Arnwald/slo-pilote/mech/out/plans_chassis.pdf

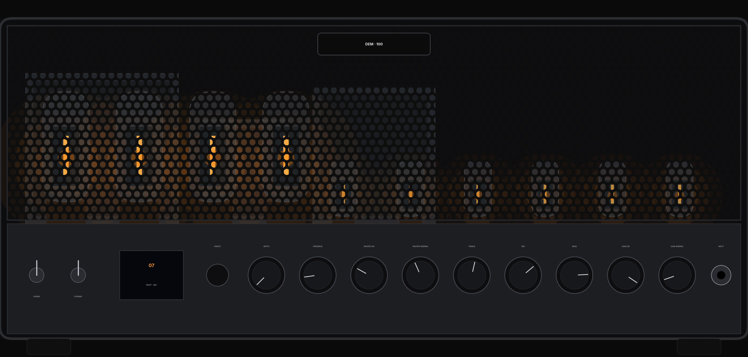
[picture p4: figure]

# Vue d'ensemble

Tête 100 W pilotable · rendu indicatif · cotes en mm | F1
- Châssis : acier DC01 1,5 mm, plateau à 4 parois d'une pièce, rayon intérieur 1,5 mm, K = 0,42 (à recaler sur l'outillage du plieur).
- Capot : aluminium 5754 2 mm, en U avec retours, fond rapporté ; thermolaquage noir mat texturé. Grilles avant et arrière : tôle perforée achetée, noire.
- Encombrement : 612 × 262 × 282 mm (l × h × p) hors poignée et boutons ; masse estimée ~20 kg.
- Trous en orange : dépendent d'une pièce à recevoir (transfos, embase IEC, écran). Commander ces pièces et relever leurs cotes avant la découpe.

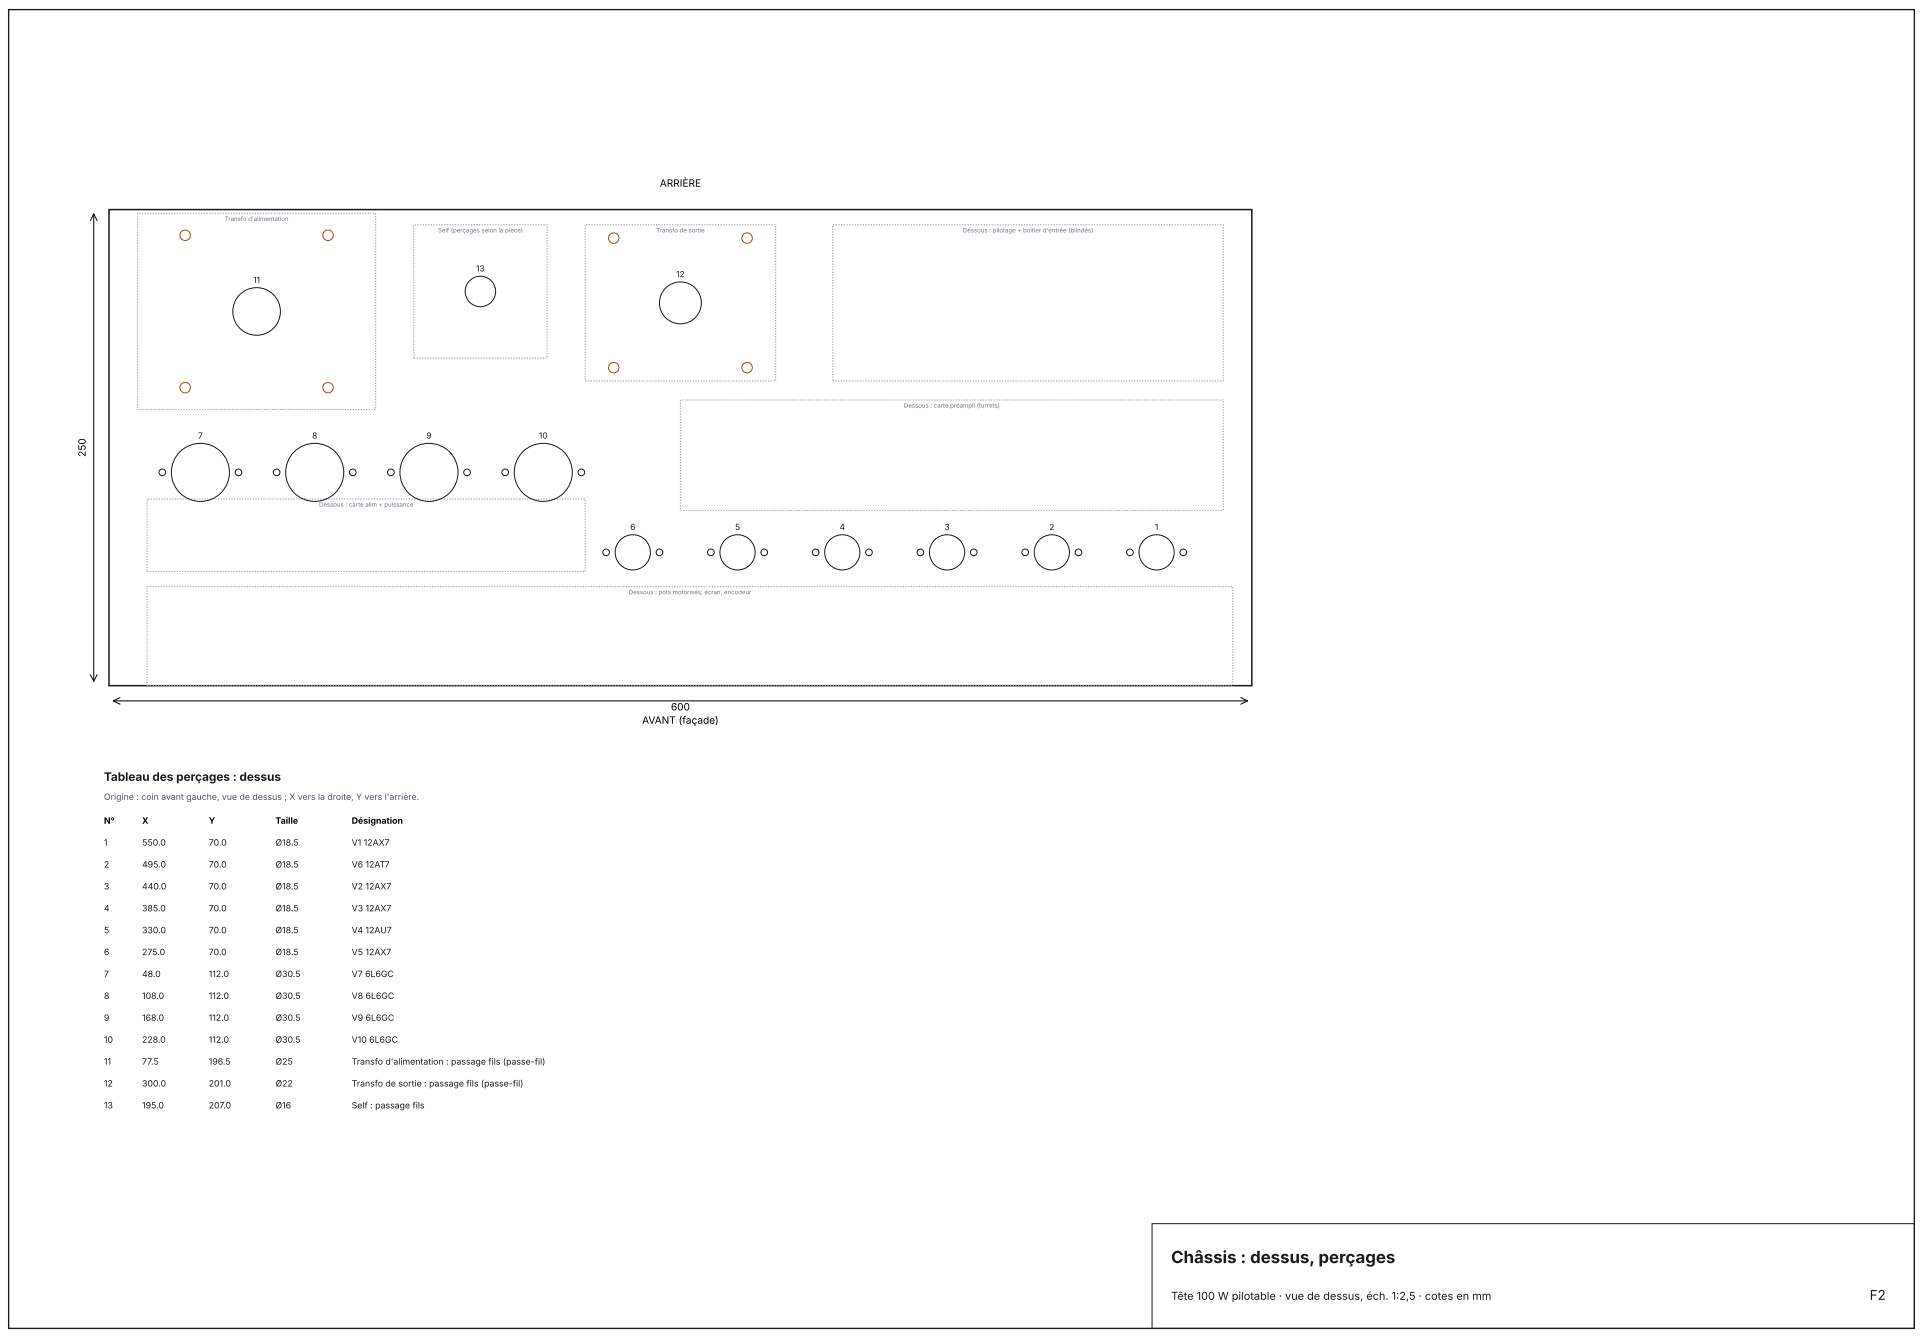
[picture p5: page 2]
Tête 100 W pilotable · vue de dessus, éch. 1:2,5 · cotes en mm; Taille; Désignation; Transfo d'alimentation : passage fils (passe-fil); Transfo de sortie : passage fils (passe-fil); Self : passage fils; Transfo d'alimentation; Self (perçages selon la pièce); Transfo de sortie; ARRIÈRE; AVANT (façade)

Dessous : pilotage + boîtier d'entrée (blindés)

Dessous : carte préampli (turrets)

Dessous : carte alim + puissance

Dessous : pots motorisés, écran, encodeur

Tableau des perçages : dessus

Origine : coin avant gauche, vue de dessus ; X vers la droite, Y vers l'arrière.

Châssis : dessus, perçages

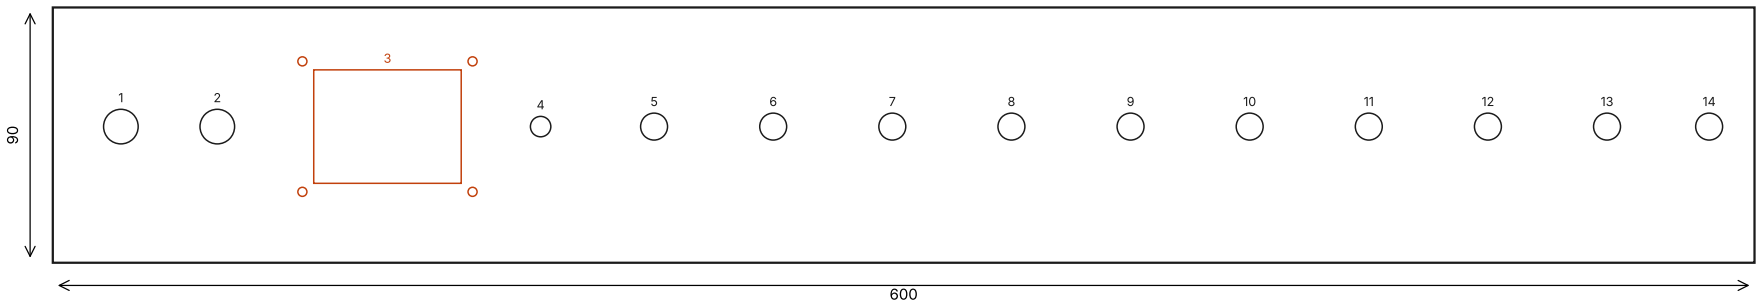
[picture p6: figure]
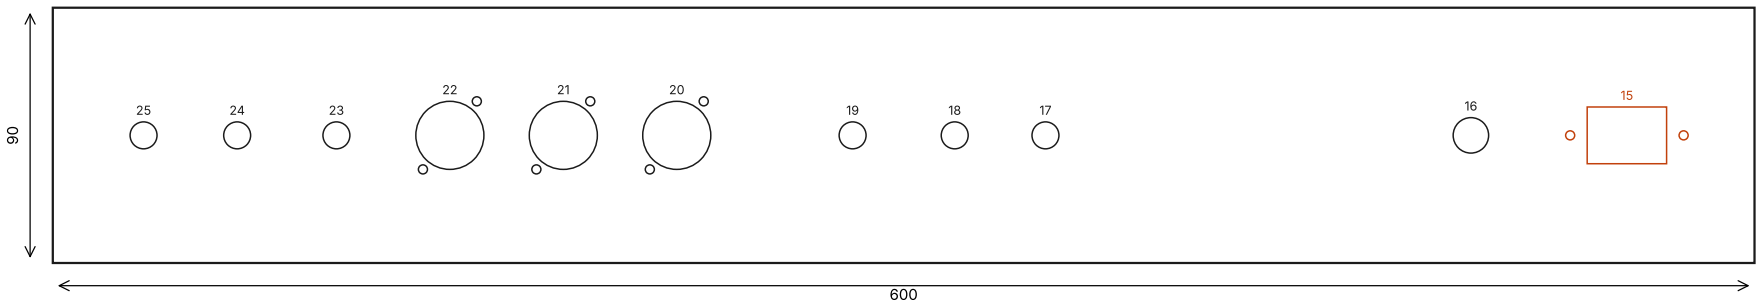
[picture p7: figure]

# Châssis : façade et panneau arrière

Tête 100 W pilotable · vues extérieures, éch. 1:2,5 · cotes en mm | F3

# Façade

Origine : coin inférieur gauche, vue de face.

N° | X | Y | Taille | Désignation
1 | 24.0 | 48.0 | Ø12.2 | Power (interrupteur M12)
2 | 58.0 | 48.0 | Ø12.2 | Standby (interrupteur M12)
3 | 118.0 | 48.0 | 52×40 | Fenêtre écran 2,4" — à vérifier
4 | 172.0 | 48.0 | Ø7.2 | Encodeur presets (M7)
5 | 212.0 | 48.0 | Ø9.5 | Depth (ALPS RK168, M9)
6 | 254.0 | 48.0 | Ø9.5 | Presence (ALPS RK168, M9)
7 | 296.0 | 48.0 | Ø9.5 | Master OD (ALPS RK168, M9)
8 | 338.0 | 48.0 | Ø9.5 | Master Normal (ALPS RK168, M9)
9 | 380.0 | 48.0 | Ø9.5 | Treble (ALPS RK168, M9)
10 | 422.0 | 48.0 | Ø9.5 | Mid (ALPS RK168, M9)
11 | 464.0 | 48.0 | Ø9.5 | Bass (ALPS RK168, M9)
12 | 506.0 | 48.0 | Ø9.5 | Gain OD (ALPS RK168, M9)
13 | 548.0 | 48.0 | Ø9.5 | Gain Normal (ALPS RK168, M9)
14 | 584.0 | 48.0 | Ø9.5 | Entrée guitare (jack 6,35)

# Panneau arrière

Origine : coin inférieur gauche, vue de l'arrière.

N° | X | Y | Taille | Désignation
15 | 555.0 | 45.0 | 28×20 | Embase IEC + fusible secteur — à vérifier
16 | 500.0 | 45.0 | Ø12.5 | Fusible HT (porte-fusible M12)
17 | 350.0 | 45.0 | Ø9.5 | HP 1
18 | 318.0 | 45.0 | Ø9.5 | HP 2
19 | 282.0 | 45.0 | Ø9.5 | Sélecteur 4 / 8 / 16 Ω
20 | 220.0 | 45.0 | Ø24 | MIDI IN (embase D Neutrik)
21 | 180.0 | 45.0 | Ø24 | MIDI THRU (embase D Neutrik)
22 | 140.0 | 45.0 | Ø24 | USB (Neutrik NAUSB-W, format D)
23 | 100.0 | 45.0 | Ø9.5 | Pédalier (jack TRS)
24 | 65.0 | 45.0 | Ø9.5 | Insert send (HM-2)
25 | 32.0 | 45.0 | Ø9.5 | Insert return (HM-2)

Façade, vue de face (bas = bord libre, haut = pli avec le dessus)

Panneau arrière, vue de l'arrière (cotes X depuis le bord gauche vu de l'arrière)

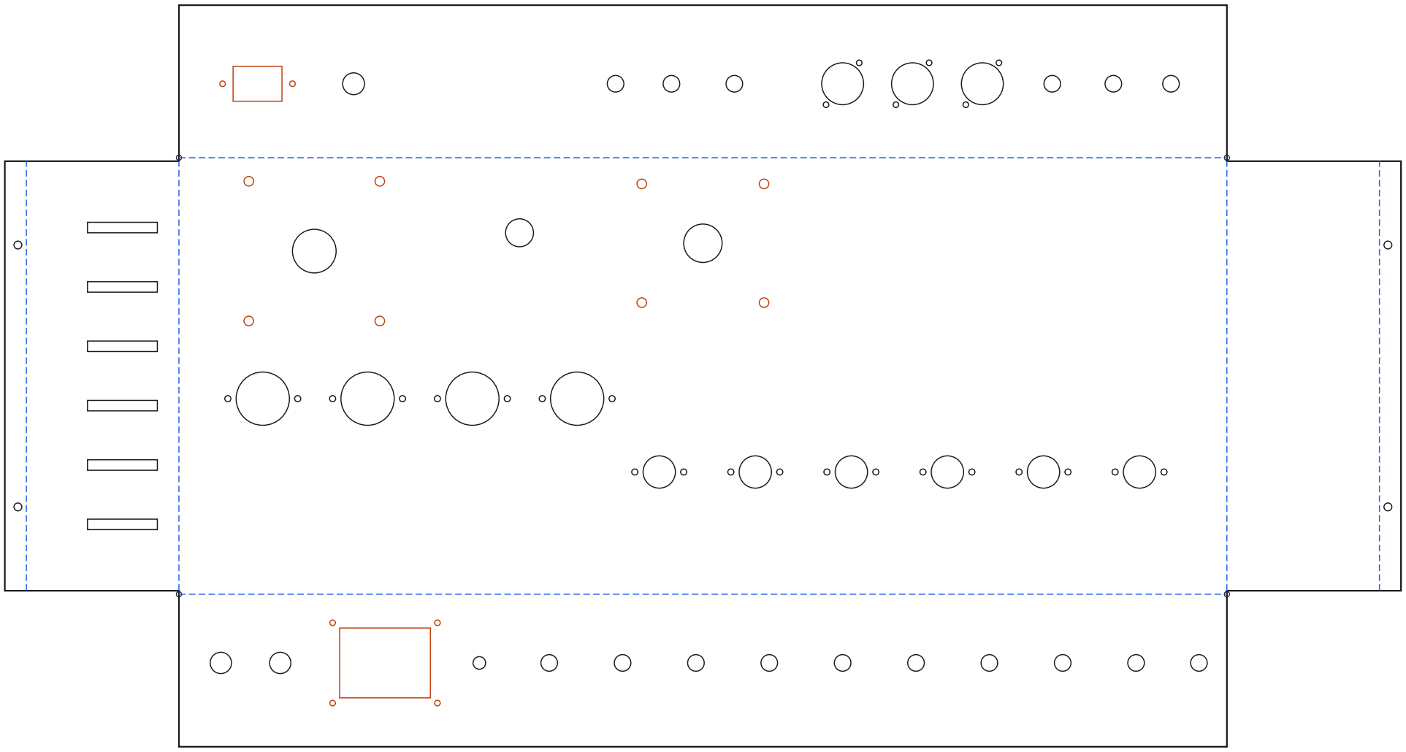
[picture p8: figure]

# Châssis : développé (découpe laser)

Tête 100 W pilotable · éch. 1:3 · cotes en mm | F4

# Plis (bleu tireté) :

- 4 plis à 90° vers le bas : façade, arrière, joues
- 2 plis à 90° vers l'intérieur : retours bas des joues (15 mm)
- Ordre conseillé : retours, joues, puis façade et arrière
- Fichier : chassis_developpe.dxf (calques DECOUPE, PLIAGE, A_VERIFIER)
- Le calque A_VERIFIER n'est pas à découper avant validation

Développé : 799.4 × 424.7 mm, déduction de pli 2.65 mm par pli (acier 1,5 mm, Ri 1,5, K 0,42)

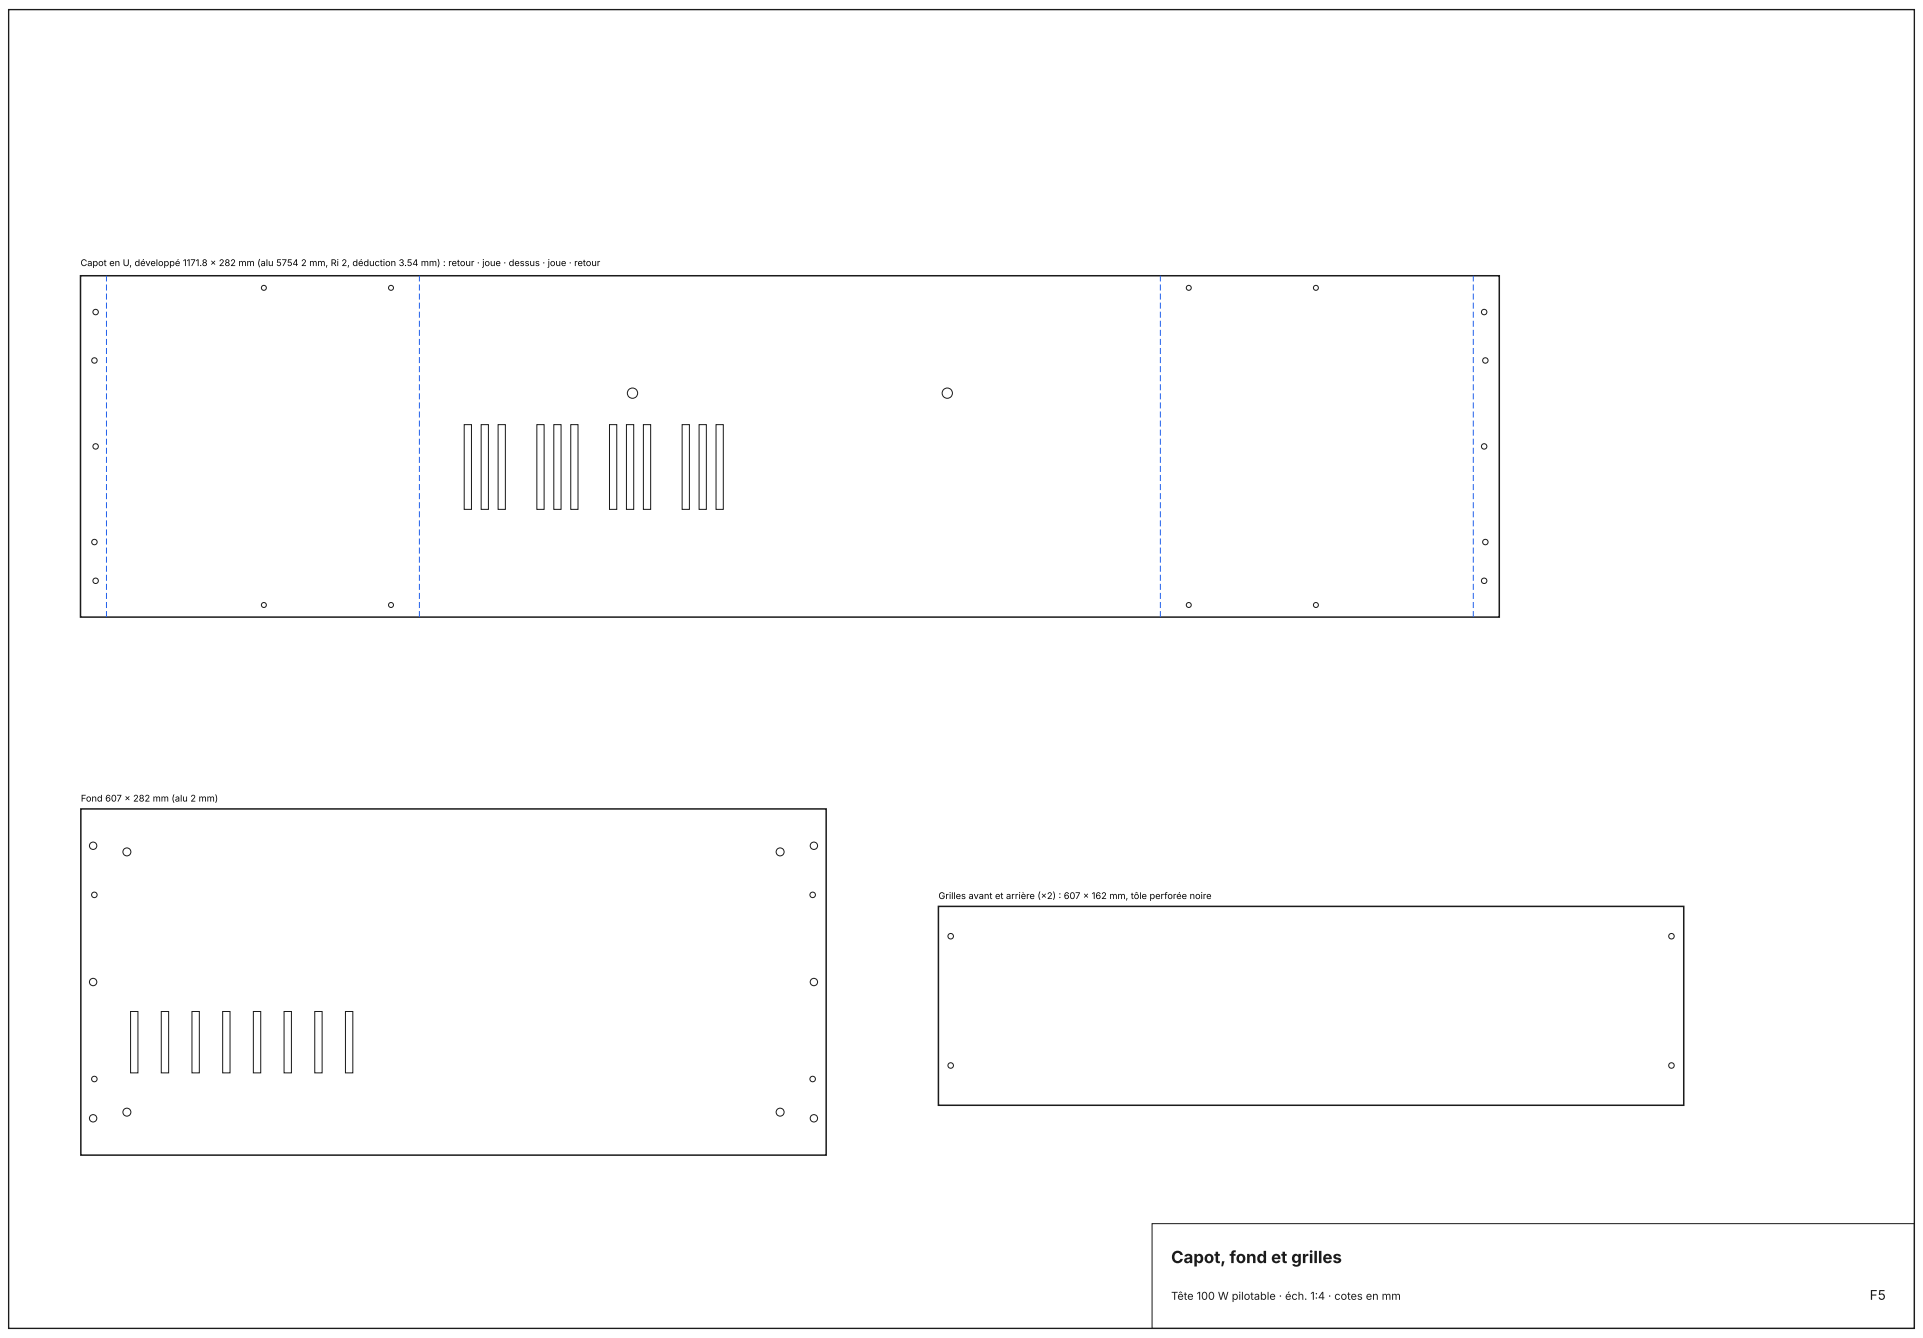
[picture p9: page 5]
Tête 100 W pilotable · éch. 1:4 · cotes en mm

Capot en U, développé 1171.8 × 282 mm (alu 5754 2 mm, Ri 2, déduction 3.54 mm) : retour · joue · dessus · joue · retour

Fond 607 × 282 mm (alu 2 mm)

Grilles avant et arrière (×2) : 607 × 162 mm, tôle perforée noire

Capot, fond et grilles
