Arnwald/slo-pilote/robot/web/rendu_robot_micro_detail.jpg

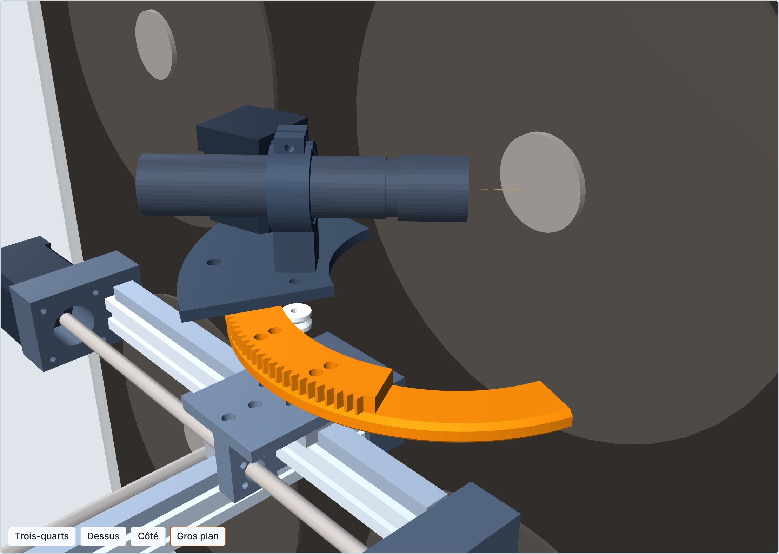
robot/web/rendu_robot_micro_detail.jpg
