Arnwald/slo-pilote/bom/nomenclature_tete_100W.xlsx

Sheet: Synthèse
Tête 100 W pilotable : coût détaillé
Hypothèses | Valeur | Note
Cours CHF pour 1 € | 0.94 | À ajuster au cours du jour
Cours € pour 1 £ | 1.17 | À ajuster au cours du jour
TVA suisse à l'importation | 8.1% | Taux normal 2026
Marge pour imprévus | 5.0% | Pièces oubliées, casse
Section (tête) | Net (€) | Part
Magnétiques | 259.8319328 | 15.0%
Lampes et supports | 239.1596639 | 13.8%
Alimentation HT | 79.03361345 | 4.6%
Préampli et déphaseur | 69.14285714 | 4.0%
Commandes motorisées | 169.4747899 | 9.8%
Commutation (LDR) | 97.70601681 | 5.7%
Pilotage | 265.8088095 | 15.4%
Boîtier d'entrée et gate | 167.1104622 | 9.7%
Connectique et façade | 60.47058824 | 3.5%
Mécanique | 290.1394187 | 16.8%
Câblage et consommables | 29.41176471 | 1.7%
Tête : composants, net | 1727.289917
Tête : composants, en CHF | 1623.652522
+ TVA suisse à l'importation, achats à l'étranger (CHF) | 127.0200171
+ Port et dédouanement (CHF) | 190
+ Imprévus (CHF) | 87.53362697
Tête : total estimé (CHF) | 2028.206166
Baffle 4×12, net (€) | 807.394002
Baffle 4×12, total estimé (CHF) | 813.6815854
Tête + baffle (CHF) | 2841.887752
Port et dédouanement par fournisseur | CHF | Note
Tube-Town (DE) | 35 | estimation : envoi + frais de dédouanement du transporteur
Tube Amp Doctor (DE) | 20 | estimation : envoi + frais de dédouanement du transporteur
Thomann (DE) | 15 | estimation : envoi + frais de dédouanement du transporteur
Audiophonics (FR) | 20 | estimation : envoi + frais de dédouanement du transporteur
Electric Druid (UK) | 15 | estimation : envoi + frais de dédouanement du transporteur
Distributeur électronique (Mouser, Bürklin, Distrelec…) | 20 | estimation : envoi + frais de dédouanement du transporteur
Bürklin (DE) | 15 | estimation : envoi + frais de dédouanement du transporteur
Thonk (UK) | 15 | estimation : envoi + frais de dédouanement du transporteur
The Pi Hut (UK) | 15 | estimation : envoi + frais de dédouanement du transporteur
RobotShop (EU) | 20 | estimation : envoi + frais de dédouanement du transporteur
Les vendeurs de l'UE facturent sans leur TVA à l'export ; la TVA suisse (8,1 %) s'applique à l'arrivée.
Non compris : robot de micro, micro, outillage (variac, lampe série pour la première mise sous tension).

Sheet: Nomenclature
Section | Repère | Désignation | Référence | Fournisseur | Lien | Qté | Prix catalogue | TVA incluse | Devise | PU net (€) | Total net (€) | Base | Remarque
Magnétiques | T1 | Transfo d'alimentation 720 V PC 400 mA, 6,3 V 7,5 A + 3 A | TT-Slo100 (tt-pwSLO100) | Tube-Town (DE) | lien (https://www.tubetown.net/ttstore/en/tt-slo100-soldano-style-powertransformer.html) | 1 | 139.00 | 19% | EUR | 116.81 | 116.81 | relevé nov. 2026
Magnétiques | T2 | Transfo de sortie 2,2 kΩ PP, 4/8/16 Ω, 100 W | TT-Slo100 (tt-otSLO100) | Tube-Town (DE) | lien (https://tubetown.net/ttstore/en/tt-slo100-soldano-slo-100-watt-output-transformer.html) | 1 | 119.00 | 19% | EUR | 100.00 | 100.00 | relevé nov. 2026
Magnétiques | L1 | Self 10 H (alimentation des écrans) | TT-CK10 | Tube-Town (DE) | lien (https://tubetown.net/ttstore/en/tt-ck10-choke-10-h.html) | 1 | 36.20 | 19% | EUR | 30.42 | 30.42 | relevé nov. 2026 | Courant nominal à vérifier sur la fiche (≥ 100 mA suffit : écrans + préampli)
Magnétiques | T3 | Transfo torique 2 × 15 V, 10 VA (±15 V du boîtier d'entrée) | à choisir | Distributeur électronique (Mouser, Bürklin, Distrelec…) |  | 1 | 15.00 | 19% | EUR | 12.61 | 12.61 | estimation | Le 5 V et le robot passent par le module 24 V : ce transfo ne fournit plus que l'analogique
Lampes et supports | V1–V3, V5 | 12AX7 / ECC83 | JJ ECC83S | Tube Amp Doctor (DE) | lien (https://www.tubeampdoctor.com/en/jj-ecc83s/12ax7-jj-electronic) | 4 | 17.80 | 19% | EUR | 14.96 | 59.83 | relevé nov. 2026
Lampes et supports | V4, V6 | 12AU7 / ECC82 | JJ ECC82 | Tube Amp Doctor (DE) |  | 2 | 17.80 | 19% | EUR | 14.96 | 29.92 | estimation | Prix supposé égal à l'ECC83S
Lampes et supports | V7–V10 | 6L6GC, quartet appairé | Engl 6L6GC Matched Quartett | Thomann (DE) | lien (https://www.thomann.pt/engl_6l6gc_matched_quartett.htm) | 1 | 149.00 | 19% | EUR | 125.21 | 125.21 | relevé nov. 2026 | TVA portugaise affichée ; prix équivalent sur thomann.de à vérifier
Lampes et supports |  | Support noval châssis | Belton VT9-ST-C | Tube-Town (DE) | lien (https://tubetown.net/ttstore/en/socket-noval-belton-vt9-st-c-chassis.html) | 6 | 1.90 | 19% | EUR | 1.60 | 9.58 | relevé nov. 2026
Lampes et supports |  | Support octal châssis | Belton VT8 | Tube-Town (DE) | lien (https://tubetown.net/ttstore/en/socket-octal-belton-chassis-vt8.html) | 4 | 2.35 | 19% | EUR | 1.97 | 7.90 | relevé nov. 2026
Lampes et supports |  | Maintien de lampe de puissance | ressort / étrier | Tube-Town (DE) |  | 4 | 2.00 | 19% | EUR | 1.68 | 6.72 | estimation
Alimentation HT | C101, C102 | Électrolytique 470 µF 350 V (B+1, deux en série) | F&T 470/350 | Tube-Town (DE) |  | 2 | 12.00 | 19% | EUR | 10.08 | 20.17 | estimation
Alimentation HT | C103, C104 | Électrolytique 220 µF 350 V (B+2, deux en série) | F&T 220/350 axial | Tube-Town (DE) | lien (https://www.tubetown.net/ttstore/en/f-t-220-f-350-volt-axial.html) | 2 | 6.65 | 19% | EUR | 5.59 | 11.18 | relevé nov. 2026
Alimentation HT | C105–C110 | Électrolytique ≥ 550 V : 3 × 47 µF, 3 × 10 µF (B+3 à B+5, cellules dédiées) | F&T | Tube-Town (DE) |  | 6 | 6.00 | 19% | EUR | 5.04 | 30.25 | estimation | Lampes froides, ces nœuds montent vers 535 V : 550 V minimum, ou 2 condensateurs 350 V en série
Alimentation HT | R124, R128, C113, C114 | Surélévation des filaments (+62 V, +99 V) : 2 × 330 k 3 W, 47 µF 100 V et 160 V |  | Tube-Town (DE) |  | 1 | 5.00 | 19% | EUR | 4.20 | 4.20 | estimation | Le TT-SLO100 a des enroulements 6,3 V à point milieu : pas de point milieu artificiel
Alimentation HT | D101–D105 | Diodes UF4007 (HT) et 1N4007 (polarisation) |  | Tube-Town (DE) |  | 5 | 0.15 | 19% | EUR | 0.13 | 0.63 | estimation
Alimentation HT |  | Résistances 1–3 W (équilibrage, cellules de filtrage) |  | Tube-Town (DE) |  | 12 | 0.50 | 19% | EUR | 0.42 | 5.04 | estimation
Alimentation HT |  | Polarisation : 2 × 100 µF 160 V, 4 ajustables 25 k, 4 × 1 Ω 1 % |  | Tube-Town (DE) |  | 1 | 9.00 | 19% | EUR | 7.56 | 7.56 | estimation | Prise 60 V du transfo d'alimentation ; réglage de −43 à −66 V
Préampli et déphaseur |  | Résistances couche métal 1/2 W 1 % (toute la tête) |  | Tube-Town (DE) |  | 79 | 0.12 | 19% | EUR | 0.10 | 7.97 | estimation | Liste exacte par valeur : kicad/nomenclature_kicad.csv
Préampli et déphaseur |  | Résistances 1–3 W (cathodes de V3A et V6A, plaque de V6B, White CF, écrans) |  | Tube-Town (DE) |  | 8 | 0.40 | 19% | EUR | 0.34 | 2.69 | estimation
Préampli et déphaseur |  | Condensateurs film 400–630 V |  | Tube-Town (DE) |  | 21 | 1.00 | 19% | EUR | 0.84 | 17.65 | estimation | Dont les trois condensateurs du tone stack : son entrée est à 233 V continus (sortie de la White CF)
Préampli et déphaseur |  | Condensateurs mica / céramique 500 V |  | Tube-Town (DE) |  | 7 | 0.40 | 19% | EUR | 0.34 | 2.35 | estimation
Préampli et déphaseur |  | Condensateurs film 63 V (découplages de cathode, contre-réaction) |  | Tube-Town (DE) |  | 8 | 0.50 | 19% | EUR | 0.42 | 3.36 | estimation | Film plutôt qu'électrolytique sous 2 V
Préampli et déphaseur | C304 | Électrolytique 220 µF 25 V (White CF) |  | Tube-Town (DE) |  | 1 | 0.50 | 19% | EUR | 0.42 | 0.42 | estimation
Préampli et déphaseur | K201, K202 | Relais signal 2RT 5 V (découplages de V1B et V2A, liaison 2,2 / 20 nF) | Omron G6K-2 | Distributeur électronique (Mouser, Bürklin, Distrelec…) |  | 2 | 2.00 | 19% | EUR | 1.68 | 3.36 | estimation | Relais plutôt que LDR sur les découplages : les ~1 kΩ d'une LDR passante coûtaient 1,5 dB vers 300 Hz
Préampli et déphaseur |  | Plaque à turrets 300 × 60, 2 × 30 turrets | TT EZ-Board tbez-005 | Tube-Town (DE) | lien (https://tubetown.net/ttstore/en/components-10662/parts-for-amps/turrets-eyeletts-boards/tt-ez-boards) | 2 | 15.00 | 19% | EUR | 12.61 | 25.21 | relevé nov. 2026 | Préampli et puissance
Préampli et déphaseur |  | Plaque à turrets 140 × 47, 2 × 15 turrets | TT EZ-Board tbez-032-sw | Tube-Town (DE) | lien (https://tubetown.net/ttstore/en/components-10662/parts-for-amps/turrets-eyeletts-boards/tt-ez-boards) | 1 | 7.30 | 19% | EUR | 6.13 | 6.13 | relevé nov. 2026 | Alimentation
Commandes motorisées | RV201–RV307, RV802 | Pot motorisé ALPS RK16812MG, 2 pistes (100 k log ×3, 100 k lin ×3, 20 k lin ×2, 10 k log ×1, 10 k lin ×1 pour le Blend) | RK16812MG | Audiophonics (FR) | lien (https://www.audiophonics.fr/en/potentiometres-potentiometre-alps/alps-rk16812mg-2-way-motorized-potentiometer-d-log-100k-p-5028.html) | 10 | 15.90 | 20% | EUR | 13.25 | 132.50 | relevé nov. 2026 | 12,90 à 15,90 € chez Audiophonics selon valeur et stock ; 27,79 € chez Bürklin. Mid : 10 k log avec 3,3 k en parallèle (à 1 dB près d'un 2,5 k), la seconde piste sert de capteur
Commandes motorisées |  | Boutons aluminium, axe 6 mm |  | Achat local / divers |  | 11 | 4.00 | 19% | EUR | 3.36 | 36.97 | estimation | 10 pots et l'encodeur
Commutation (LDR) |  | Optocoupleur LED/LDR Xvive VTL5C1 | Xvive VTL5C1 | Electric Druid (UK) | lien (https://electricdruid.net/product/xvive-vtl5c1/) | 16 | 4.95 | 0% | GBP | 5.79 | 92.66 | relevé nov. 2026 | 14 en service + 2 de réserve ; prix hors TVA ; aussi chez Tube-Town
Commutation (LDR) | U708–U710 | Pilote ULN2803 + résistances | ULN2803A (DIP-18) | Distributeur électronique (Mouser, Bürklin, Distrelec…) |  | 3 | 1.00 | 19% | EUR | 0.84 | 2.52 | estimation
Commutation (LDR) | U706, U707 | Extenseur 16 E/S I²C | MCP23017-E/SP (DIP-28) | Distributeur électronique (Mouser, Bürklin, Distrelec…) |  | 2 | 1.50 | 19% | EUR | 1.26 | 2.52 | estimation
Pilotage | A601 | Raspberry Pi 4 modèle B, 2 Go (contrôleur unique, Ethernet intégré) | RPI4-MODBP-2GB | Bürklin (DE) | lien (https://www.buerklin.com/en/p/raspberry-pi/single-board-computer/rpi4-modbp-2gb/64S3341) | 1 | 58.83 | 19% | EUR | 49.44 | 49.44 | relevé nov. 2026 | Wi-Fi et Bluetooth désactivés, système en lecture seule, refroidissement passif
Pilotage |  | Carte microSD d'endurance 16 Go |  | Achat local / divers |  | 1 | 15.00 | 19% | EUR | 12.61 | 12.61 | estimation
Pilotage | A602 | HAT CAN (MCP2515 + SN65HVD230) pour le robot de micro | Waveshare RS485 CAN HAT | The Pi Hut (UK) | lien (https://thepihut.com/products/rs485-can-hat-for-raspberry-pi) | 1 | 12.60 | 20% | GBP | 12.29 | 12.29 | relevé nov. 2026 | Prix soldé ; partie RS485 inutilisée
Pilotage | U701–U705 | Contrôleur double de moteurs CC, I²C (pots motorisés) | Pololu Motoron M2T256, picots soudés | RobotShop (EU) | lien (https://eu.robotshop.com/products/pololu-motoron-m2t256-dual-i2c-motor-controller-header-pins-soldered) | 5 | 21.68 | 20% | EUR | 18.07 | 90.33 | relevé nov. 2026 | Prix soldé, 29,90 € au prix normal
Pilotage | U609 | Régulateur abaisseur 5 V 3,2 A (alimentation du Pi) | Pololu D36V28F5 | RobotShop (EU) |  | 1 | 16.00 | 20% | EUR | 13.33 | 13.33 | estimation
Pilotage | U610, U611 | CAN 8 voies 12 bits SPI (pistes capteur, bias, enveloppe du gate) | MCP3208-CI/P (DIP-16) | Distributeur électronique (Mouser, Bürklin, Distrelec…) |  | 2 | 4.50 | 19% | EUR | 3.78 | 7.56 | estimation
Pilotage | U612, U613 | CNA double 12 bits SPI (VCA, seuil et fondu du gate) | MCP4822-E/P (DIP-8) | Distributeur électronique (Mouser, Bürklin, Distrelec…) |  | 2 | 3.00 | 19% | EUR | 2.52 | 5.04 | estimation
Pilotage | U614–U616, J606, J901 | Registres des commandes de l'entrée, embases IDC 2 × 13 et nappe | 3 × 74HC595N | Distributeur électronique (Mouser, Bürklin, Distrelec…) |  | 1 | 6.00 | 19% | EUR | 5.04 | 5.04 | estimation
Pilotage |  | Écran 2,4" SPI | TFT ST7789 | Achat local / divers |  | 1 | 10.00 | 19% | EUR | 8.40 | 8.40 | estimation
Pilotage |  | Encodeur rotatif à poussoir | EC11 | Distributeur électronique (Mouser, Bürklin, Distrelec…) |  | 1 | 1.50 | 19% | EUR | 1.26 | 1.26 | estimation
Pilotage |  | Interface MIDI (6N138 + passifs) |  | Distributeur électronique (Mouser, Bürklin, Distrelec…) |  | 1 | 3.00 | 19% | EUR | 2.52 | 2.52 | estimation
Pilotage | U601–U603 | LM7815, LM7915, module abaisseur 5 V, redresseur et filtrage |  | Distributeur électronique (Mouser, Bürklin, Distrelec…) |  | 1 | 12.00 | 19% | EUR | 10.08 | 10.08 | estimation
Pilotage | U604, F601 | Module secteur 24 V 60 W à bornier (robot, moteurs, Pi) | Mean Well IRM-60-24ST | Distributeur électronique (Mouser, Bürklin, Distrelec…) |  | 1 | 22.00 | 19% | EUR | 18.49 | 18.49 | estimation | Fusible T1 A en amont
Pilotage | U606 | Mesure du bias (ampli op quadruple 3,3 V) | MCP6004-I/P (DIP-14) | Distributeur électronique (Mouser, Bürklin, Distrelec…) |  | 1 | 2.00 | 19% | EUR | 1.68 | 1.68 | estimation
Pilotage |  | Carte d'interface traversante, connecteurs, nappes, câble de la barrette des moteurs |  | Achat local / divers |  | 1 | 25.00 | 19% | EUR | 21.01 | 21.01 | estimation | Plaque à pastilles ou circuit imprimé traversant commandé nu
Pilotage |  | Boîtier de blindage |  | Achat local / divers |  | 1 | 8.00 | 19% | EUR | 6.72 | 6.72 | estimation
Boîtier d'entrée et gate | U802, U808 | Quadruple VCA (mélange TS / HM-2 ; noise gate) | Alfa AS2164 (DIP-16) | Thonk (UK) | lien (https://www.thonk.co.uk/shop/as2164/) | 2 | 5.75 | 0% | GBP | 6.73 | 13.46 | relevé nov. 2026 | Prix hors TVA ; brochage SSM2164 / V2164
Boîtier d'entrée et gate | U503, U505–U507 | Ampli op double 4558 (TS808, clone HM-2) | NJM4558D | Distributeur électronique (Mouser, Bürklin, Distrelec…) |  | 4 | 0.60 | 19% | EUR | 0.50 | 2.02 | estimation
Boîtier d'entrée et gate | U501, U801, U803, U807 | Ampli op double faible bruit | OPA2134PA | Distributeur électronique (Mouser, Bürklin, Distrelec…) |  | 4 | 4.00 | 19% | EUR | 3.36 | 13.45 | estimation
Boîtier d'entrée et gate | U804–U806 | Commandes et détection du gate | 2 × TL074CN, LM393N | Distributeur électronique (Mouser, Bürklin, Distrelec…) |  | 1 | 2.00 | 19% | EUR | 1.68 | 1.68 | estimation
Boîtier d'entrée et gate | Q501, Q502, D506, D507 | Transistors et diodes germanium de la HM-2 | BC550C, BC560C, 2 × 1N34A | Distributeur électronique (Mouser, Bürklin, Distrelec…) |  | 1 | 2.50 | 19% | EUR | 2.10 | 2.10 | estimation | Remplacent les 2SC2240, 2SA970 et 1S188FM d'origine
Boîtier d'entrée et gate | U901–U905 | Multiplexeur analogique 16:1 ±15 V (drive et tone de la TS, dist et Color Mix ×2 de la HM-2) | ADG406BNZ (DIP-28) | Distributeur électronique (Mouser, Bürklin, Distrelec…) | lien (https://www.digikey.fr/en/products/detail/analog-devices-inc/ADG406BNZ/820059) | 5 | 20.00 | 0% | EUR | 20.00 | 100.00 | estimation | Hors TVA : 21,87 $ chez Analog Devices, 28,14 $ chez DigiKey (Octopart, nov. 2026)
Boîtier d'entrée et gate | U906 | Multiplexeur analogique 8:1 ±15 V (fermeture du gate) | ADG408BNZ (DIP-16) | Distributeur électronique (Mouser, Bürklin, Distrelec…) |  | 1 | 5.00 | 0% | EUR | 5.00 | 5.00 | estimation | À partir de 4,90 $ hors TVA (nov. 2026)
Boîtier d'entrée et gate | R901–R980, RN901–RN903 | Résistances 1 % des échelles (E96) et réseaux 8 × 100 k SIP-9 |  | Distributeur électronique (Mouser, Bürklin, Distrelec…) |  | 1 | 10.00 | 19% | EUR | 8.40 | 8.40 | estimation | Valeurs dans spice/steps.json
Boîtier d'entrée et gate | U502, U504, U809 | Régulateurs 78L09 et sonde de température | 2 × 78L09, DS18B20 | Distributeur électronique (Mouser, Bürklin, Distrelec…) |  | 1 | 4.00 | 19% | EUR | 3.36 | 3.36 | estimation
Boîtier d'entrée et gate | K501–K503 | Relais signal (TS, insert, polarité du chemin B) | Omron G6K-2 | Distributeur électronique (Mouser, Bürklin, Distrelec…) |  | 3 | 2.00 | 19% | EUR | 1.68 | 5.04 | estimation
Boîtier d'entrée et gate |  | Passifs (film, électrolytiques, résistances 1 %) et diodes |  | Distributeur électronique (Mouser, Bürklin, Distrelec…) |  | 1 | 15.00 | 19% | EUR | 12.61 | 12.61 | estimation
Connectique et façade |  | Jack d'entrée | Neutrik NMJ4HC-S | Tube-Town (DE) | lien (https://tubetown.net/ttstore/en/components-10662/jacks-plugs/jacks-6-3-mm) | 1 | 1.65 | 19% | EUR | 1.39 | 1.39 | relevé nov. 2026
Connectique et façade |  | Jacks HP et insert | Cliff 1160 | Tube-Town (DE) | lien (https://tubetown.net/ttstore/en/components-10662/jacks-plugs/jacks-6-3-mm) | 4 | 1.20 | 19% | EUR | 1.01 | 4.03 | relevé nov. 2026
Connectique et façade |  | Jack pédalier stéréo | Cliff 1220 | Tube-Town (DE) | lien (https://tubetown.net/ttstore/en/components-10662/jacks-plugs/jacks-6-3-mm) | 1 | 1.60 | 19% | EUR | 1.34 | 1.34 | relevé nov. 2026
Connectique et façade |  | Sélecteur d'impédance 3 positions |  | Tube-Town (DE) |  | 1 | 10.00 | 19% | EUR | 8.40 | 8.40 | estimation
Connectique et façade |  | Embase IEC C14 avec porte-fusible | Schurter | Tube-Town (DE) | lien (https://tubetown.net/ttstore/en/tubetown.html?page=21) | 1 | 4.20 | 19% | EUR | 3.53 | 3.53 | relevé nov. 2026
Connectique et façade |  | Porte-fusible HT + jeu de fusibles |  | Tube-Town (DE) |  | 1 | 5.00 | 19% | EUR | 4.20 | 4.20 | estimation
Connectique et façade |  | Interrupteurs Power et Standby 250 V |  | Tube-Town (DE) |  | 2 | 4.00 | 19% | EUR | 3.36 | 6.72 | estimation
Connectique et façade |  | Embases MIDI DIN 5 format D |  | Distributeur électronique (Mouser, Bürklin, Distrelec…) |  | 2 | 4.00 | 19% | EUR | 3.36 | 6.72 | estimation
Connectique et façade |  | Traversée RJ45 format D (Ethernet) | Neutrik NE8FDP | Thomann (DE) |  | 1 | 9.00 | 19% | EUR | 7.56 | 7.56 | estimation
Connectique et façade | J605, F602 | Embase M12 code A 5 points (robot) et fusible réarmable 2,5 A |  | Distributeur électronique (Mouser, Bürklin, Distrelec…) |  | 1 | 12.00 | 19% | EUR | 10.08 | 10.08 | estimation | Brochage CANopen : CAN et 24 V sur un seul câble
Connectique et façade |  | Traversée USB format D | Neutrik NAUSB-W | Bürklin (DE) | lien (https://buerklin.com/en/p/neutrik/adapter-for-d-sub-connectors-usb-connectors-pc-connectors/nausb-w/73F1084) | 1 | 7.71 | 19% | EUR | 6.48 | 6.48 | relevé nov. 2026
Mécanique |  | Châssis acier 1,5 mm, découpe + 6 plis | chassis_developpe.dxf | Découpe laser en ligne (ex. laserteile4you.de) ou atelier local |  | 1 | 95.00 | 19% | EUR | 79.83 | 79.83 | estimation | Faire un devis en ligne avec le DXF
Mécanique |  | Capot alu 2 mm en U + fond | capot_developpe.dxf, fond.dxf | Découpe laser en ligne (ex. laserteile4you.de) ou atelier local |  | 1 | 110.00 | 19% | EUR | 92.44 | 92.44 | estimation | Variante bois + tolex, comme le Randall Satan : ~50 €
Mécanique |  | Thermolaquage noir (châssis + capot) |  | Achat local / divers |  | 1 | 60.00 | 8.1% | CHF | 59.05 | 59.05 | estimation | Atelier local
Mécanique |  | Tôle perforée noire, 2 panneaux | grille_x2.dxf | Achat local / divers |  | 1 | 25.00 | 19% | EUR | 21.01 | 21.01 | estimation
Mécanique |  | Entretoises, vis, écrous à sertir, rivets |  | Tube-Town (DE) |  | 1 | 20.00 | 19% | EUR | 16.81 | 16.81 | estimation
Mécanique |  | Poignée + pieds + équerres |  | Achat local / divers |  | 1 | 25.00 | 19% | EUR | 21.01 | 21.01 | estimation
Câblage et consommables |  | Fil isolé, câble blindé, gaines, soudure |  | Tube-Town (DE) |  | 1 | 35.00 | 19% | EUR | 29.41 | 29.41 | estimation
Baffle 4×12 (hors tête) |  | HP 12" Eminence Karnivore, 60 W, 16 Ω (câblage série-parallèle : 16 Ω) | The Karnivore-16 | Thomann (DE) | lien (https://www.thomann.fr/eminence_the_karnivore_16.htm) | 4 | 198.00 | 20% | EUR | 165.00 | 660.00 | relevé nov. 2026 | TVA française affichée. Variante mixte : 2 Karnivore + 2 Celestion Vintage 30 à 138 € (thomann.fr)
Baffle 4×12 (hors tête) |  | Multiplis bouleau 18 mm |  | Achat local / divers |  | 1 | 90.00 | 8.1% | CHF | 88.57 | 88.57 | estimation
Baffle 4×12 (hors tête) |  | Habillage, tissu, coins, poignées, plaque jack |  | Achat local / divers |  | 1 | 70.00 | 19% | EUR | 58.82 | 58.82 | estimation
Légende
Bleu : quantités, prix et taux à ajuster. PU net = prix catalogue sans la TVA du pays du vendeur, en euros.
Base « relevé » : prix lu sur la page du lien en novembre 2026 ; « estimation » : à confirmer.
