Arnwald/slo-pilote/kicad/nomenclature_kicad.csv

Catégorie | Ensemble | Symbole | Valeur | Quantité | Repères
6N138 | Pilotage | 6N138 | 6N138 | 1 | U605
74HC595 | Pilotage | 74HC595 | 74HC595N | 3 | U614 U615 U616
78L09 | Boîtier d'entrée | 78L09 | 78L09 | 2 | U502 U504
78XX | Pilotage | 78XX | LM7815 | 1 | U601
79XX | Pilotage | 79XX | LM7915 | 1 | U602
ADG406 | Commandes de l'entrée | ADG406 | ADG406BNZ | 5 | U901 U902 U903 U904 U905
ADG408 | Commandes de l'entrée | ADG408 | ADG408BNZ | 1 | U906
AS2164 | VCA et noise gate | AS2164 | AS2164 | 2 | U802 U808
Ajustable | tête | POT | 25k trim | 4 | RV101 RV102 RV103 RV104
BOLT | tête | BOLT | Point de masse unique | 1 | E102
BOLT | tête | BOLT | Terre secteur | 1 | E101
BUCK_MOD | Pilotage | BUCK_MOD | LM2596 → 5,0 V 3 A | 1 | U603
BUCK_MOD | Pilotage | BUCK_MOD | Pololu D36V28F5 → 5,0 V 3,2 A | 1 | U609
CAN_HAT | Pilotage | CAN_HAT | Waveshare RS485 CAN HAT | 1 | A602
Condensateur céramique / film basse tension | Boîtier d'entrée | C | 100n | 8 | C504 C514 C536 C537 C538 C539 C540 C541
Condensateur céramique / film basse tension | Commandes | C | 100n | 20 | C701 C702 C703 C704 C705 C706 C707 C708 C709 C710 C711 C712 C713 C714 C715 C716 C717 C718 C719 C720
Condensateur céramique / film basse tension | Commandes de l'entrée | C | 100n | 12 | C901 C902 C903 C904 C905 C906 C907 C908 C909 C910 C911 C912
Condensateur céramique / film basse tension | Pilotage | C | 100n | 14 | C610 C611 C612 C613 C614 C615 C623 C630 C631 C632 C633 C635 C636 C637
Condensateur céramique / film basse tension | VCA et noise gate | C | 100n | 17 | C812 C816 C817 C818 C819 C820 C821 C822 C823 C824 C825 C826 C827 C828 C829 C830 C831
Condensateur céramique / film basse tension | VCA et noise gate | C | 100n film | 1 | C809
Condensateur céramique / film basse tension | Boîtier d'entrée | C | 100p | 4 | C501 C518 C521 C522
Condensateur céramique / film basse tension | VCA et noise gate | C | 100p | 1 | C814
Condensateur céramique / film basse tension | Pilotage | C | 10n | 3 | C607 C608 C609
Condensateur céramique / film basse tension | Boîtier d'entrée | C | 1n | 1 | C525
Condensateur céramique / film basse tension | Boîtier d'entrée | C | 1µ film | 3 | C506 C511 C535
Condensateur céramique / film basse tension | VCA et noise gate | C | 1µ film | 4 | C806 C807 C808 C810
Condensateur céramique / film basse tension | VCA et noise gate | C | 2.2µ film | 2 | C801 C803
Condensateur céramique / film basse tension | Boîtier d'entrée | C | 220n | 2 | C509 C510
Condensateur céramique / film basse tension | VCA et noise gate | C | 220n film | 1 | C811
Condensateur céramique / film basse tension | Boîtier d'entrée | C | 330n | 2 | C502 C512
Condensateur céramique / film basse tension | Pilotage | C | 330n | 1 | C603
Condensateur céramique / film basse tension | VCA et noise gate | C | 390p | 1 | C805
Condensateur céramique / film basse tension | Boîtier d'entrée | C | 4.7n film | 1 | C533
Condensateur céramique / film basse tension | Boîtier d'entrée | C | 470p | 1 | C527
Condensateur céramique / film basse tension | Boîtier d'entrée | C | 47n | 1 | C508
Condensateur céramique / film basse tension | Boîtier d'entrée | C | 47n film | 3 | C517 C520 C523
Condensateur céramique / film basse tension | Boîtier d'entrée | C | 51p | 1 | C507
Condensateur céramique / film basse tension | VCA et noise gate | C | 560p | 3 | C802 C804 C813
Condensateur céramique / film basse tension | Boîtier d'entrée | C | 6.8n film | 1 | C531
Condensateur céramique / film basse tension | Boîtier d'entrée | C | 68n film | 1 | C529
Condensateur film 63 V | tête | C | 0.12µ 63 V | 1 | C311
Condensateur film 63 V | tête | C | 0.1µ 63 V | 1 | C312
Condensateur film 63 V | tête | C | 0.47µ 63 V | 4 | C201 C202 C211 C212
Condensateur film 63 V | tête | C | 0.68µ 63 V | 1 | C216
Condensateur film 63 V | tête | C | 1µ 63 V | 1 | C220
Condensateur film HT (400-630 V) | tête | C | 0.1µ 630 V | 4 | C205 C301 C302 C310
Condensateur film HT (400-630 V) | tête | C | 0.47µ 400 V | 1 | C204
Condensateur film HT (400-630 V) | tête | C | 0.47µ 630 V | 1 | C303
Condensateur film HT (400-630 V) | tête | C | 1n 630 V | 1 | C215
Condensateur film HT (400-630 V) | tête | C | 2.2n 630 V | 1 | C214
Condensateur film HT (400-630 V) | tête | C | 20n 630 V | 5 | C209 C213 C217 C219 C308
Condensateur film HT (400-630 V) | tête | C | 220n 630 V | 2 | C306 C307
Condensateur film HT (400-630 V) | tête | C | 22n 630 V | 4 | C401 C411 C421 C431
Condensateur film HT (400-630 V) | tête | C | 47n 630 V | 1 | C203
Condensateur film HT (400-630 V) | tête | C | 5.6n 630 V | 1 | C305
Condensateur mica / céramique HT (500 V) | tête | C | 10n | 1 | C206
Condensateur mica / céramique HT (500 V) | tête | C | 120p | 1 | C210
Condensateur mica / céramique HT (500 V) | tête | C | 1n | 1 | C218
Condensateur mica / céramique HT (500 V) | tête | C | 2.2n | 1 | C208
Condensateur mica / céramique HT (500 V) | tête | C | 4.7n | 2 | C207 C313
Condensateur mica / céramique HT (500 V) | tête | C | 47p | 1 | C309
DIN5 | Pilotage | DIN5 | MIDI IN | 1 | J603
DIN5 | Pilotage | DIN5 | MIDI THRU | 1 | J604
DS18B20 | VCA et noise gate | DS18B20 | DS18B20 | 1 | U809
Diode 1N34A | Boîtier d'entrée | D | 1N34A | 2 | D506 D507
Diode 1N4007 | Pilotage | D | 1N4007 | 6 | D601 D602 D603 D604 D614 D615
Diode 1N4007 | tête | D | 1N4007 | 1 | D105
Diode 1N4148 | Boîtier d'entrée | D | 1N4148 | 5 | D503 D504 D505 D508 D509
Diode 1N4148 | Pilotage | D | 1N4148 | 1 | D605
Diode 1N4148 | VCA et noise gate | D | 1N4148 | 4 | D810 D811 D812 D815
Diode 1N914 | Boîtier d'entrée | D | 1N914 | 2 | D501 D502
Diode BAT85 | Pilotage | D | BAT85 | 8 | D606 D607 D608 D609 D610 D611 D612 D613
Diode UF4007 | tête | D | UF4007 | 4 | D101 D102 D103 D104
EC11 | Pilotage | EC11 | EC11 | 1 | SW601
FUSE | Pilotage | FUSE | PTC 2,5 A | 1 | F602
FUSE | Pilotage | FUSE | T1 A | 1 | F601
FUSE | tête | FUSE | T1 A | 1 | F102
FUSE | tête | FUSE | T3,15 A | 1 | F101
HDR_2x13 | Commandes de l'entrée | HDR_2x13 | Nappe 26 points | 1 | J901
HDR_2x13 | Pilotage | HDR_2x13 | Nappe 26 points | 1 | J606
IEC | tête | IEC | IEC C14 + fusible | 1 | J101
JACK_TRS | Pilotage | JACK_TRS | Pédalier | 1 | J602
JACK_TS | tête | JACK_TS | HP 1 | 1 | J401
JACK_TS | tête | JACK_TS | HP 2 | 1 | J402
JACK_TS | Boîtier d'entrée | JACK_TS | Return | 1 | J503
JACK_TS | Boîtier d'entrée | JACK_TS | Send | 1 | J502
JACK_TSN | Boîtier d'entrée | JACK_TSN | Entrée guitare | 1 | J501
L | tête | L | 10 H (TT-CK10) | 1 | L101
LDR VTL5C1 | tête | VTL5C1 | VTL5C1 | 14 | LDR201 LDR202 LDR203 LDR204 LDR205 LDR206 LDR207 LDR208 LDR209 LDR210 LDR301 LDR302 LDR303 LDR304
LM393 | VCA et noise gate | LM393 | LM393 | 1 | U806
Lampe 12AU7 | tête | 12AU7 | ECC82 | 2 | V4 V6
Lampe 12AX7 | tête | 12AX7 | ECC83 | 4 | V1 V2 V3 V5
Lampe 6L6GC | tête | 6L6GC | 6L6GC | 4 | V7 V8 V9 V10
M12_5 | Pilotage | M12_5 | Robot | 1 | J605
MCP23017 | Commandes | MCP23017 | MCP23017-E/SP | 2 | U706 U707
MCP3208 | Pilotage | MCP3208 | MCP3208-CI/P | 2 | U610 U611
MCP4822 | Pilotage | MCP4822 | MCP4822-E/P | 2 | U612 U613
MCP6004 | Pilotage | MCP6004 | MCP6004-I/P | 1 | U606
MOTORON_M2T | Commandes | MOTORON_M2T | Motoron M2T256 | 5 | U701 U702 U703 U704 U705
NJM4558 | Boîtier d'entrée | NJM4558 | NJM4558D | 4 | U503 U505 U506 U507
OPA2134 | Boîtier d'entrée | OPA2134 | OPA2134 | 1 | U501
OPA2134 | VCA et noise gate | OPA2134 | OPA2134 | 3 | U801 U803 U807
OT_SLO | tête | OT_SLO | TT-SLO100 | 1 | T401
PT_SLO | tête | PT_SLO | TT-SLO100 | 1 | T101
Pot motorisé ALPS RK16812MG | tête | ALPS_2G | 100k lin (Depth) | 1 | RV307
Pot motorisé ALPS RK16812MG | tête | ALPS_2G | 100k lin (Normal Gain) | 1 | RV202
Pot motorisé ALPS RK16812MG | tête | ALPS_2G | 100k lin (OD Gain) | 1 | RV201
Pot motorisé ALPS RK16812MG | tête | ALPS_2G | 100k log (Bass) | 1 | RV302
Pot motorisé ALPS RK16812MG | tête | ALPS_2G | 100k log (Master Normal) | 1 | RV305
Pot motorisé ALPS RK16812MG | tête | ALPS_2G | 100k log (Master OD) | 1 | RV304
Pot motorisé ALPS RK16812MG | Commandes | ALPS_2G | 10k lin (Blend) | 1 | RV802
Pot motorisé ALPS RK16812MG | tête | ALPS_2G | 10k log (Mid) | 1 | RV303
Pot motorisé ALPS RK16812MG | tête | ALPS_2G | 20k lin (Presence) | 1 | RV306
Pot motorisé ALPS RK16812MG | tête | ALPS_2G | 20k lin (Treble) | 1 | RV301
Q_NPN | Boîtier d'entrée | Q_NPN | BC550C | 1 | Q501
Q_PNP | Boîtier d'entrée | Q_PNP | BC560C | 1 | Q502
RN_SIP9 | Commandes de l'entrée | RN_SIP9 | 100k ×8 | 3 | RN901 RN902 RN903
RPI4_40P | Pilotage | RPI4_40P | Raspberry Pi 4 B (2 Go) | 1 | A601
Relais signal 2RT 5 V | Boîtier d'entrée | RELAY_2C | G6K-2 5 V | 3 | K501 K502 K503
Relais signal 2RT 5 V | tête | RELAY_2C | G6K-2 5 V | 2 | K201 K202
Résistance 1 à 3 W | tête | R | 100k 1 W | 2 | R225 R239
Résistance 1 à 3 W | tête | R | 10k 2 W | 1 | R109
Résistance 1 à 3 W | tête | R | 13k 3 W | 1 | R105
Résistance 1 à 3 W | tête | R | 15k 1 W | 2 | R106 R107
Résistance 1 à 3 W | tête | R | 220k 1 W | 4 | R101 R102 R103 R104
Résistance 1 à 3 W | tête | R | 22k 1 W | 1 | R108
Résistance 1 à 3 W | tête | R | 3.3k 1 W | 1 | R305
Résistance 1 à 3 W | tête | R | 330k 3 W | 2 | R124 R128
Résistance 1 à 3 W | tête | R | 470 1 W | 4 | R403 R413 R423 R433
Résistance 1 à 3 W | tête | R | 47k 2 W | 1 | R209
Résistance 1 à 3 W | tête | R | 68k 1 W | 1 | R110
Résistance 1/4 W 1 % (basse tension) | Commandes de l'entrée | R | 1.27k | 4 | R951 R954 R965 R968
Résistance 1/4 W 1 % (basse tension) | VCA et noise gate | R | 1.5M | 1 | R850
Résistance 1/4 W 1 % (basse tension) | Pilotage | R | 10 | 1 | R614
Résistance 1/4 W 1 % (basse tension) | Commandes de l'entrée | R | 10.7k | 1 | R902
Résistance 1/4 W 1 % (basse tension) | Boîtier d'entrée | R | 100 | 2 | R522 R545
Résistance 1/4 W 1 % (basse tension) | VCA et noise gate | R | 100 | 3 | R811 R841 R849
Résistance 1/4 W 1 % (basse tension) | Boîtier d'entrée | R | 100k | 6 | R513 R518 R524 R538 R544 R546
Résistance 1/4 W 1 % (basse tension) | VCA et noise gate | R | 100k | 3 | R801 R806 R826
Résistance 1/4 W 1 % (basse tension) | VCA et noise gate | R | 10M | 1 | R835
Résistance 1/4 W 1 % (basse tension) | Boîtier d'entrée | R | 10k | 13 | R503 R504 R505 R506 R507 R514 R515 R521 R527 R531 R532 R542 R543
Résistance 1/4 W 1 % (basse tension) | Commandes | R | 10k | 2 | R740 R741
Résistance 1/4 W 1 % (basse tension) | Pilotage | R | 10k | 11 | R603 R604 R605 R606 R607 R611 R615 R621 R627 R633 R640
Résistance 1/4 W 1 % (basse tension) | VCA et noise gate | R | 10k | 11 | R803 R814 R817 R821 R827 R828 R829 R831 R834 R843 R851
Résistance 1/4 W 1 % (basse tension) | Commandes de l'entrée | R | 113 | 1 | R920
Résistance 1/4 W 1 % (basse tension) | Commandes de l'entrée | R | 12.4k | 1 | R903
Résistance 1/4 W 1 % (basse tension) | Boîtier d'entrée | R | 120 | 1 | R526
Résistance 1/4 W 1 % (basse tension) | Boîtier d'entrée | R | 120k | 2 | R536 R540
Résistance 1/4 W 1 % (basse tension) | VCA et noise gate | R | 120k | 1 | R836
Résistance 1/4 W 1 % (basse tension) | Commandes de l'entrée | R | 124 | 1 | R929
Résistance 1/4 W 1 % (basse tension) | Commandes de l'entrée | R | 127 | 2 | R960 R973
Résistance 1/4 W 1 % (basse tension) | Commandes de l'entrée | R | 133 | 3 | R934 R961 R972
Résistance 1/4 W 1 % (basse tension) | Commandes de l'entrée | R | 137 | 2 | R946 R959
Résistance 1/4 W 1 % (basse tension) | Commandes de l'entrée | R | 14.7k | 2 | R904 R926
Résistance 1/4 W 1 % (basse tension) | Commandes de l'entrée | R | 143 | 1 | R921
Résistance 1/4 W 1 % (basse tension) | Commandes de l'entrée | R | 154 | 2 | R947 R958
Résistance 1/4 W 1 % (basse tension) | VCA et noise gate | R | 15k | 1 | R837
Résistance 1/4 W 1 % (basse tension) | Commandes de l'entrée | R | 16.9k | 1 | R905
Résistance 1/4 W 1 % (basse tension) | Boîtier d'entrée | R | 169 | 1 | R511
Résistance 1/4 W 1 % (basse tension) | Commandes de l'entrée | R | 169k | 1 | R977
Résistance 1/4 W 1 % (basse tension) | Commandes de l'entrée | R | 19.6k | 1 | R945
Résistance 1/4 W 1 % (basse tension) | Commandes de l'entrée | R | 191 | 1 | R922
Résistance 1/4 W 1 % (basse tension) | Commandes de l'entrée | R | 196 | 1 | R935
Résistance 1/4 W 1 % (basse tension) | Boîtier d'entrée | R | 1M | 1 | R502
Résistance 1/4 W 1 % (basse tension) | VCA et noise gate | R | 1M | 1 | R844
Résistance 1/4 W 1 % (basse tension) | Boîtier d'entrée | R | 1k | 4 | R501 R510 R512 R516
Résistance 1/4 W 1 % (basse tension) | Commandes | R | 1k | 10 | R701 R702 R703 R704 R705 R706 R707 R708 R709 R710
Résistance 1/4 W 1 % (basse tension) | Pilotage | R | 1k | 7 | R608 R609 R612 R616 R622 R628 R634
Résistance 1/4 W 1 % (basse tension) | VCA et noise gate | R | 1k | 3 | R812 R815 R822
Résistance 1/4 W 1 % (basse tension) | Commandes de l'entrée | R | 2.15k | 2 | R966 R967
Résistance 1/4 W 1 % (basse tension) | Commandes de l'entrée | R | 2.1k | 2 | R952 R953
Résistance 1/4 W 1 % (basse tension) | VCA et noise gate | R | 2.55k | 1 | R820
Résistance 1/4 W 1 % (basse tension) | Commandes de l'entrée | R | 2.94k | 1 | R927
Résistance 1/4 W 1 % (basse tension) | Commandes de l'entrée | R | 20k | 1 | R906
Résistance 1/4 W 1 % (basse tension) | Pilotage | R | 20k | 4 | R617 R623 R629 R635
Résistance 1/4 W 1 % (basse tension) | VCA et noise gate | R | 20k | 2 | R830 R832
Résistance 1/4 W 1 % (basse tension) | Boîtier d'entrée | R | 22 | 1 | R520
Résistance 1/4 W 1 % (basse tension) | Commandes | R | 220 | 14 | R721 R722 R723 R724 R725 R726 R727 R728 R729 R730 R731 R732 R733 R734
Résistance 1/4 W 1 % (basse tension) | Pilotage | R | 220 | 1 | R610
Résistance 1/4 W 1 % (basse tension) | Boîtier d'entrée | R | 220k | 1 | R529
Résistance 1/4 W 1 % (basse tension) | Boîtier d'entrée | R | 22k | 2 | R517 R523
Résistance 1/4 W 1 % (basse tension) | VCA et noise gate | R | 22k | 1 | R833
Résistance 1/4 W 1 % (basse tension) | Commandes de l'entrée | R | 23.2k | 1 | R907
Résistance 1/4 W 1 % (basse tension) | Commandes de l'entrée | R | 237 | 3 | R928 R962 R971
Résistance 1/4 W 1 % (basse tension) | Commandes de l'entrée | R | 255 | 2 | R948 R957
Résistance 1/4 W 1 % (basse tension) | Commandes de l'entrée | R | 26.7k | 1 | R908
Résistance 1/4 W 1 % (basse tension) | Commandes de l'entrée | R | 261 | 1 | R923
Résistance 1/4 W 1 % (basse tension) | Boîtier d'entrée | R | 270 | 3 | R537 R539 R541
Résistance 1/4 W 1 % (basse tension) | Commandes de l'entrée | R | 287k | 1 | R978
Résistance 1/4 W 1 % (basse tension) | Commandes de l'entrée | R | 28k | 1 | R944
Résistance 1/4 W 1 % (basse tension) | Commandes de l'entrée | R | 2k | 1 | R939
Résistance 1/4 W 1 % (basse tension) | Boîtier d'entrée | R | 3.3k | 2 | R534 R535
Résistance 1/4 W 1 % (basse tension) | Commandes de l'entrée | R | 301 | 1 | R936
Résistance 1/4 W 1 % (basse tension) | VCA et noise gate | R | 30k | 5 | R802 R804 R818 R845 R848
Résistance 1/4 W 1 % (basse tension) | Commandes de l'entrée | R | 31.6k | 1 | R909
Résistance 1/4 W 1 % (basse tension) | Pilotage | R | 33 | 1 | R613
Résistance 1/4 W 1 % (basse tension) | Commandes de l'entrée | R | 33.2k | 1 | R974
Résistance 1/4 W 1 % (basse tension) | VCA et noise gate | R | 33k | 1 | R825
Résistance 1/4 W 1 % (basse tension) | Commandes de l'entrée | R | 36.5k | 1 | R910
Résistance 1/4 W 1 % (basse tension) | Commandes de l'entrée | R | 392 | 1 | R924
Résistance 1/4 W 1 % (basse tension) | Boîtier d'entrée | R | 4.7k | 1 | R509
Résistance 1/4 W 1 % (basse tension) | Pilotage | R | 4.7k | 1 | R650
Résistance 1/4 W 1 % (basse tension) | Commandes de l'entrée | R | 402 | 2 | R963 R970
Résistance 1/4 W 1 % (basse tension) | Commandes de l'entrée | R | 412 | 2 | R949 R956
Résistance 1/4 W 1 % (basse tension) | Commandes de l'entrée | R | 43.2k | 1 | R911
Résistance 1/4 W 1 % (basse tension) | Commandes de l'entrée | R | 46.4k | 1 | R943
Résistance 1/4 W 1 % (basse tension) | VCA et noise gate | R | 470 | 1 | R840
Résistance 1/4 W 1 % (basse tension) | Boîtier d'entrée | R | 470k | 2 | R519 R525
Résistance 1/4 W 1 % (basse tension) | Boîtier d'entrée | R | 47k | 1 | R530
Résistance 1/4 W 1 % (basse tension) | VCA et noise gate | R | 47k | 2 | R839 R842
Résistance 1/4 W 1 % (basse tension) | Commandes de l'entrée | R | 487 | 1 | R937
Résistance 1/4 W 1 % (basse tension) | Commandes de l'entrée | R | 49.9k | 1 | R912
Résistance 1/4 W 1 % (basse tension) | Commandes de l'entrée | R | 499k | 1 | R979
Résistance 1/4 W 1 % (basse tension) | VCA et noise gate | R | 500 | 3 | R805 R808 R846
Résistance 1/4 W 1 % (basse tension) | Commandes de l'entrée | R | 51.1 | 1 | R931
Résistance 1/4 W 1 % (basse tension) | Boîtier d'entrée | R | 51k | 1 | R508
Résistance 1/4 W 1 % (basse tension) | Commandes de l'entrée | R | 57.6k | 2 | R913 R975
Résistance 1/4 W 1 % (basse tension) | VCA et noise gate | R | 6.2k | 2 | R813 R816
Résistance 1/4 W 1 % (basse tension) | Commandes de l'entrée | R | 60.4 | 1 | R916
Résistance 1/4 W 1 % (basse tension) | Commandes de l'entrée | R | 63.4k | 1 | R941
Résistance 1/4 W 1 % (basse tension) | Commandes de l'entrée | R | 649 | 1 | R925
Résistance 1/4 W 1 % (basse tension) | Commandes de l'entrée | R | 66.5 | 1 | R917
Résistance 1/4 W 1 % (basse tension) | Commandes de l'entrée | R | 68.1 | 1 | R932
Résistance 1/4 W 1 % (basse tension) | Commandes de l'entrée | R | 68.1k | 1 | R914
Résistance 1/4 W 1 % (basse tension) | Commandes de l'entrée | R | 681 | 2 | R964 R969
Résistance 1/4 W 1 % (basse tension) | Boîtier d'entrée | R | 68k | 2 | R528 R533
Résistance 1/4 W 1 % (basse tension) | Commandes de l'entrée | R | 698 | 2 | R950 R955
Résistance 1/4 W 1 % (basse tension) | VCA et noise gate | R | 7.5k | 5 | R807 R809 R810 R819 R847
Résistance 1/4 W 1 % (basse tension) | Commandes de l'entrée | R | 7.68k | 1 | R940
Résistance 1/4 W 1 % (basse tension) | Commandes de l'entrée | R | 76.8 | 1 | R918
Résistance 1/4 W 1 % (basse tension) | Commandes de l'entrée | R | 78.7k | 1 | R915
Résistance 1/4 W 1 % (basse tension) | Commandes de l'entrée | R | 80.6k | 1 | R942
Résistance 1/4 W 1 % (basse tension) | Commandes de l'entrée | R | 84.5 | 1 | R930
Résistance 1/4 W 1 % (basse tension) | Commandes de l'entrée | R | 845k | 1 | R980
Résistance 1/4 W 1 % (basse tension) | Commandes de l'entrée | R | 887 | 1 | R938
Résistance 1/4 W 1 % (basse tension) | Commandes de l'entrée | R | 9.31k | 1 | R901
Résistance 1/4 W 1 % (basse tension) | Commandes de l'entrée | R | 93.1 | 1 | R919
Résistance 1/4 W 1 % (basse tension) | Commandes de l'entrée | R | 95.3 | 1 | R933
Résistance 1/4 W 1 % (basse tension) | Commandes de l'entrée | R | 97.6k | 1 | R976
Résistance couche métal 1/2 W 1 % | tête | R | 1 1 % 0,5 W | 4 | R404 R414 R424 R434
Résistance couche métal 1/2 W 1 % | tête | R | 1.2M | 1 | R206
Résistance couche métal 1/2 W 1 % | tête | R | 1.8k | 3 | R204 R219 R238
Résistance couche métal 1/2 W 1 % | tête | R | 100k | 4 | R214 R218 R231 R314
Résistance couche métal 1/2 W 1 % | tête | R | 10k | 5 | R112 R115 R118 R121 R312
Résistance couche métal 1/2 W 1 % | tête | R | 12k | 1 | R232
Résistance couche métal 1/2 W 1 % | tête | R | 1M | 15 | R114 R117 R120 R123 R201 R205 R207 R208 R220 R223 R229 R304 R306 R309 R310
Résistance couche métal 1/2 W 1 % | tête | R | 1k | 1 | R307
Résistance couche métal 1/2 W 1 % | tête | R | 2.2M | 2 | R216 R234
Résistance couche métal 1/2 W 1 % | tête | R | 2.2k | 6 | R111 R215 R402 R412 R422 R432
Résistance couche métal 1/2 W 1 % | tête | R | 220k | 4 | R203 R236 R237 R301
Résistance couche métal 1/2 W 1 % | tête | R | 3.3k | 2 | R226 R317
Résistance couche métal 1/2 W 1 % | tête | R | 3.9k | 1 | R233
Résistance couche métal 1/2 W 1 % | tête | R | 300k | 1 | R302
Résistance couche métal 1/2 W 1 % | tête | R | 330k | 2 | R224 R235
Résistance couche métal 1/2 W 1 % | tête | R | 39k | 2 | R230 R316
Résistance couche métal 1/2 W 1 % | tête | R | 4.7M | 3 | R221 R222 R227
Résistance couche métal 1/2 W 1 % | tête | R | 4.7k | 2 | R308 R315
Résistance couche métal 1/2 W 1 % | tête | R | 470 | 1 | R311
Résistance couche métal 1/2 W 1 % | tête | R | 470k | 6 | R217 R228 R401 R411 R421 R431
Résistance couche métal 1/2 W 1 % | tête | R | 47k | 5 | R113 R116 R119 R122 R125
Résistance couche métal 1/2 W 1 % | tête | R | 68k | 1 | R202
Résistance couche métal 1/2 W 1 % | tête | R | 7.5k | 1 | R213
Résistance couche métal 1/2 W 1 % | tête | R | 820k | 1 | R303
Résistance couche métal 1/2 W 1 % | tête | R | 82k | 2 | R129 R313
Résistance couche métal 1/2 W 1 % | tête | R | 91k | 3 | R210 R211 R212
SMPS_MOD | Pilotage | SMPS_MOD | IRM-60-24ST | 1 | U604
SW_1P3T | tête | SW_1P3T | Impédance | 1 | SW401
SW_DPST | tête | SW_DPST | Power | 1 | SW101
SW_SPST | tête | SW_SPST | Standby | 1 | SW102
TFT_ST7789 | Pilotage | TFT_ST7789 | TFT 2,4" SPI | 1 | J601
TL074 | VCA et noise gate | TL074 | TL074 | 2 | U804 U805
T_LV | Pilotage | T_LV | 2 × 15 V 10 VA | 1 | T601
ULN2803A | Commandes | ULN2803A | ULN2803A | 3 | U708 U709 U710
Électrolytique (tête) | tête | CP | 100µ 160 V | 2 | C111 C112
Électrolytique (tête) | tête | CP | 10µ 550 V | 3 | C106 C107 C110
Électrolytique (tête) | tête | CP | 220µ 25 V | 1 | C304
Électrolytique (tête) | tête | CP | 220µ 350 V | 2 | C103 C104
Électrolytique (tête) | tête | CP | 470µ 350 V | 2 | C101 C102
Électrolytique (tête) | tête | CP | 47µ 100 V | 1 | C113
Électrolytique (tête) | tête | CP | 47µ 160 V | 1 | C114
Électrolytique (tête) | tête | CP | 47µ 550 V | 3 | C105 C108 C109
Électrolytique basse tension | Boîtier d'entrée | CP | 0.15µ 35 V | 1 | C530
Électrolytique basse tension | Boîtier d'entrée | CP | 0.1µ 35 V | 1 | C532
Électrolytique basse tension | Boîtier d'entrée | CP | 1.5µ 35 V | 1 | C528
Électrolytique basse tension | Pilotage | CP | 1000µ 35 V | 2 | C601 C602
Électrolytique basse tension | Pilotage | CP | 10µ 10 V | 1 | C634
Électrolytique basse tension | Boîtier d'entrée | CP | 10µ 16 V | 2 | C519 C534
Électrolytique basse tension | Boîtier d'entrée | CP | 10µ 25 V | 2 | C503 C513
Électrolytique basse tension | Commandes de l'entrée | CP | 10µ 25 V | 2 | C913 C914
Électrolytique basse tension | Boîtier d'entrée | CP | 1µ 50 V | 2 | C524 C526
Électrolytique basse tension | Pilotage | CP | 2.2µ 35 V | 1 | C605
Électrolytique basse tension | Pilotage | CP | 220µ 10 V | 1 | C627
Électrolytique basse tension | Pilotage | CP | 22µ 25 V | 2 | C604 C606
Électrolytique basse tension | VCA et noise gate | CP | 22µ 25 V | 2 | C832 C833
Électrolytique basse tension | Commandes | CP | 470µ 10 V | 1 | C730
Électrolytique basse tension | Pilotage | CP | 470µ 35 V | 1 | C620
Électrolytique basse tension | Boîtier d'entrée | CP | 47µ 16 V | 3 | C505 C515 C516
