Arnwald/slo-pilote/robot/out/robot_micro_assemblage.step

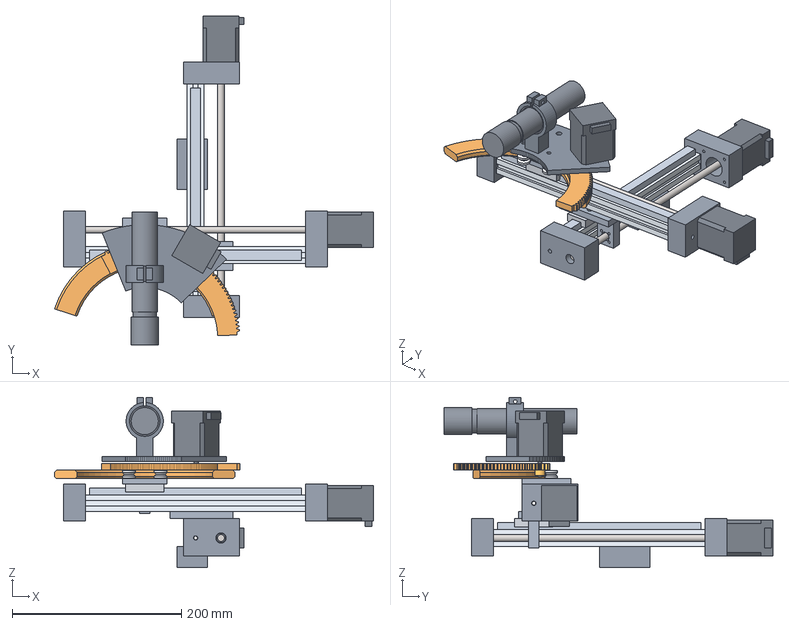
[picture p11: CAD file, 2026-11-08]
robot/out/robot_micro_assemblage.step
376.5 x 388.3 x 201.0 mm
arc_dente
plaque_X
bloc_ecrou_X
chariot_MGN12H_X
plaque_angle
collier_micro
manchon_TPU
servo_angle
pignon
roue_V_int-
roue_V_int+
roue_V_ext
micro_SM57
poutre_X
rail_X
bloc_moteur_X
palier_X
servo_X
vis_X
plaque_Z
bloc_ecrou_Z
chariot_MGN12H_Z
poutre_Z
rail_Z
bloc_moteur_Z
palier_Z
servo_Z
vis_Z
adaptateur_pied
