Arnwald/slo-pilote/mech/out/dxf/grille_x2.dxf

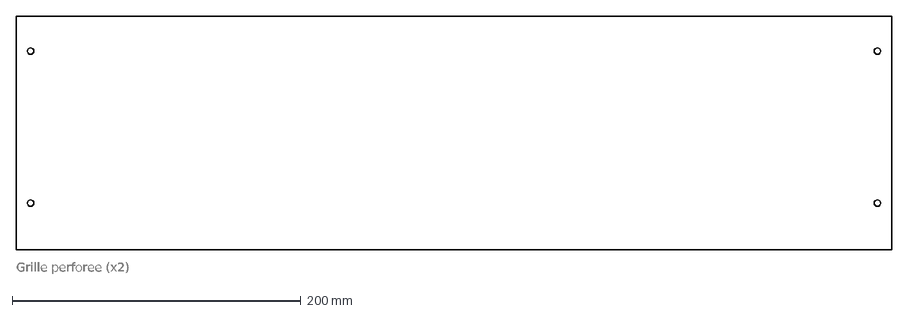
[picture p12: CAD file, 2026-11-08]
mech/out/dxf/grille_x2.dxf
Grille perforee (x2)
