Arnwald/slo-pilote/robot/out/step/palier_Z.step

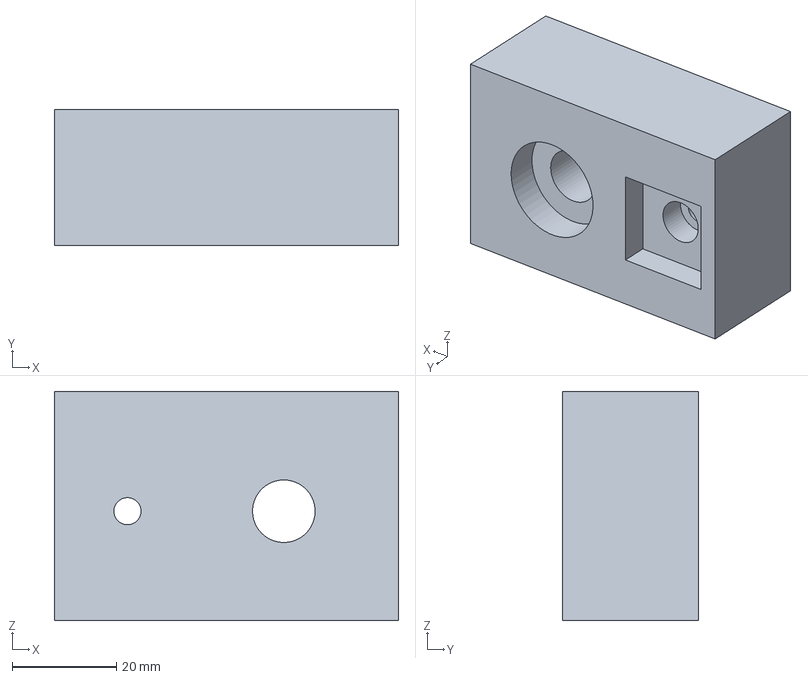
[picture p13: CAD file, 2026-11-08]
robot/out/step/palier_Z.step
66.0 x 26.0 x 44.0 mm
