Arnwald/slo-pilote/mech/out/dxf/fond.dxf

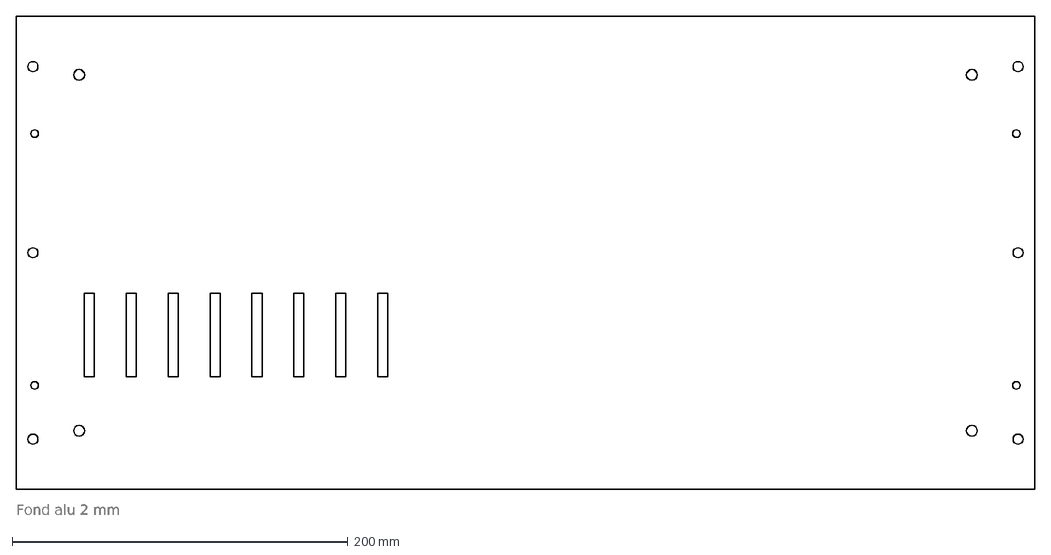
[picture p14: CAD file, 2026-11-08]
mech/out/dxf/fond.dxf
Fond alu 2 mm
