Arnwald/slo-pilote/mech/out/dxf/capot_developpe.dxf

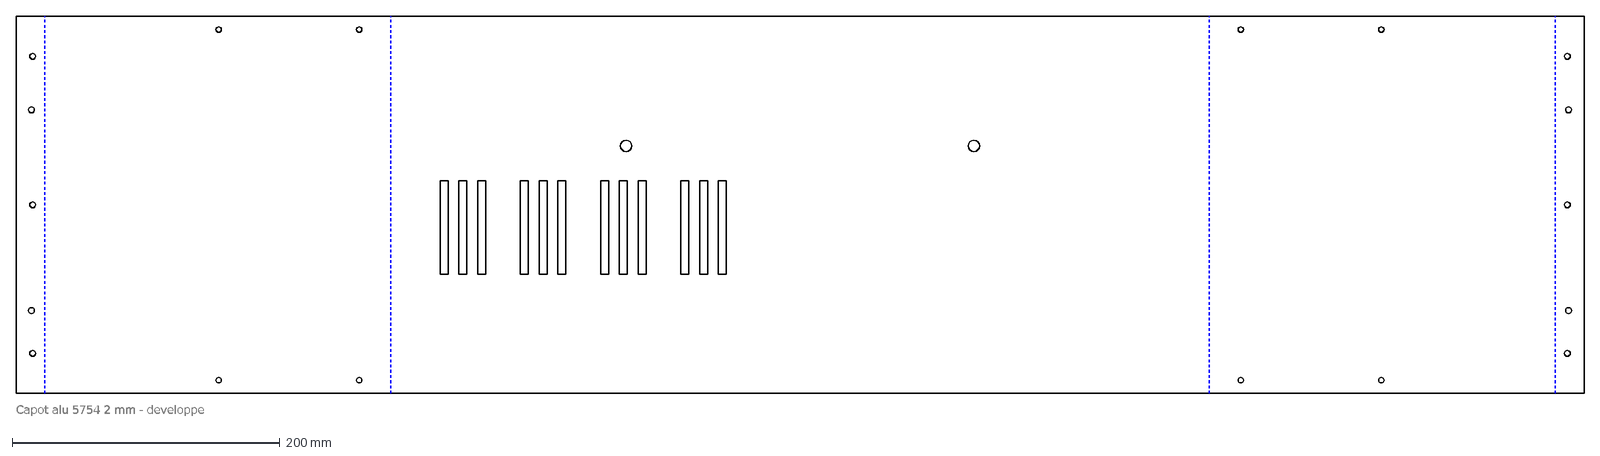
[picture p15: CAD file, 2026-11-08]
mech/out/dxf/capot_developpe.dxf
Capot alu 5754 2 mm - developpe
