Arnwald/slo-pilote/robot/out/step/plaque_Z.step

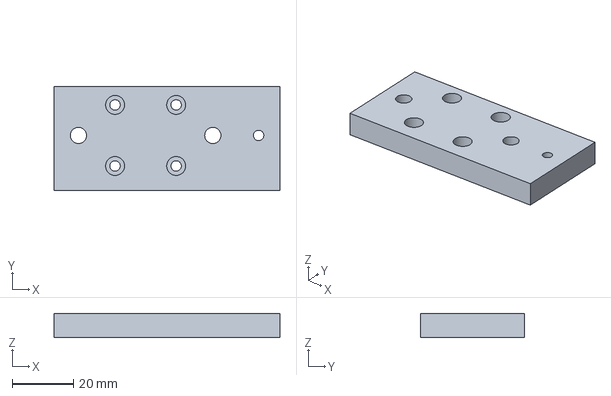
[picture p16: CAD file, 2026-11-08]
robot/out/step/plaque_Z.step
74.0 x 34.0 x 8.00 mm
