Arnwald/slo-pilote/mech/out/dxf/chassis_developpe.dxf

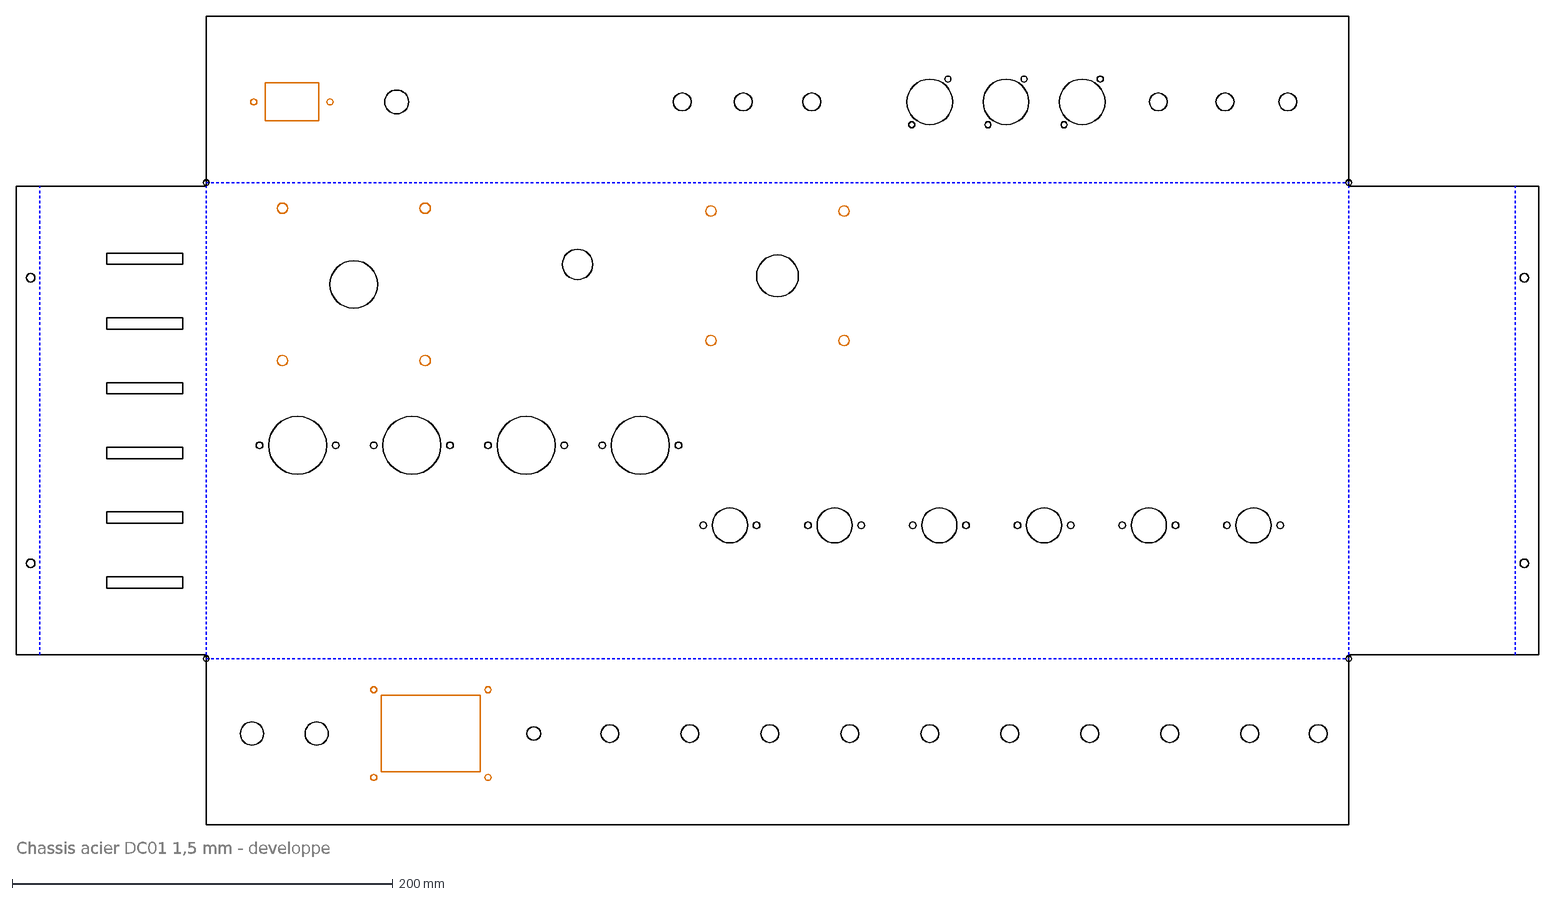
[picture p17: CAD file, 2026-11-08]
mech/out/dxf/chassis_developpe.dxf
Chassis acier DC01 1,5 mm - developpe
