Arnwald/slo-pilote/robot/out/step/arc_dente.step

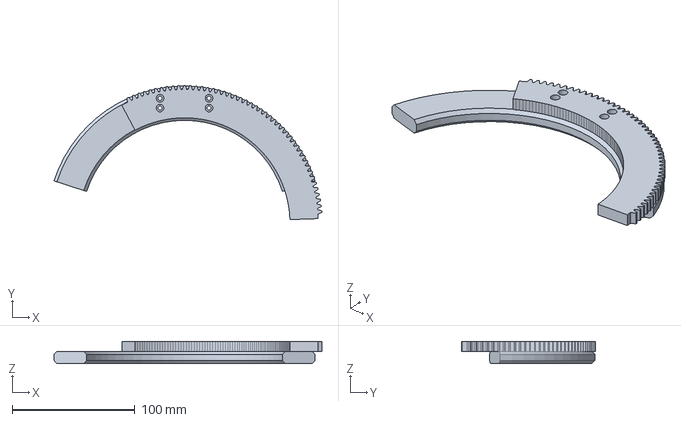
[picture p18: CAD file, 2026-11-08]
robot/out/step/arc_dente.step
218.7 x 109.5 x 18.0 mm
