Arnwald/slo-pilote/robot/out/step/plaque_X.step

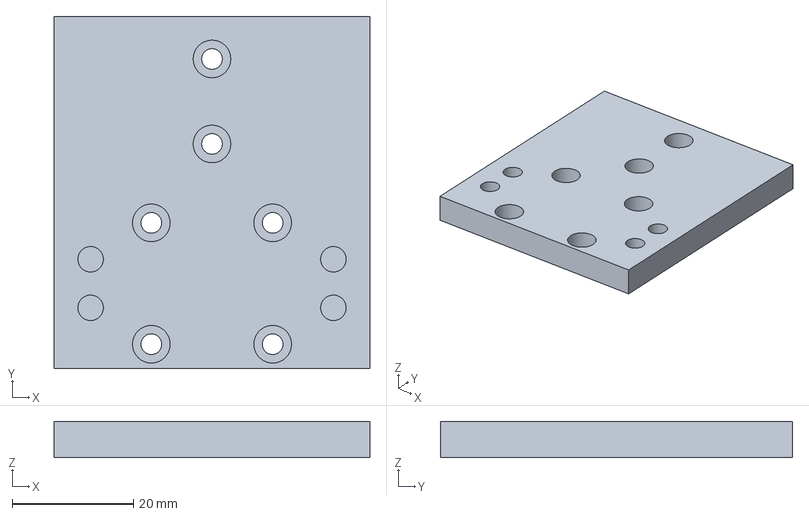
[picture p19: CAD file, 2026-11-08]
robot/out/step/plaque_X.step
52.0 x 58.0 x 6.00 mm
