Arnwald/slo-pilote/robot/out/step/bloc_ecrou_Z.step

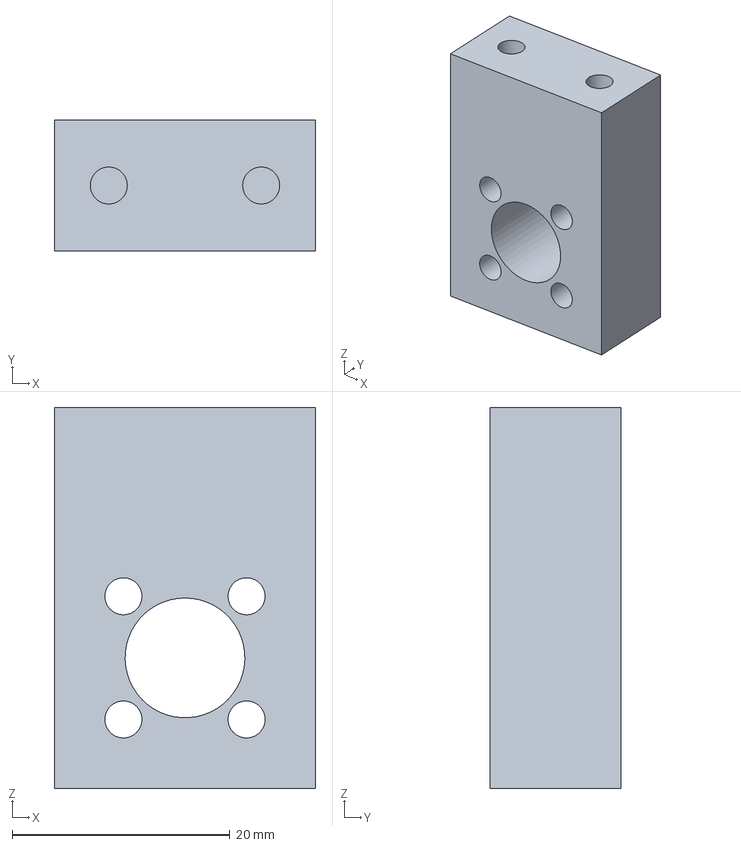
[picture p20: CAD file, 2026-11-08]
robot/out/step/bloc_ecrou_Z.step
24.0 x 12.0 x 35.0 mm
