Arnwald/slo-pilote/robot/out/step/bloc_moteur_Z.step

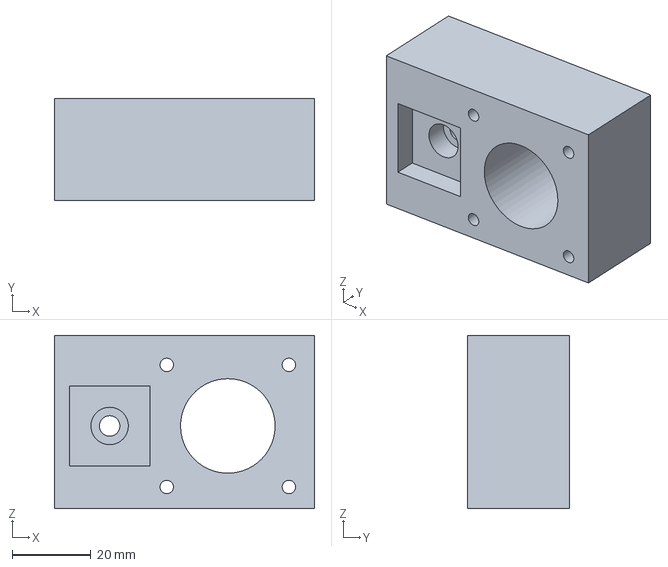
[picture p21: CAD file, 2026-11-08]
robot/out/step/bloc_moteur_Z.step
66.0 x 26.0 x 44.0 mm
