Arnwald/slo-pilote/robot/out/step/plaque_angle.step

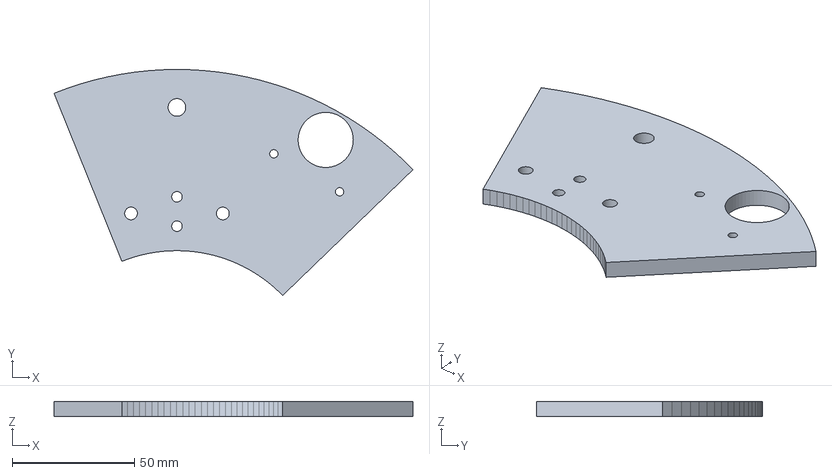
[picture p22: CAD file, 2026-11-08]
robot/out/step/plaque_angle.step
146.6 x 92.3 x 6.00 mm
