Arnwald/slo-pilote/robot/out/step/collier_micro.step

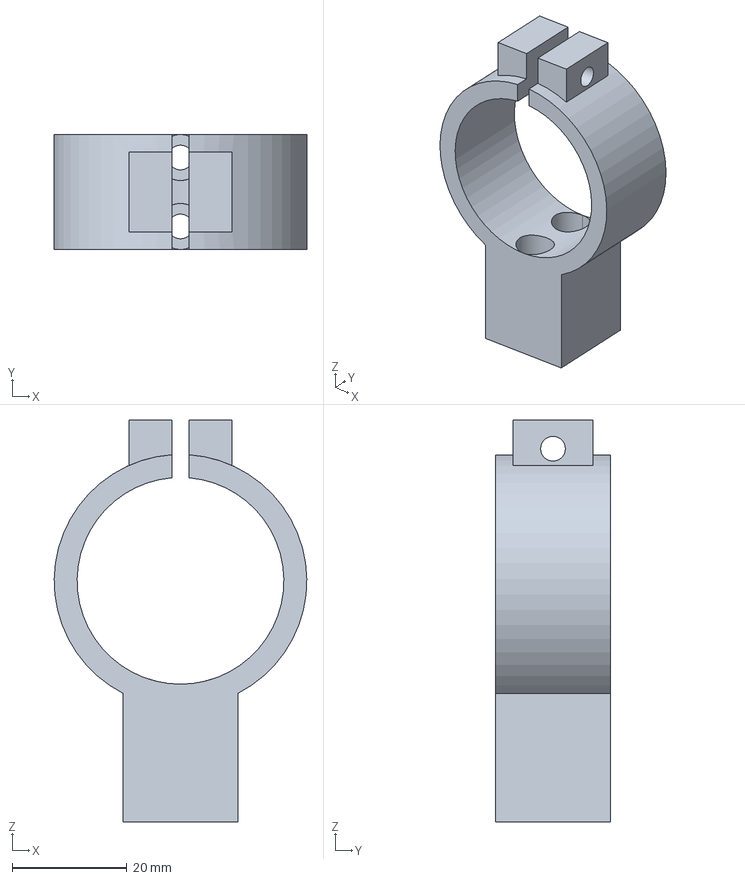
[picture p23: CAD file, 2026-11-08]
robot/out/step/collier_micro.step
44.0 x 20.0 x 70.0 mm
