Arnwald/slo-pilote/robot/out/step/pignon.step

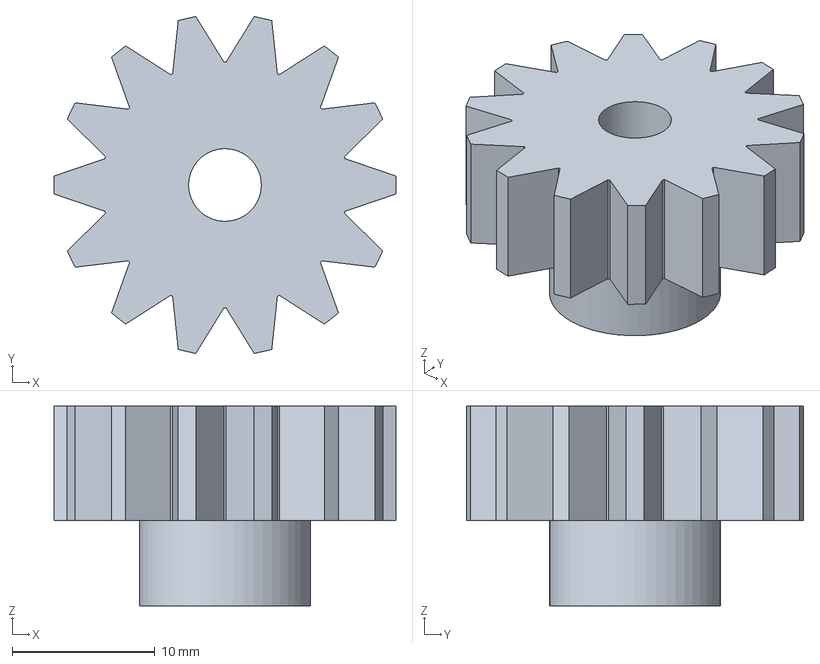
[picture p24: CAD file, 2026-11-08]
robot/out/step/pignon.step
24.0 x 23.6 x 14.0 mm
