Arnwald/slo-pilote/robot/out/step/manchon_TPU.step

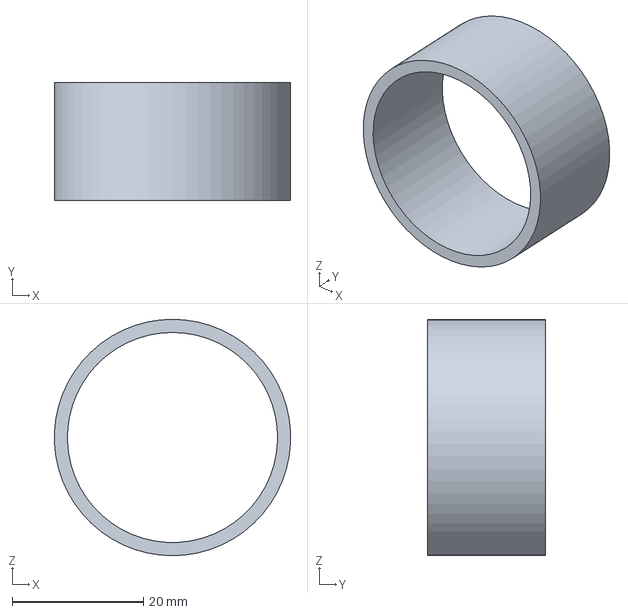
[picture p25: CAD file, 2026-11-08]
robot/out/step/manchon_TPU.step
35.9 x 18.0 x 36.0 mm
