Arnwald/slo-pilote/robot/out/step/adaptateur_pied.step

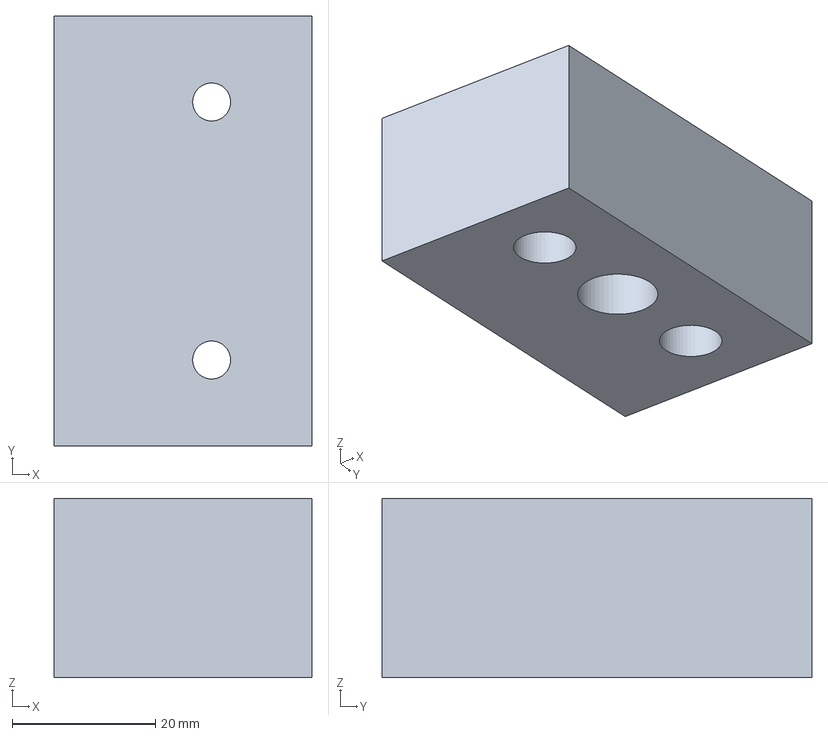
[picture p26: CAD file, 2026-11-08]
robot/out/step/adaptateur_pied.step
36.0 x 60.0 x 25.0 mm
