Arnwald/slo-pilote/(list of files, cad)

Other CAD files:
robot/out/step/palier_X.step
robot/out/step/bloc_ecrou_X.step
robot/out/step/bloc_moteur_X.step
robot/out/stl/adaptateur_pied.stl
robot/out/stl/arc_dente.stl
robot/out/stl/bloc_ecrou_X.stl
robot/out/stl/bloc_ecrou_Z.stl
robot/out/stl/bloc_moteur_X.stl
robot/out/stl/bloc_moteur_Z.stl
robot/out/stl/collier_micro.stl
robot/out/stl/manchon_TPU.stl
robot/out/stl/palier_X.stl
robot/out/stl/palier_Z.stl
robot/out/stl/pignon.stl
robot/out/stl/plaque_X.stl
robot/out/stl/plaque_Z.stl
robot/out/stl/plaque_angle.stl
