Arnwald/slo-pilote/spice/steps_result.txt

TS Drive (dB de gain), 16 positions, total 499.51 k
  pos  cumul (Ω)   visé    obtenu
    0          0   +21.48   +21.48
    1       9310   +22.81   +22.82
    2      20010   +24.14   +24.15
    3      32410   +25.47   +25.46
    4      47110   +26.80   +26.80
    5      64010   +28.14   +28.12
    6      84010   +29.47   +29.47
    7     107210   +30.80   +30.80
    8     133910   +32.13   +32.12
    9     165510   +33.46   +33.46
   10     202010   +34.79   +34.78
   11     245210   +36.13   +36.13
   12     295110   +37.46   +37.46
   13     352710   +38.79   +38.78
   14     420810   +40.12   +40.12
   15     499510   +41.45   +41.45
  incréments E96 : 9310, 10700, 12400, 14700, 16900, 20000, 23200, 26700, 31600, 36500, 43200, 49900, 57600, 68100, 78700
  écart max 0.02

TS Tone (dB à 4 kHz / 200 Hz), 16 positions, total 20.13 k
  potentiomètre d'origine : -2.37 à -17.40
  pos  cumul (Ω)   visé    obtenu
    0          0    -2.37    -2.36
    1         60    -3.38    -3.36
    2        127    -4.38    -4.36
    3        204    -5.38    -5.35
    4        297    -6.38    -6.36
    5        410    -7.38    -7.35
    6        553    -8.38    -8.35
    7        744    -9.39    -9.36
    8       1005   -10.39   -10.36
    9       1397   -11.39   -11.38
   10       2046   -12.39   -12.39
   11      16746   -13.39   -13.32
   12      19686   -14.39   -14.40
   13      19923   -15.40   -15.41
   14      20047   -16.40   -16.41
   15      20131   -17.40   -17.41
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
    2      90800   +30.39   +30.33
    3     188400   +52.10   +51.80
    4     357400   +89.31   +88.98
    5     644400  +153.11  +152.12
    6    1143400  +262.49  +261.90
    7    1988400  +450.00  +447.80
  incréments E96 : 33200, 57600, 97600, 169000, 287000, 499000, 845000
  écart max 2.20
