Arnwald/slo-pilote/kicad/slo-pilote/alimentation.kicad_sch

## KiCad design kicad/slo-pilote/alimentation.kicad_sch (2026-11-08)

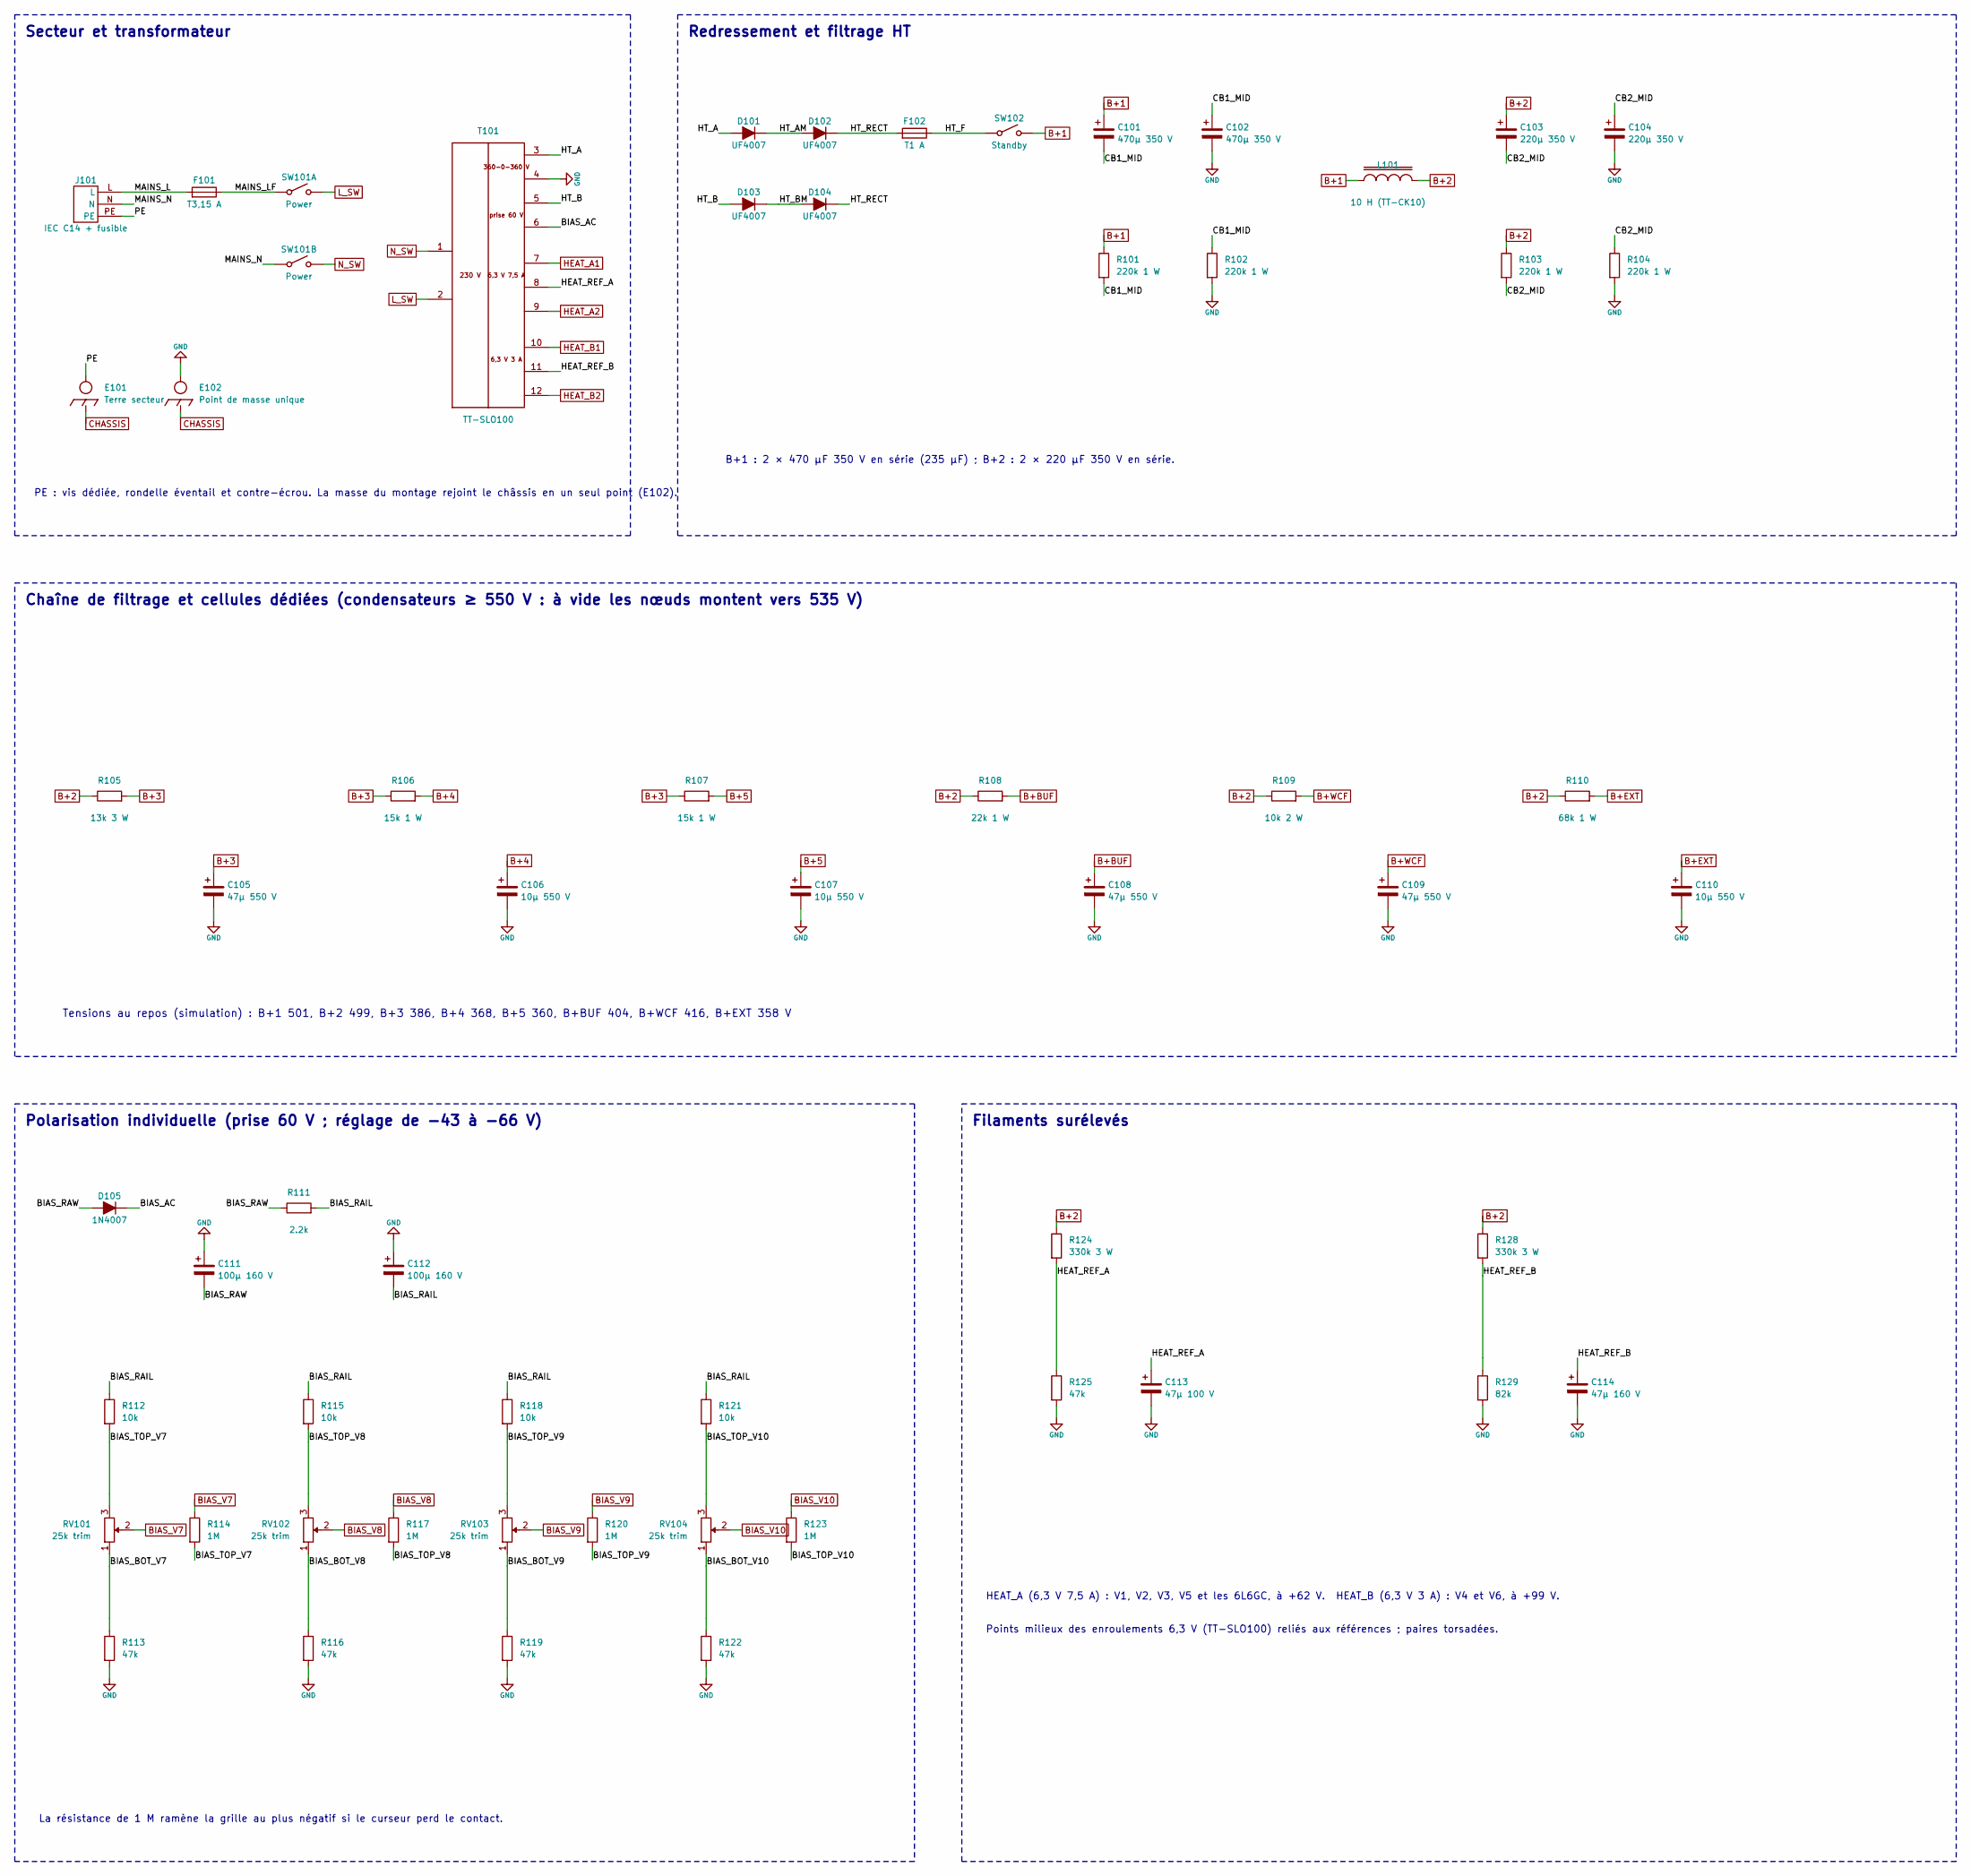
[picture p27: schematic alimentation.kicad_sch]

Parts:
C101, C102: 470µ 350 V
C103, C104: 220µ 350 V
C105, C108, C109: 47µ 550 V
C106, C107, C110: 10µ 550 V
C111, C112: 100µ 160 V
C113: 47µ 100 V
C114: 47µ 160 V
D101, D102, D103, D104: UF4007
D105: 1N4007
E101: Terre secteur
E102: Point de masse unique
F101: T3,15 A
F102: T1 A
J101: IEC C14 + fusible
L101: 10 H (TT-CK10)
R101, R102, R103, R104: 220k 1 W
R105: 13k 3 W
R106, R107: 15k 1 W
R108: 22k 1 W
R109: 10k 2 W
R110: 68k 1 W
R111: 2.2k
R112, R115, R118, R121: 10k
R113, R116, R119, R122, R125: 47k
R114, R117, R120, R123: 1M
R124, R128: 330k 3 W
R129: 82k
RV101, RV102, RV103, RV104: 25k trim
SW101: Power
SW102: Standby
T101: TT-SLO100

Connections:
B+1: C101.1 (+), L101.1, R101.1, SW102.2
B+2: C103.1 (+), L101.2, R103.1, R105.1, R108.1, R109.1, R110.1, R124.1, R128.1
B+3: C105.1 (+), R105.2, R106.1, R107.1
B+4: C106.1 (+), R106.2
B+5: C107.1 (+), R107.2
B+BUF: C108.1 (+), R108.2
B+EXT: C110.1 (+), R110.2
B+WCF: C109.1 (+), R109.2
BIAS_AC: D105.2 (K), T101.6 (BIAS)
BIAS_BOT_V7: R113.1, RV101.1
BIAS_BOT_V8: R116.1, RV102.1
BIAS_BOT_V9: R119.1, RV103.1
BIAS_BOT_V10: R122.1, RV104.1
BIAS_RAIL: C112.2 (-), R111.2, R112.1, R115.1, R118.1, R121.1
BIAS_RAW: C111.2 (-), D105.1 (A), R111.1
BIAS_TOP_V7: R112.2, R114.2, RV101.3
BIAS_TOP_V8: R115.2, R117.2, RV102.3
BIAS_TOP_V9: R118.2, R120.2, RV103.3
BIAS_TOP_V10: R121.2, R123.2, RV104.3
BIAS_V7: R114.1, RV101.2 (W)
BIAS_V8: R117.1, RV102.2 (W)
BIAS_V9: R120.1, RV103.2 (W)
BIAS_V10: R123.1, RV104.2 (W)
CB1_MID: C101.2 (-), C102.1 (+), R101.2, R102.1
CB2_MID: C103.2 (-), C104.1 (+), R103.2, R104.1
CHASSIS: E101.2 (CH), E102.2 (CH)
GND: C102.2 (-), C104.2 (-), C105.2 (-), C106.2 (-), C107.2 (-), C108.2 (-), C109.2 (-), C110.2 (-), C111.1 (+), C112.1 (+), C113.2 (-), C114.2 (-), E102.1, R102.2, R104.2, R113.2, R116.2, R119.2, R122.2, R125.2, R129.2, T101.4 (HT_CT)
HEAT_A1: T101.7 (6V3_A1)
HEAT_A2: T101.9 (6V3_A2)
HEAT_B1: T101.10 (6V3_B1)
HEAT_B2: T101.12 (6V3_B2)
HEAT_REF_A: C113.1 (+), R124.2, R125.1, T101.8 (6V3_ACT)
HEAT_REF_B: C114.1 (+), R128.2, R129.1, T101.11 (6V3_BCT)
HT_A: D101.1 (A), T101.3 (HT1)
HT_AM: D101.2 (K), D102.1 (A)
HT_B: D103.1 (A), T101.5 (HT2)
HT_BM: D103.2 (K), D104.1 (A)
HT_F: F102.2, SW102.1
HT_RECT: D102.2 (K), D104.2 (K), F102.1
L_SW: SW101.2, T101.2 (230V)
MAINS_L: F101.1, J101.L
MAINS_LF: F101.2, SW101.1
MAINS_N: J101.N, SW101.3
N_SW: SW101.4, T101.1 (0V)
PE: E101.1, J101.PE

Notes on the sheet:
PE : vis dédiée, rondelle éventail et contre-écrou. La masse du montage rejoint le châssis en un seul point (E102).
B+1 : 2 × 470 µF 350 V en série (235 µF) ; B+2 : 2 × 220 µF 350 V en série.
Tensions au repos (simulation) : B+1 501, B+2 499, B+3 386, B+4 368, B+5 360, B+BUF 404, B+WCF 416, B+EXT 358 V
La résistance de 1 M ramène la grille au plus négatif si le curseur perd le contact.
HEAT_A (6,3 V 7,5 A) : V1, V2, V3, V5 et les 6L6GC, à +62 V. HEAT_B (6,3 V 3 A) : V4 et V6, à +99 V.
Points milieux des enroulements 6,3 V (TT-SLO100) reliés aux références ; paires torsadées.
Secteur et transformateur
Redressement et filtrage HT
Chaîne de filtrage et cellules dédiées (condensateurs ≥ 550 V : à vide les nœuds montent vers 535 V)
Polarisation individuelle (prise 60 V ; réglage de −43 à −66 V)
Filaments surélevés
