Arnwald/slo-pilote/kicad/slo-pilote/boitier_entree.kicad_sch

## KiCad design kicad/slo-pilote/boitier_entree.kicad_sch (2026-11-08)

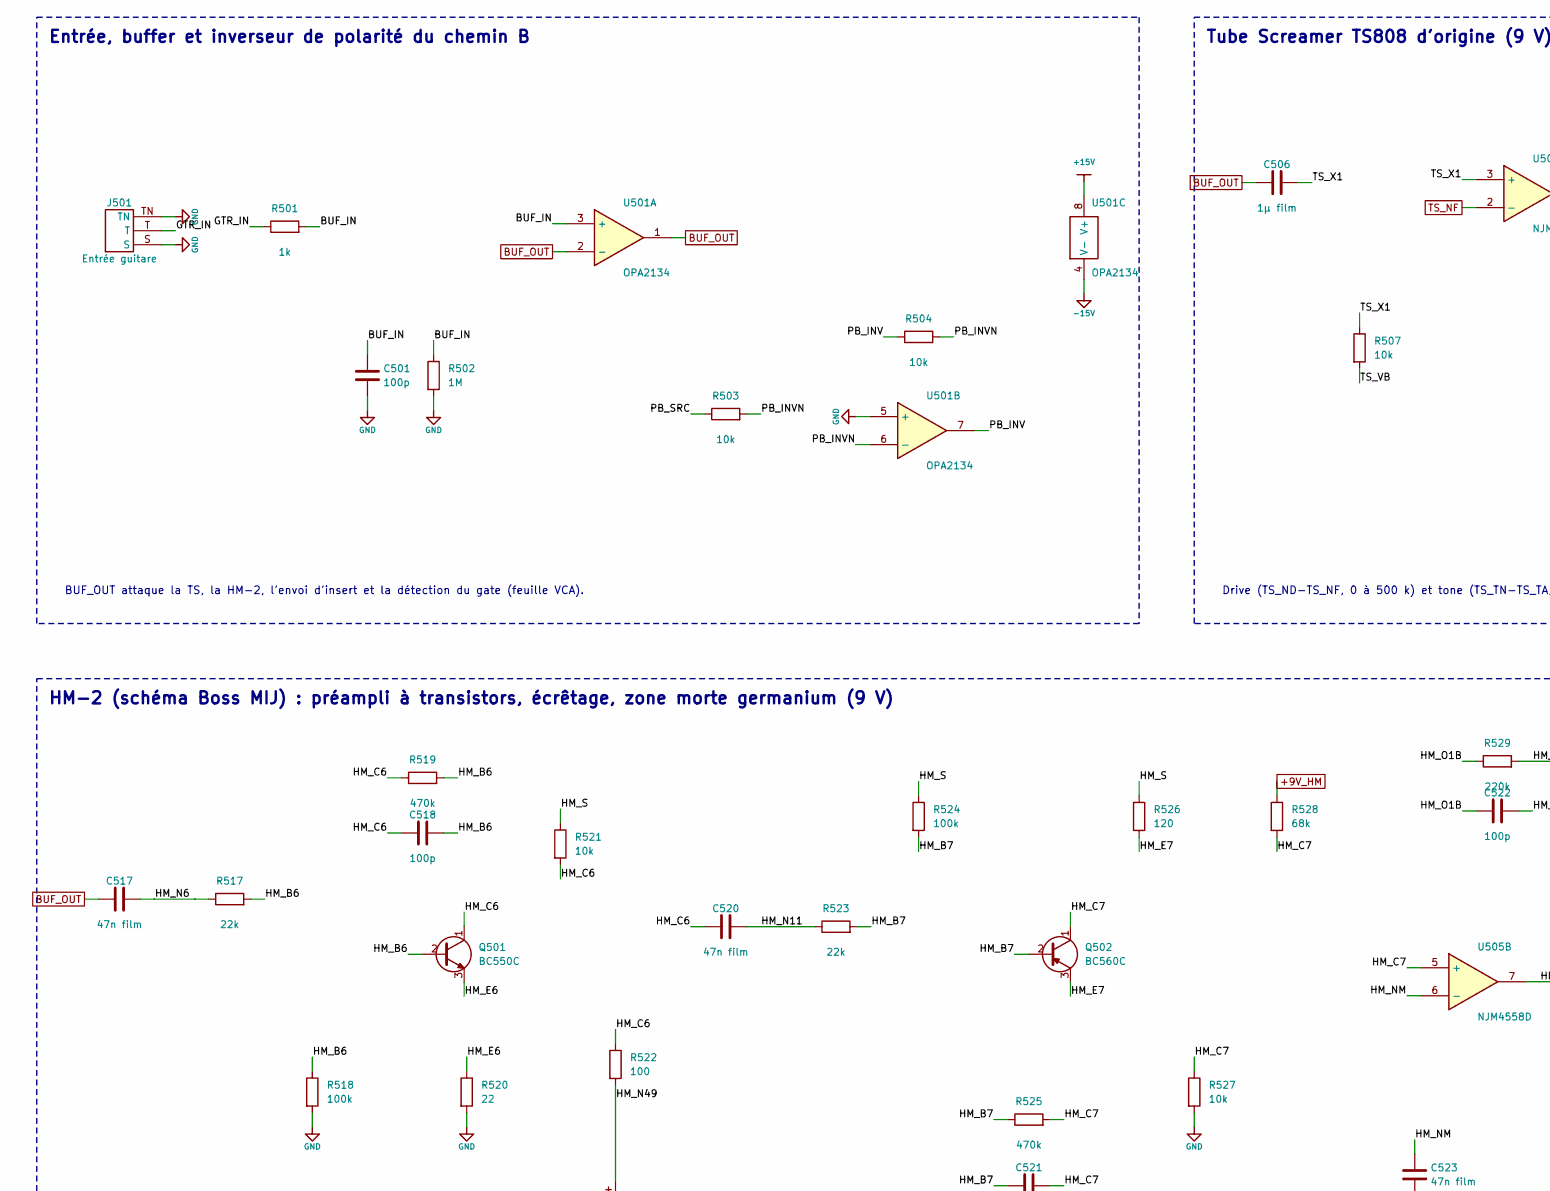
[picture p28: schematic boitier_entree.kicad_sch, part in row 1, column 1]

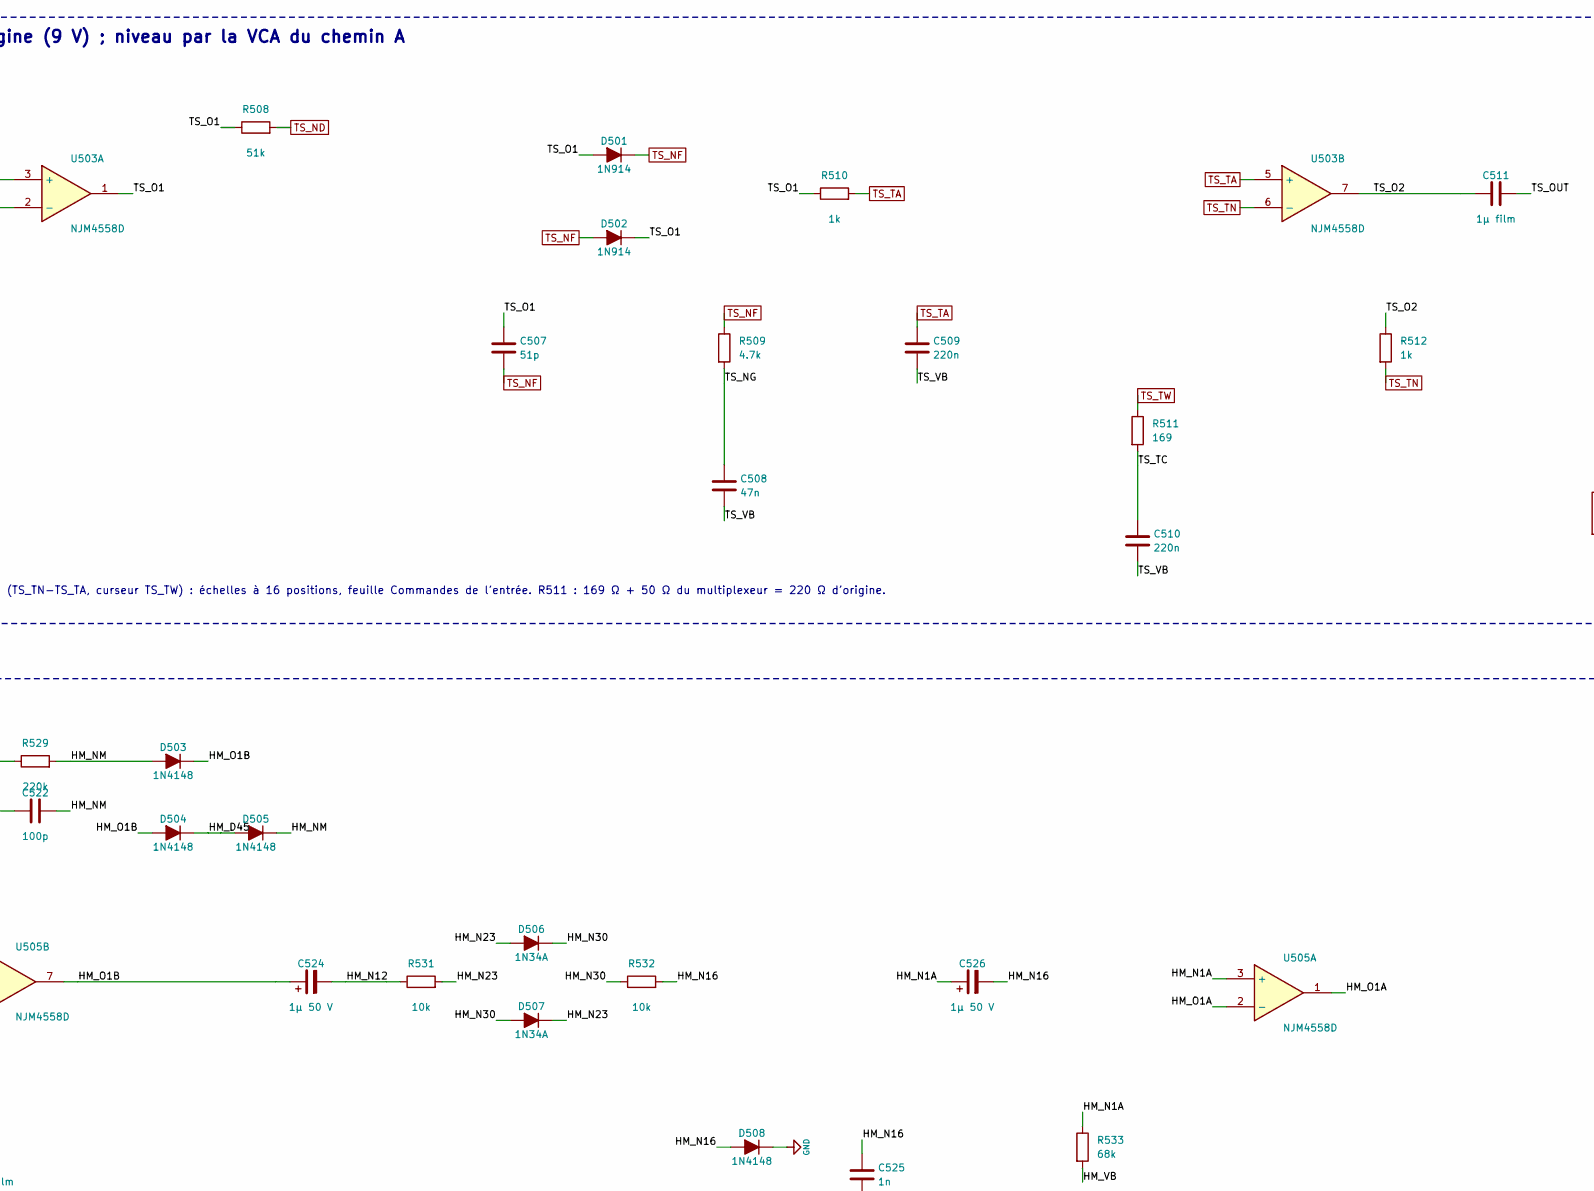
[picture p29: schematic boitier_entree.kicad_sch, part in row 1, column 2]

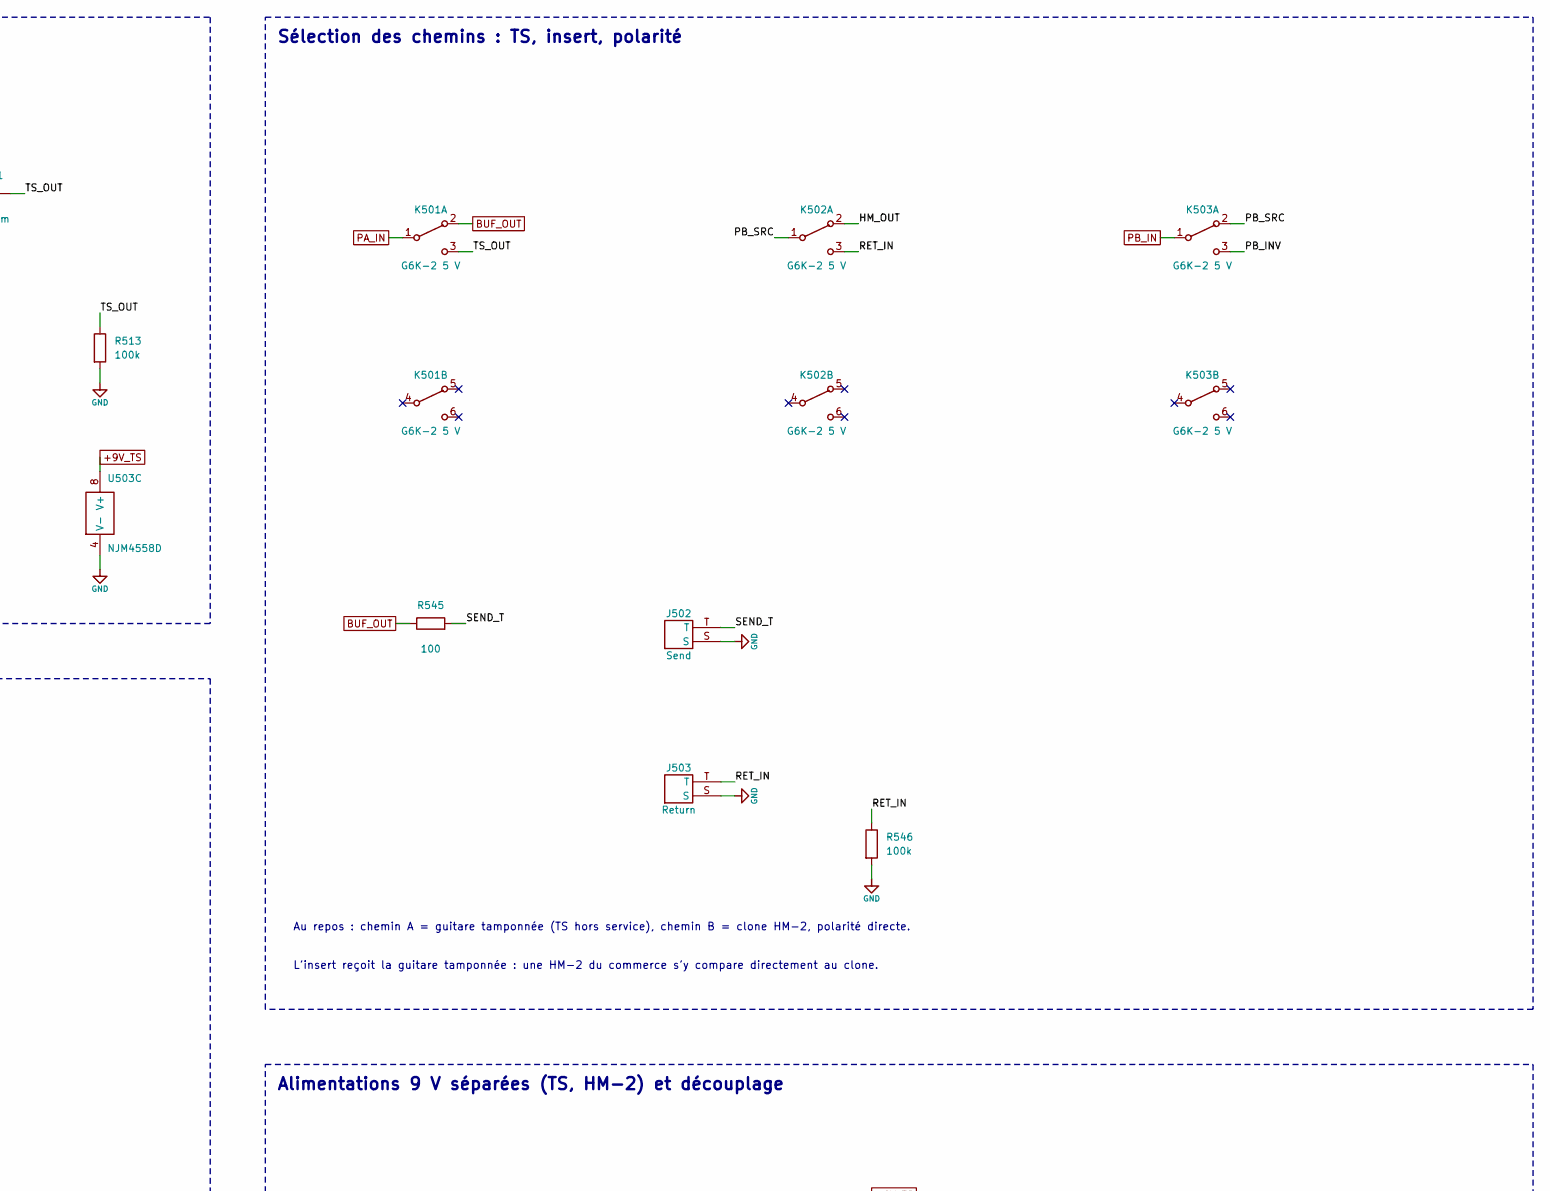
[picture p30: schematic boitier_entree.kicad_sch, part in row 1, column 3]

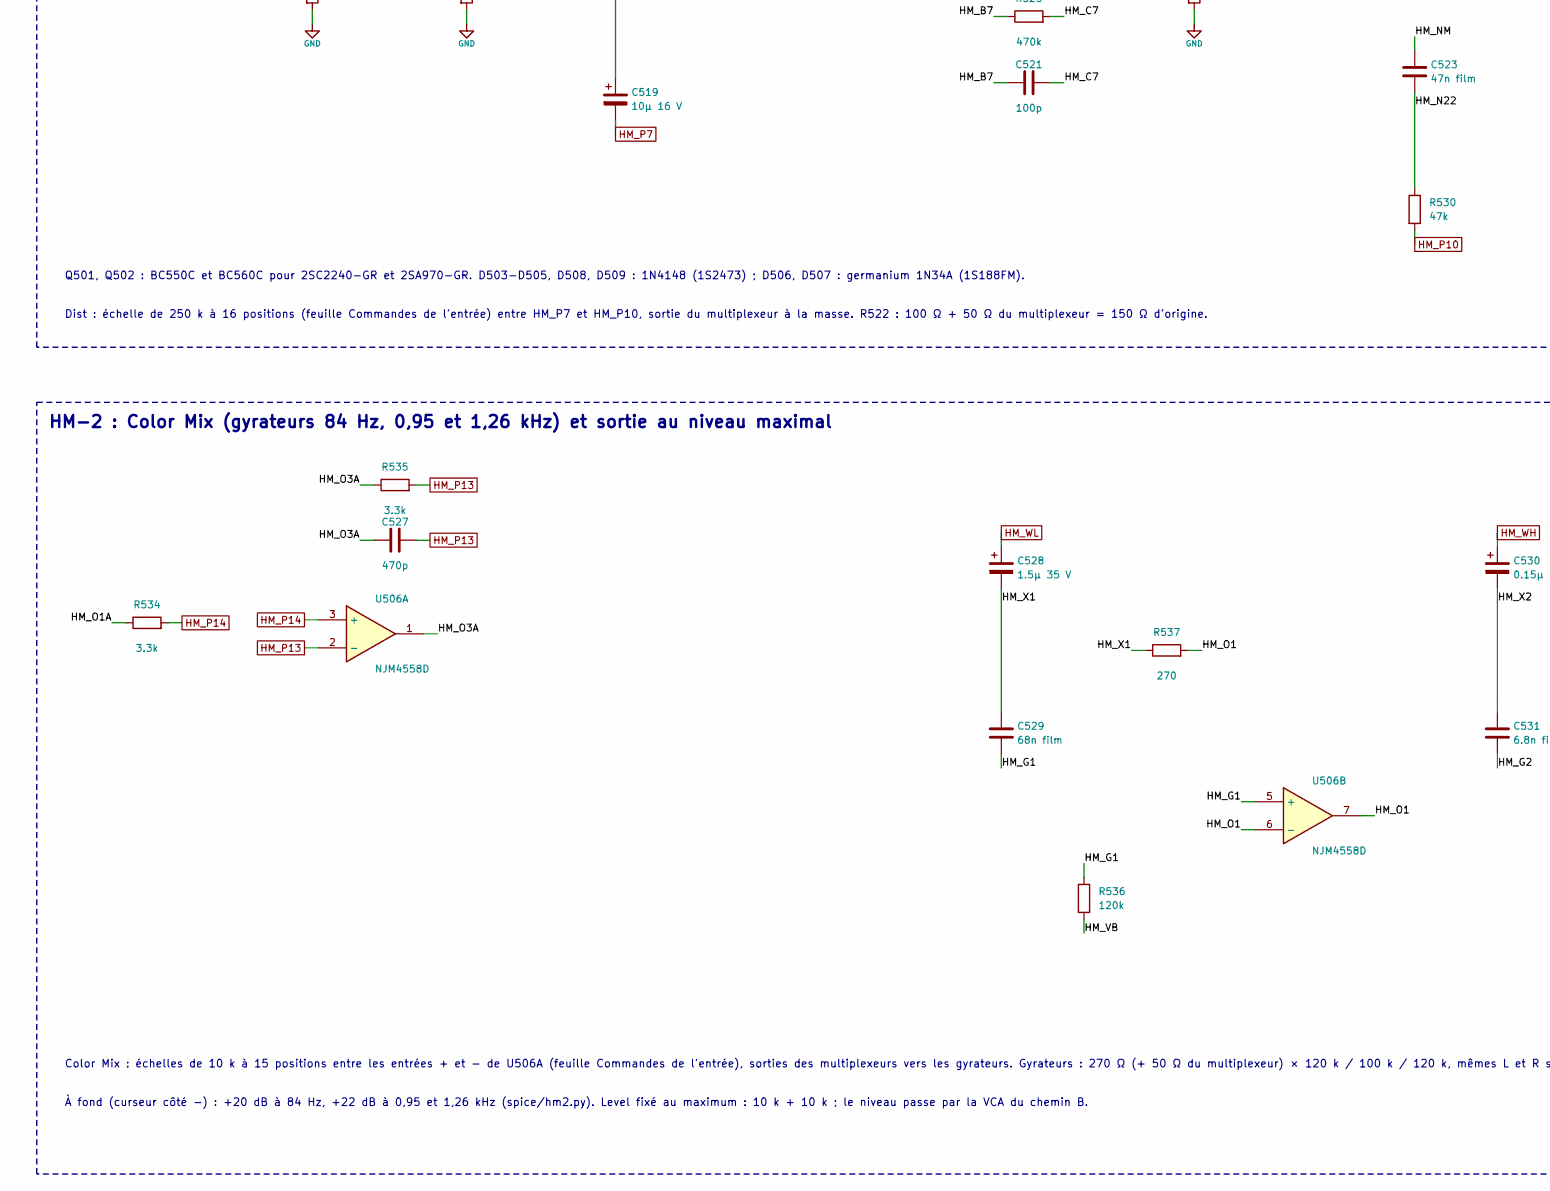
[picture p31: schematic boitier_entree.kicad_sch, part in row 2, column 1]

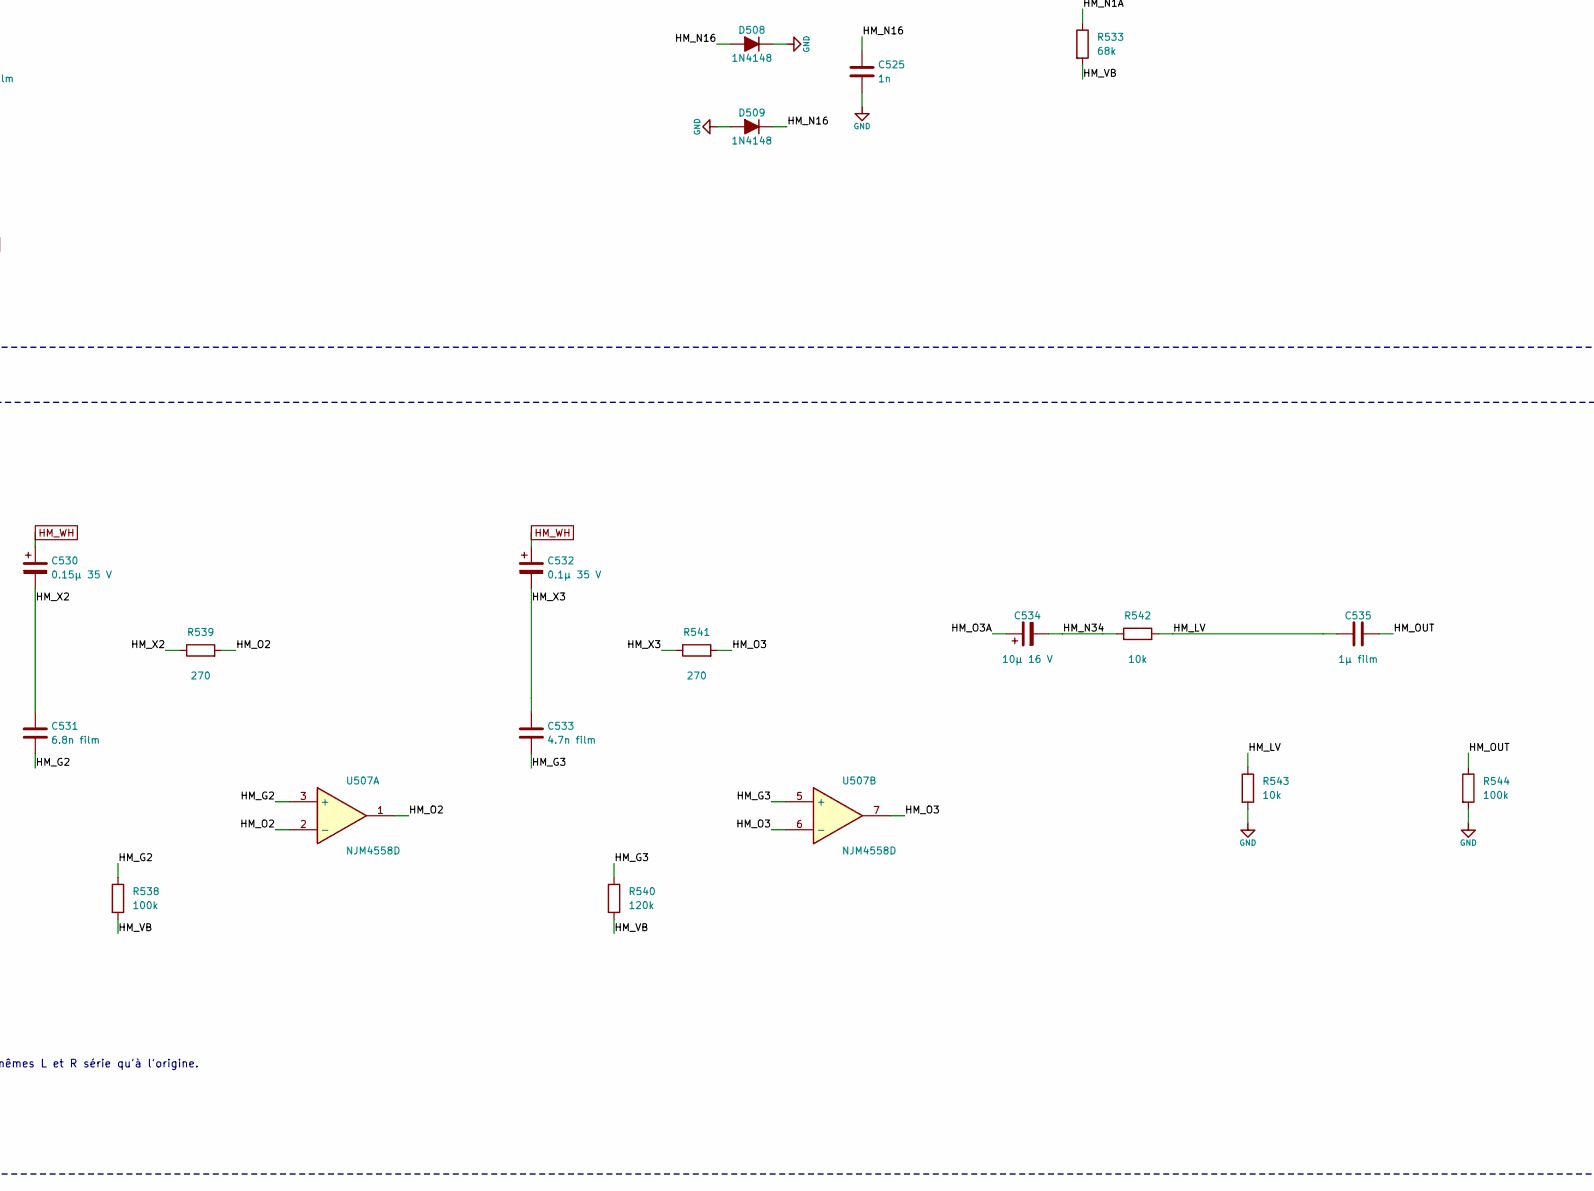
[picture p32: schematic boitier_entree.kicad_sch, part in row 2, column 2]

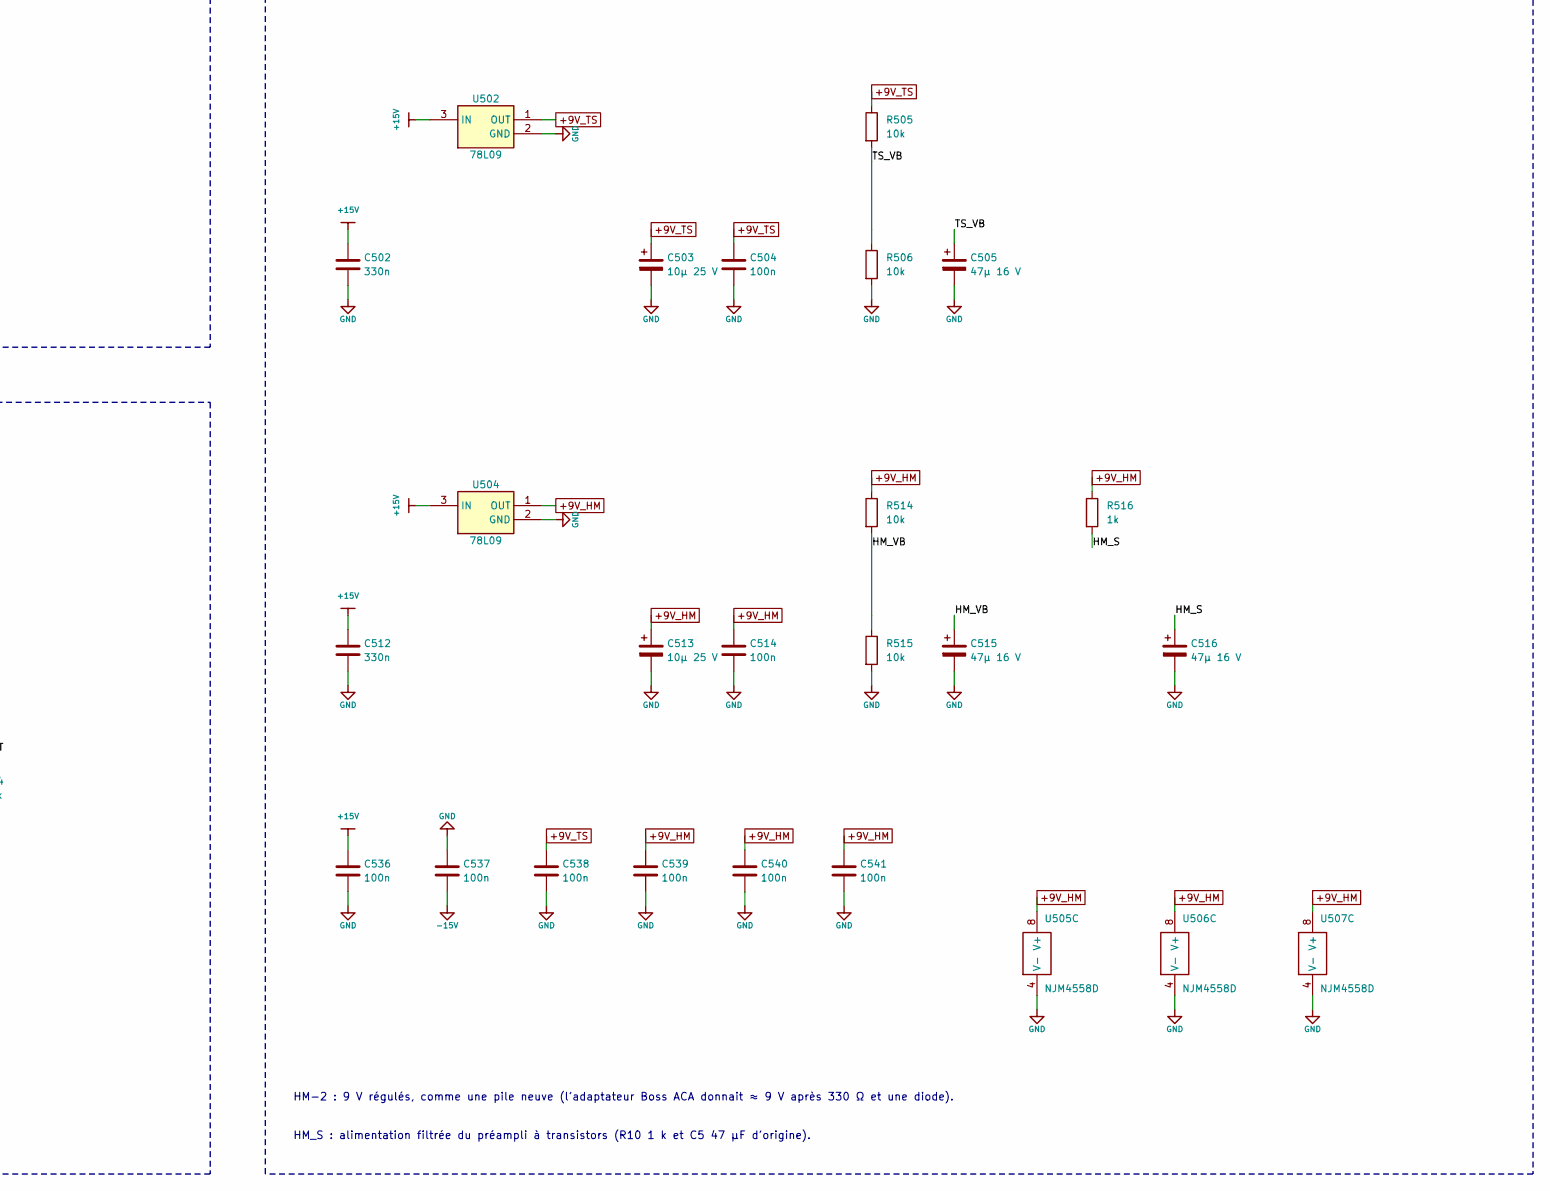
[picture p33: schematic boitier_entree.kicad_sch, part in row 2, column 3]

Parts:
C501, C518, C521, C522: 100p
C502, C512: 330n
C503, C513: 10µ 25 V
C504, C514, C536, C537, C538, C539, C540, C541: 100n
C505, C515, C516: 47µ 16 V
C506, C511, C535: 1µ film
C507: 51p
C508: 47n
C509, C510: 220n
C517, C520, C523: 47n film
C519, C534: 10µ 16 V
C524, C526: 1µ 50 V
C525: 1n
C527: 470p
C528: 1.5µ 35 V
C529: 68n film
C530: 0.15µ 35 V
C531: 6.8n film
C532: 0.1µ 35 V
C533: 4.7n film
D501, D502: 1N914
D503, D504, D505, D508, D509: 1N4148
D506, D507: 1N34A
J501: Entrée guitare
J502: Send
J503: Return
K501, K502, K503: G6K-2 5 V
Q501: BC550C
Q502: BC560C
R501, R510, R512, R516: 1k
R502: 1M
R503, R504, R505, R506, R507, R514, R515, R521, R527, R531, R532, R542, R543: 10k
R508: 51k
R509: 4.7k
R511: 169
R513, R518, R524, R538, R544, R546: 100k
R517, R523: 22k
R519, R525: 470k
R520: 22
R522, R545: 100
R526: 120
R528, R533: 68k
R529: 220k
R530: 47k
R534, R535: 3.3k
R536, R540: 120k
R537, R539, R541: 270
U501: OPA2134
U502, U504: 78L09
U503, U505, U506, U507: NJM4558D

Connections:
+9V_HM: C513.1 (+), C514.1, C539.1, C540.1, C541.1, R514.1, R516.1, R528.1, U504.1 (OUT), U505.8 (V+), U506.8 (V+), U507.8 (V+)
+9V_TS: C503.1 (+), C504.1, C538.1, R505.1, U502.1 (OUT), U503.8 (V+)
+15V: C502.1, C512.1, C536.1, U501.8 (V+), U502.3 (IN), U504.3 (IN)
-15V: C537.2, U501.4 (V-)
BUF_IN: C501.1, R501.2, R502.1, U501.3 (+)
BUF_OUT: C506.1, C517.1, K501.2 (NC), R545.1, U501.1, U501.2 (-)
GND: C501.2, C502.2, C503.2 (-), C504.2, C505.2 (-), C512.2, C513.2 (-), C514.2, C515.2 (-), C516.2 (-), C525.2, C536.2, C537.1, C538.2, C539.2, C540.2, C541.2, D508.2 (K), D509.1 (A), J501.S, J501.TN, J502.S, J503.S, R502.2, R506.2, R513.2, R515.2, R518.2, R520.2, R527.2, R543.2, R544.2, R546.2, U501.5 (+), U502.2 (GND), U503.4 (V-), U504.2 (GND), U505.4 (V-), U506.4 (V-), U507.4 (V-)
GTR_IN: J501.T, R501.1
HM_B6: C518.2, Q501.2 (B), R517.2, R518.1, R519.2
HM_B7: C521.1, Q502.2 (B), R523.2, R524.2, R525.1
HM_C6: C518.1, C520.1, Q501.1 (C), R519.1, R521.2, R522.1
HM_C7: C521.2, Q502.1 (C), R525.2, R527.1, R528.2, U505.5 (+)
HM_D45: D504.2 (K), D505.1 (A)
HM_E6: Q501.3 (E), R520.1
HM_E7: Q502.3 (E), R526.2
HM_G1: C529.2, R536.1, U506.5 (+)
HM_G2: C531.2, R538.1, U507.3 (+)
HM_G3: C533.2, R540.1, U507.5 (+)
HM_LV: C535.1, R542.2, R543.1
HM_N1A: C526.1 (+), R533.1, U505.3 (+)
HM_N6: C517.2, R517.1
HM_N11: C520.2, R523.1
HM_N12: C524.2 (-), R531.1
HM_N16: C525.1, C526.2 (-), D508.1 (A), D509.2 (K), R532.2
HM_N22: C523.2, R530.1
HM_N23: D506.1 (A), D507.2 (K), R531.2
HM_N30: D506.2 (K), D507.1 (A), R532.1
HM_N34: C534.2 (-), R542.1
HM_N49: C519.1 (+), R522.2
HM_NM: C522.2, C523.1, D503.1 (A), D505.2 (K), R529.2, U505.6 (-)
HM_O1: R537.2, U506.6 (-), U506.7
HM_O1A: R534.1, U505.1, U505.2 (-)
HM_O1B: C522.1, C524.1 (+), D503.2 (K), D504.1 (A), R529.1, U505.7
HM_O2: R539.2, U507.1, U507.2 (-)
HM_O3: R541.2, U507.6 (-), U507.7
HM_O3A: C527.1, C534.1 (+), R535.1, U506.1
HM_OUT: C535.2, K502.2 (NC), R544.1
HM_P7: C519.2 (-)
HM_P10: R530.2
HM_P13: C527.2, R535.2, U506.2 (-)
HM_P14: R534.2, U506.3 (+)
HM_S: C516.1 (+), R516.2, R521.1, R524.1, R526.1
HM_VB: C515.1 (+), R514.2, R515.1, R533.2, R536.2, R538.2, R540.2
HM_WH: C530.1 (+), C532.1 (+)
HM_WL: C528.1 (+)
HM_X1: C528.2 (-), C529.1, R537.1
HM_X2: C530.2 (-), C531.1, R539.1
HM_X3: C532.2 (-), C533.1, R541.1
PA_IN: K501.1 (C)
PB_IN: K503.1 (C)
PB_INV: K503.3 (NO), R504.1, U501.7
PB_INVN: R503.2, R504.2, U501.6 (-)
PB_SRC: K502.1 (C), K503.2 (NC), R503.1
RET_IN: J503.T, K502.3 (NO), R546.1
SEND_T: J502.T, R545.2
TS_ND: R508.2
TS_NF: C507.2, D501.2 (K), D502.1 (A), R509.1, U503.2 (-)
TS_NG: C508.1, R509.2
TS_O1: C507.1, D501.1 (A), D502.2 (K), R508.1, R510.1, U503.1
TS_O2: C511.1, R512.1, U503.7
TS_OUT: C511.2, K501.3 (NO), R513.1
TS_TA: C509.1, R510.2, U503.5 (+)
TS_TC: C510.1, R511.2
TS_TN: R512.2, U503.6 (-)
TS_TW: R511.1
TS_VB: C505.1 (+), C508.2, C509.2, C510.2, R505.2, R506.1, R507.2
TS_X1: C506.2, R507.1, U503.3 (+)

Notes on the sheet:
BUF_OUT attaque la TS, la HM-2, l'envoi d'insert et la détection du gate (feuille VCA).
Drive (TS_ND-TS_NF, 0 à 500 k) et tone (TS_TN-TS_TA, curseur TS_TW) : échelles à 16 positions, feuille Commandes de l'entrée. R511 : 169 Ω + 50 Ω du multiplexeur = 220 Ω d'origine.
Q501, Q502 : BC550C et BC560C pour 2SC2240-GR et 2SA970-GR. D503-D505, D508, D509 : 1N4148 (1S2473) ; D506, D507 : germanium 1N34A (1S188FM).
Dist : échelle de 250 k à 16 positions (feuille Commandes de l'entrée) entre HM_P7 et HM_P10, sortie du multiplexeur à la masse. R522 : 100 Ω + 50 Ω du multiplexeur = 150 Ω d'origine.
Color Mix : échelles de 10 k à 15 positions entre les entrées + et − de U506A (feuille Commandes de l'entrée), sorties des multiplexeurs vers les gyrateurs. Gyrateurs : 270 Ω (+ 50 Ω du multiplexeur) × 120 k / 100 k / 120 k, mêmes L et R série qu'à l'origine.
À fond (curseur côté −) : +20 dB à 84 Hz, +22 dB à 0,95 et 1,26 kHz (spice/hm2.py). Level fixé au maximum : 10 k + 10 k ; le niveau passe par la VCA du chemin B.
Au repos : chemin A = guitare tamponnée (TS hors service), chemin B = clone HM-2, polarité directe.
L'insert reçoit la guitare tamponnée : une HM-2 du commerce s'y compare directement au clone.
HM-2 : 9 V régulés, comme une pile neuve (l'adaptateur Boss ACA donnait ≈ 9 V après 330 Ω et une diode).
HM_S : alimentation filtrée du préampli à transistors (R10 1 k et C5 47 µF d'origine).
Entrée, buffer et inverseur de polarité du chemin B
Tube Screamer TS808 d'origine (9 V) ; niveau par la VCA du chemin A
HM-2 (schéma Boss MIJ) : préampli à transistors, écrêtage, zone morte germanium (9 V)
HM-2 : Color Mix (gyrateurs 84 Hz, 0,95 et 1,26 kHz) et sortie au niveau maximal
Sélection des chemins : TS, insert, polarité
Alimentations 9 V séparées (TS, HM-2) et découplage
