Arnwald/slo-pilote/kicad/slo-pilote/commandes.kicad_sch

## KiCad design kicad/slo-pilote/commandes.kicad_sch (2026-11-08)

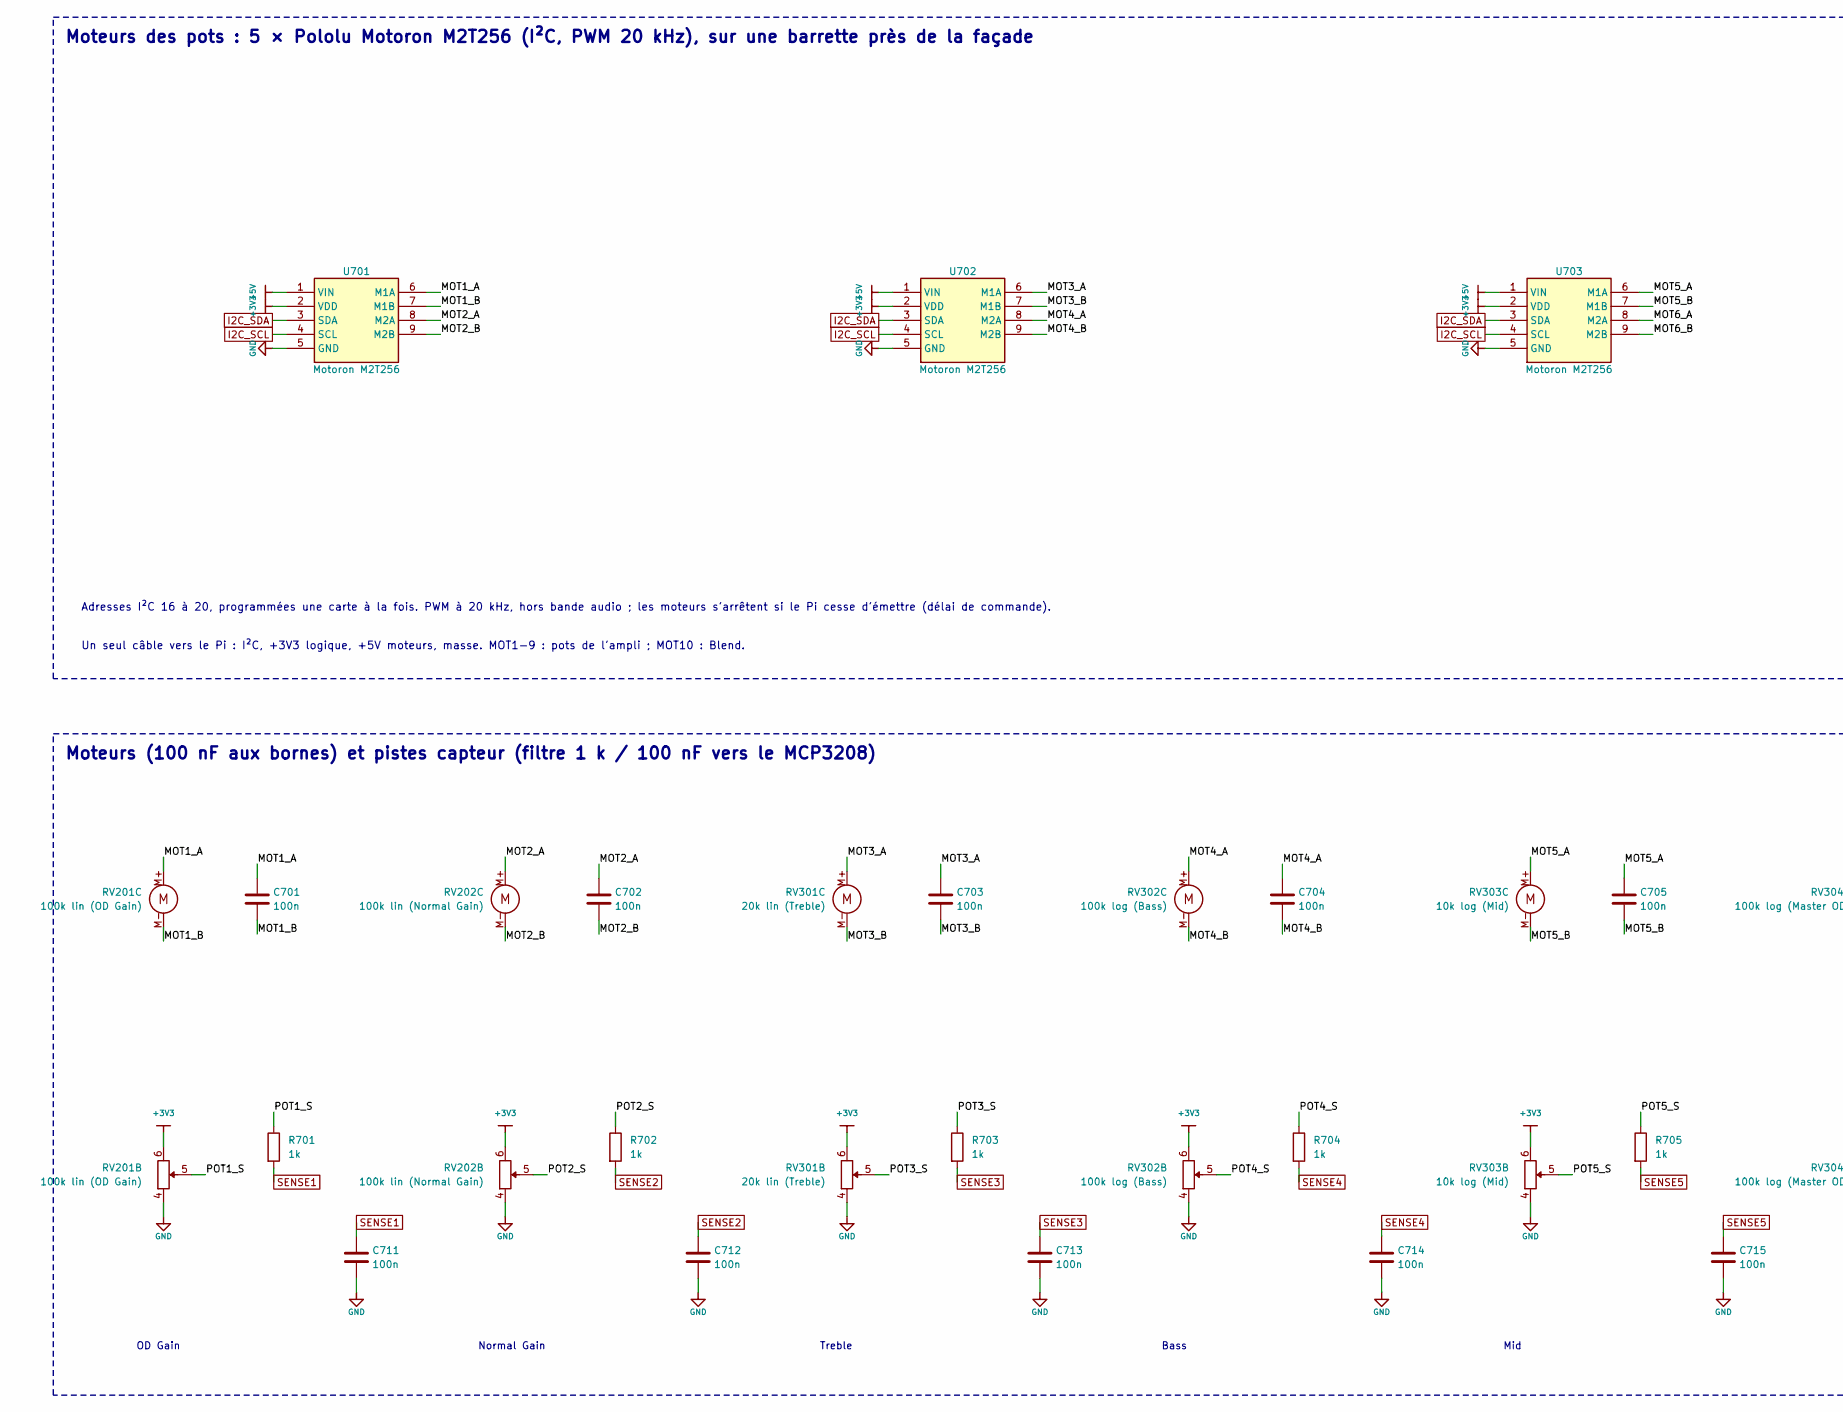
[picture p34: schematic commandes.kicad_sch, part in row 1, column 1]

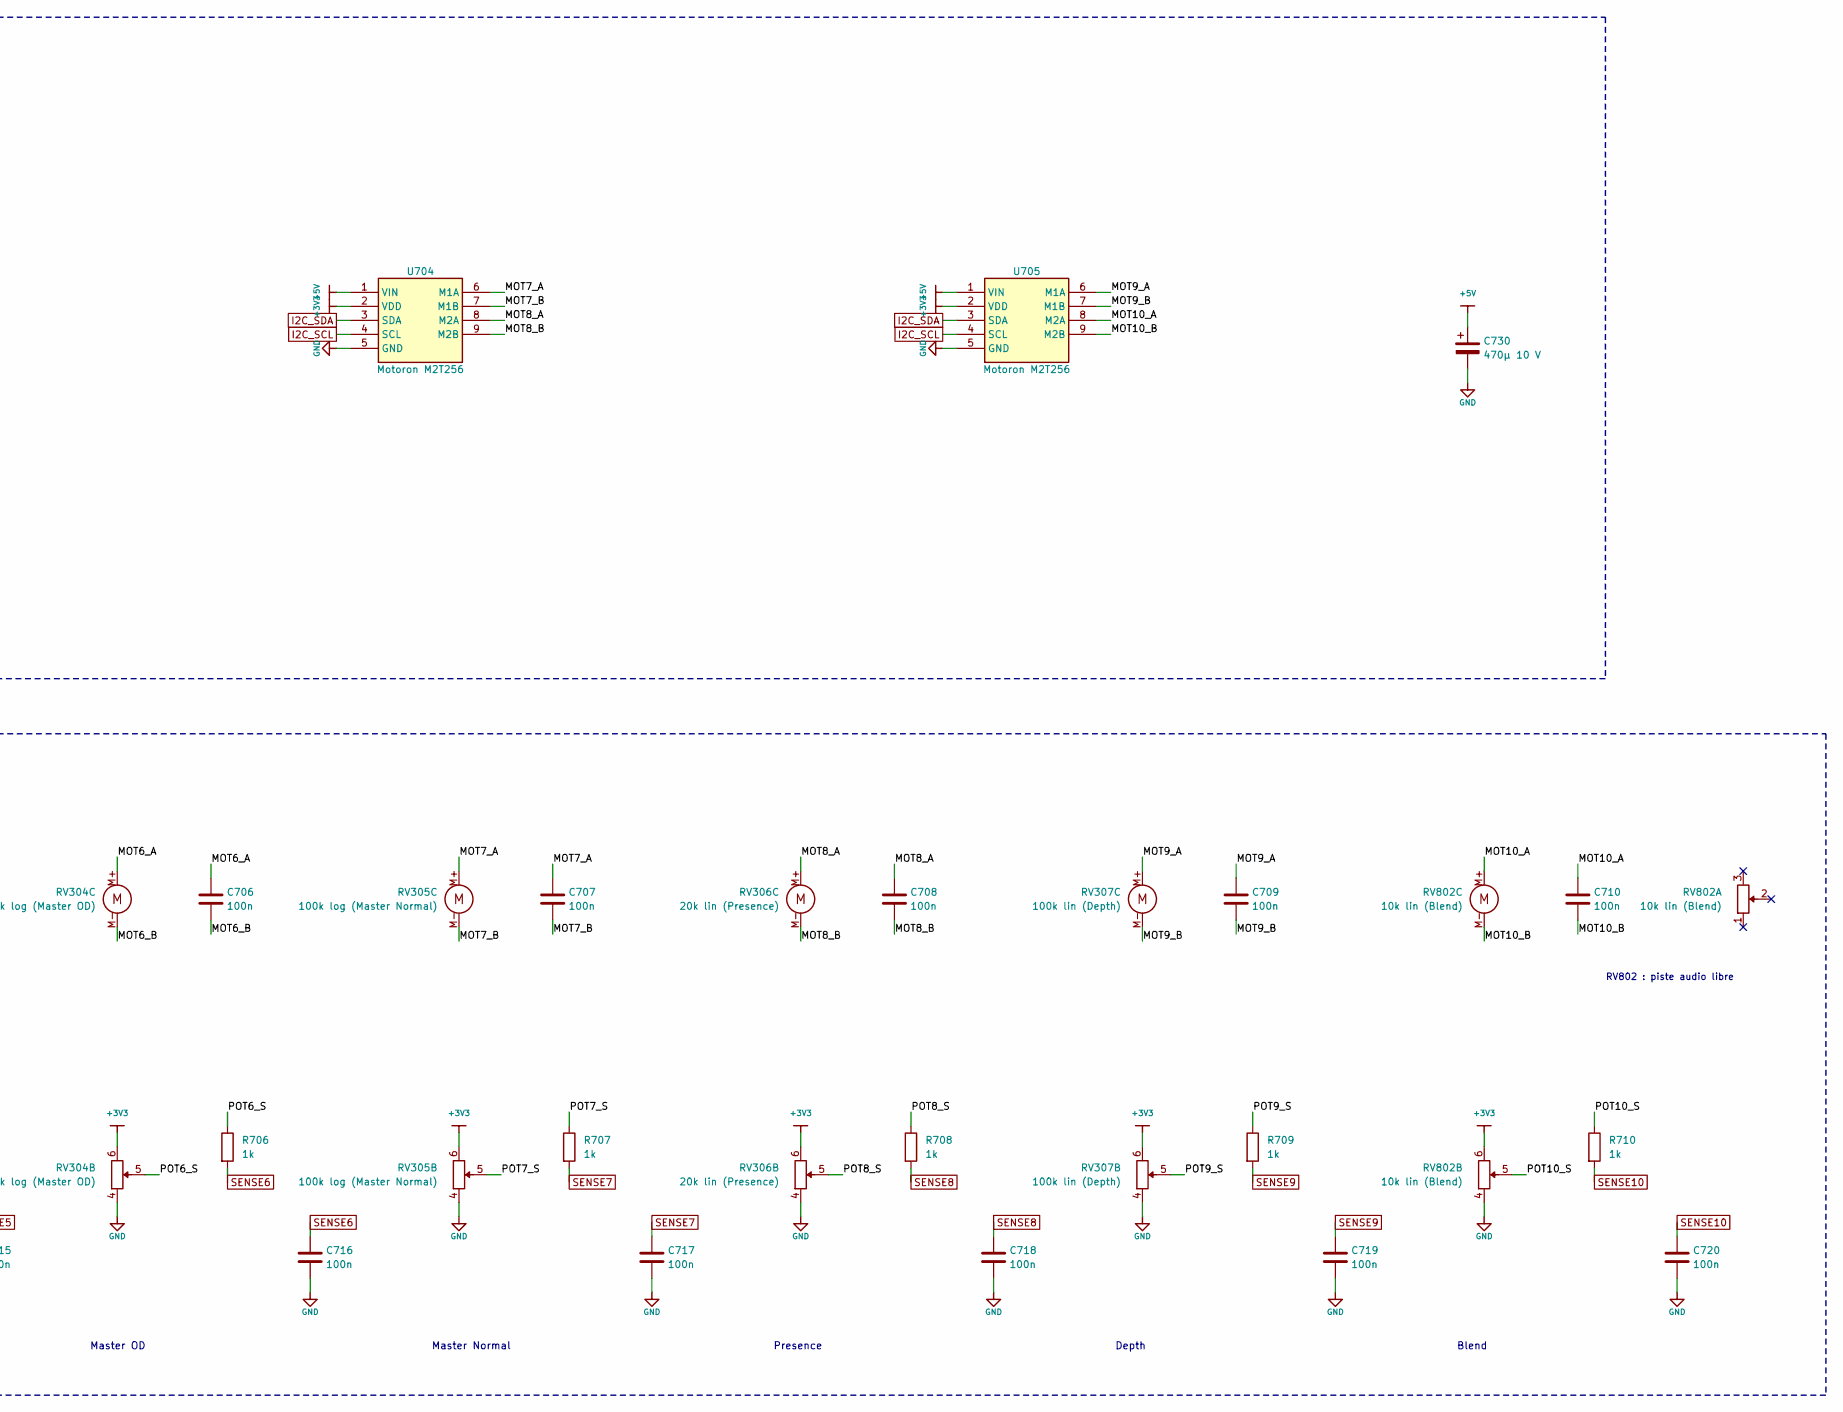
[picture p35: schematic commandes.kicad_sch, part in row 1, column 2]

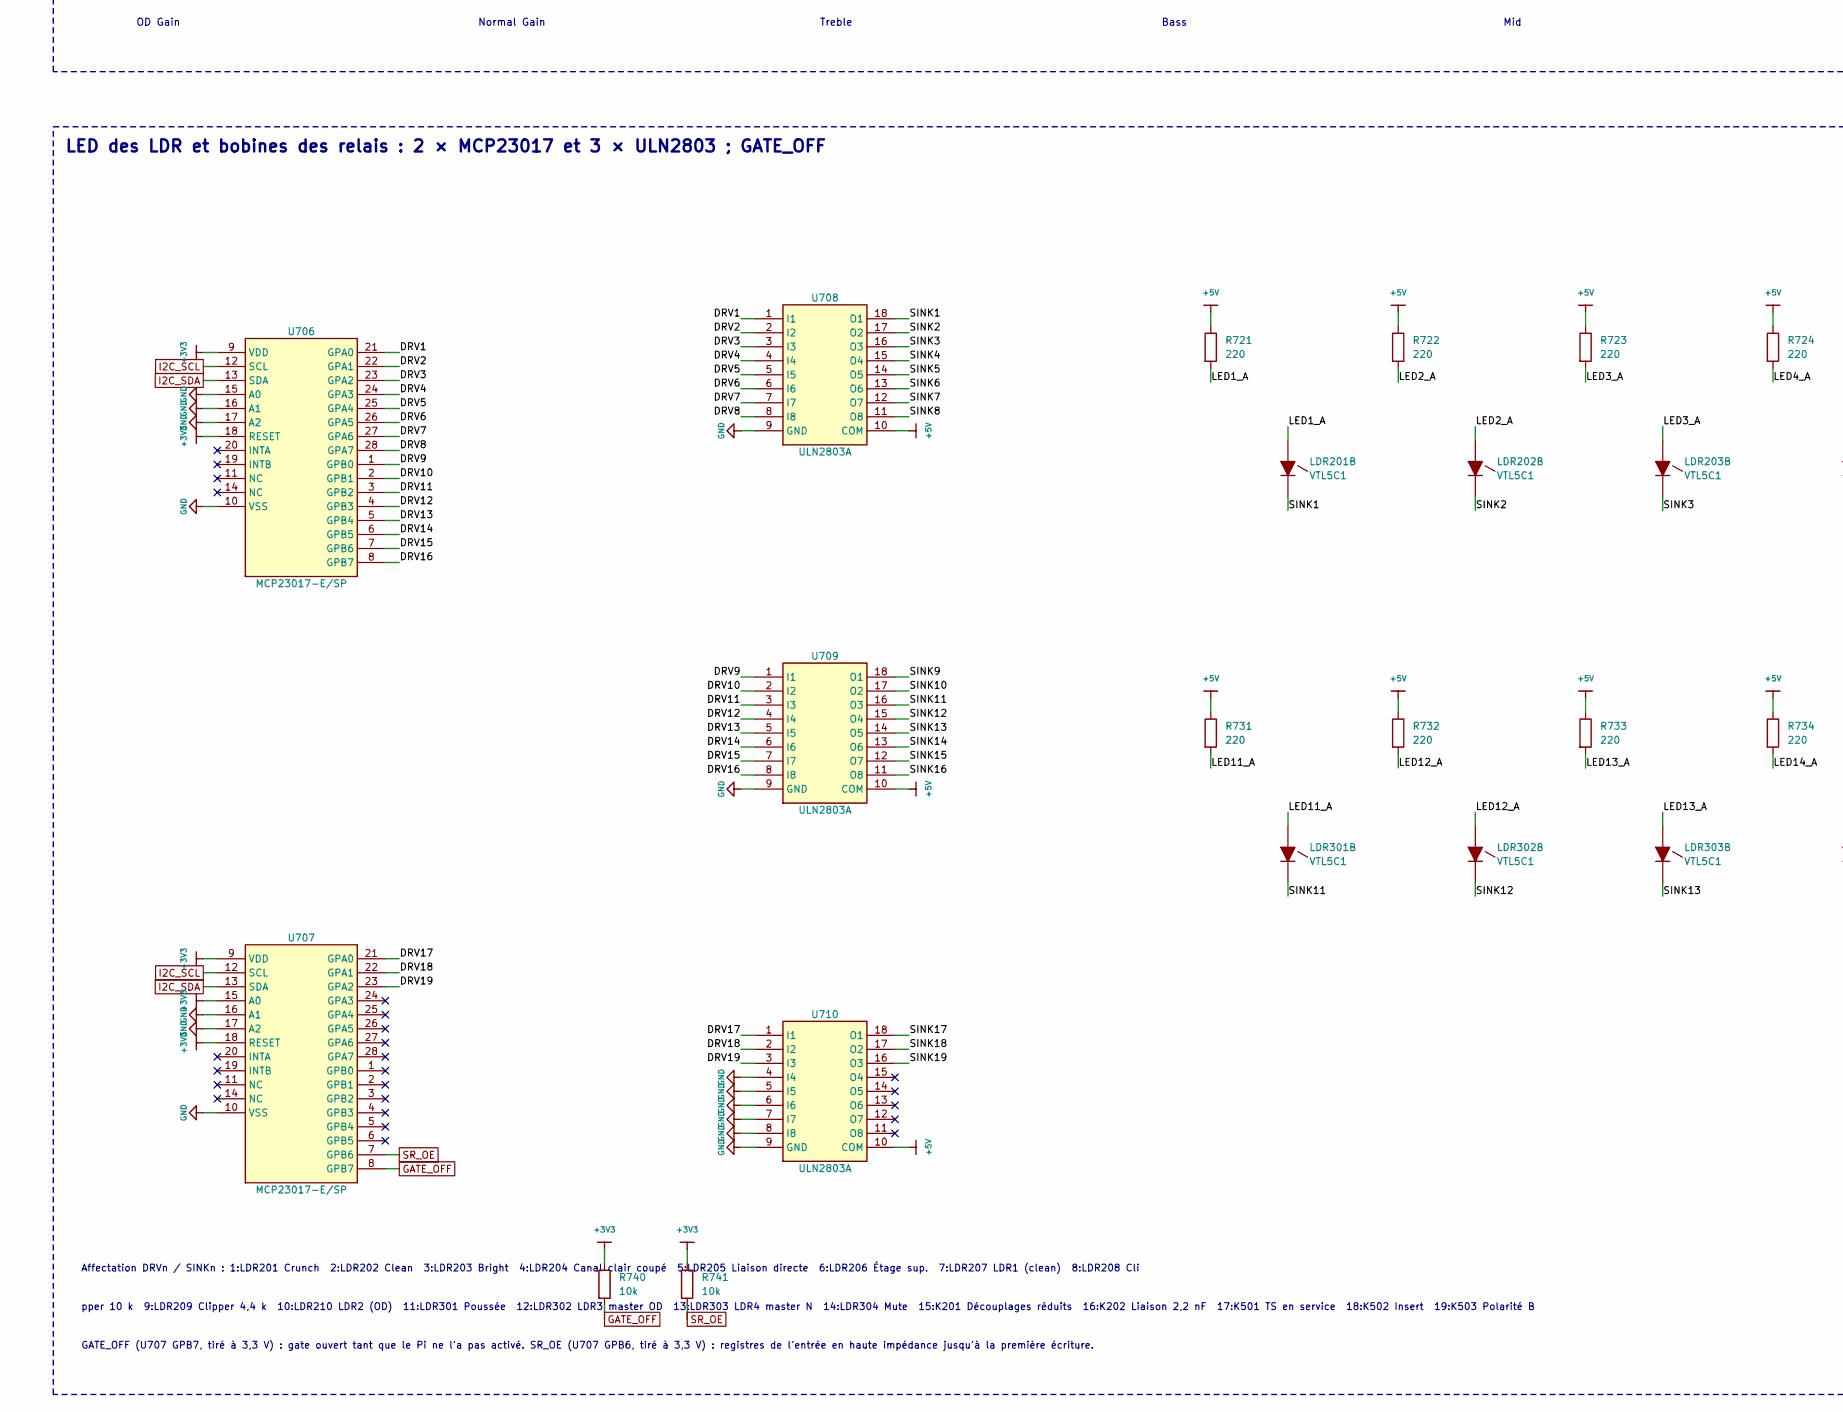
[picture p36: schematic commandes.kicad_sch, part in row 2, column 1]

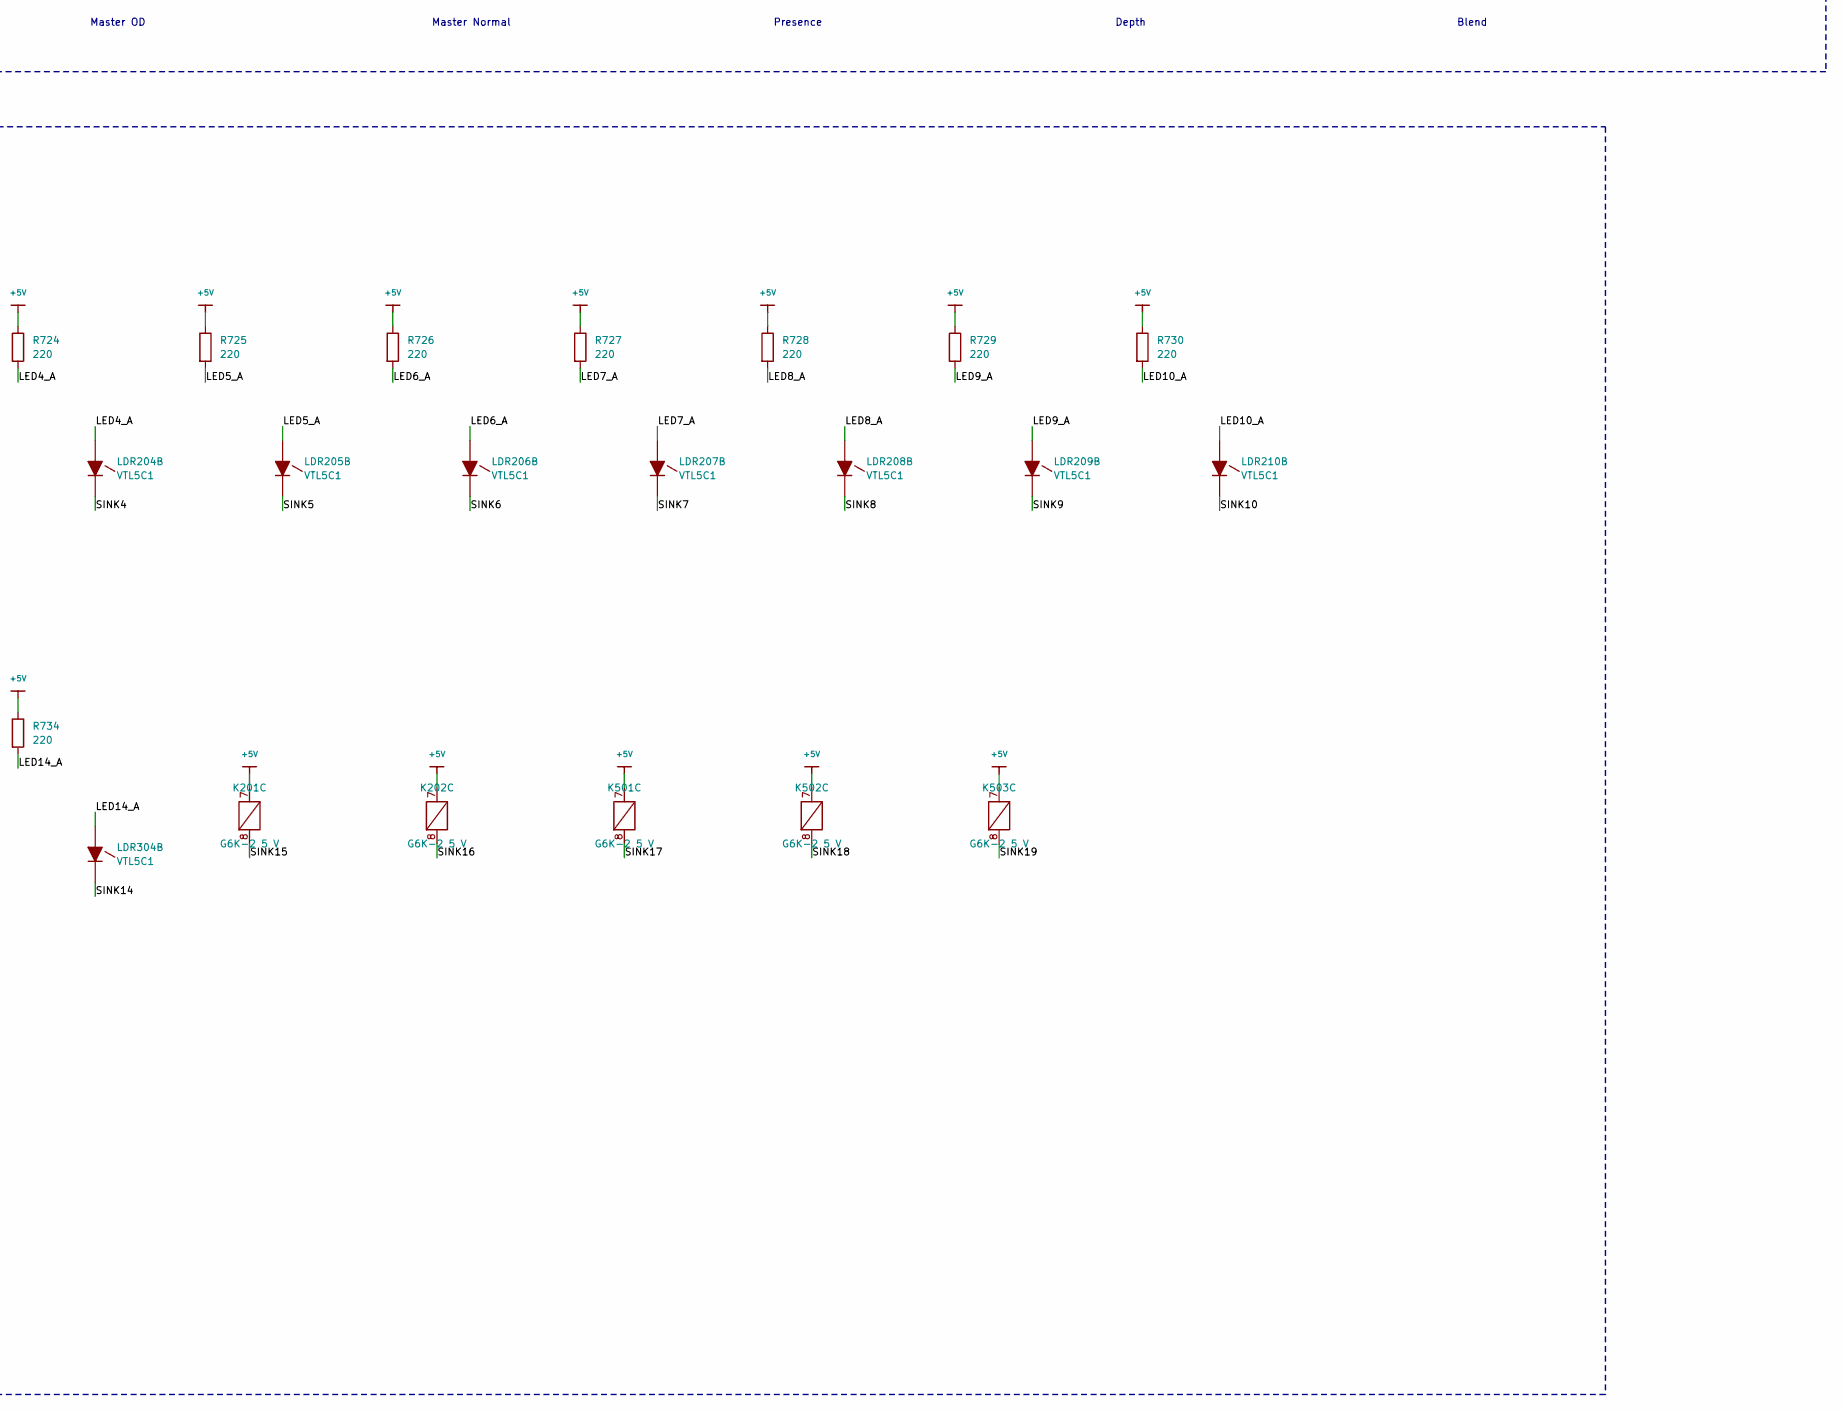
[picture p37: schematic commandes.kicad_sch, part in row 2, column 2]

Parts:
C701, C702, C703, C704, C705, C706, C707, C708, C709, C710, C711, C712, C713, C714, C715, C716, C717, C718, C719, C720: 100n
C730: 470µ 10 V
K201, K202, K501, K502, K503: G6K-2 5 V
LDR201, LDR202, LDR203, LDR204, LDR205, LDR206, LDR207, LDR208, LDR209, LDR210, LDR301, LDR302, LDR303, LDR304: VTL5C1
R701, R702, R703, R704, R705, R706, R707, R708, R709, R710: 1k
R721, R722, R723, R724, R725, R726, R727, R728, R729, R730, R731, R732, R733, R734: 220
R740, R741: 10k
RV201: 100k lin (OD Gain)
RV202: 100k lin (Normal Gain)
RV301: 20k lin (Treble)
RV302: 100k log (Bass)
RV303: 10k log (Mid)
RV304: 100k log (Master OD)
RV305: 100k log (Master Normal)
RV306: 20k lin (Presence)
RV307: 100k lin (Depth)
RV802: 10k lin (Blend)
U701, U702, U703, U704, U705: Motoron M2T256
U706, U707: MCP23017-E/SP
U708, U709, U710: ULN2803A

Connections:
+3V3: R740.1, R741.1, RV201.6 (3), RV202.6 (3), RV301.6 (3), RV302.6 (3), RV303.6 (3), RV304.6 (3), RV305.6 (3), RV306.6 (3), RV307.6 (3), RV802.6 (3), U701.2 (VDD), U702.2 (VDD), U703.2 (VDD), U704.2 (VDD), U705.2 (VDD), U706.9 (VDD), U706.18 (RESET), U707.9 (VDD), U707.15 (A0), U707.18 (RESET)
+5V: C730.1 (+), K201.7 (+), K202.7 (+), K501.7 (+), K502.7 (+), K503.7 (+), R721.1, R722.1, R723.1, R724.1, R725.1, R726.1, R727.1, R728.1, R729.1, R730.1, R731.1, R732.1, R733.1, R734.1, U701.1 (VIN), U702.1 (VIN), U703.1 (VIN), U704.1 (VIN), U705.1 (VIN), U708.10 (COM), U709.10 (COM), U710.10 (COM)
DRV1: U706.21 (GPA0), U708.1 (I1)
DRV2: U706.22 (GPA1), U708.2 (I2)
DRV3: U706.23 (GPA2), U708.3 (I3)
DRV4: U706.24 (GPA3), U708.4 (I4)
DRV5: U706.25 (GPA4), U708.5 (I5)
DRV6: U706.26 (GPA5), U708.6 (I6)
DRV7: U706.27 (GPA6), U708.7 (I7)
DRV8: U706.28 (GPA7), U708.8 (I8)
DRV9: U706.1 (GPB0), U709.1 (I1)
DRV10: U706.2 (GPB1), U709.2 (I2)
DRV11: U706.3 (GPB2), U709.3 (I3)
DRV12: U706.4 (GPB3), U709.4 (I4)
DRV13: U706.5 (GPB4), U709.5 (I5)
DRV14: U706.6 (GPB5), U709.6 (I6)
DRV15: U706.7 (GPB6), U709.7 (I7)
DRV16: U706.8 (GPB7), U709.8 (I8)
DRV17: U707.21 (GPA0), U710.1 (I1)
DRV18: U707.22 (GPA1), U710.2 (I2)
DRV19: U707.23 (GPA2), U710.3 (I3)
GATE_OFF: R740.2, U707.8 (GPB7)
GND: C711.2, C712.2, C713.2, C714.2, C715.2, C716.2, C717.2, C718.2, C719.2, C720.2, C730.2 (-), RV201.4 (1), RV202.4 (1), RV301.4 (1), RV302.4 (1), RV303.4 (1), RV304.4 (1), RV305.4 (1), RV306.4 (1), RV307.4 (1), RV802.4 (1), U701.5 (GND), U702.5 (GND), U703.5 (GND), U704.5 (GND), U705.5 (GND), U706.10 (VSS), U706.15 (A0), U706.16 (A1), U706.17 (A2), U707.10 (VSS), U707.16 (A1), U707.17 (A2), U708.9 (GND), U709.9 (GND), U710.4 (I4), U710.5 (I5), U710.6 (I6), U710.7 (I7), U710.8 (I8), U710.9 (GND)
I2C_SCL: U701.4 (SCL), U702.4 (SCL), U703.4 (SCL), U704.4 (SCL), U705.4 (SCL), U706.12 (SCL), U707.12 (SCL)
I2C_SDA: U701.3 (SDA), U702.3 (SDA), U703.3 (SDA), U704.3 (SDA), U705.3 (SDA), U706.13 (SDA), U707.13 (SDA)
LED1_A: LDR201.1 (A), R721.2
LED2_A: LDR202.1 (A), R722.2
LED3_A: LDR203.1 (A), R723.2
LED4_A: LDR204.1 (A), R724.2
LED5_A: LDR205.1 (A), R725.2
LED6_A: LDR206.1 (A), R726.2
LED7_A: LDR207.1 (A), R727.2
LED8_A: LDR208.1 (A), R728.2
LED9_A: LDR209.1 (A), R729.2
LED10_A: LDR210.1 (A), R730.2
LED11_A: LDR301.1 (A), R731.2
LED12_A: LDR302.1 (A), R732.2
LED13_A: LDR303.1 (A), R733.2
LED14_A: LDR304.1 (A), R734.2
MOT1_A: C701.1, RV201.M+, U701.6 (M1A)
MOT1_B: C701.2, RV201.M-, U701.7 (M1B)
MOT2_A: C702.1, RV202.M+, U701.8 (M2A)
MOT2_B: C702.2, RV202.M-, U701.9 (M2B)
MOT3_A: C703.1, RV301.M+, U702.6 (M1A)
MOT3_B: C703.2, RV301.M-, U702.7 (M1B)
MOT4_A: C704.1, RV302.M+, U702.8 (M2A)
MOT4_B: C704.2, RV302.M-, U702.9 (M2B)
MOT5_A: C705.1, RV303.M+, U703.6 (M1A)
MOT5_B: C705.2, RV303.M-, U703.7 (M1B)
MOT6_A: C706.1, RV304.M+, U703.8 (M2A)
MOT6_B: C706.2, RV304.M-, U703.9 (M2B)
MOT7_A: C707.1, RV305.M+, U704.6 (M1A)
MOT7_B: C707.2, RV305.M-, U704.7 (M1B)
MOT8_A: C708.1, RV306.M+, U704.8 (M2A)
MOT8_B: C708.2, RV306.M-, U704.9 (M2B)
MOT9_A: C709.1, RV307.M+, U705.6 (M1A)
MOT9_B: C709.2, RV307.M-, U705.7 (M1B)
MOT10_A: C710.1, RV802.M+, U705.8 (M2A)
MOT10_B: C710.2, RV802.M-, U705.9 (M2B)
POT1_S: R701.1, RV201.5 (W)
POT2_S: R702.1, RV202.5 (W)
POT3_S: R703.1, RV301.5 (W)
POT4_S: R704.1, RV302.5 (W)
POT5_S: R705.1, RV303.5 (W)
POT6_S: R706.1, RV304.5 (W)
POT7_S: R707.1, RV305.5 (W)
POT8_S: R708.1, RV306.5 (W)
POT9_S: R709.1, RV307.5 (W)
POT10_S: R710.1, RV802.5 (W)
SENSE1: C711.1, R701.2
SENSE2: C712.1, R702.2
SENSE3: C713.1, R703.2
SENSE4: C714.1, R704.2
SENSE5: C715.1, R705.2
SENSE6: C716.1, R706.2
SENSE7: C717.1, R707.2
SENSE8: C718.1, R708.2
SENSE9: C719.1, R709.2
SENSE10: C720.1, R710.2
SINK1: LDR201.2 (K), U708.18 (O1)
SINK2: LDR202.2 (K), U708.17 (O2)
SINK3: LDR203.2 (K), U708.16 (O3)
SINK4: LDR204.2 (K), U708.15 (O4)
SINK5: LDR205.2 (K), U708.14 (O5)
SINK6: LDR206.2 (K), U708.13 (O6)
SINK7: LDR207.2 (K), U708.12 (O7)
SINK8: LDR208.2 (K), U708.11 (O8)
SINK9: LDR209.2 (K), U709.18 (O1)
SINK10: LDR210.2 (K), U709.17 (O2)
SINK11: LDR301.2 (K), U709.16 (O3)
SINK12: LDR302.2 (K), U709.15 (O4)
SINK13: LDR303.2 (K), U709.14 (O5)
SINK14: LDR304.2 (K), U709.13 (O6)
SINK15: K201.8 (-), U709.12 (O7)
SINK16: K202.8 (-), U709.11 (O8)
SINK17: K501.8 (-), U710.18 (O1)
SINK18: K502.8 (-), U710.17 (O2)
SINK19: K503.8 (-), U710.16 (O3)
SR_OE: R741.2, U707.7 (GPB6)

Notes on the sheet:
Adresses I²C 16 à 20, programmées une carte à la fois. PWM à 20 kHz, hors bande audio ; les moteurs s'arrêtent si le Pi cesse d'émettre (délai de commande).
Un seul câble vers le Pi : I²C, +3V3 logique, +5V moteurs, masse. MOT1-9 : pots de l'ampli ; MOT10 : Blend.
OD Gain
Normal Gain
Treble
Bass
Mid
Master OD
Master Normal
Presence
Depth
Blend
RV802 : piste audio libre
Affectation DRVn / SINKn : 1:LDR201 Crunch 2:LDR202 Clean 3:LDR203 Bright 4:LDR204 Canal clair coupé 5:LDR205 Liaison directe 6:LDR206 Étage sup. 7:LDR207 LDR1 (clean) 8:LDR208 Cli
pper 10 k 9:LDR209 Clipper 4,4 k 10:LDR210 LDR2 (OD) 11:LDR301 Poussée 12:LDR302 LDR3 master OD 13:LDR303 LDR4 master N 14:LDR304 Mute 15:K201 Découplages réduits 16:K202 Liaison 2,2 nF 17:K501 TS en service 18:K502 Insert 19:K503 Polarité B
GATE_OFF (U707 GPB7, tiré à 3,3 V) : gate ouvert tant que le Pi ne l'a pas activé. SR_OE (U707 GPB6, tiré à 3,3 V) : registres de l'entrée en haute impédance jusqu'à la première écriture.
Moteurs des pots : 5 × Pololu Motoron M2T256 (I²C, PWM 20 kHz), sur une barrette près de la façade
Moteurs (100 nF aux bornes) et pistes capteur (filtre 1 k / 100 nF vers le MCP3208)
LED des LDR et bobines des relais : 2 × MCP23017 et 3 × ULN2803 ; GATE_OFF
