Arnwald/slo-pilote/kicad/slo-pilote/commandes_entree.kicad_sch

## KiCad design kicad/slo-pilote/commandes_entree.kicad_sch (2026-11-08)

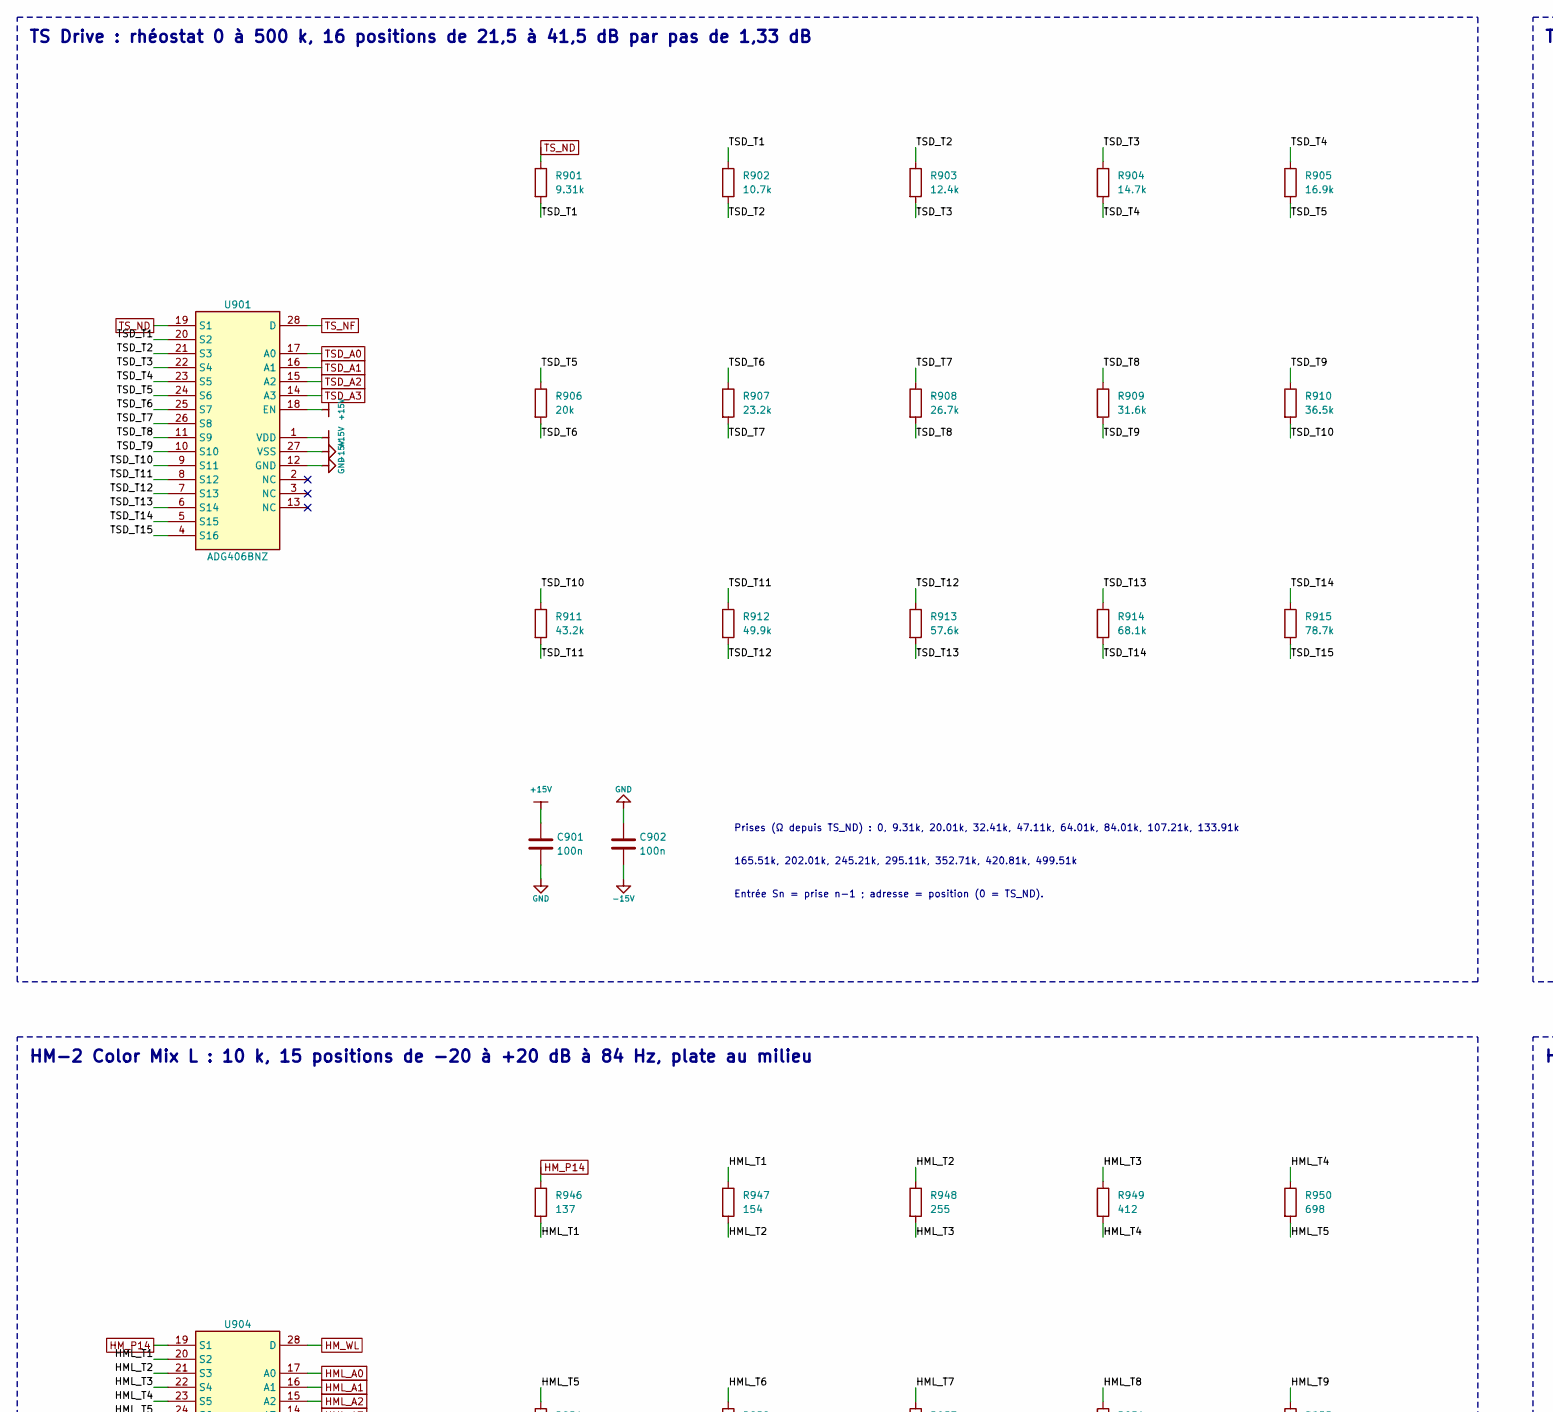
[picture p38: schematic commandes_entree.kicad_sch, part in row 1, column 1]

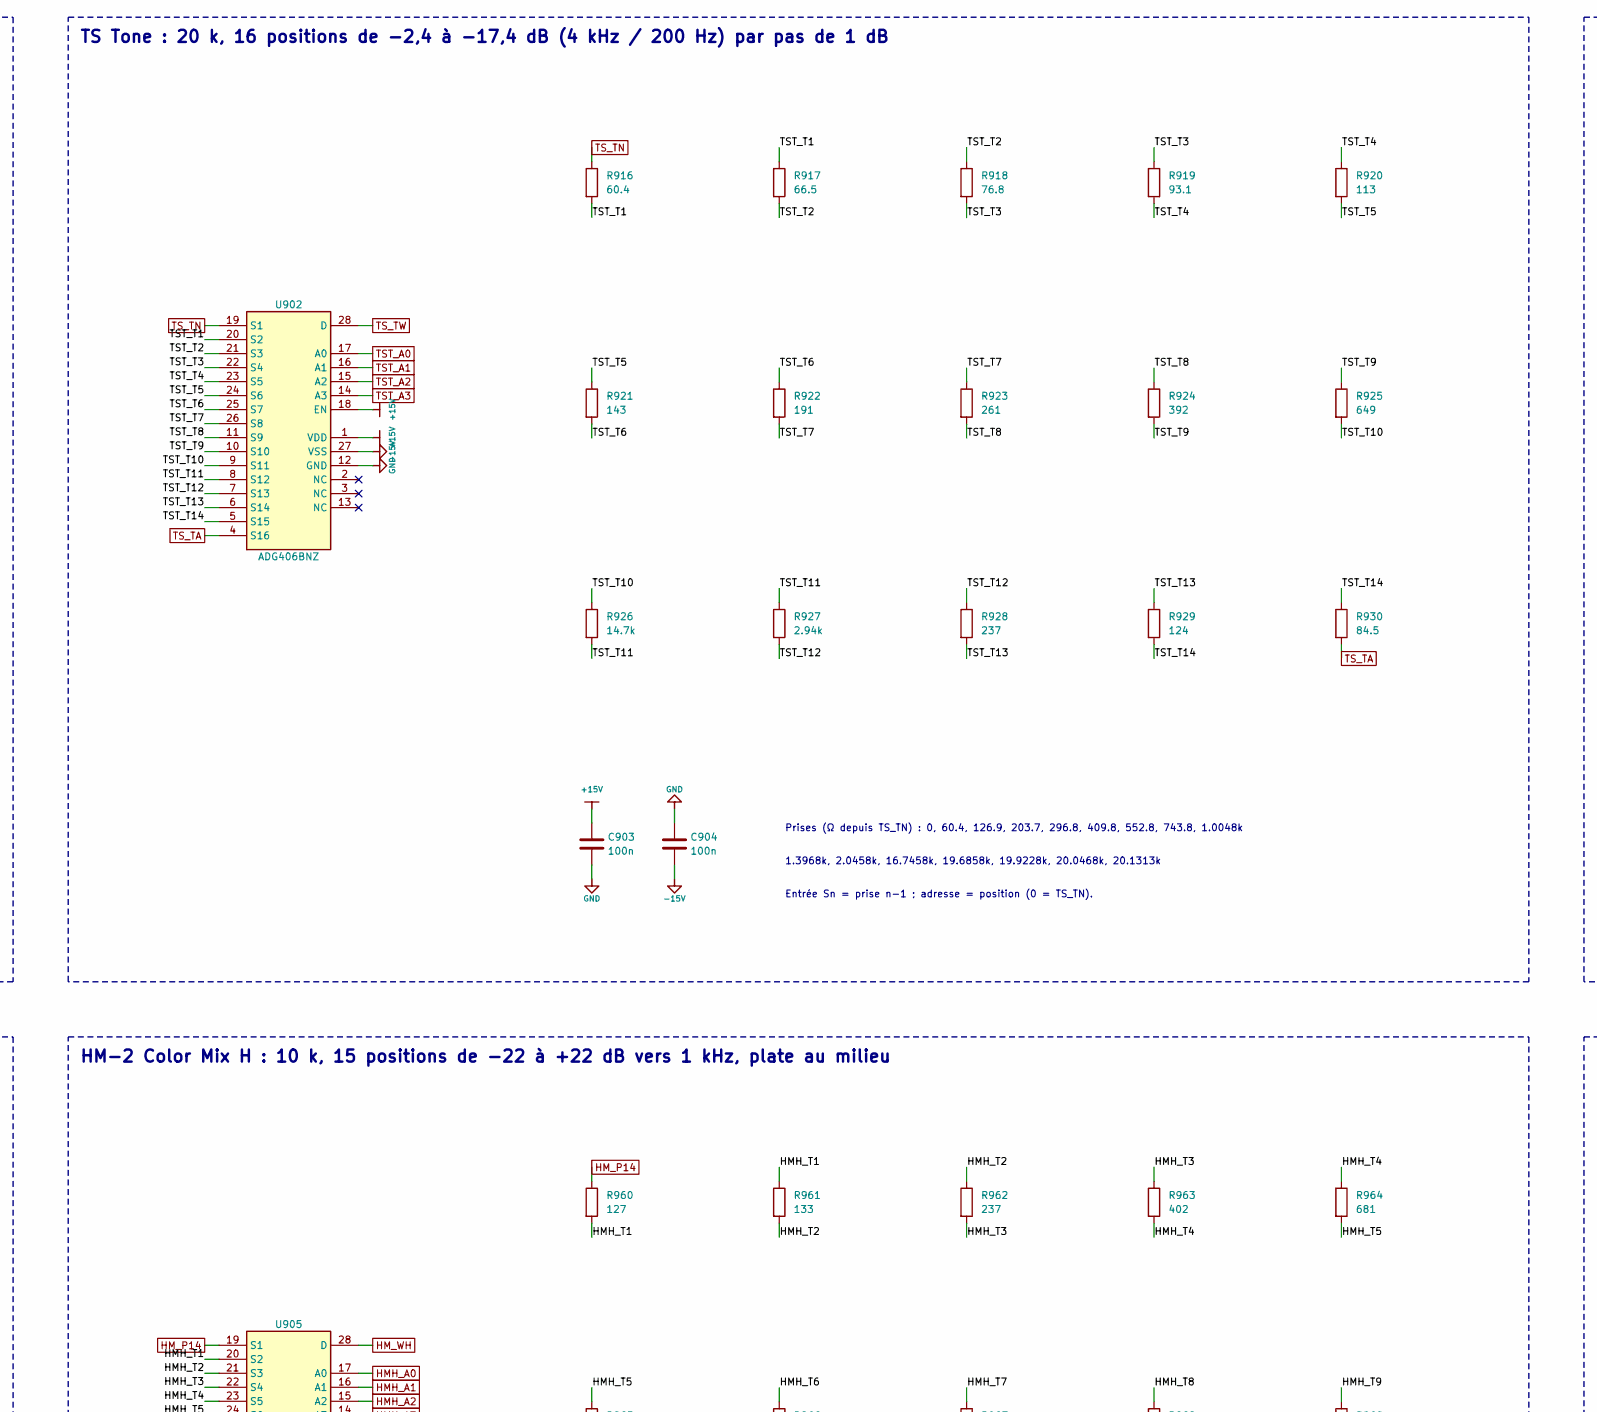
[picture p39: schematic commandes_entree.kicad_sch, part in row 1, column 2]

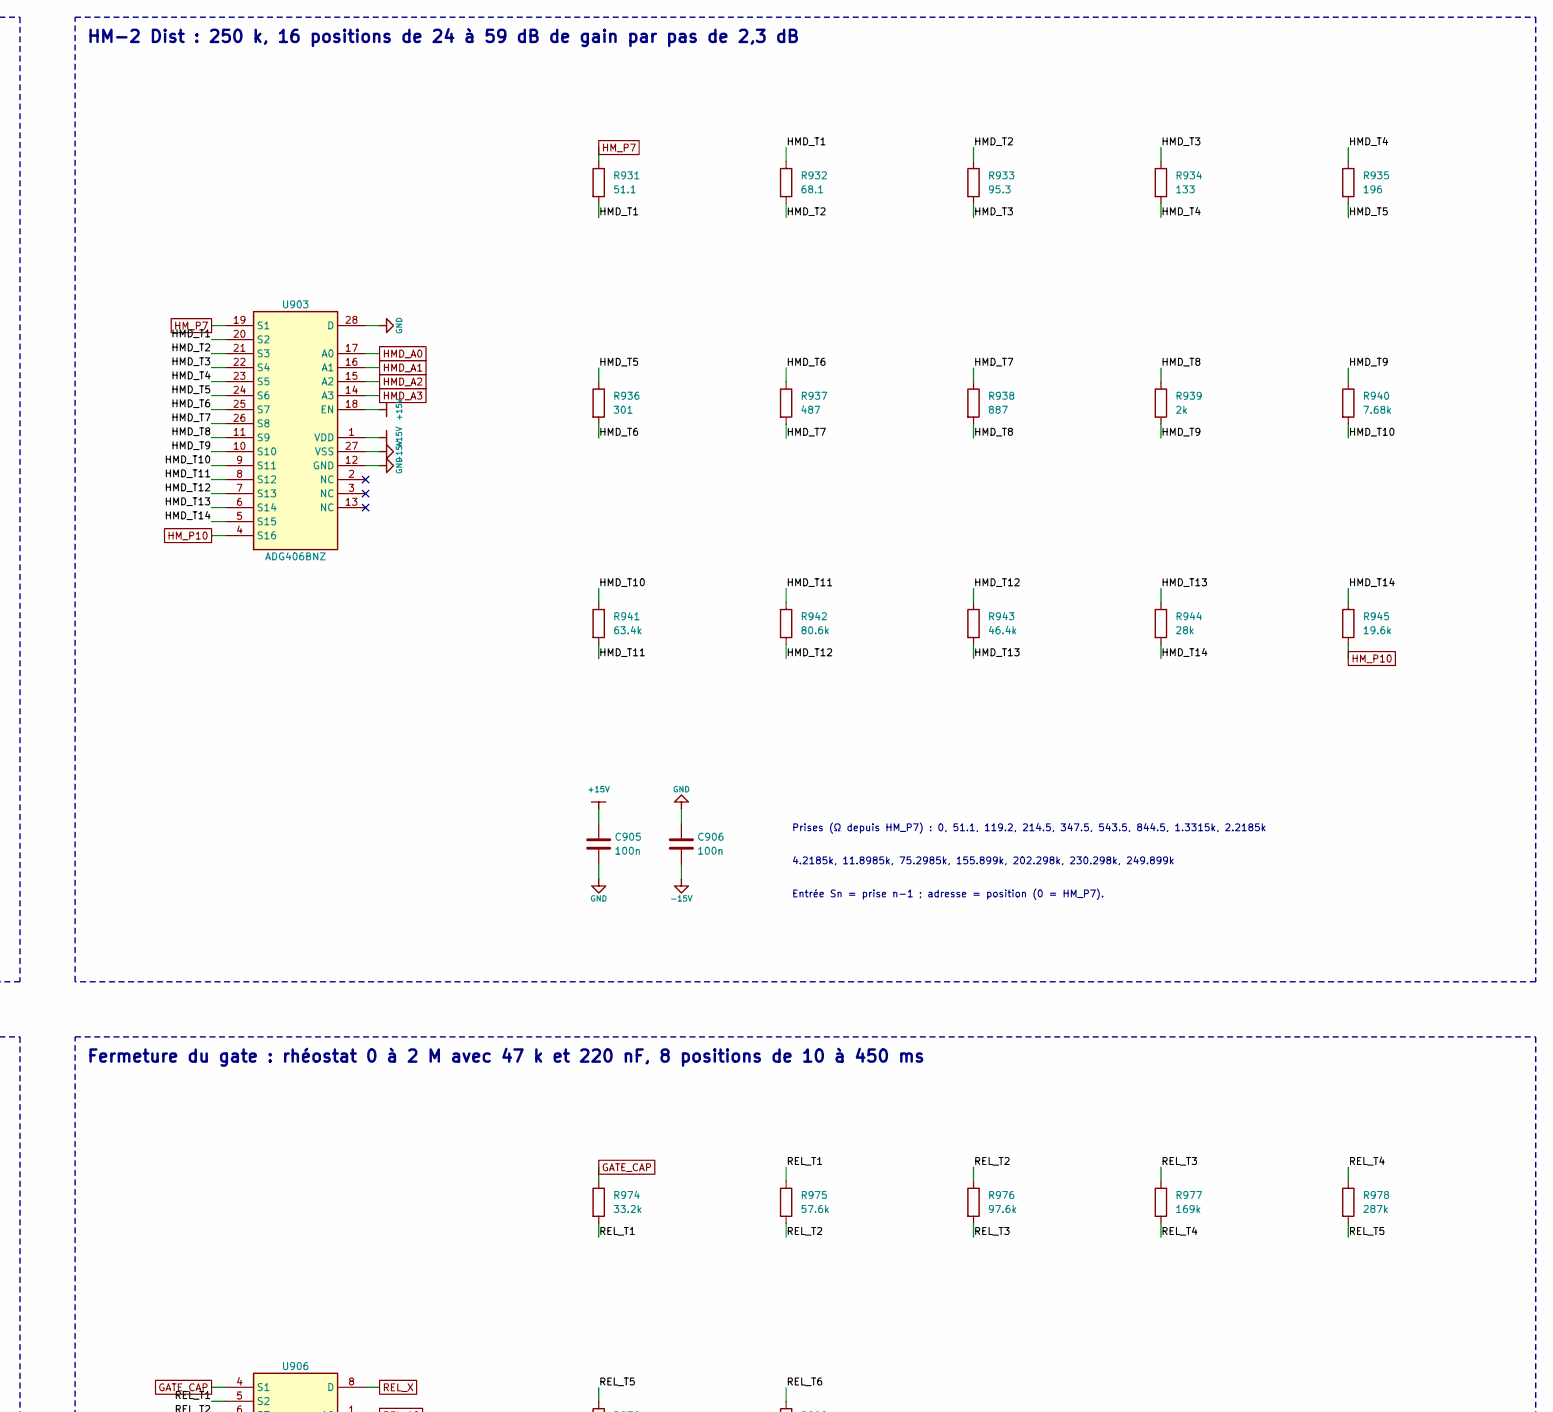
[picture p40: schematic commandes_entree.kicad_sch, part in row 1, column 3]

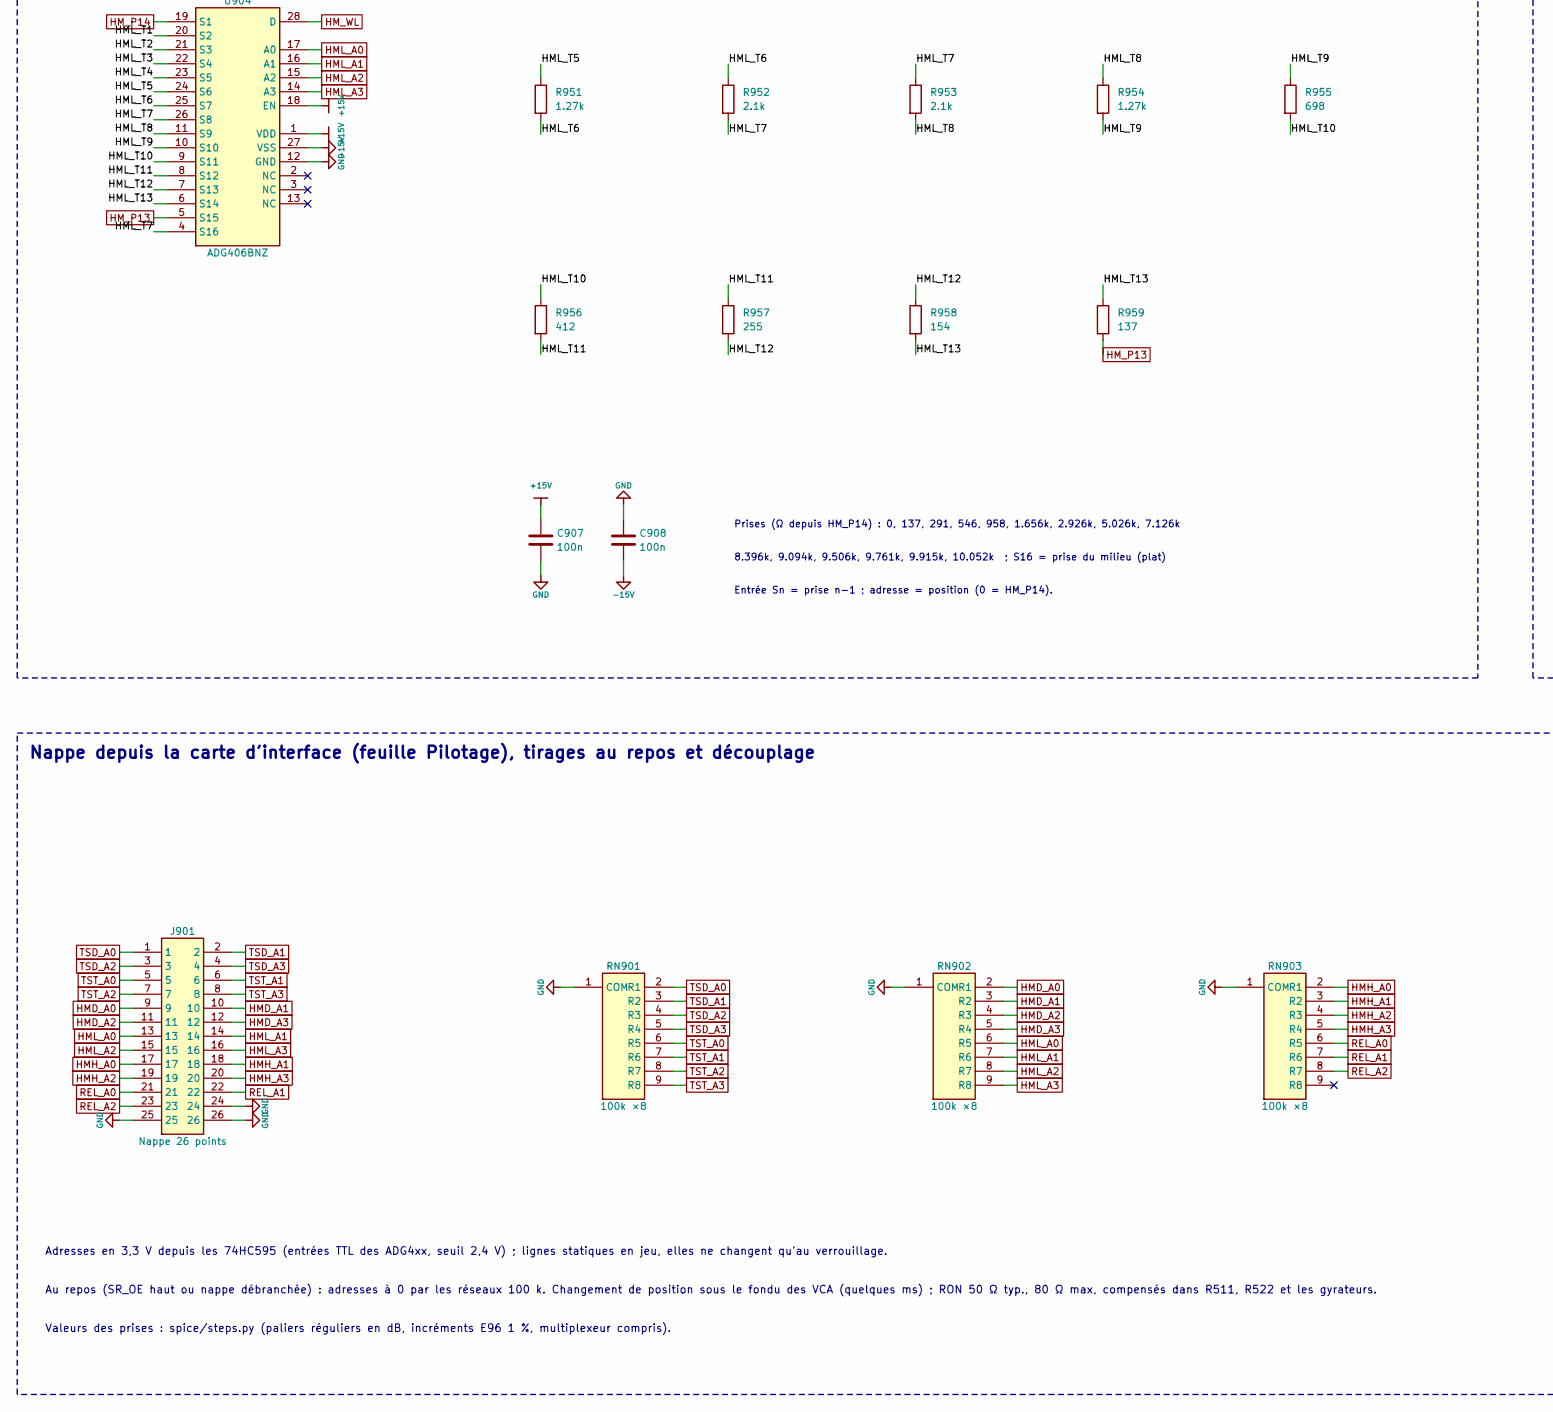
[picture p41: schematic commandes_entree.kicad_sch, part in row 2, column 1]

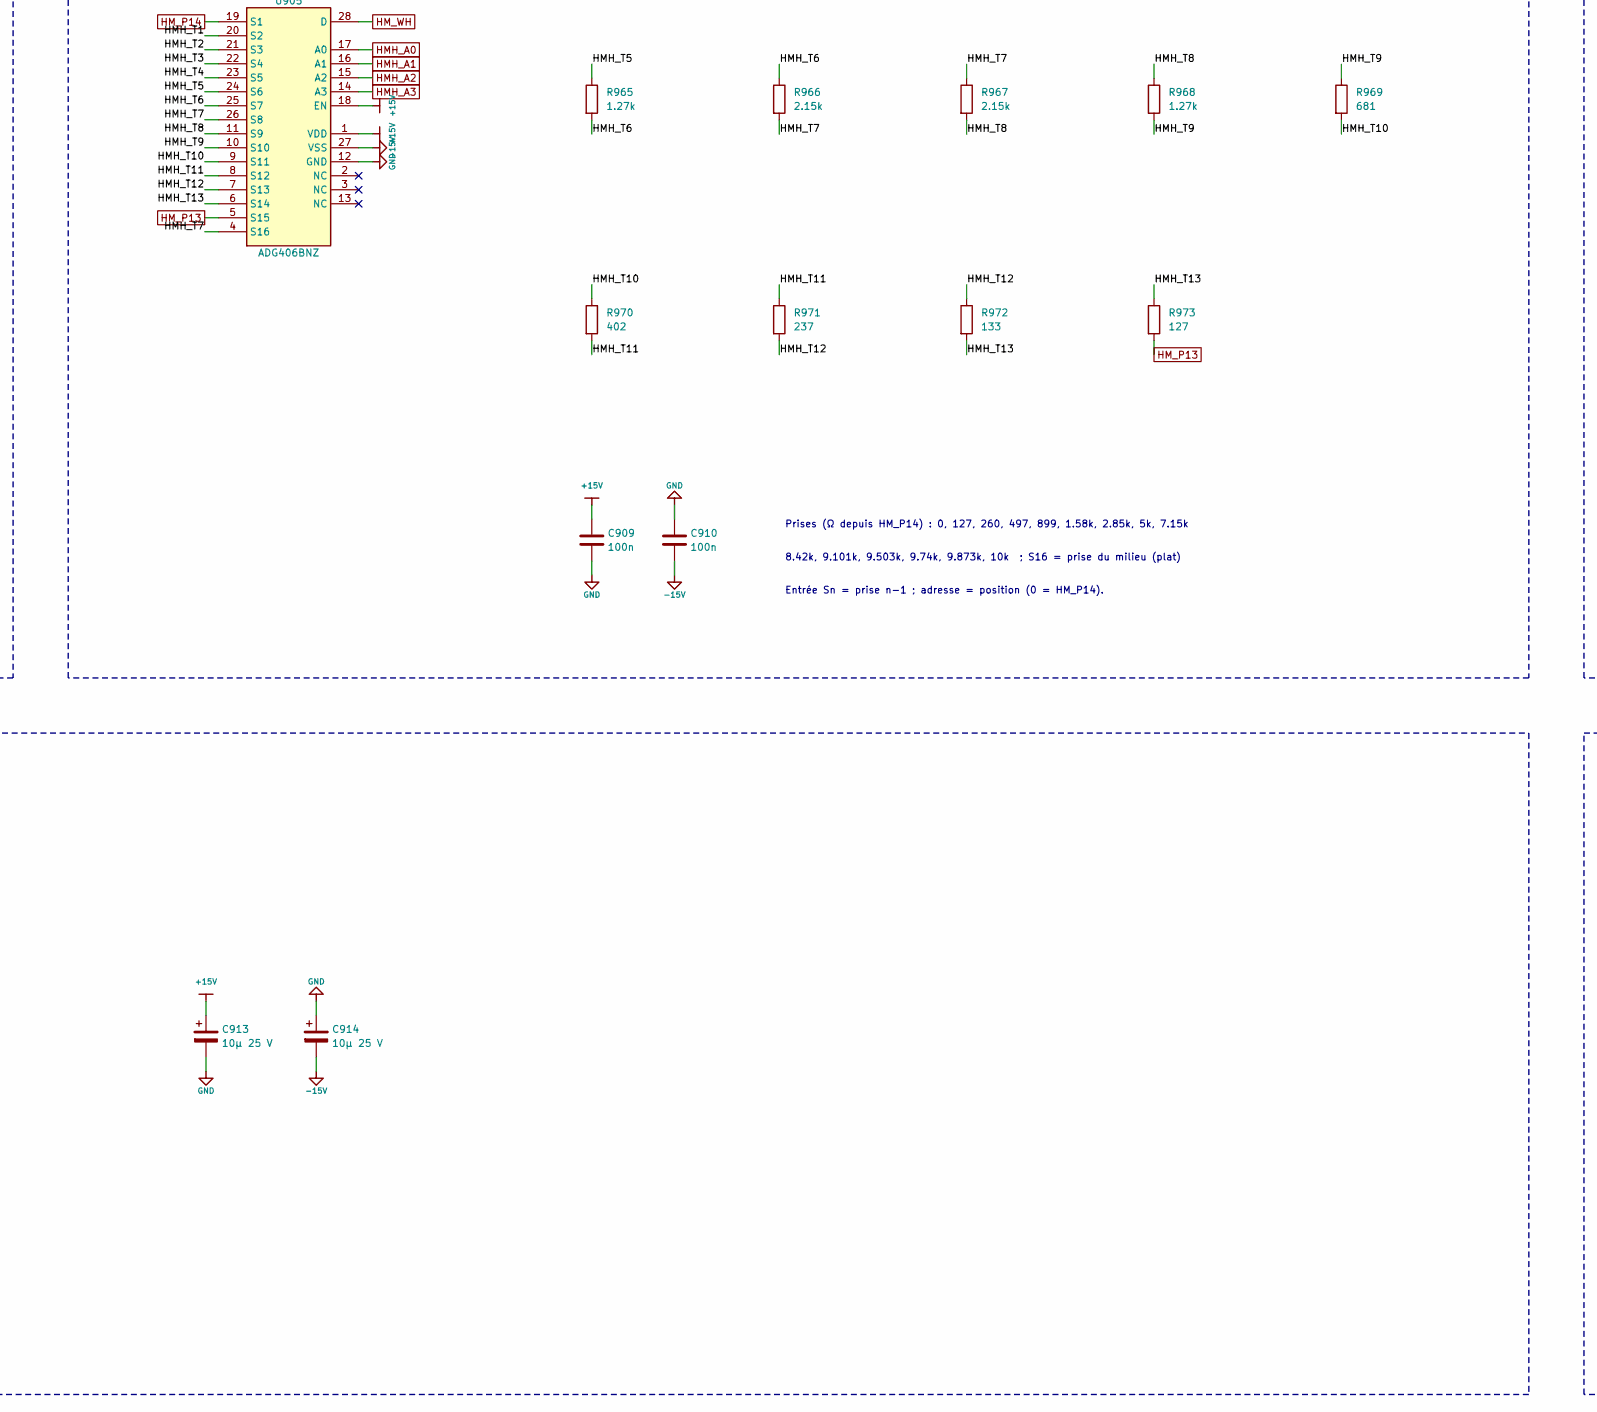
[picture p42: schematic commandes_entree.kicad_sch, part in row 2, column 2]

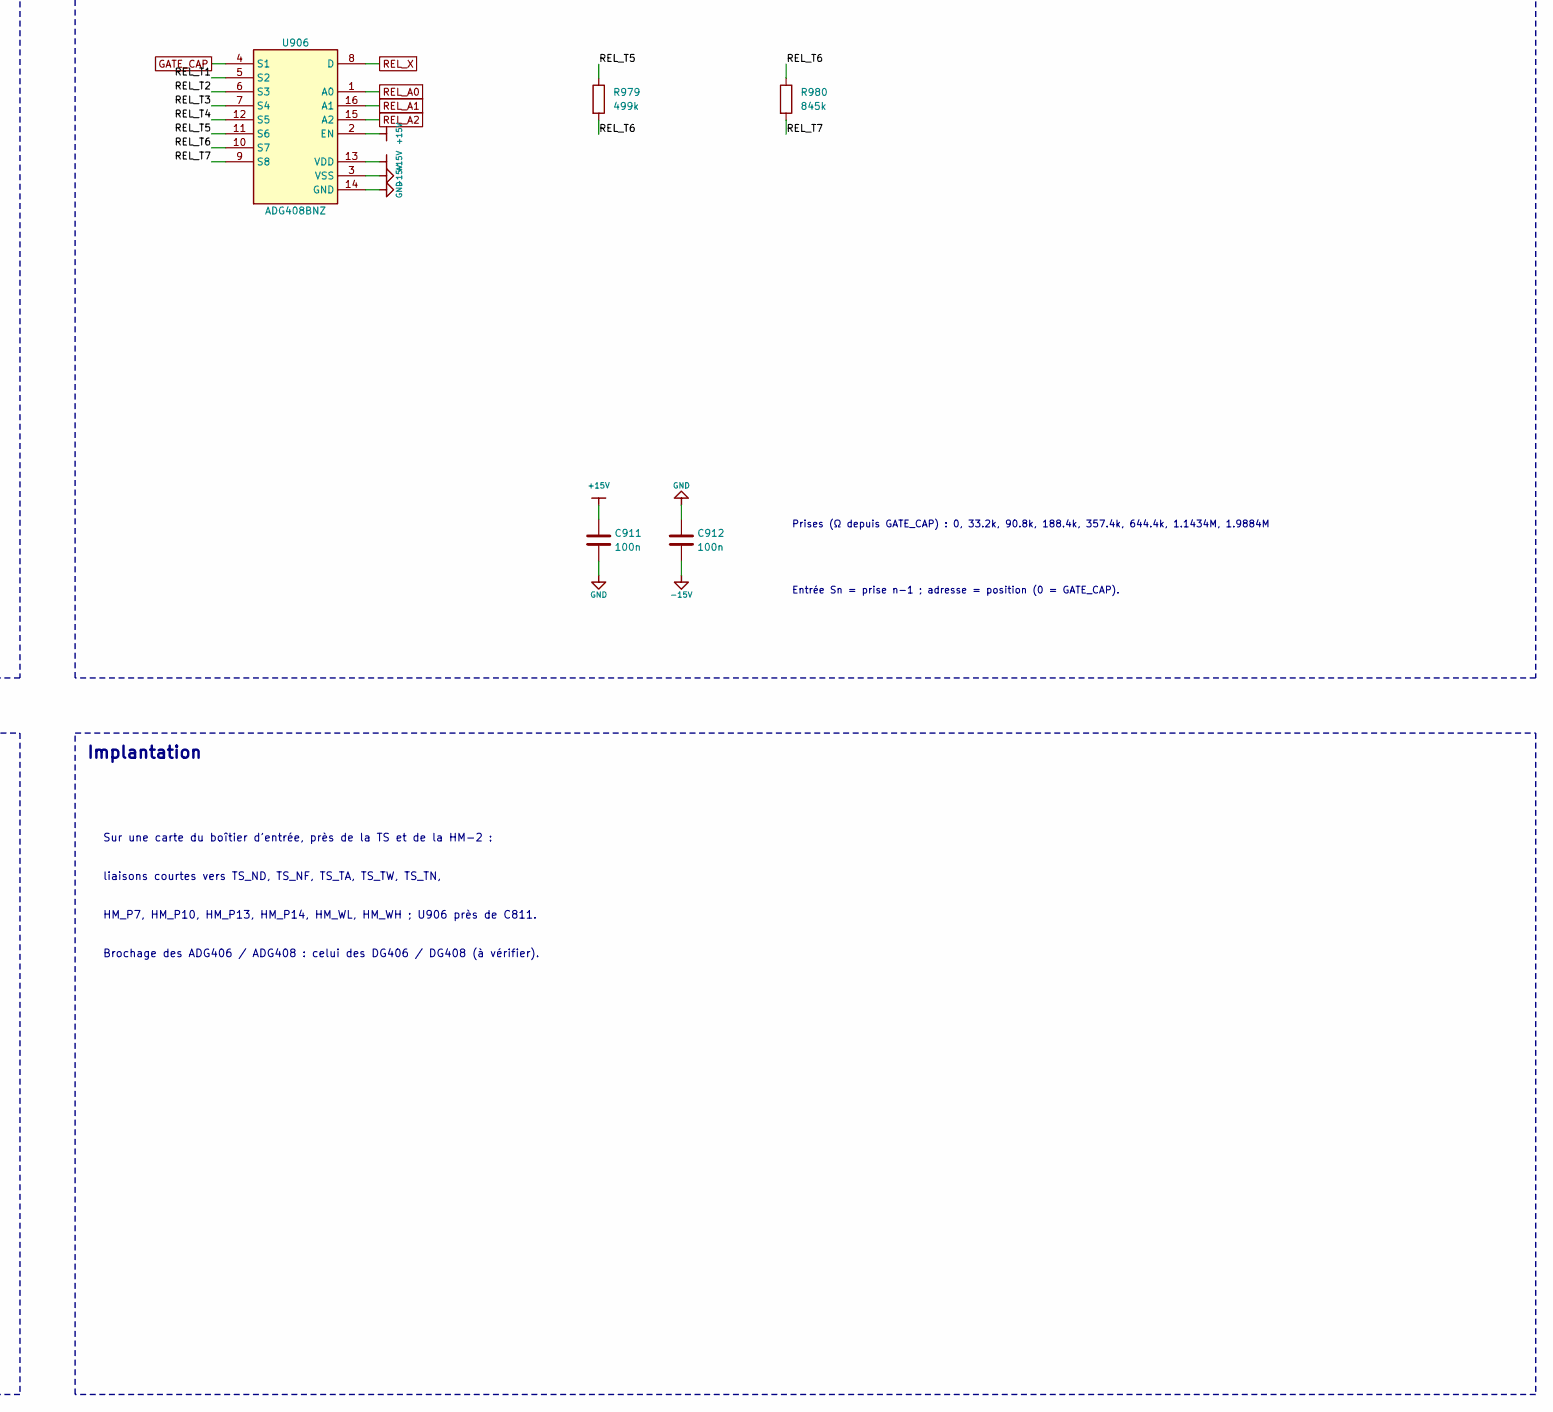
[picture p43: schematic commandes_entree.kicad_sch, part in row 2, column 3]

Parts:
C901, C902, C903, C904, C905, C906, C907, C908, C909, C910, C911, C912: 100n
C913, C914: 10µ 25 V
J901: Nappe 26 points
R901: 9.31k
R902: 10.7k
R903: 12.4k
R904, R926: 14.7k
R905: 16.9k
R906: 20k
R907: 23.2k
R908: 26.7k
R909: 31.6k
R910: 36.5k
R911: 43.2k
R912: 49.9k
R913, R975: 57.6k
R914: 68.1k
R915: 78.7k
R916: 60.4
R917: 66.5
R918: 76.8
R919: 93.1
R920: 113
R921: 143
R922: 191
R923: 261
R924: 392
R925: 649
R927: 2.94k
R928, R962, R971: 237
R929: 124
R930: 84.5
R931: 51.1
R932: 68.1
R933: 95.3
R934, R961, R972: 133
R935: 196
R936: 301
R937: 487
R938: 887
R939: 2k
R940: 7.68k
R941: 63.4k
R942: 80.6k
R943: 46.4k
R944: 28k
R945: 19.6k
R946, R959: 137
R947, R958: 154
R948, R957: 255
R949, R956: 412
R950, R955: 698
R951, R954, R965, R968: 1.27k
R952, R953: 2.1k
R960, R973: 127
R963, R970: 402
R964, R969: 681
R966, R967: 2.15k
R974: 33.2k
R976: 97.6k
R977: 169k
R978: 287k
R979: 499k
R980: 845k
RN901, RN902, RN903: 100k ×8
U901, U902, U903, U904, U905: ADG406BNZ
U906: ADG408BNZ

Connections:
+15V: C901.1, C903.1, C905.1, C907.1, C909.1, C911.1, C913.1 (+), U901.1 (VDD), U901.18 (EN), U902.1 (VDD), U902.18 (EN), U903.1 (VDD), U903.18 (EN), U904.1 (VDD), U904.18 (EN), U905.1 (VDD), U905.18 (EN), U906.2 (EN), U906.13 (VDD)
-15V: C902.2, C904.2, C906.2, C908.2, C910.2, C912.2, C914.2 (-), U901.27 (VSS), U902.27 (VSS), U903.27 (VSS), U904.27 (VSS), U905.27 (VSS), U906.3 (VSS)
GATE_CAP: R974.1, U906.4 (S1)
GND: C901.2, C902.1, C903.2, C904.1, C905.2, C906.1, C907.2, C908.1, C909.2, C910.1, C911.2, C912.1, C913.2 (-), C914.1 (+), J901.24, J901.25, J901.26, RN901.1 (COM), RN902.1 (COM), RN903.1 (COM), U901.12 (GND), U902.12 (GND), U903.12 (GND), U903.28 (D), U904.12 (GND), U905.12 (GND), U906.14 (GND)
HMD_A0: J901.9, RN902.2 (R1), U903.17 (A0)
HMD_A1: J901.10, RN902.3 (R2), U903.16 (A1)
HMD_A2: J901.11, RN902.4 (R3), U903.15 (A2)
HMD_A3: J901.12, RN902.5 (R4), U903.14 (A3)
HMD_T1: R931.2, R932.1, U903.20 (S2)
HMD_T2: R932.2, R933.1, U903.21 (S3)
HMD_T3: R933.2, R934.1, U903.22 (S4)
HMD_T4: R934.2, R935.1, U903.23 (S5)
HMD_T5: R935.2, R936.1, U903.24 (S6)
HMD_T6: R936.2, R937.1, U903.25 (S7)
HMD_T7: R937.2, R938.1, U903.26 (S8)
HMD_T8: R938.2, R939.1, U903.11 (S9)
HMD_T9: R939.2, R940.1, U903.10 (S10)
HMD_T10: R940.2, R941.1, U903.9 (S11)
HMD_T11: R941.2, R942.1, U903.8 (S12)
HMD_T12: R942.2, R943.1, U903.7 (S13)
HMD_T13: R943.2, R944.1, U903.6 (S14)
HMD_T14: R944.2, R945.1, U903.5 (S15)
HMH_A0: J901.17, RN903.2 (R1), U905.17 (A0)
HMH_A1: J901.18, RN903.3 (R2), U905.16 (A1)
HMH_A2: J901.19, RN903.4 (R3), U905.15 (A2)
HMH_A3: J901.20, RN903.5 (R4), U905.14 (A3)
HMH_T1: R960.2, R961.1, U905.20 (S2)
HMH_T2: R961.2, R962.1, U905.21 (S3)
HMH_T3: R962.2, R963.1, U905.22 (S4)
HMH_T4: R963.2, R964.1, U905.23 (S5)
HMH_T5: R964.2, R965.1, U905.24 (S6)
HMH_T6: R965.2, R966.1, U905.25 (S7)
HMH_T7: R966.2, R967.1, U905.4 (S16), U905.26 (S8)
HMH_T8: R967.2, R968.1, U905.11 (S9)
HMH_T9: R968.2, R969.1, U905.10 (S10)
HMH_T10: R969.2, R970.1, U905.9 (S11)
HMH_T11: R970.2, R971.1, U905.8 (S12)
HMH_T12: R971.2, R972.1, U905.7 (S13)
HMH_T13: R972.2, R973.1, U905.6 (S14)
HML_A0: J901.13, RN902.6 (R5), U904.17 (A0)
HML_A1: J901.14, RN902.7 (R6), U904.16 (A1)
HML_A2: J901.15, RN902.8 (R7), U904.15 (A2)
HML_A3: J901.16, RN902.9 (R8), U904.14 (A3)
HML_T1: R946.2, R947.1, U904.20 (S2)
HML_T2: R947.2, R948.1, U904.21 (S3)
HML_T3: R948.2, R949.1, U904.22 (S4)
HML_T4: R949.2, R950.1, U904.23 (S5)
HML_T5: R950.2, R951.1, U904.24 (S6)
HML_T6: R951.2, R952.1, U904.25 (S7)
HML_T7: R952.2, R953.1, U904.4 (S16), U904.26 (S8)
HML_T8: R953.2, R954.1, U904.11 (S9)
HML_T9: R954.2, R955.1, U904.10 (S10)
HML_T10: R955.2, R956.1, U904.9 (S11)
HML_T11: R956.2, R957.1, U904.8 (S12)
HML_T12: R957.2, R958.1, U904.7 (S13)
HML_T13: R958.2, R959.1, U904.6 (S14)
HM_P7: R931.1, U903.19 (S1)
HM_P10: R945.2, U903.4 (S16)
HM_P13: R959.2, R973.2, U904.5 (S15), U905.5 (S15)
HM_P14: R946.1, R960.1, U904.19 (S1), U905.19 (S1)
HM_WH: U905.28 (D)
HM_WL: U904.28 (D)
REL_A0: J901.21, RN903.6 (R5), U906.1 (A0)
REL_A1: J901.22, RN903.7 (R6), U906.16 (A1)
REL_A2: J901.23, RN903.8 (R7), U906.15 (A2)
REL_T1: R974.2, R975.1, U906.5 (S2)
REL_T2: R975.2, R976.1, U906.6 (S3)
REL_T3: R976.2, R977.1, U906.7 (S4)
REL_T4: R977.2, R978.1, U906.12 (S5)
REL_T5: R978.2, R979.1, U906.11 (S6)
REL_T6: R979.2, R980.1, U906.10 (S7)
REL_T7: R980.2, U906.9 (S8)
REL_X: U906.8 (D)
TSD_A0: J901.1, RN901.2 (R1), U901.17 (A0)
TSD_A1: J901.2, RN901.3 (R2), U901.16 (A1)
TSD_A2: J901.3, RN901.4 (R3), U901.15 (A2)
TSD_A3: J901.4, RN901.5 (R4), U901.14 (A3)
TSD_T1: R901.2, R902.1, U901.20 (S2)
TSD_T2: R902.2, R903.1, U901.21 (S3)
TSD_T3: R903.2, R904.1, U901.22 (S4)
TSD_T4: R904.2, R905.1, U901.23 (S5)
TSD_T5: R905.2, R906.1, U901.24 (S6)
TSD_T6: R906.2, R907.1, U901.25 (S7)
TSD_T7: R907.2, R908.1, U901.26 (S8)
TSD_T8: R908.2, R909.1, U901.11 (S9)
TSD_T9: R909.2, R910.1, U901.10 (S10)
TSD_T10: R910.2, R911.1, U901.9 (S11)
TSD_T11: R911.2, R912.1, U901.8 (S12)
TSD_T12: R912.2, R913.1, U901.7 (S13)
TSD_T13: R913.2, R914.1, U901.6 (S14)
TSD_T14: R914.2, R915.1, U901.5 (S15)
TSD_T15: R915.2, U901.4 (S16)
TST_A0: J901.5, RN901.6 (R5), U902.17 (A0)
TST_A1: J901.6, RN901.7 (R6), U902.16 (A1)
TST_A2: J901.7, RN901.8 (R7), U902.15 (A2)
TST_A3: J901.8, RN901.9 (R8), U902.14 (A3)
TST_T1: R916.2, R917.1, U902.20 (S2)
TST_T2: R917.2, R918.1, U902.21 (S3)
TST_T3: R918.2, R919.1, U902.22 (S4)
TST_T4: R919.2, R920.1, U902.23 (S5)
TST_T5: R920.2, R921.1, U902.24 (S6)
TST_T6: R921.2, R922.1, U902.25 (S7)
TST_T7: R922.2, R923.1, U902.26 (S8)
TST_T8: R923.2, R924.1, U902.11 (S9)
TST_T9: R924.2, R925.1, U902.10 (S10)
TST_T10: R925.2, R926.1, U902.9 (S11)
TST_T11: R926.2, R927.1, U902.8 (S12)
TST_T12: R927.2, R928.1, U902.7 (S13)
TST_T13: R928.2, R929.1, U902.6 (S14)
TST_T14: R929.2, R930.1, U902.5 (S15)
TS_ND: R901.1, U901.19 (S1)
TS_NF: U901.28 (D)
TS_TA: R930.2, U902.4 (S16)
TS_TN: R916.1, U902.19 (S1)
TS_TW: U902.28 (D)

Notes on the sheet:
Prises (Ω depuis TS_ND) : 0, 9.31k, 20.01k, 32.41k, 47.11k, 64.01k, 84.01k, 107.21k, 133.91k
165.51k, 202.01k, 245.21k, 295.11k, 352.71k, 420.81k, 499.51k
Entrée Sn = prise n−1 ; adresse = position (0 = TS_ND).
Prises (Ω depuis TS_TN) : 0, 60.4, 126.9, 203.7, 296.8, 409.8, 552.8, 743.8, 1.0048k
1.3968k, 2.0458k, 16.7458k, 19.6858k, 19.9228k, 20.0468k, 20.1313k
Entrée Sn = prise n−1 ; adresse = position (0 = TS_TN).
Prises (Ω depuis HM_P7) : 0, 51.1, 119.2, 214.5, 347.5, 543.5, 844.5, 1.3315k, 2.2185k
4.2185k, 11.8985k, 75.2985k, 155.899k, 202.298k, 230.298k, 249.899k
Entrée Sn = prise n−1 ; adresse = position (0 = HM_P7).
Prises (Ω depuis HM_P14) : 0, 137, 291, 546, 958, 1.656k, 2.926k, 5.026k, 7.126k
8.396k, 9.094k, 9.506k, 9.761k, 9.915k, 10.052k ; S16 = prise du milieu (plat)
Entrée Sn = prise n−1 ; adresse = position (0 = HM_P14).
Prises (Ω depuis HM_P14) : 0, 127, 260, 497, 899, 1.58k, 2.85k, 5k, 7.15k
8.42k, 9.101k, 9.503k, 9.74k, 9.873k, 10k ; S16 = prise du milieu (plat)
Prises (Ω depuis GATE_CAP) : 0, 33.2k, 90.8k, 188.4k, 357.4k, 644.4k, 1.1434M, 1.9884M
Entrée Sn = prise n−1 ; adresse = position (0 = GATE_CAP).
Adresses en 3,3 V depuis les 74HC595 (entrées TTL des ADG4xx, seuil 2,4 V) ; lignes statiques en jeu, elles ne changent qu'au verrouillage.
Au repos (SR_OE haut ou nappe débranchée) : adresses à 0 par les réseaux 100 k. Changement de position sous le fondu des VCA (quelques ms) ; RON 50 Ω typ., 80 Ω max, compensés dans R511, R522 et les gyrateurs.
Valeurs des prises : spice/steps.py (paliers réguliers en dB, incréments E96 1 %, multiplexeur compris).
Sur une carte du boîtier d'entrée, près de la TS et de la HM-2 :
liaisons courtes vers TS_ND, TS_NF, TS_TA, TS_TW, TS_TN,
HM_P7, HM_P10, HM_P13, HM_P14, HM_WL, HM_WH ; U906 près de C811.
Brochage des ADG406 / ADG408 : celui des DG406 / DG408 (à vérifier).
TS Drive : rhéostat 0 à 500 k, 16 positions de 21,5 à 41,5 dB par pas de 1,33 dB
TS Tone : 20 k, 16 positions de −2,4 à −17,4 dB (4 kHz / 200 Hz) par pas de 1 dB
HM-2 Dist : 250 k, 16 positions de 24 à 59 dB de gain par pas de 2,3 dB
HM-2 Color Mix L : 10 k, 15 positions de −20 à +20 dB à 84 Hz, plate au milieu
HM-2 Color Mix H : 10 k, 15 positions de −22 à +22 dB vers 1 kHz, plate au milieu
Fermeture du gate : rhéostat 0 à 2 M avec 47 k et 220 nF, 8 positions de 10 à 450 ms
Nappe depuis la carte d'interface (feuille Pilotage), tirages au repos et découplage
Implantation
