Arnwald/slo-pilote/kicad/slo-pilote/pilotage.kicad_sch

## KiCad design kicad/slo-pilote/pilotage.kicad_sch (2026-11-08)

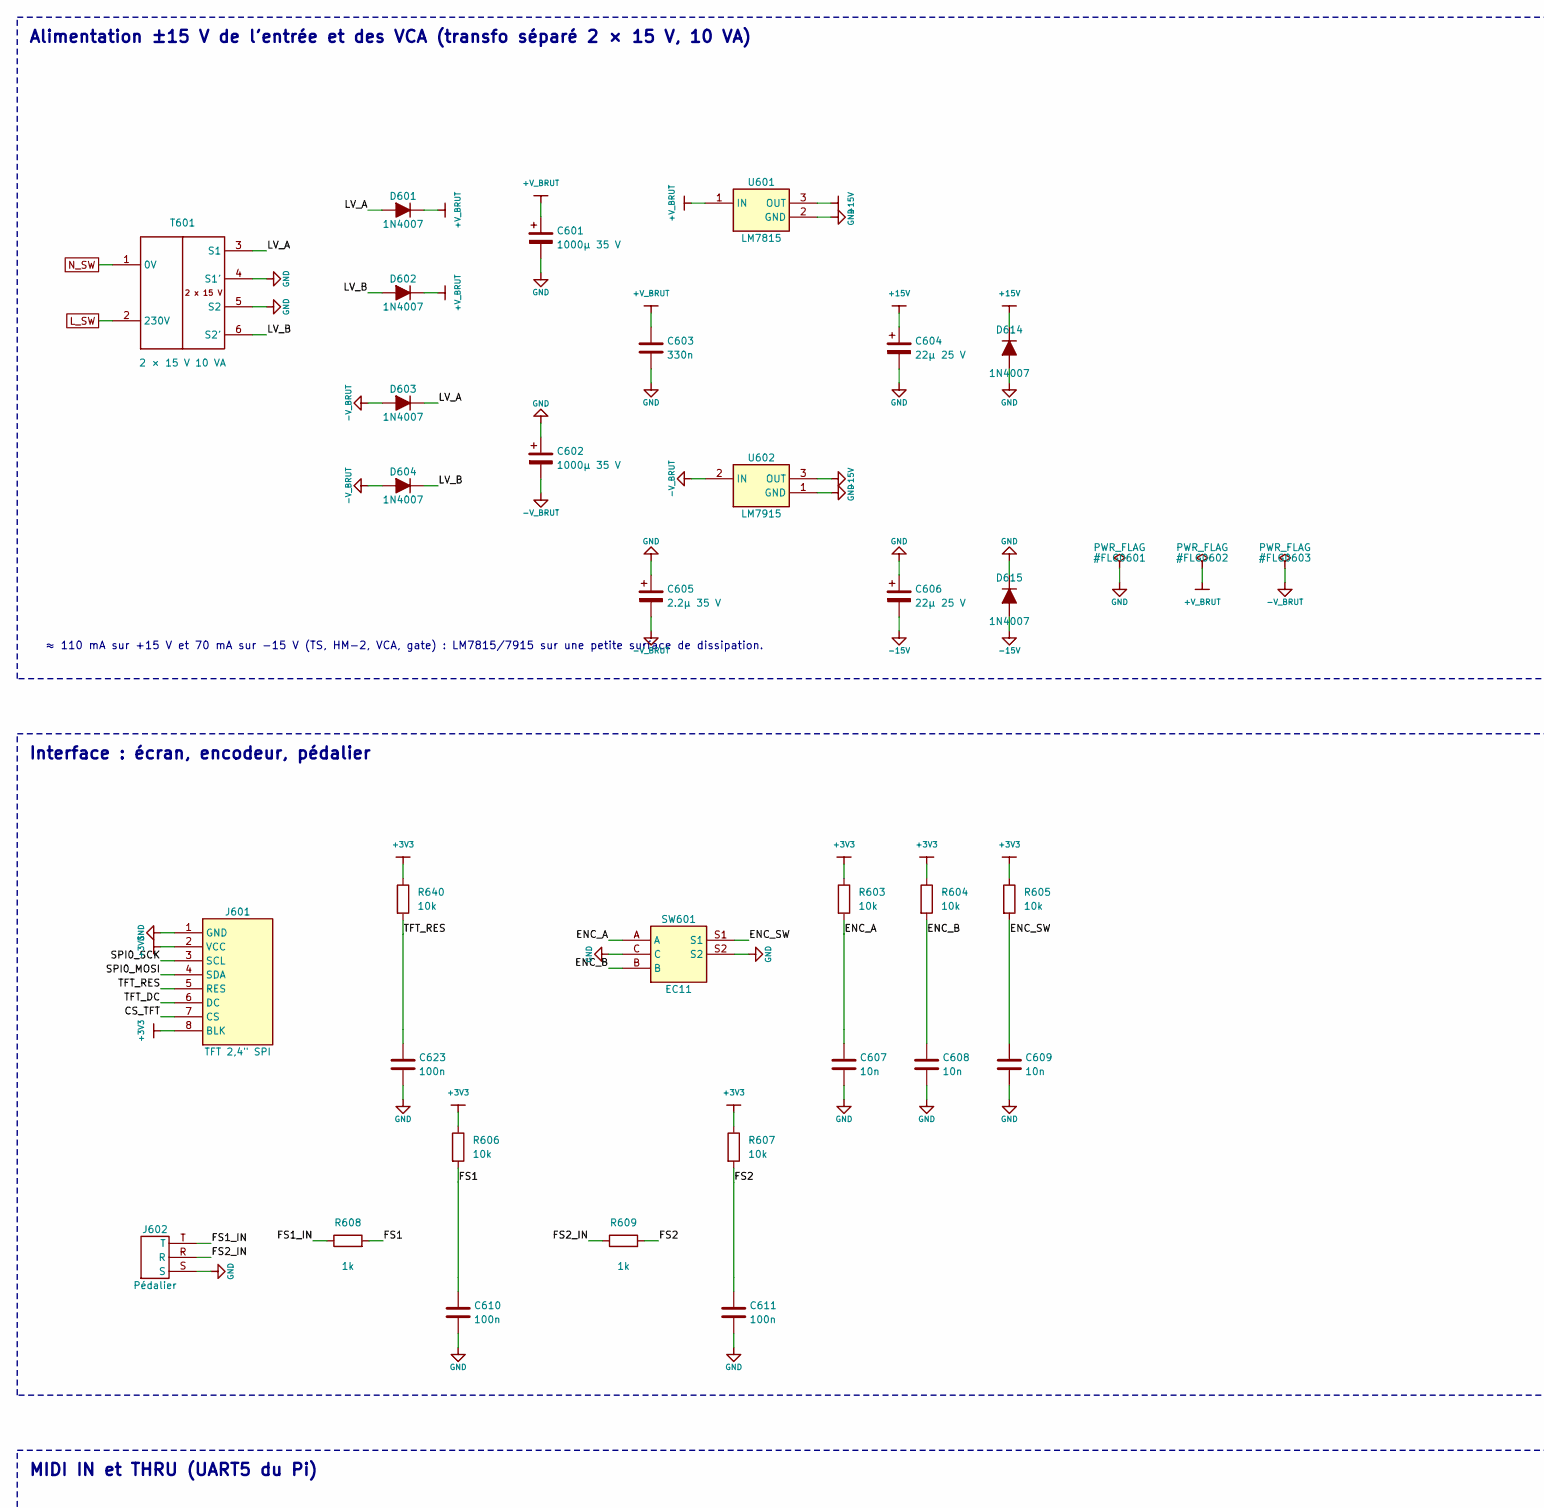
[picture p44: schematic pilotage.kicad_sch, part in row 1, column 1]

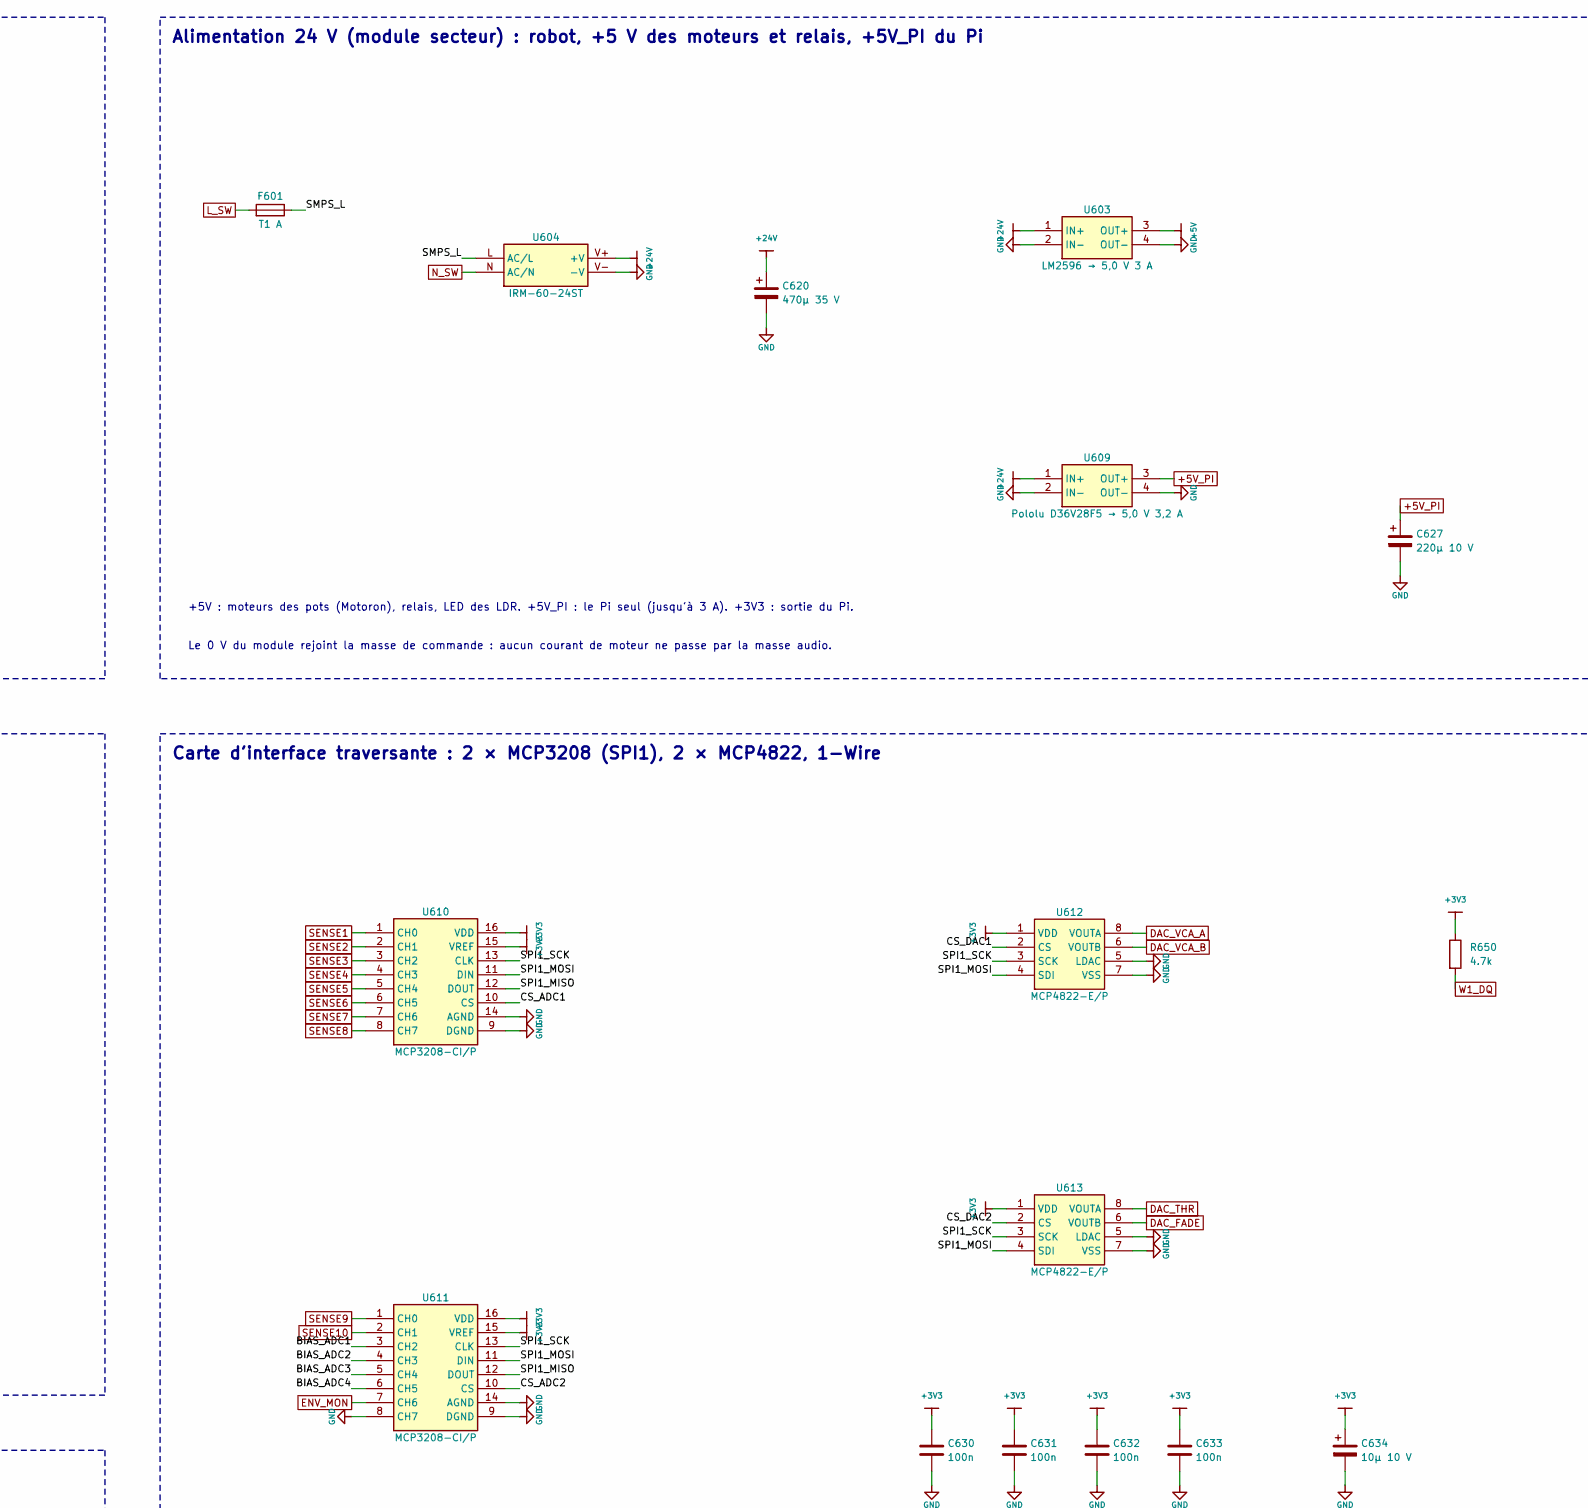
[picture p45: schematic pilotage.kicad_sch, part in row 1, column 2]

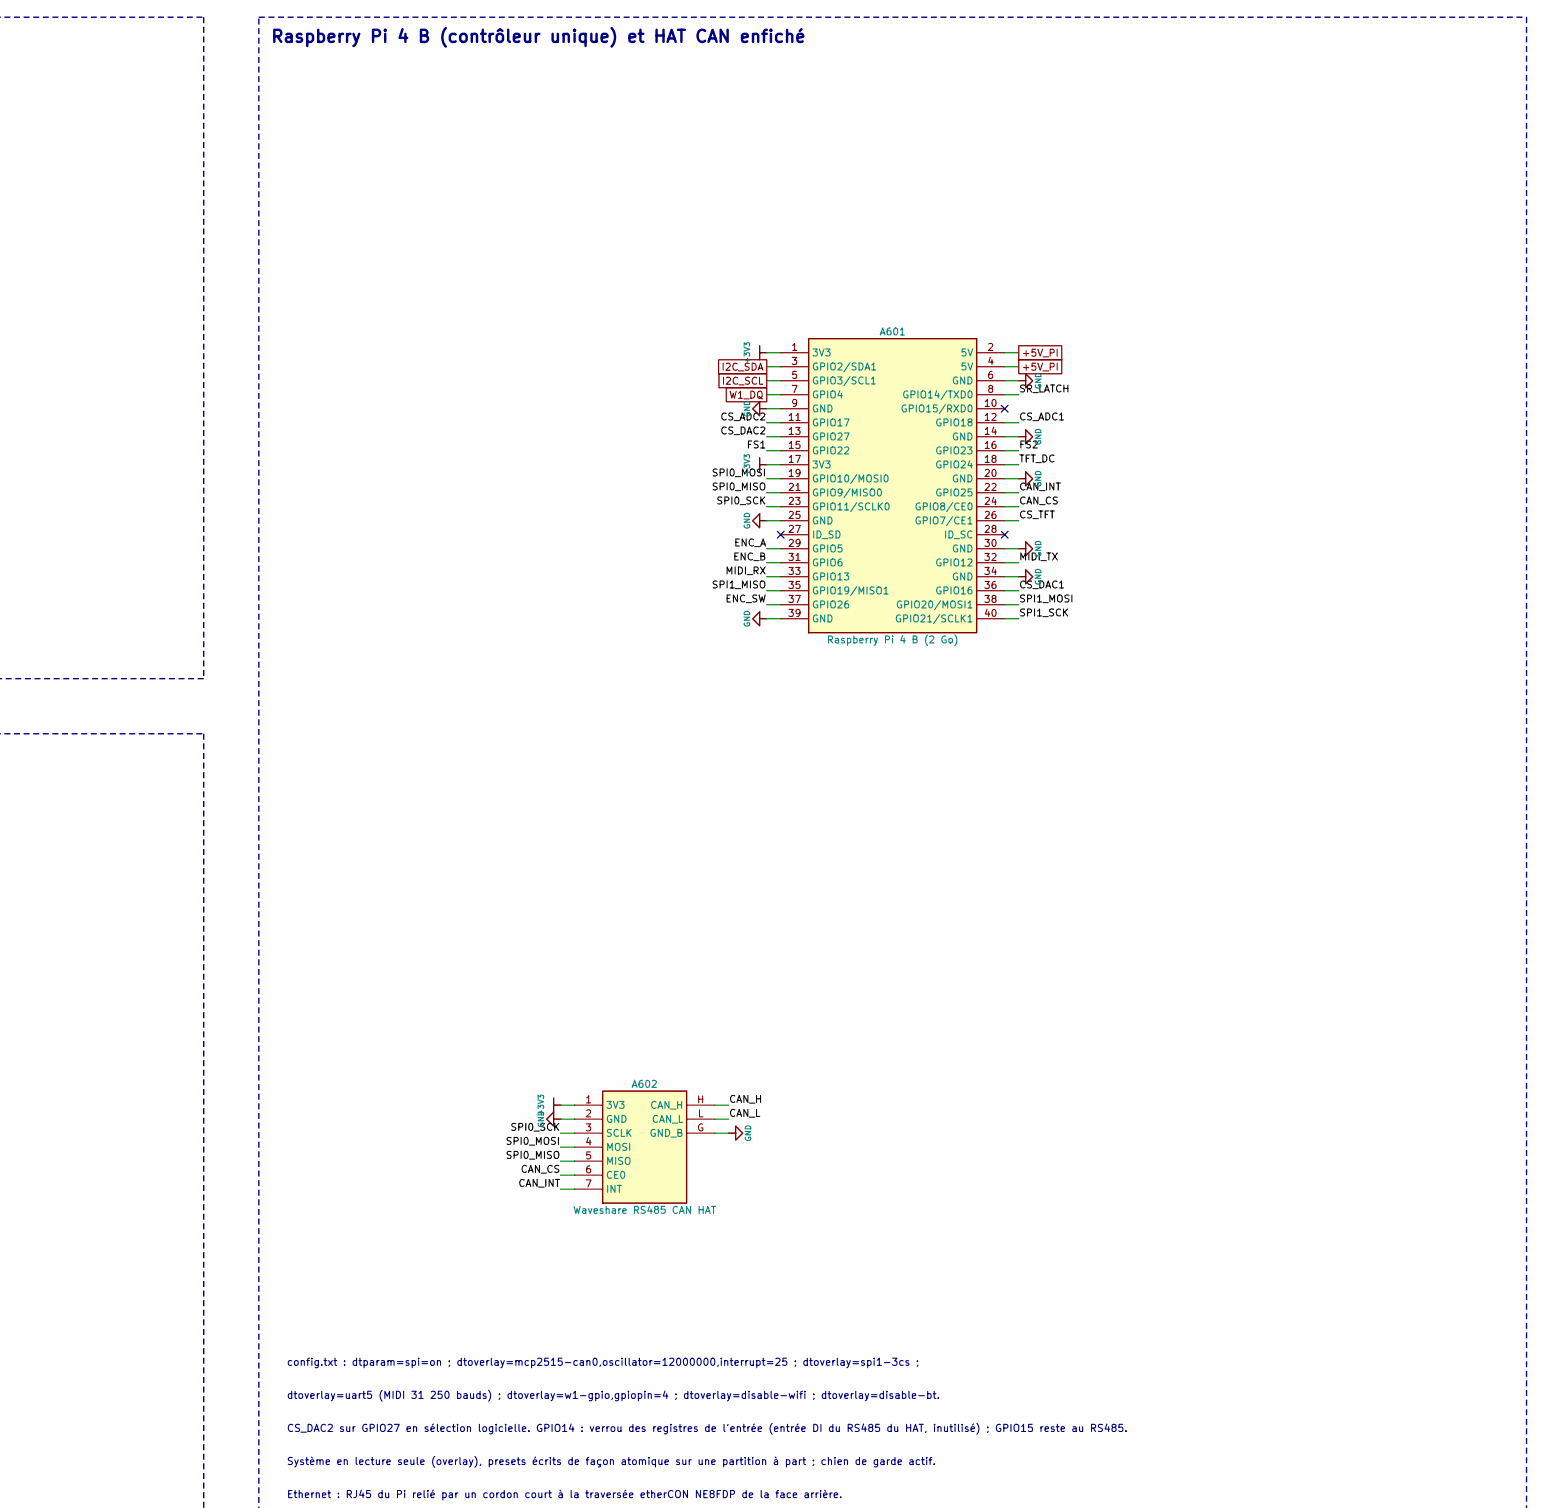
[picture p46: schematic pilotage.kicad_sch, part in row 1, column 3]

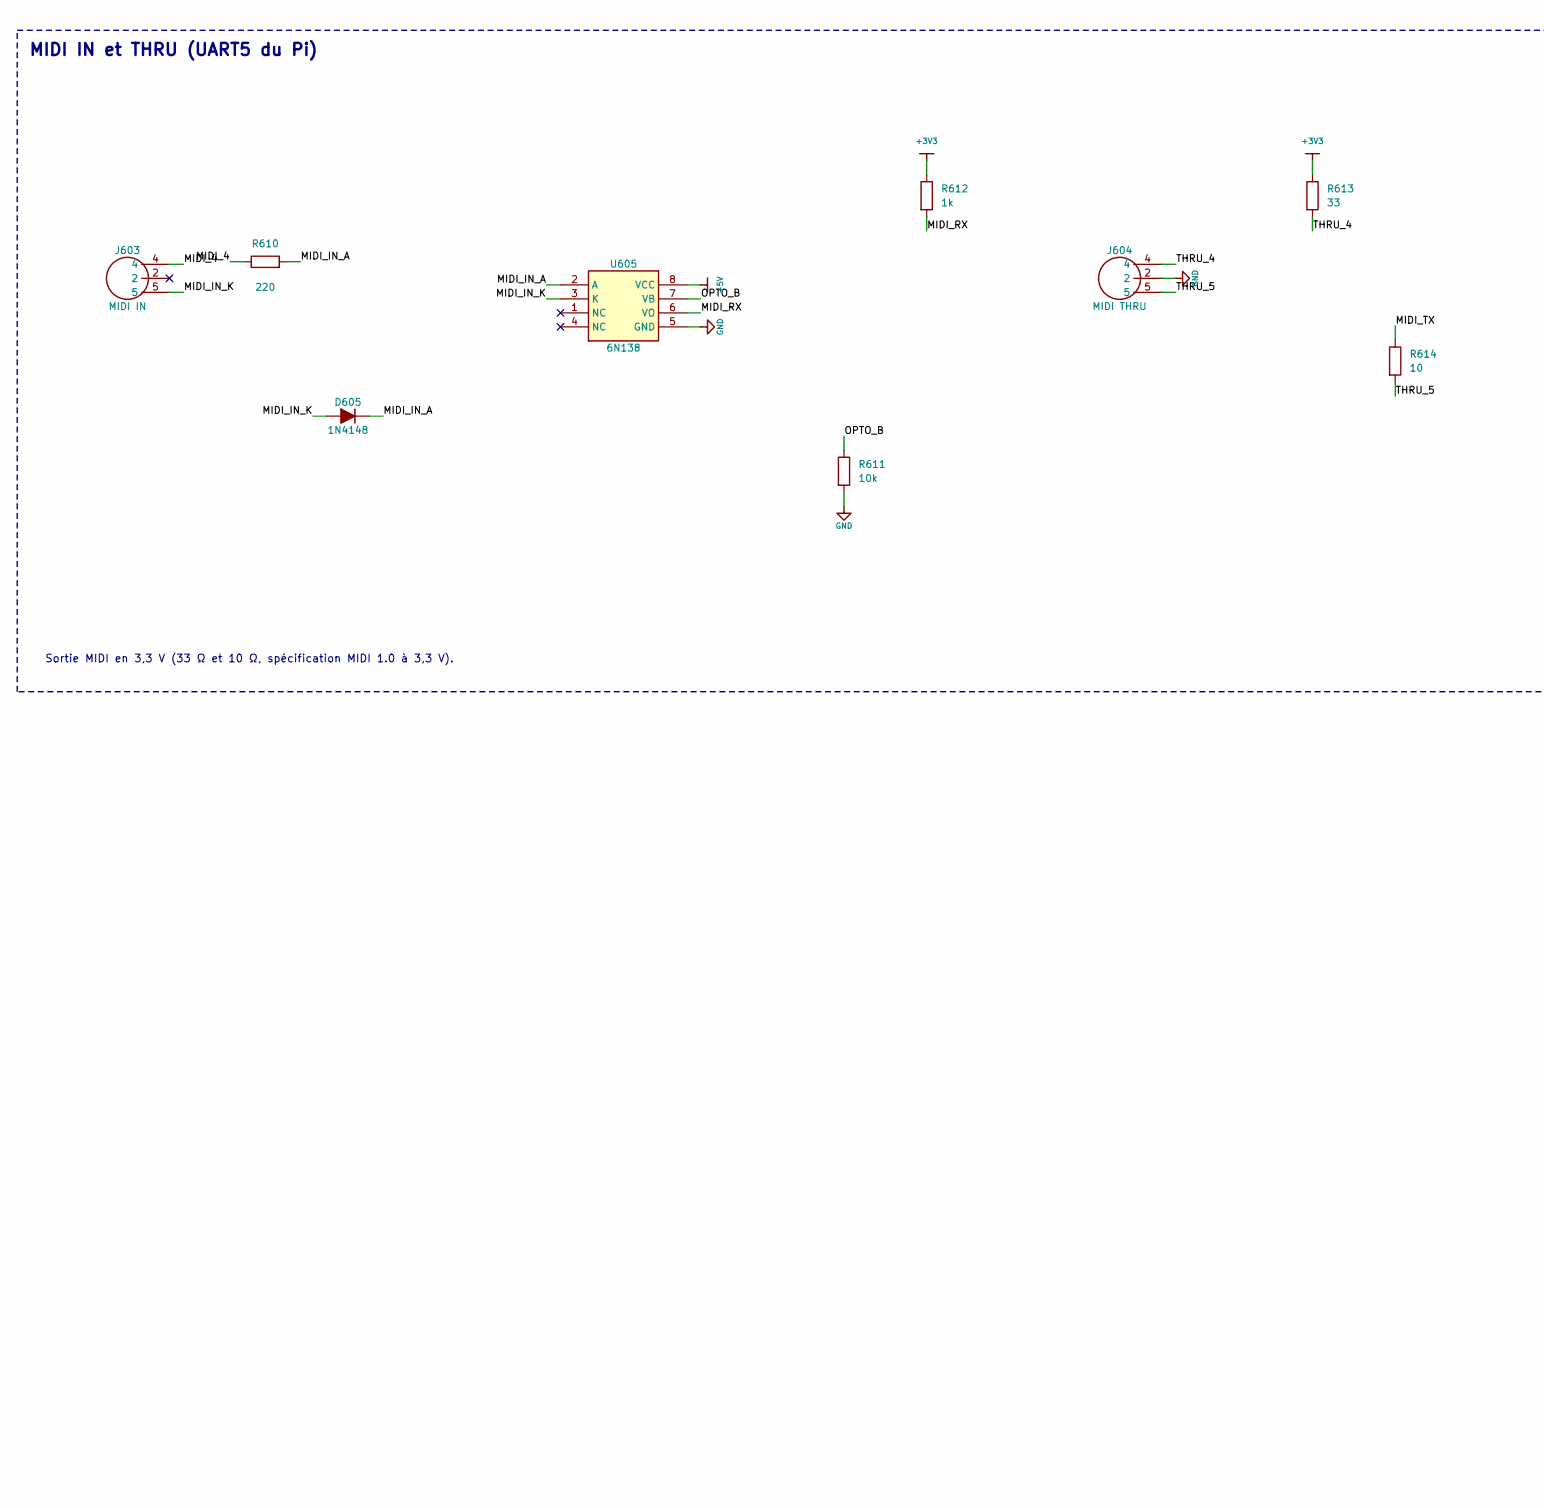
[picture p47: schematic pilotage.kicad_sch, part in row 2, column 1]

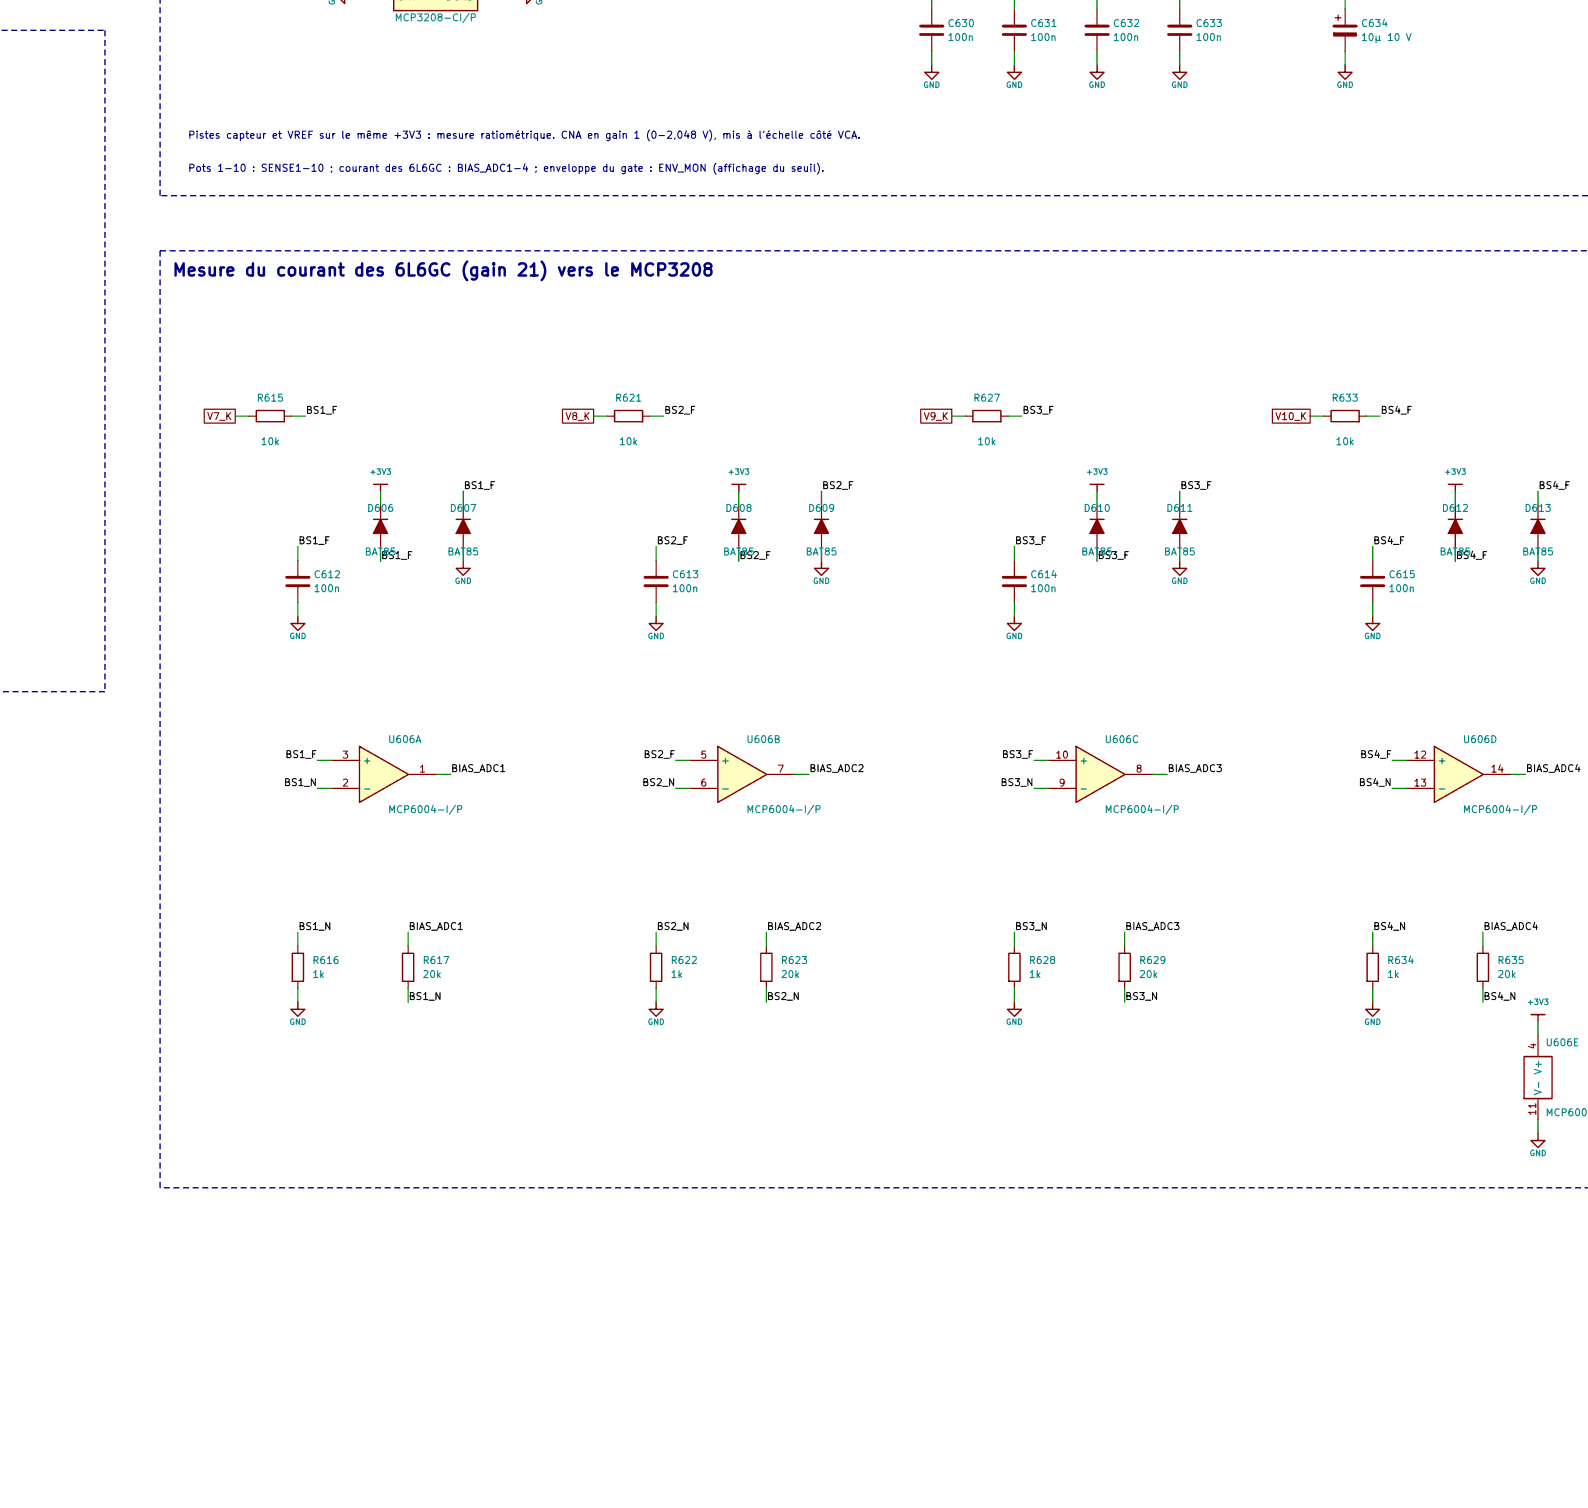
[picture p48: schematic pilotage.kicad_sch, part in row 2, column 2]

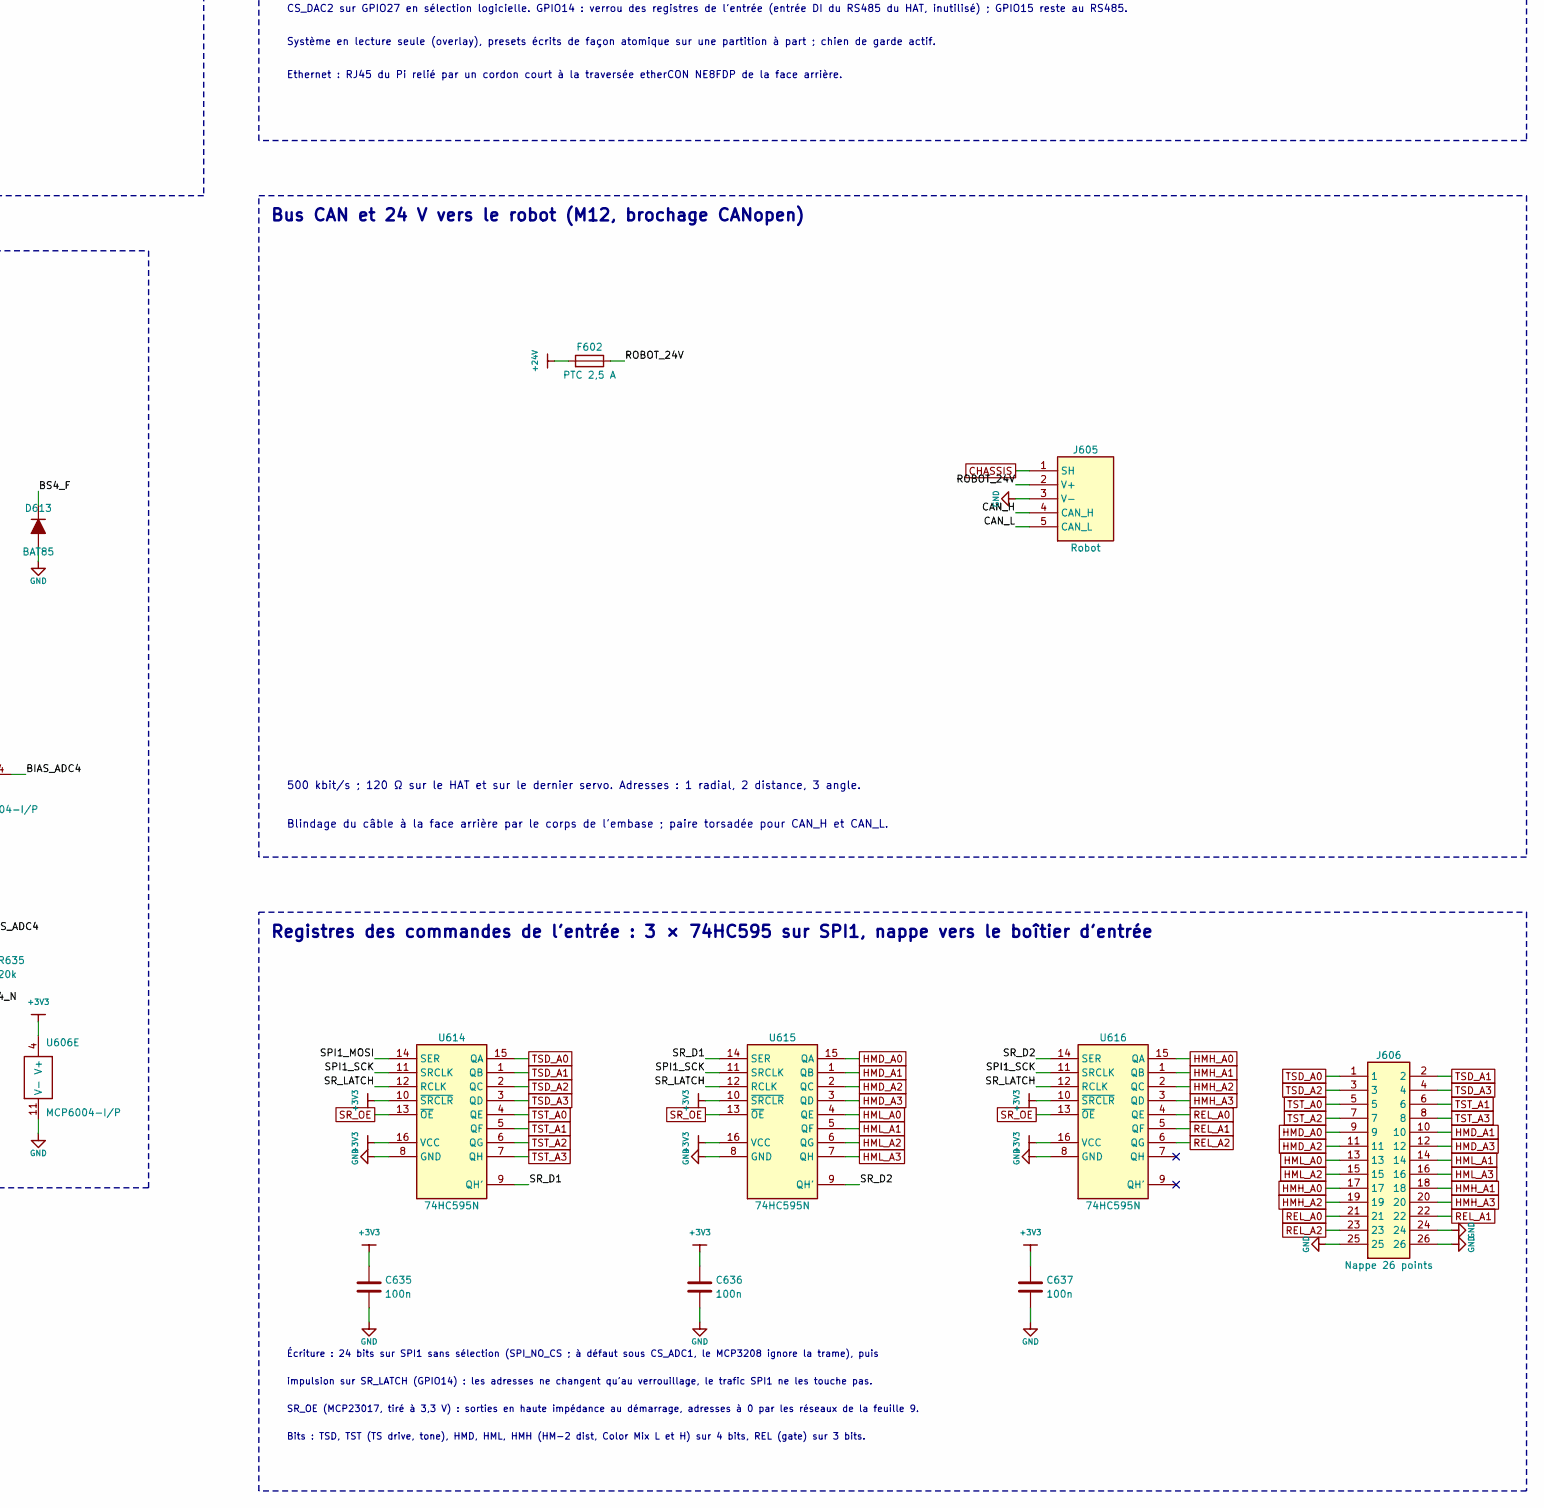
[picture p49: schematic pilotage.kicad_sch, part in row 2, column 3]

Parts:
A601: Raspberry Pi 4 B (2 Go)
A602: Waveshare RS485 CAN HAT
C601, C602: 1000µ 35 V
C603: 330n
C604, C606: 22µ 25 V
C605: 2.2µ 35 V
C607, C608, C609: 10n
C610, C611, C612, C613, C614, C615, C623, C630, C631, C632, C633, C635, C636, C637: 100n
C620: 470µ 35 V
C627: 220µ 10 V
C634: 10µ 10 V
D601, D602, D603, D604, D614, D615: 1N4007
D605: 1N4148
D606, D607, D608, D609, D610, D611, D612, D613: BAT85
F601: T1 A
F602: PTC 2,5 A
J601: TFT 2,4" SPI
J602: Pédalier
J603: MIDI IN
J604: MIDI THRU
J605: Robot
J606: Nappe 26 points
R603, R604, R605, R606, R607, R611, R615, R621, R627, R633, R640: 10k
R608, R609, R612, R616, R622, R628, R634: 1k
R610: 220
R613: 33
R614: 10
R617, R623, R629, R635: 20k
R650: 4.7k
SW601: EC11
T601: 2 × 15 V 10 VA
U601: LM7815
U602: LM7915
U603: LM2596 → 5,0 V 3 A
U604: IRM-60-24ST
U605: 6N138
U606: MCP6004-I/P
U609: Pololu D36V28F5 → 5,0 V 3,2 A
U610, U611: MCP3208-CI/P
U612, U613: MCP4822-E/P
U614, U615, U616: 74HC595N

Connections:
+3V3: A601.1 (3V3), A601.17 (3V3), A602.1 (3V3), C630.1, C631.1, C632.1, C633.1, C634.1 (+), C635.1, C636.1, C637.1, D606.2 (K), D608.2 (K), D610.2 (K), D612.2 (K), J601.2 (VCC), J601.8 (BLK), R603.1, R604.1, R605.1, R606.1, R607.1, R612.1, R613.1, R640.1, R650.1, U606.4 (V+), U610.15 (VREF), U610.16 (VDD), U611.15 (VREF), U611.16 (VDD), U612.1 (VDD), U613.1 (VDD), U614.10 (~SRCLR), U614.16 (VCC), U615.10 (~SRCLR), U615.16 (VCC), U616.10 (~SRCLR), U616.16 (VCC)
+5V: U603.3 (OUT+), U605.8 (VCC)
+5V_PI: A601.2 (5V), A601.4 (5V), C627.1 (+), U609.3 (OUT+)
+15V: C604.1 (+), D614.2 (K), U601.3 (OUT)
+24V: C620.1 (+), F602.1, U603.1 (IN+), U604.V+ (+V), U609.1 (IN+)
+V_BRUT: C601.1 (+), C603.1, D601.2 (K), D602.2 (K), U601.1 (IN)
-15V: C606.2 (-), D615.1 (A), U602.3 (OUT)
-V_BRUT: C602.2 (-), C605.2 (-), D603.1 (A), D604.1 (A), U602.2 (IN)
BIAS_ADC1: R617.1, U606.1, U611.3 (CH2)
BIAS_ADC2: R623.1, U606.7, U611.4 (CH3)
BIAS_ADC3: R629.1, U606.8, U611.5 (CH4)
BIAS_ADC4: R635.1, U606.14, U611.6 (CH5)
BS1_F: C612.1, D606.1 (A), D607.2 (K), R615.2, U606.3 (+)
BS1_N: R616.1, R617.2, U606.2 (-)
BS2_F: C613.1, D608.1 (A), D609.2 (K), R621.2, U606.5 (+)
BS2_N: R622.1, R623.2, U606.6 (-)
BS3_F: C614.1, D610.1 (A), D611.2 (K), R627.2, U606.10 (+)
BS3_N: R628.1, R629.2, U606.9 (-)
BS4_F: C615.1, D612.1 (A), D613.2 (K), R633.2, U606.12 (+)
BS4_N: R634.1, R635.2, U606.13 (-)
CAN_CS: A601.24 (GPIO8/CE0), A602.6 (CE0)
CAN_H: A602.H (CAN_H), J605.4 (CAN_H)
CAN_INT: A601.22 (GPIO25), A602.7 (INT)
CAN_L: A602.L (CAN_L), J605.5 (CAN_L)
CHASSIS: J605.1 (SH)
CS_ADC1: A601.12 (GPIO18), U610.10 (CS)
CS_ADC2: A601.11 (GPIO17), U611.10 (CS)
CS_DAC1: A601.36 (GPIO16), U612.2 (CS)
CS_DAC2: A601.13 (GPIO27), U613.2 (CS)
CS_TFT: A601.26 (GPIO7/CE1), J601.7 (CS)
DAC_FADE: U613.6 (VOUTB)
DAC_THR: U613.8 (VOUTA)
DAC_VCA_A: U612.8 (VOUTA)
DAC_VCA_B: U612.6 (VOUTB)
ENC_A: A601.29 (GPIO5), C607.1, R603.2, SW601.A
ENC_B: A601.31 (GPIO6), C608.1, R604.2, SW601.B
ENC_SW: A601.37 (GPIO26), C609.1, R605.2, SW601.S1
ENV_MON: U611.7 (CH6)
FS1: A601.15 (GPIO22), C610.1, R606.2, R608.2
FS1_IN: J602.T, R608.1
FS2: A601.16 (GPIO23), C611.1, R607.2, R609.2
FS2_IN: J602.R, R609.1
GND: A601.6 (GND), A601.9 (GND), A601.14 (GND), A601.20 (GND), A601.25 (GND), A601.30 (GND), A601.34 (GND), A601.39 (GND), A602.2 (GND), A602.G (GND_B), C601.2 (-), C602.1 (+), C603.2, C604.2 (-), C605.1 (+), C606.1 (+), C607.2, C608.2, C609.2, C610.2, C611.2, C612.2, C613.2, C614.2, C615.2, C620.2 (-), C623.2, C627.2 (-), C630.2, C631.2, C632.2, C633.2, C634.2 (-), C635.2, C636.2, C637.2, D607.1 (A), D609.1 (A), D611.1 (A), D613.1 (A), D614.1 (A), D615.2 (K), J601.1 (GND), J602.S, J604.2, J605.3 (V-), J606.24, J606.25, J606.26, R611.2, R616.2, R622.2, R628.2, R634.2, SW601.C, SW601.S2, T601.4 (S1'), T601.5 (S2), U601.2 (GND), U602.1 (GND), U603.2 (IN-), U603.4 (OUT-), U604.V- (-V), U605.5 (GND), U606.11 (V-), U609.2 (IN-), U609.4 (OUT-), U610.9 (DGND), U610.14 (AGND), U611.8 (CH7), U611.9 (DGND), U611.14 (AGND), U612.5 (LDAC), U612.7 (VSS), U613.5 (LDAC), U613.7 (VSS), U614.8 (GND), U615.8 (GND), U616.8 (GND)
HMD_A0: J606.9, U615.15 (QA)
HMD_A1: J606.10, U615.1 (QB)
HMD_A2: J606.11, U615.2 (QC)
HMD_A3: J606.12, U615.3 (QD)
HMH_A0: J606.17, U616.15 (QA)
HMH_A1: J606.18, U616.1 (QB)
HMH_A2: J606.19, U616.2 (QC)
HMH_A3: J606.20, U616.3 (QD)
HML_A0: J606.13, U615.4 (QE)
HML_A1: J606.14, U615.5 (QF)
HML_A2: J606.15, U615.6 (QG)
HML_A3: J606.16, U615.7 (QH)
I2C_SCL: A601.5 (GPIO3/SCL1)
I2C_SDA: A601.3 (GPIO2/SDA1)
LV_A: D601.1 (A), D603.2 (K), T601.3 (S1)
LV_B: D602.1 (A), D604.2 (K), T601.6 (S2')
L_SW: F601.1, T601.2 (230V)
MIDI_4: J603.4, R610.1
MIDI_IN_A: D605.2 (K), R610.2, U605.2 (A)
MIDI_IN_K: D605.1 (A), J603.5, U605.3 (K)
MIDI_RX: A601.33 (GPIO13), R612.2, U605.6 (VO)
MIDI_TX: A601.32 (GPIO12), R614.1
N_SW: T601.1 (0V), U604.N (AC/N)
OPTO_B: R611.1, U605.7 (VB)
REL_A0: J606.21, U616.4 (QE)
REL_A1: J606.22, U616.5 (QF)
REL_A2: J606.23, U616.6 (QG)
ROBOT_24V: F602.2, J605.2 (V+)
SENSE1: U610.1 (CH0)
SENSE2: U610.2 (CH1)
SENSE3: U610.3 (CH2)
SENSE4: U610.4 (CH3)
SENSE5: U610.5 (CH4)
SENSE6: U610.6 (CH5)
SENSE7: U610.7 (CH6)
SENSE8: U610.8 (CH7)
SENSE9: U611.1 (CH0)
SENSE10: U611.2 (CH1)
SMPS_L: F601.2, U604.L (AC/L)
SPI0_MISO: A601.21 (GPIO9/MISO0), A602.5 (MISO)
SPI0_MOSI: A601.19 (GPIO10/MOSI0), A602.4 (MOSI), J601.4 (SDA)
SPI0_SCK: A601.23 (GPIO11/SCLK0), A602.3 (SCLK), J601.3 (SCL)
SPI1_MISO: A601.35 (GPIO19/MISO1), U610.12 (DOUT), U611.12 (DOUT)
SPI1_MOSI: A601.38 (GPIO20/MOSI1), U610.11 (DIN), U611.11 (DIN), U612.4 (SDI), U613.4 (SDI), U614.14 (SER)
SPI1_SCK: A601.40 (GPIO21/SCLK1), U610.13 (CLK), U611.13 (CLK), U612.3 (SCK), U613.3 (SCK), U614.11 (SRCLK), U615.11 (SRCLK), U616.11 (SRCLK)
SR_D1: U614.9 (QH'), U615.14 (SER)
SR_D2: U615.9 (QH'), U616.14 (SER)
SR_LATCH: A601.8 (GPIO14/TXD0), U614.12 (RCLK), U615.12 (RCLK), U616.12 (RCLK)
SR_OE: U614.13 (~OE), U615.13 (~OE), U616.13 (~OE)
TFT_DC: A601.18 (GPIO24), J601.6 (DC)
TFT_RES: C623.1, J601.5 (RES), R640.2
THRU_4: J604.4, R613.2
THRU_5: J604.5, R614.2
TSD_A0: J606.1, U614.15 (QA)
TSD_A1: J606.2, U614.1 (QB)
TSD_A2: J606.3, U614.2 (QC)
TSD_A3: J606.4, U614.3 (QD)
TST_A0: J606.5, U614.4 (QE)
TST_A1: J606.6, U614.5 (QF)
TST_A2: J606.7, U614.6 (QG)
TST_A3: J606.8, U614.7 (QH)
V7_K: R615.1
V8_K: R621.1
V9_K: R627.1
V10_K: R633.1
W1_DQ: A601.7 (GPIO4), R650.2

Notes on the sheet:
≈ 110 mA sur +15 V et 70 mA sur −15 V (TS, HM-2, VCA, gate) : LM7815/7915 sur une petite surface de dissipation.
+5V : moteurs des pots (Motoron), relais, LED des LDR. +5V_PI : le Pi seul (jusqu'à 3 A). +3V3 : sortie du Pi.
Le 0 V du module rejoint la masse de commande : aucun courant de moteur ne passe par la masse audio.
config.txt : dtparam=spi=on ; dtoverlay=mcp2515-can0,oscillator=12000000,interrupt=25 ; dtoverlay=spi1-3cs ;
dtoverlay=uart5 (MIDI 31 250 bauds) ; dtoverlay=w1-gpio,gpiopin=4 ; dtoverlay=disable-wifi ; dtoverlay=disable-bt.
CS_DAC2 sur GPIO27 en sélection logicielle. GPIO14 : verrou des registres de l'entrée (entrée DI du RS485 du HAT, inutilisé) ; GPIO15 reste au RS485.
Système en lecture seule (overlay), presets écrits de façon atomique sur une partition à part ; chien de garde actif.
Ethernet : RJ45 du Pi relié par un cordon court à la traversée etherCON NE8FDP de la face arrière.
Sortie MIDI en 3,3 V (33 Ω et 10 Ω, spécification MIDI 1.0 à 3,3 V).
Pistes capteur et VREF sur le même +3V3 : mesure ratiométrique. CNA en gain 1 (0-2,048 V), mis à l'échelle côté VCA.
Pots 1-10 : SENSE1-10 ; courant des 6L6GC : BIAS_ADC1-4 ; enveloppe du gate : ENV_MON (affichage du seuil).
Écriture : 24 bits sur SPI1 sans sélection (SPI_NO_CS ; à défaut sous CS_ADC1, le MCP3208 ignore la trame), puis
impulsion sur SR_LATCH (GPIO14) : les adresses ne changent qu'au verrouillage, le trafic SPI1 ne les touche pas.
SR_OE (MCP23017, tiré à 3,3 V) : sorties en haute impédance au démarrage, adresses à 0 par les réseaux de la feuille 9.
Bits : TSD, TST (TS drive, tone), HMD, HML, HMH (HM-2 dist, Color Mix L et H) sur 4 bits, REL (gate) sur 3 bits.
500 kbit/s ; 120 Ω sur le HAT et sur le dernier servo. Adresses : 1 radial, 2 distance, 3 angle.
Blindage du câble à la face arrière par le corps de l'embase ; paire torsadée pour CAN_H et CAN_L.
Alimentation ±15 V de l'entrée et des VCA (transfo séparé 2 × 15 V, 10 VA)
Alimentation 24 V (module secteur) : robot, +5 V des moteurs et relais, +5V_PI du Pi
Raspberry Pi 4 B (contrôleur unique) et HAT CAN enfiché
Interface : écran, encodeur, pédalier
MIDI IN et THRU (UART5 du Pi)
Carte d'interface traversante : 2 × MCP3208 (SPI1), 2 × MCP4822, 1-Wire
Registres des commandes de l'entrée : 3 × 74HC595 sur SPI1, nappe vers le boîtier d'entrée
Mesure du courant des 6L6GC (gain 21) vers le MCP3208
Bus CAN et 24 V vers le robot (M12, brochage CANopen)
