Arnwald/slo-pilote/kicad/slo-pilote/preampli.kicad_sch

## KiCad design kicad/slo-pilote/preampli.kicad_sch (2026-11-08)

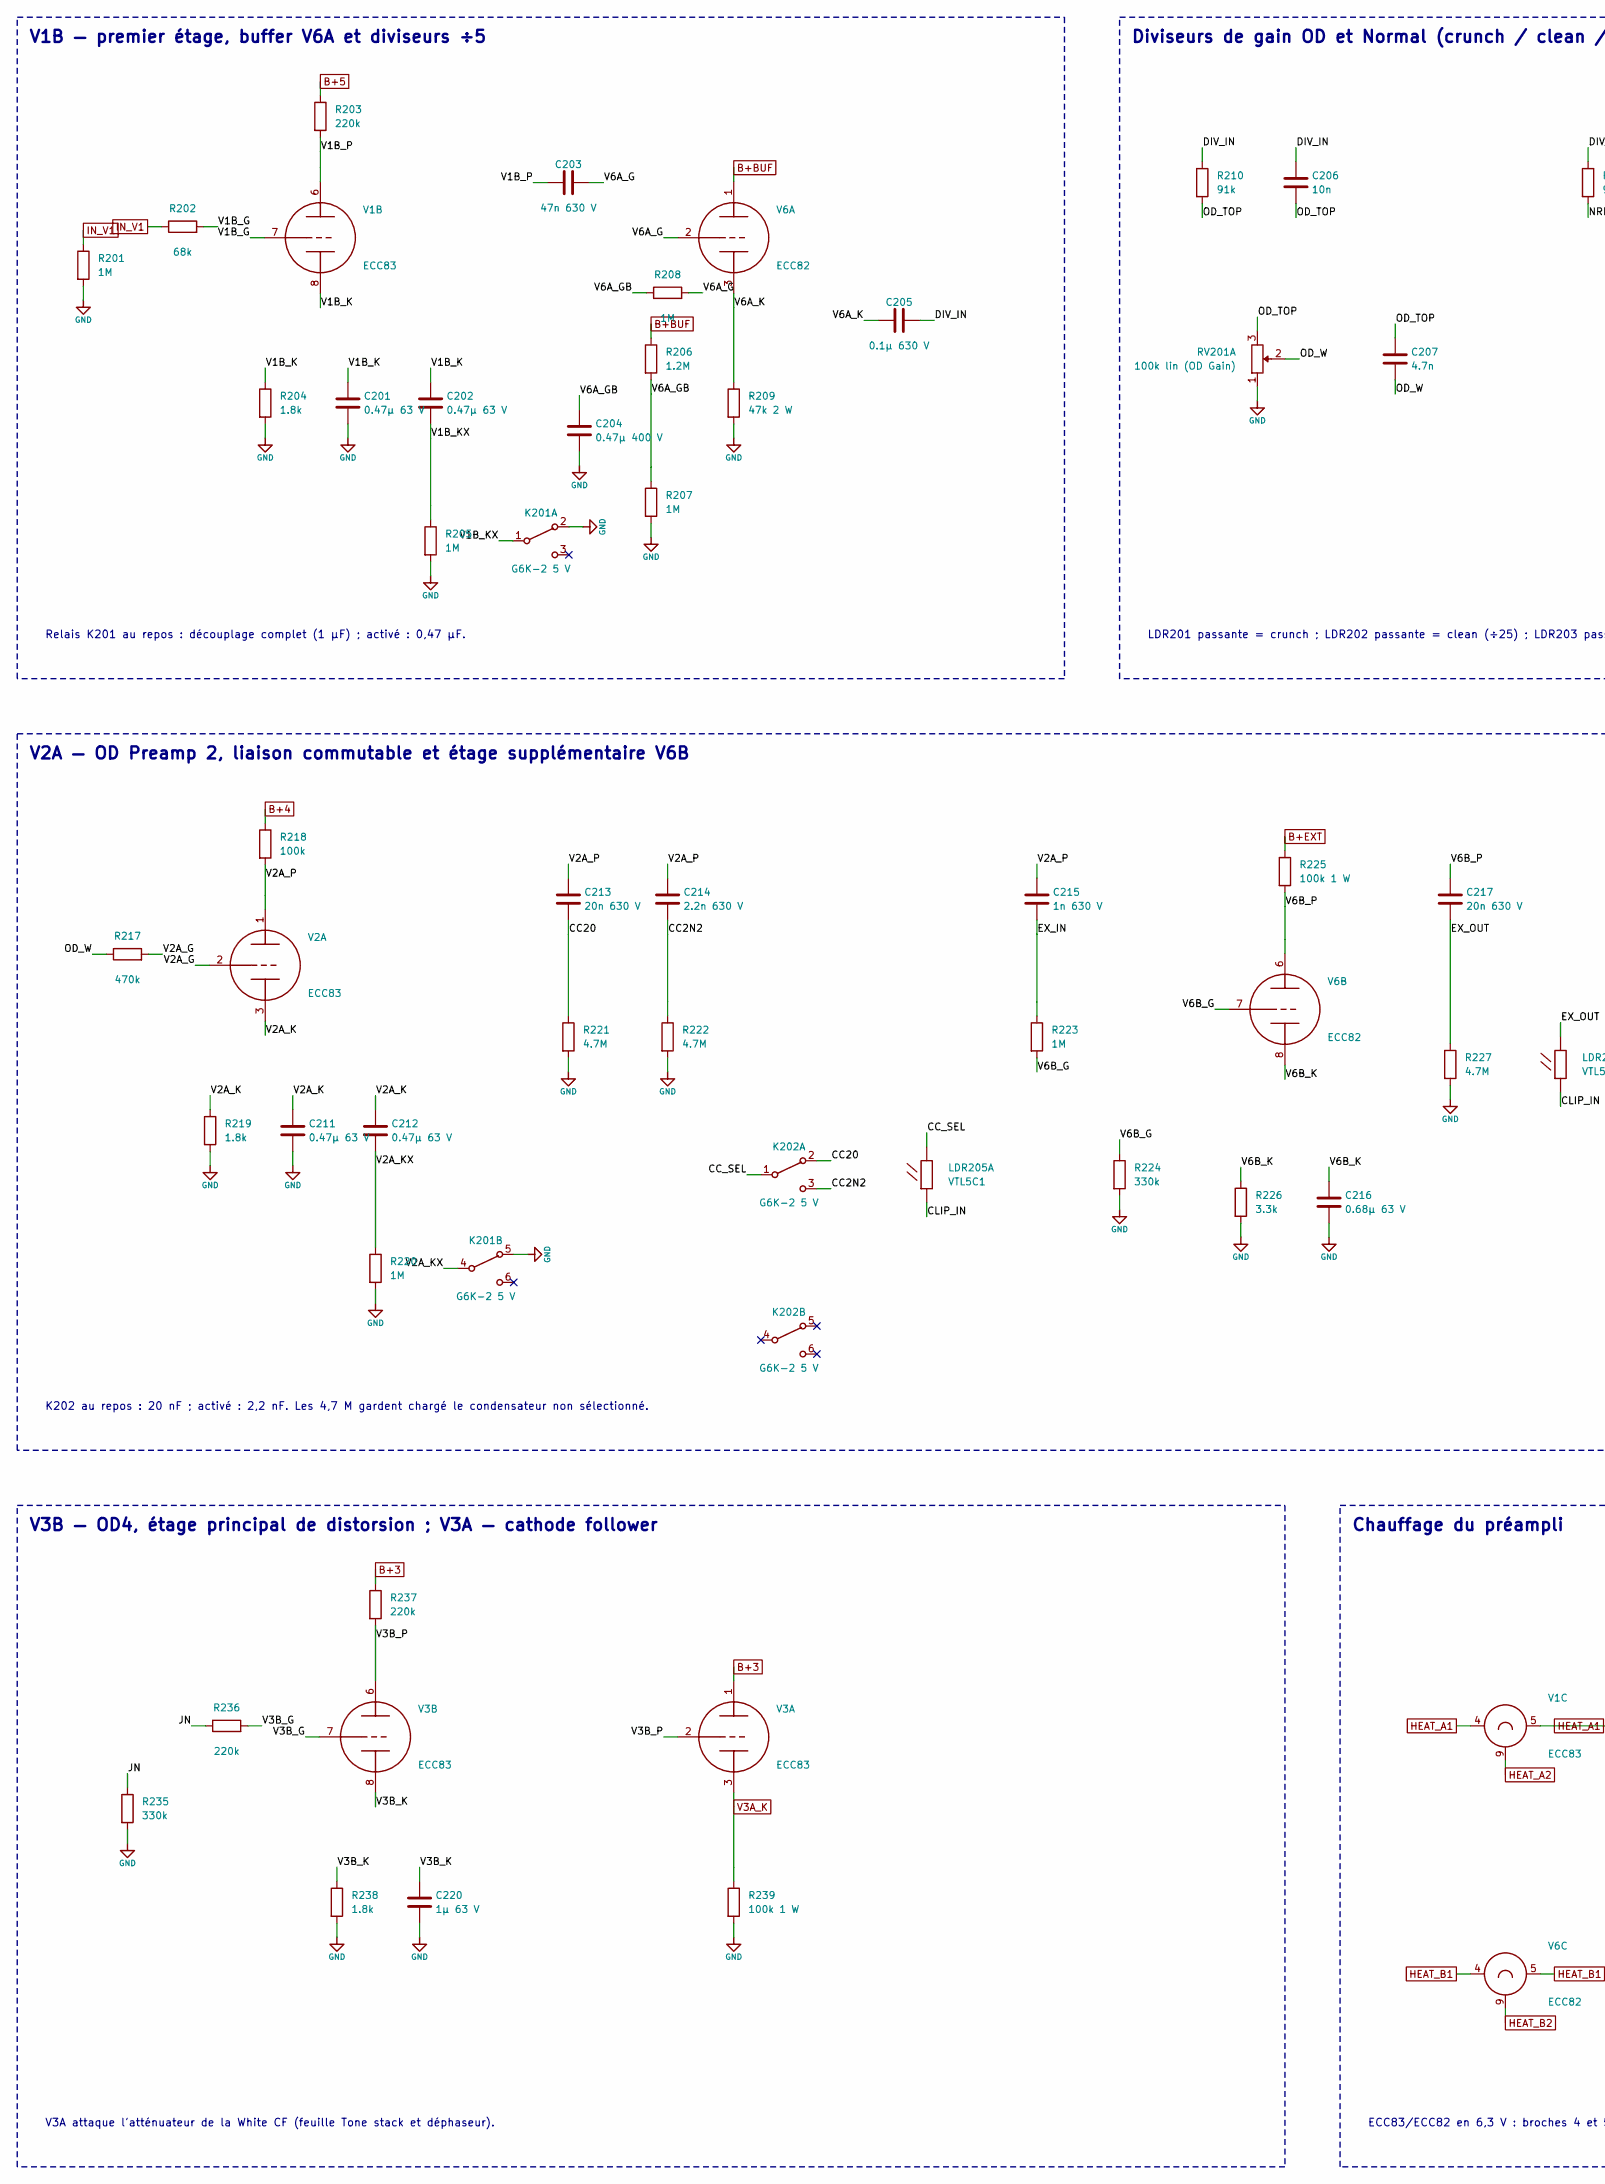
[picture p50: schematic preampli.kicad_sch, part in row 1, column 1]

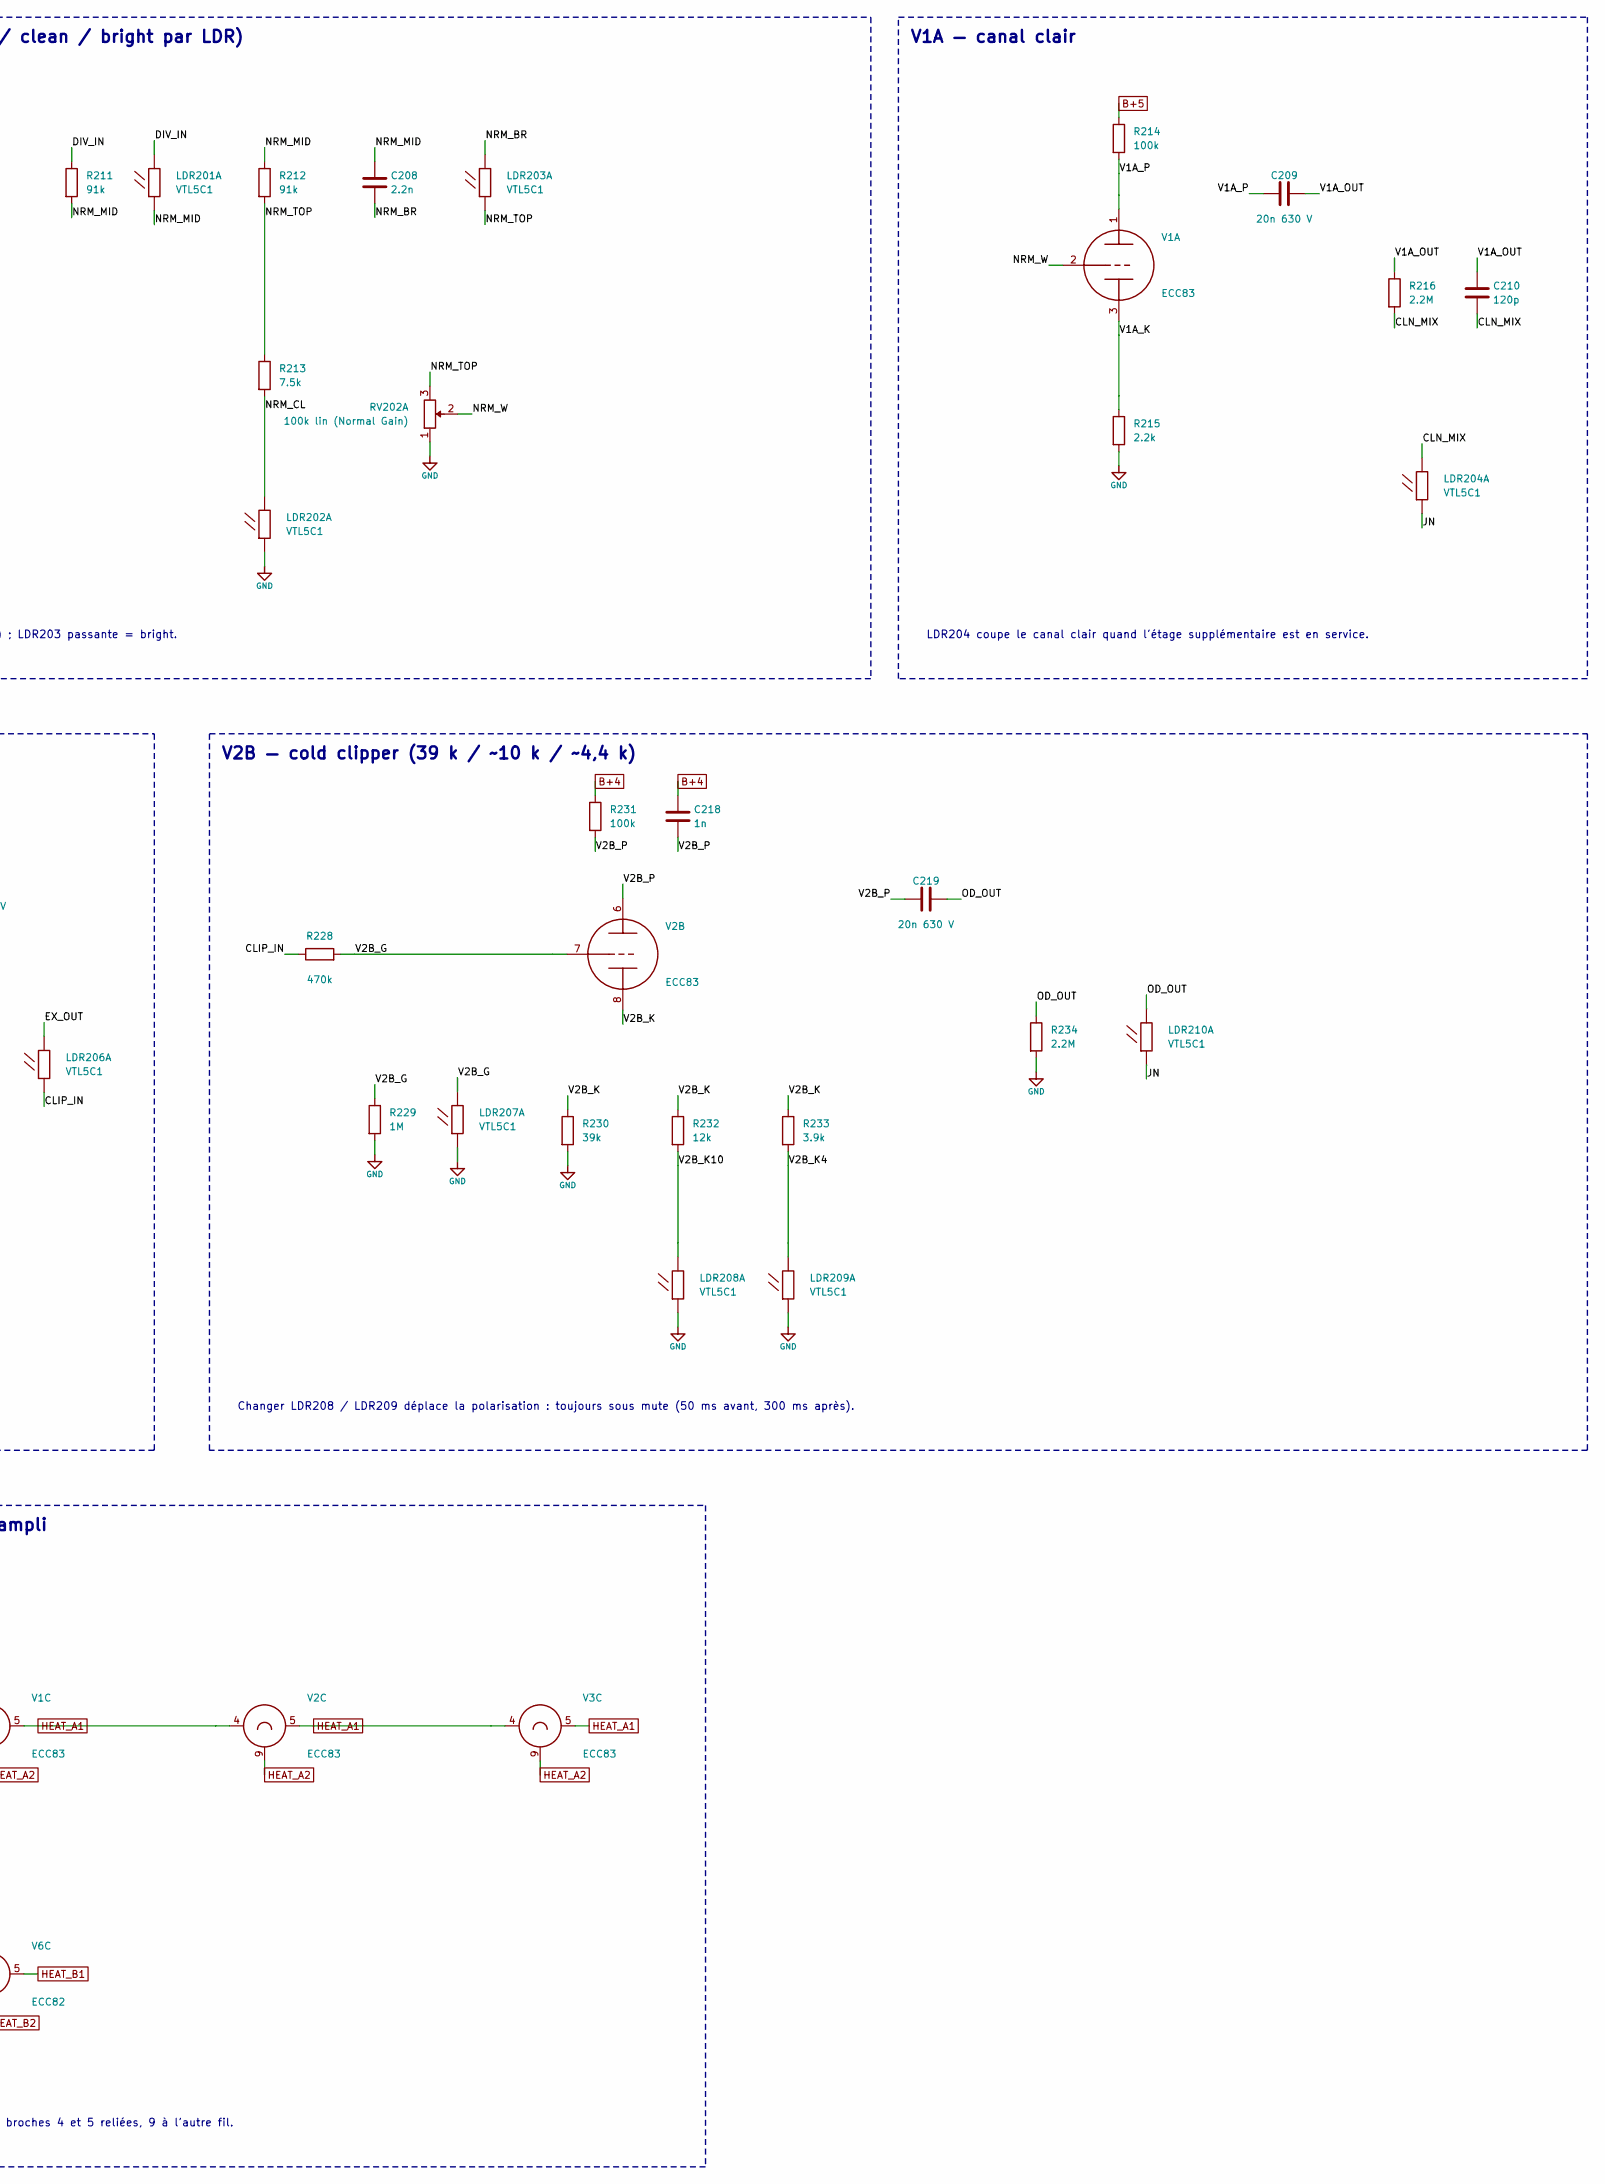
[picture p51: schematic preampli.kicad_sch, part in row 1, column 2]

Parts:
C201, C202, C211, C212: 0.47µ 63 V
C203: 47n 630 V
C204: 0.47µ 400 V
C205: 0.1µ 630 V
C206: 10n
C207: 4.7n
C208: 2.2n
C209, C213, C217, C219: 20n 630 V
C210: 120p
C214: 2.2n 630 V
C215: 1n 630 V
C216: 0.68µ 63 V
C218: 1n
C220: 1µ 63 V
K201, K202: G6K-2 5 V
LDR201, LDR202, LDR203, LDR204, LDR205, LDR206, LDR207, LDR208, LDR209, LDR210: VTL5C1
R201, R205, R207, R208, R220, R223, R229: 1M
R202: 68k
R203, R236, R237: 220k
R204, R219, R238: 1.8k
R206: 1.2M
R209: 47k 2 W
R210, R211, R212: 91k
R213: 7.5k
R214, R218, R231: 100k
R215: 2.2k
R216, R234: 2.2M
R217, R228: 470k
R221, R222, R227: 4.7M
R224, R235: 330k
R225, R239: 100k 1 W
R226: 3.3k
R230: 39k
R232: 12k
R233: 3.9k
RV201: 100k lin (OD Gain)
RV202: 100k lin (Normal Gain)
V1, V2, V3: ECC83
V6: ECC82

Connections:
B+3: R237.1, V3.1
B+4: C218.1, R218.1, R231.1
B+5: R203.1, R214.1
B+BUF: R206.1, V6.1
B+EXT: R225.1
CC2N2: C214.2, K202.3 (NO), R222.1
CC20: C213.2, K202.2 (NC), R221.1
CC_SEL: K202.1 (C), LDR205.3 (R)
CLIP_IN: LDR205.4 (R), LDR206.4 (R), R228.1
CLN_MIX: C210.2, LDR204.3 (R), R216.2
DIV_IN: C205.2, C206.1, LDR201.3 (R), R210.1, R211.1
EX_IN: C215.2, R223.1
EX_OUT: C217.2, LDR206.3 (R), R227.1
GND: C201.2, C204.2, C211.2, C216.2, C220.2, K201.2 (NC), K201.5 (NC), LDR202.4 (R), LDR207.4 (R), LDR208.4 (R), LDR209.4 (R), R201.2, R204.2, R205.2, R207.2, R209.2, R215.2, R219.2, R220.2, R221.2, R222.2, R224.2, R226.2, R227.2, R229.2, R230.2, R234.2, R235.2, R238.2, R239.2, RV201.1, RV202.1
HEAT_A1: V1.4 (F1), V1.5 (F2), V2.4 (F1), V2.5 (F2), V3.4 (F1), V3.5 (F2)
HEAT_A2: V1.9 (CT), V2.9 (CT), V3.9 (CT)
HEAT_B1: V6.4 (F1), V6.5 (F2)
HEAT_B2: V6.9 (CT)
IN_V1: R201.1, R202.1
JN: LDR204.4 (R), LDR210.4 (R), R235.1, R236.1
NRM_BR: C208.2, LDR203.3 (R)
NRM_CL: LDR202.3 (R), R213.2
NRM_MID: C208.1, LDR201.4 (R), R211.2, R212.1
NRM_TOP: LDR203.4 (R), R212.2, R213.1, RV202.3
NRM_W: RV202.2 (W), V1.2 (G)
OD_OUT: C219.2, LDR210.3 (R), R234.1
OD_TOP: C206.2, C207.1, R210.2, RV201.3
OD_W: C207.2, R217.1, RV201.2 (W)
V1A_K: R215.1, V1.3 (K)
V1A_OUT: C209.2, C210.1, R216.1
V1A_P: C209.1, R214.2, V1.1
V1B_G: R202.2, V1.7 (G)
V1B_K: C201.1, C202.1, R204.1, V1.8 (K)
V1B_KX: C202.2, K201.1 (C), R205.1
V1B_P: C203.1, R203.2, V1.6
V2A_G: R217.2, V2.2 (G)
V2A_K: C211.1, C212.1, R219.1, V2.3 (K)
V2A_KX: C212.2, K201.4 (C), R220.1
V2A_P: C213.1, C214.1, C215.1, R218.2, V2.1
V2B_G: LDR207.3 (R), R228.2, R229.1, V2.7 (G)
V2B_K: R230.1, R232.1, R233.1, V2.8 (K)
V2B_K4: LDR209.3 (R), R233.2
V2B_K10: LDR208.3 (R), R232.2
V2B_P: C218.2, C219.1, R231.2, V2.6
V3A_K: R239.1, V3.3 (K)
V3B_G: R236.2, V3.7 (G)
V3B_K: C220.1, R238.1, V3.8 (K)
V3B_P: R237.2, V3.2 (G), V3.6
V6A_G: C203.2, R208.2, V6.2 (G)
V6A_GB: C204.1, R206.2, R207.1, R208.1
V6A_K: C205.1, R209.1, V6.3 (K)
V6B_G: R223.2, R224.1, V6.7 (G)
V6B_K: C216.1, R226.1, V6.8 (K)
V6B_P: C217.1, R225.2, V6.6

Notes on the sheet:
Relais K201 au repos : découplage complet (1 µF) ; activé : 0,47 µF.
LDR201 passante = crunch ; LDR202 passante = clean (÷25) ; LDR203 passante = bright.
LDR204 coupe le canal clair quand l'étage supplémentaire est en service.
K202 au repos : 20 nF ; activé : 2,2 nF. Les 4,7 M gardent chargé le condensateur non sélectionné.
Changer LDR208 / LDR209 déplace la polarisation : toujours sous mute (50 ms avant, 300 ms après).
V3A attaque l'atténuateur de la White CF (feuille Tone stack et déphaseur).
ECC83/ECC82 en 6,3 V : broches 4 et 5 reliées, 9 à l'autre fil.
V1B — premier étage, buffer V6A et diviseurs ÷5
Diviseurs de gain OD et Normal (crunch / clean / bright par LDR)
V1A — canal clair
V2A — OD Preamp 2, liaison commutable et étage supplémentaire V6B
V2B — cold clipper (39 k / ~10 k / ~4,4 k)
V3B — OD4, étage principal de distorsion ; V3A — cathode follower
Chauffage du préampli
