Arnwald/slo-pilote/kicad/slo-pilote/puissance.kicad_sch

## KiCad design kicad/slo-pilote/puissance.kicad_sch (2026-11-08)

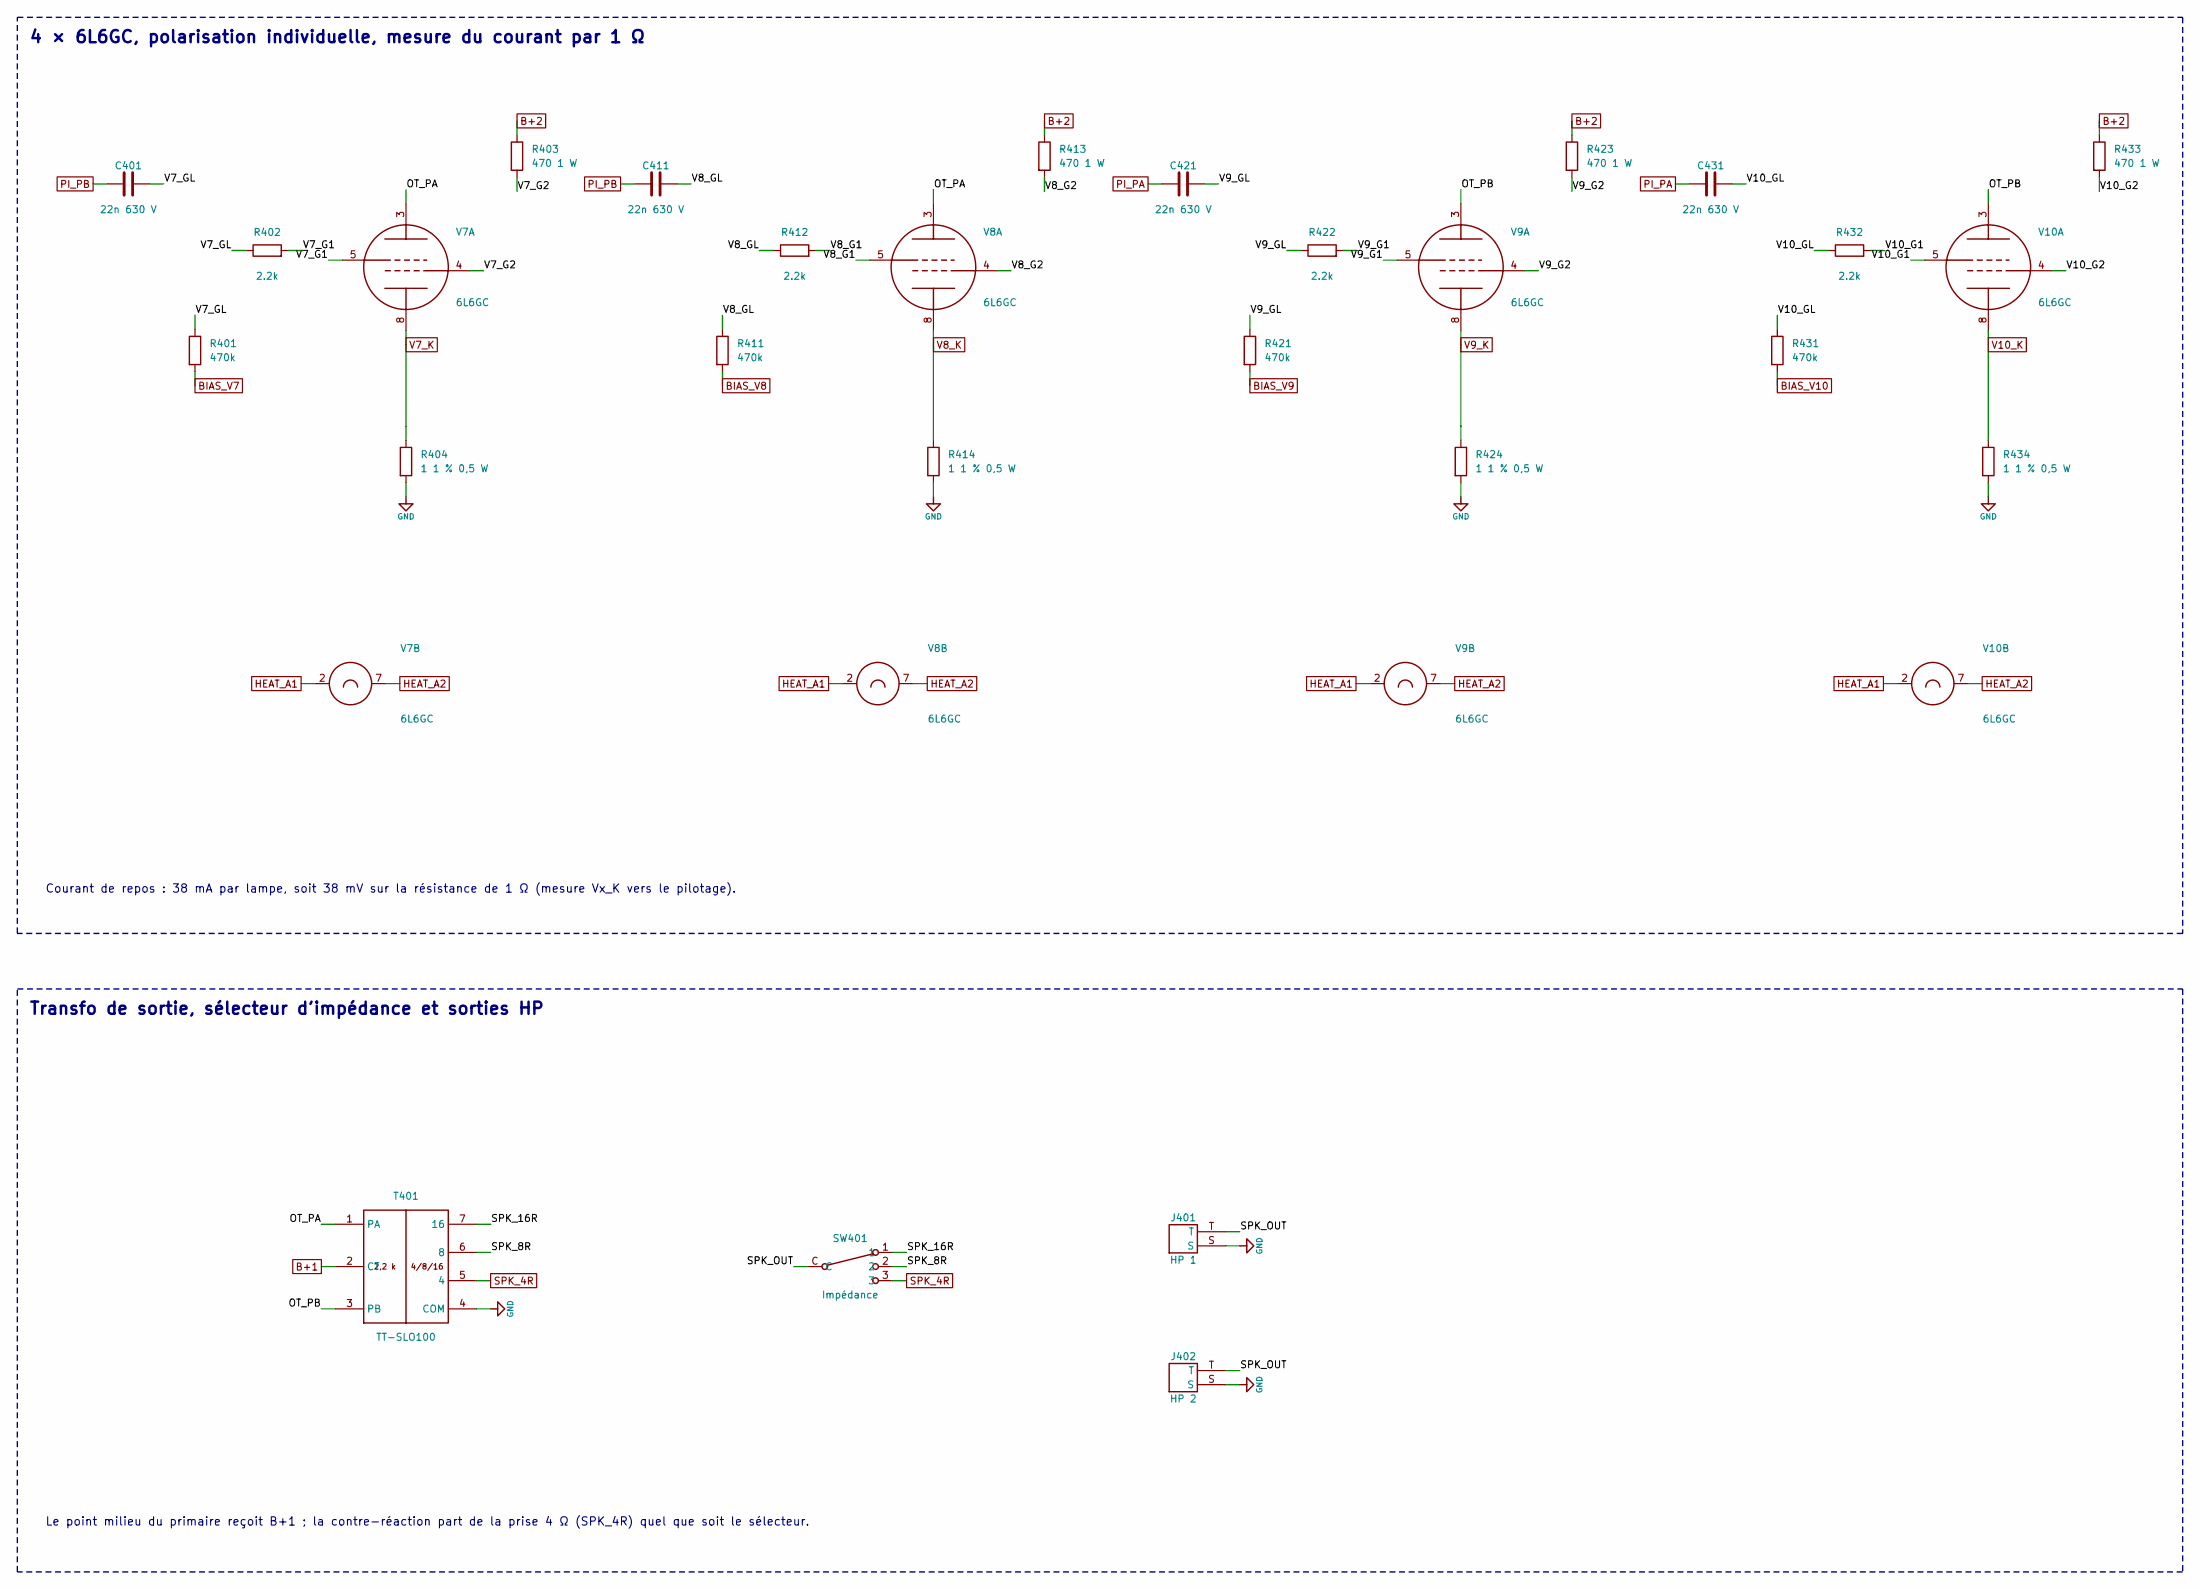
[picture p52: schematic puissance.kicad_sch]

Parts:
C401, C411, C421, C431: 22n 630 V
J401: HP 1
J402: HP 2
R401, R411, R421, R431: 470k
R402, R412, R422, R432: 2.2k
R403, R413, R423, R433: 470 1 W
R404, R414, R424, R434: 1 1 % 0,5 W
SW401: Impédance
T401: TT-SLO100
V7, V8, V9, V10: 6L6GC

Connections:
B+1: T401.2 (CT)
B+2: R403.1, R413.1, R423.1, R433.1
BIAS_V7: R401.2
BIAS_V8: R411.2
BIAS_V9: R421.2
BIAS_V10: R431.2
GND: J401.S, J402.S, R404.2, R414.2, R424.2, R434.2, T401.4 (COM)
HEAT_A1: V7.2 (F1), V8.2 (F1), V9.2 (F1), V10.2 (F1)
HEAT_A2: V7.7 (F2), V8.7 (F2), V9.7 (F2), V10.7 (F2)
OT_PA: T401.1 (PA), V7.3, V8.3
OT_PB: T401.3 (PB), V9.3, V10.3
PI_PA: C421.1, C431.1
PI_PB: C401.1, C411.1
SPK_4R: SW401.3, T401.5 (4)
SPK_8R: SW401.2, T401.6 (8)
SPK_16R: SW401.1, T401.7 (16)
SPK_OUT: J401.T, J402.T, SW401.C
V7_G1: R402.2, V7.5 (G1)
V7_G2: R403.2, V7.4 (G2)
V7_GL: C401.2, R401.1, R402.1
V7_K: R404.1, V7.8 (K)
V8_G1: R412.2, V8.5 (G1)
V8_G2: R413.2, V8.4 (G2)
V8_GL: C411.2, R411.1, R412.1
V8_K: R414.1, V8.8 (K)
V9_G1: R422.2, V9.5 (G1)
V9_G2: R423.2, V9.4 (G2)
V9_GL: C421.2, R421.1, R422.1
V9_K: R424.1, V9.8 (K)
V10_G1: R432.2, V10.5 (G1)
V10_G2: R433.2, V10.4 (G2)
V10_GL: C431.2, R431.1, R432.1
V10_K: R434.1, V10.8 (K)

Notes on the sheet:
Courant de repos : 38 mA par lampe, soit 38 mV sur la résistance de 1 Ω (mesure Vx_K vers le pilotage).
Le point milieu du primaire reçoit B+1 ; la contre-réaction part de la prise 4 Ω (SPK_4R) quel que soit le sélecteur.
4 × 6L6GC, polarisation individuelle, mesure du courant par 1 Ω
Transfo de sortie, sélecteur d'impédance et sorties HP
