Arnwald/slo-pilote/kicad/slo-pilote/tone_pi.kicad_sch

## KiCad design kicad/slo-pilote/tone_pi.kicad_sch (2026-11-08)

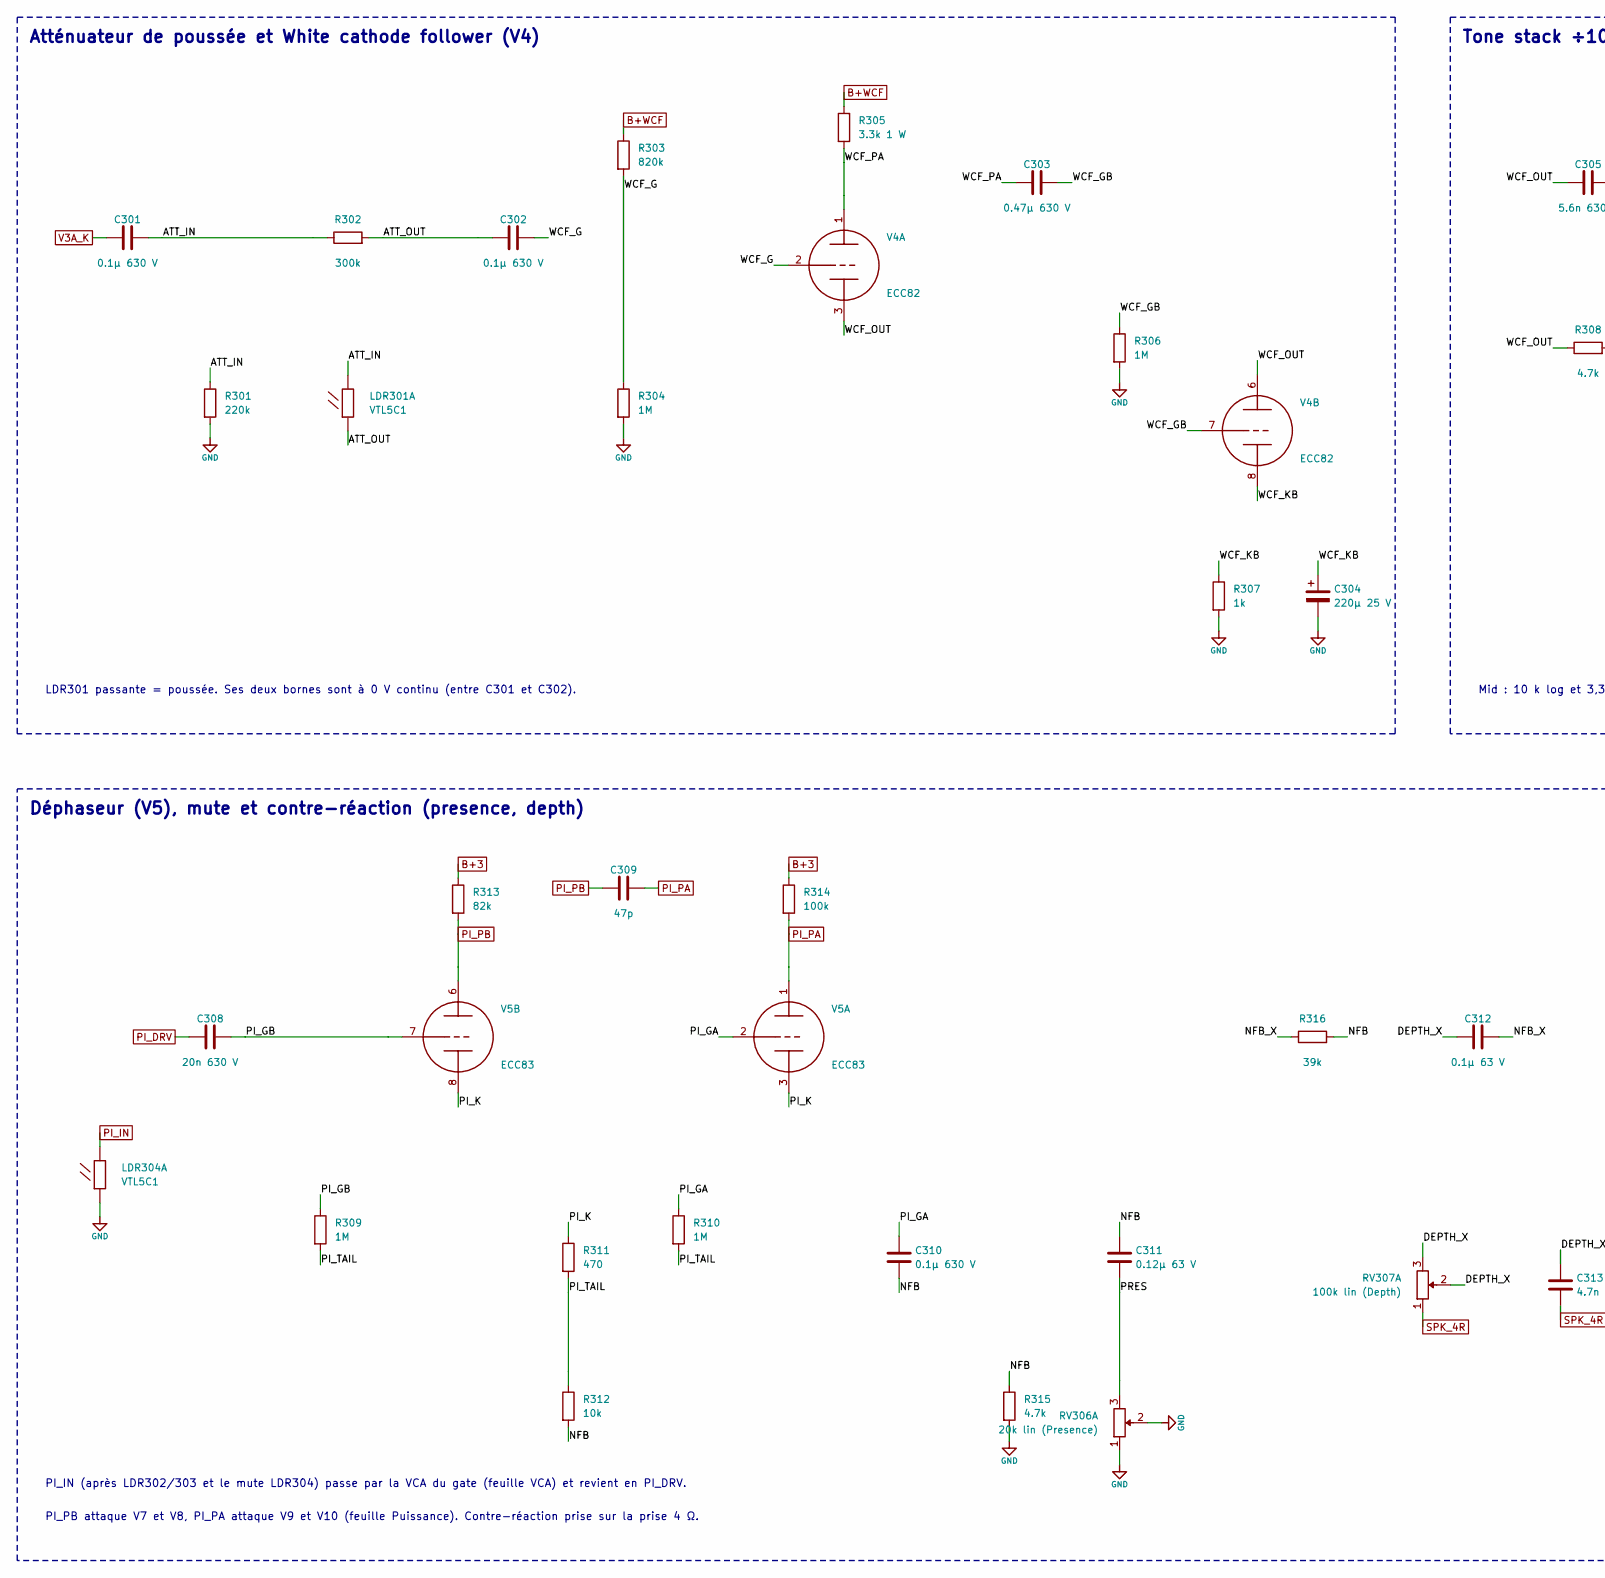
[picture p53: schematic tone_pi.kicad_sch, part in row 1, column 1]

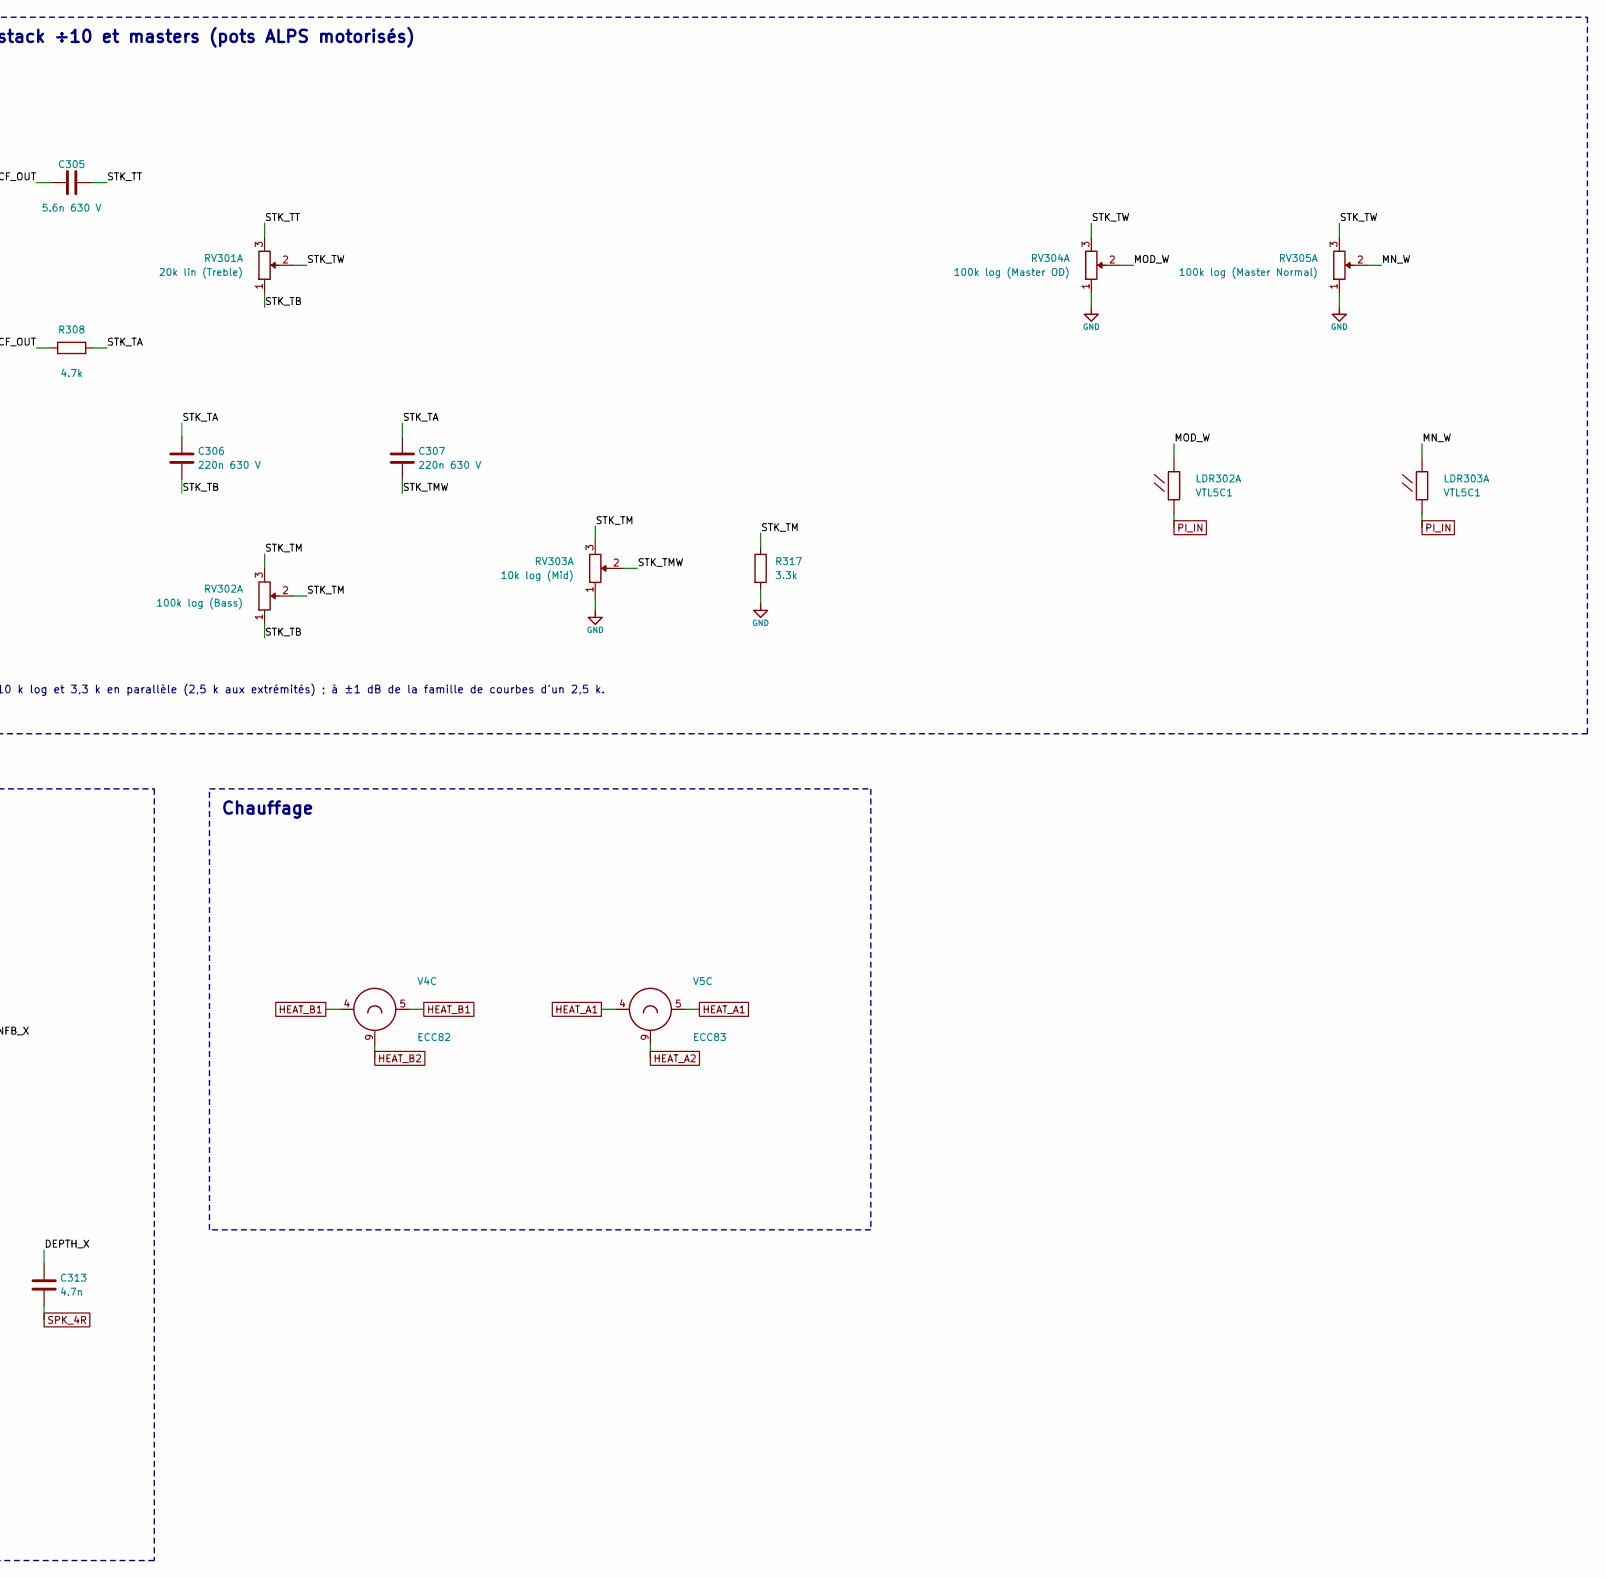
[picture p54: schematic tone_pi.kicad_sch, part in row 1, column 2]

Parts:
C301, C302, C310: 0.1µ 630 V
C303: 0.47µ 630 V
C304: 220µ 25 V
C305: 5.6n 630 V
C306, C307: 220n 630 V
C308: 20n 630 V
C309: 47p
C311: 0.12µ 63 V
C312: 0.1µ 63 V
C313: 4.7n
LDR301, LDR302, LDR303, LDR304: VTL5C1
R301: 220k
R302: 300k
R303: 820k
R304, R306, R309, R310: 1M
R305: 3.3k 1 W
R307: 1k
R308, R315: 4.7k
R311: 470
R312: 10k
R313: 82k
R314: 100k
R316: 39k
R317: 3.3k
RV301: 20k lin (Treble)
RV302: 100k log (Bass)
RV303: 10k log (Mid)
RV304: 100k log (Master OD)
RV305: 100k log (Master Normal)
RV306: 20k lin (Presence)
RV307: 100k lin (Depth)
V4: ECC82
V5: ECC83

Connections:
ATT_IN: C301.2, LDR301.3 (R), R301.1, R302.1
ATT_OUT: C302.1, LDR301.4 (R), R302.2
B+3: R313.1, R314.1
B+WCF: R303.1, R305.1
DEPTH_X: C312.1, C313.1, RV307.2 (W), RV307.3
GND: C304.2 (-), LDR304.4 (R), R301.2, R304.2, R306.2, R307.2, R315.2, R317.2, RV303.1, RV304.1, RV305.1, RV306.1, RV306.2 (W)
HEAT_A1: V5.4 (F1), V5.5 (F2)
HEAT_A2: V5.9 (CT)
HEAT_B1: V4.4 (F1), V4.5 (F2)
HEAT_B2: V4.9 (CT)
MN_W: LDR303.3 (R), RV305.2 (W)
MOD_W: LDR302.3 (R), RV304.2 (W)
NFB: C310.2, C311.1, R312.2, R315.1, R316.2
NFB_X: C312.2, R316.1
PI_DRV: C308.1
PI_GA: C310.1, R310.1, V5.2 (G)
PI_GB: C308.2, R309.1, V5.7 (G)
PI_IN: LDR302.4 (R), LDR303.4 (R), LDR304.3 (R)
PI_K: R311.1, V5.3 (K), V5.8 (K)
PI_PA: C309.2, R314.2, V5.1
PI_PB: C309.1, R313.2, V5.6
PI_TAIL: R309.2, R310.2, R311.2, R312.1
PRES: C311.2, RV306.3
SPK_4R: C313.2, RV307.1
STK_TA: C306.1, C307.1, R308.2
STK_TB: C306.2, RV301.1, RV302.1
STK_TM: R317.1, RV302.2 (W), RV302.3, RV303.3
STK_TMW: C307.2, RV303.2 (W)
STK_TT: C305.2, RV301.3
STK_TW: RV301.2 (W), RV304.3, RV305.3
V3A_K: C301.1
WCF_G: C302.2, R303.2, R304.1, V4.2 (G)
WCF_GB: C303.2, R306.1, V4.7 (G)
WCF_KB: C304.1 (+), R307.1, V4.8 (K)
WCF_OUT: C305.1, R308.1, V4.3 (K), V4.6
WCF_PA: C303.1, R305.2, V4.1

Notes on the sheet:
LDR301 passante = poussée. Ses deux bornes sont à 0 V continu (entre C301 et C302).
Mid : 10 k log et 3,3 k en parallèle (2,5 k aux extrémités) ; à ±1 dB de la famille de courbes d'un 2,5 k.
PI_PB attaque V7 et V8, PI_PA attaque V9 et V10 (feuille Puissance). Contre-réaction prise sur la prise 4 Ω.
PI_IN (après LDR302/303 et le mute LDR304) passe par la VCA du gate (feuille VCA) et revient en PI_DRV.
Atténuateur de poussée et White cathode follower (V4)
Tone stack ÷10 et masters (pots ALPS motorisés)
Déphaseur (V5), mute et contre-réaction (presence, depth)
Chauffage
