Arnwald/slo-pilote/kicad/slo-pilote/vca_gate.kicad_sch

## KiCad design kicad/slo-pilote/vca_gate.kicad_sch (2026-11-08)

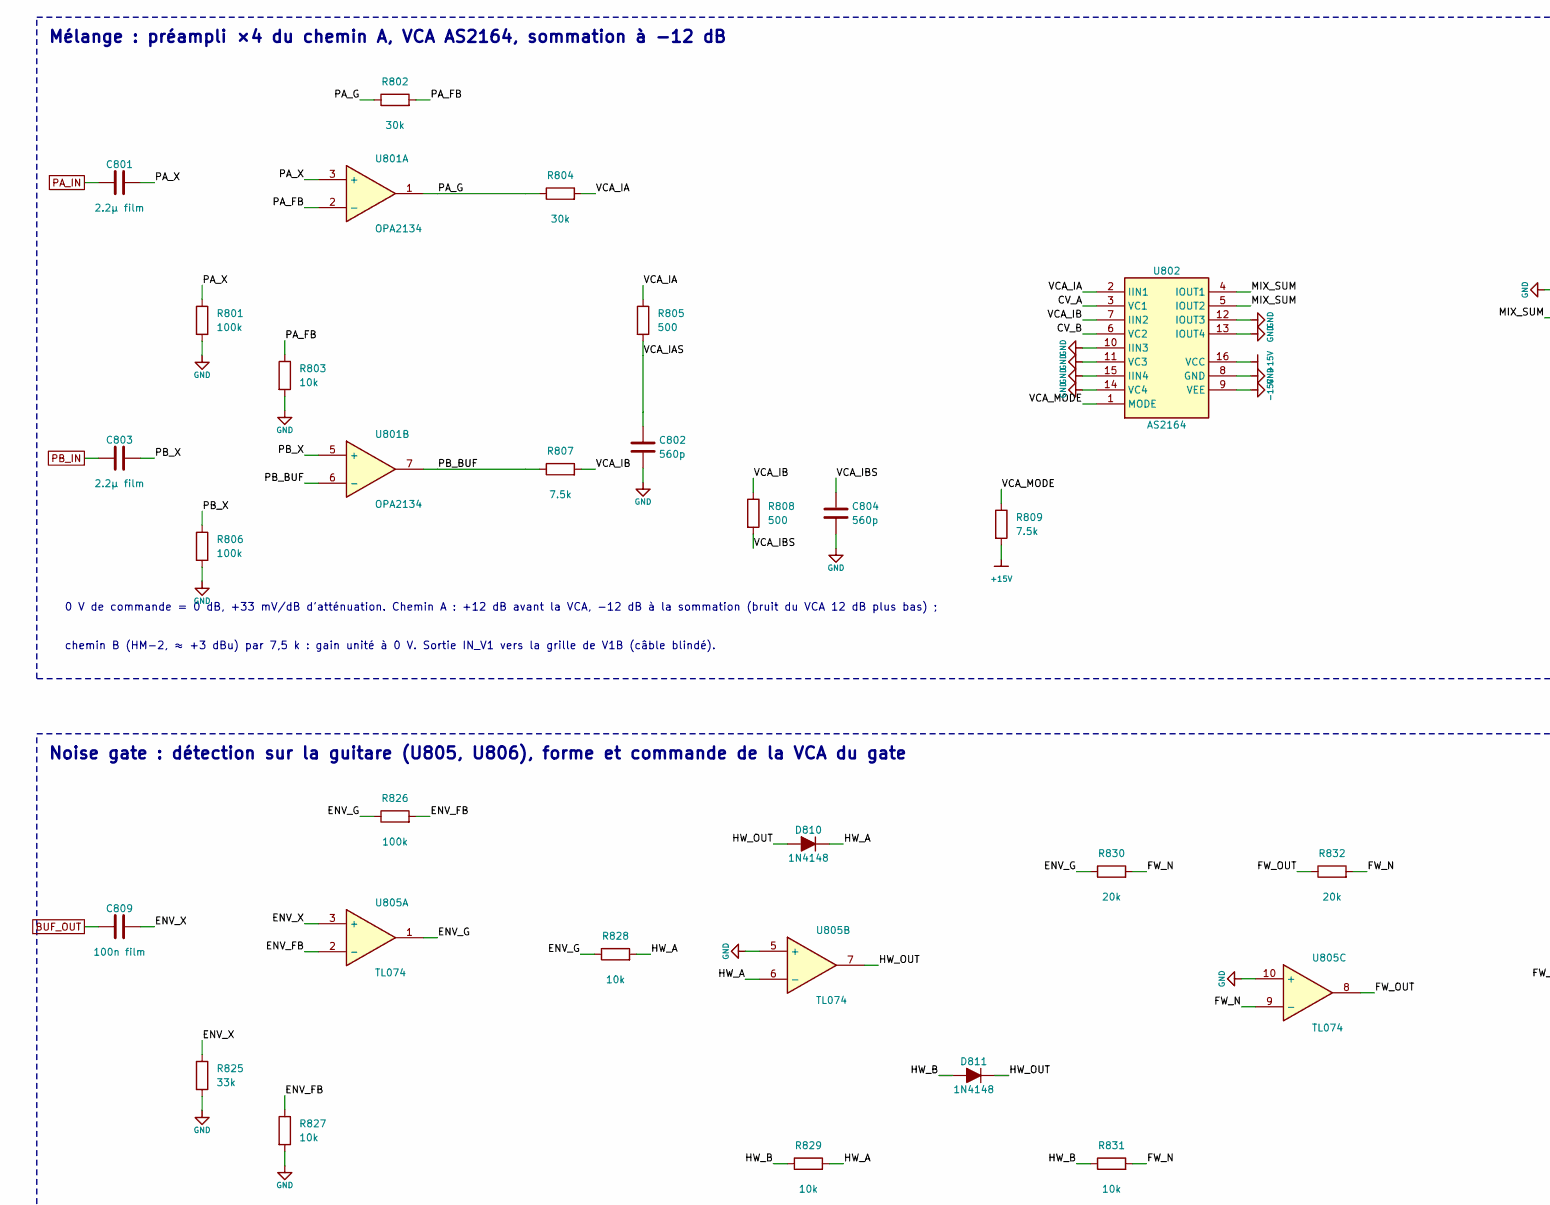
[picture p55: schematic vca_gate.kicad_sch, part in row 1, column 1]

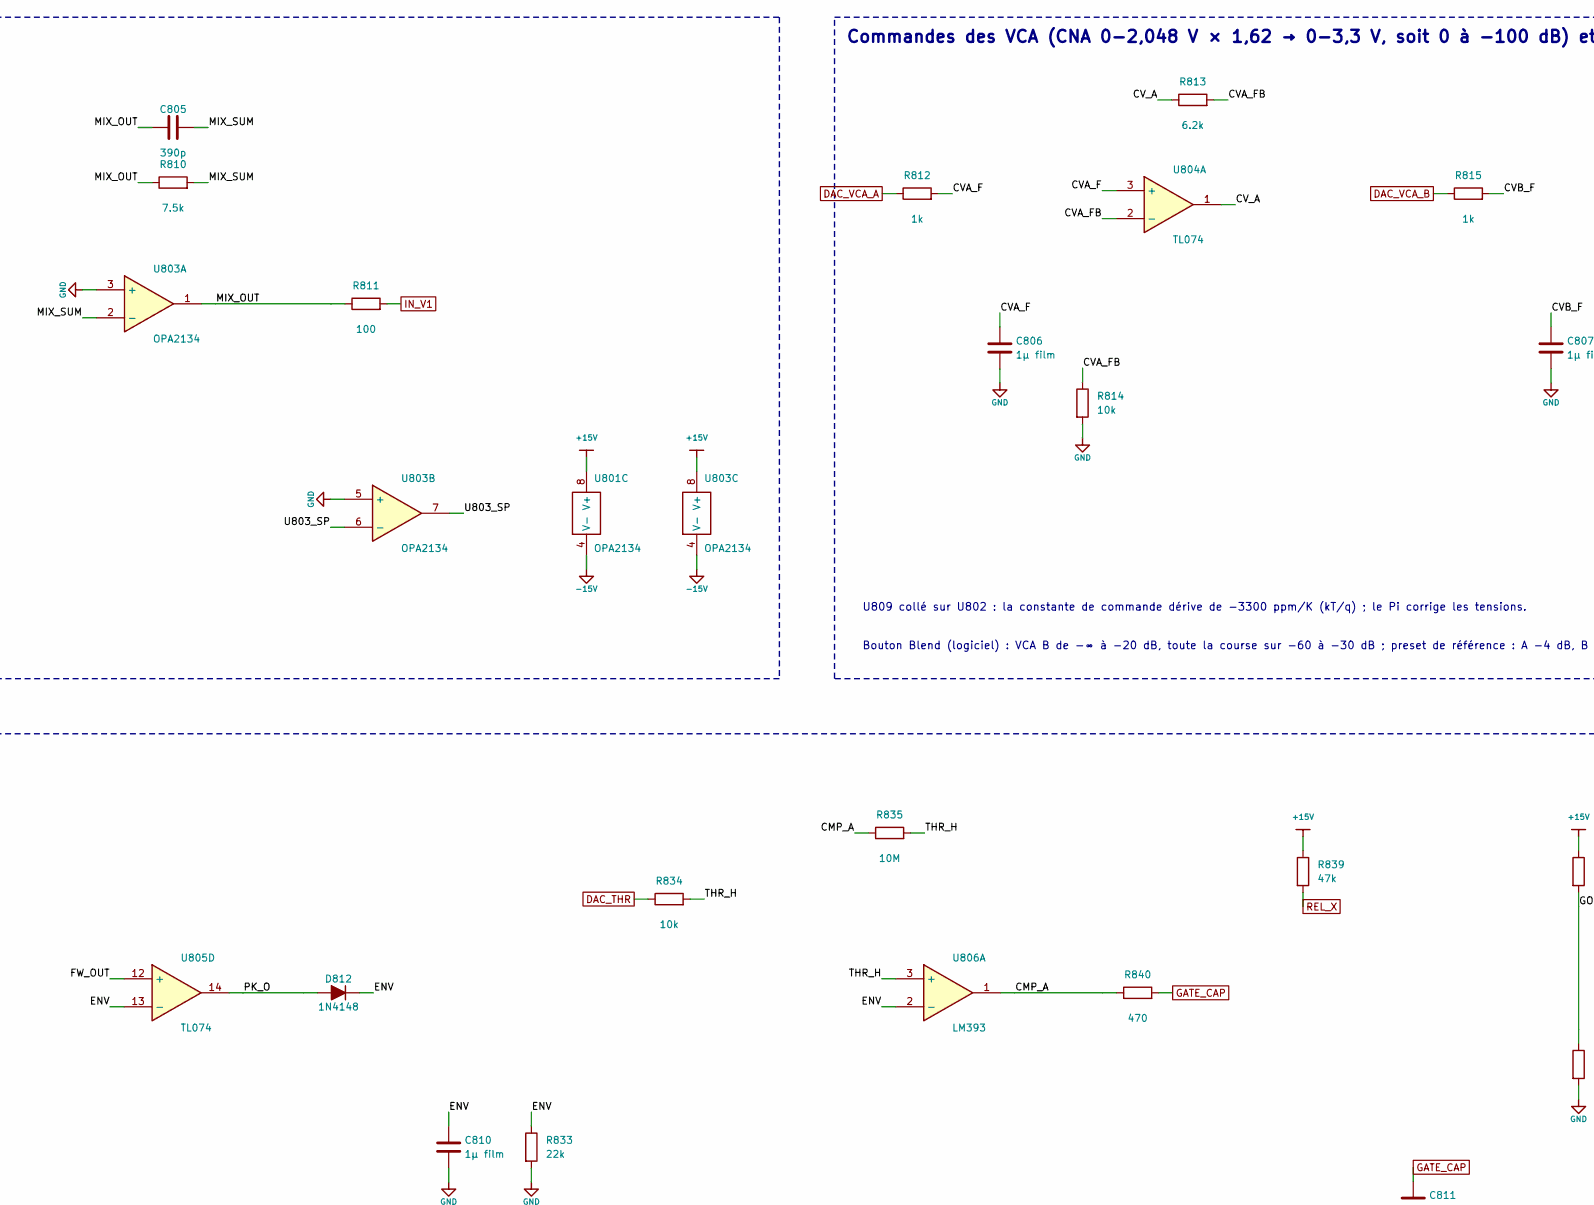
[picture p56: schematic vca_gate.kicad_sch, part in row 1, column 2]

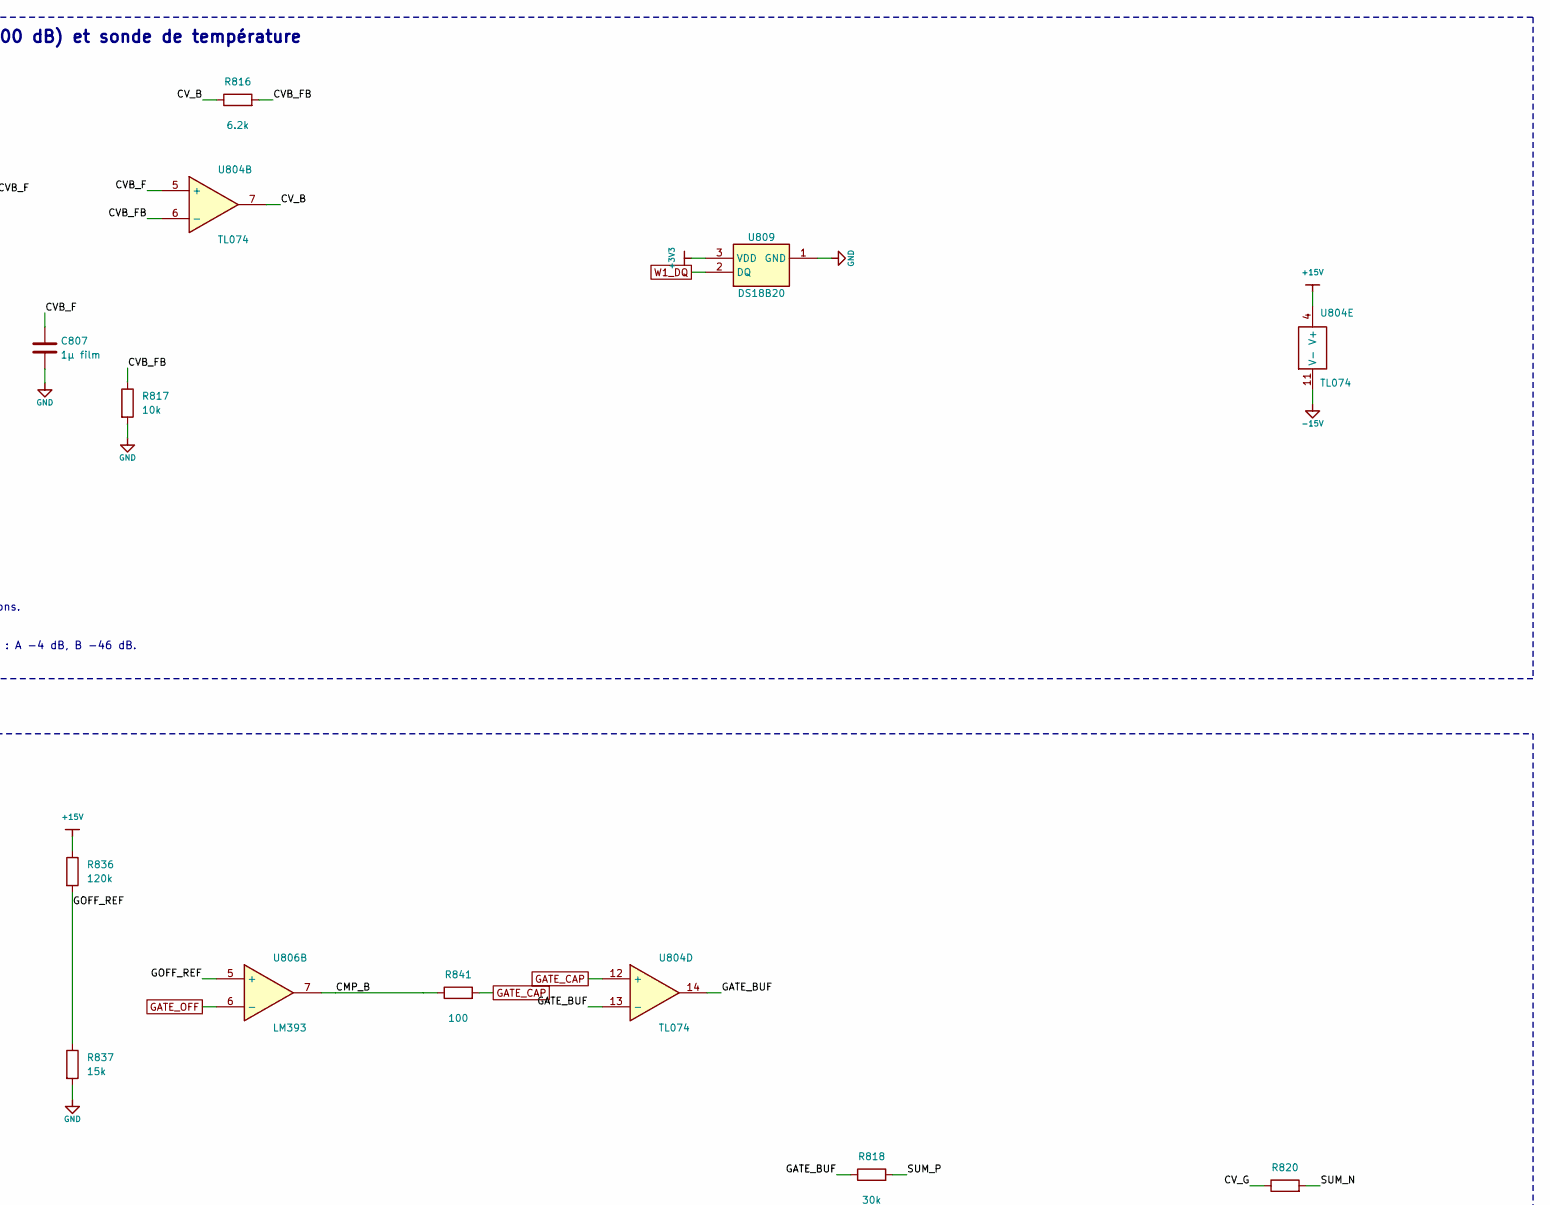
[picture p57: schematic vca_gate.kicad_sch, part in row 1, column 3]

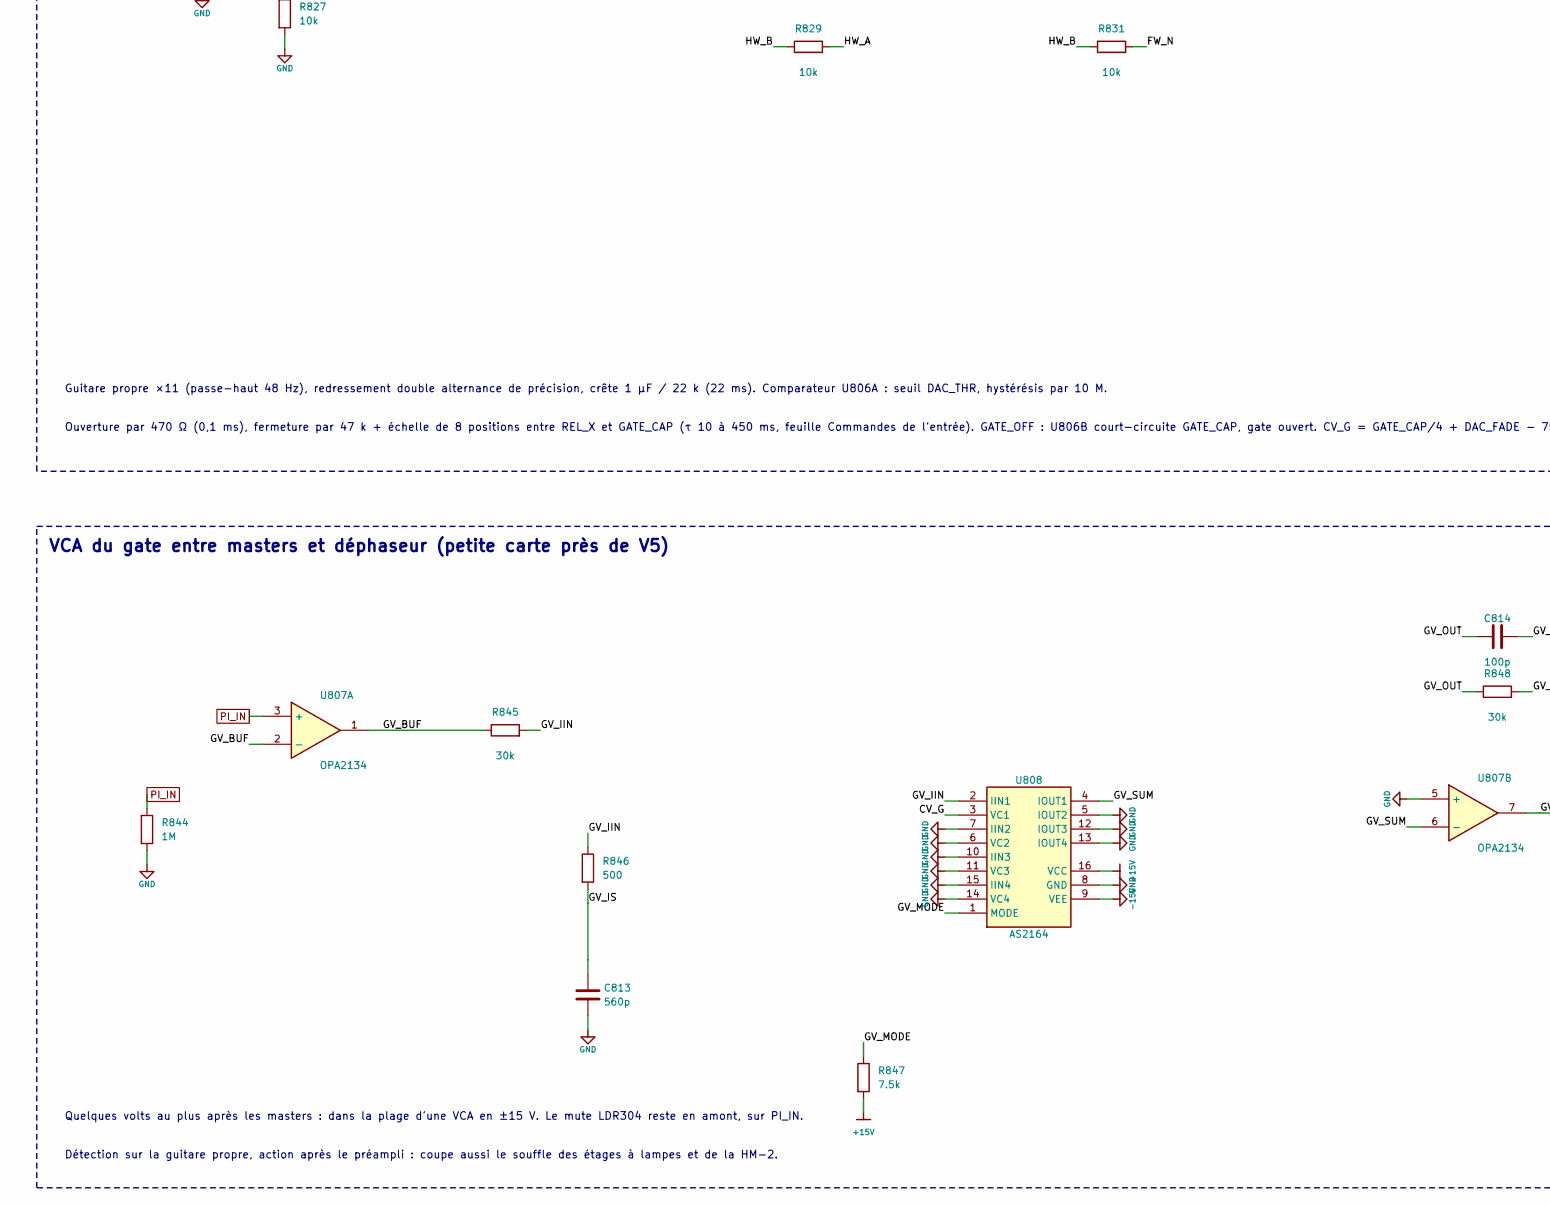
[picture p58: schematic vca_gate.kicad_sch, part in row 2, column 1]

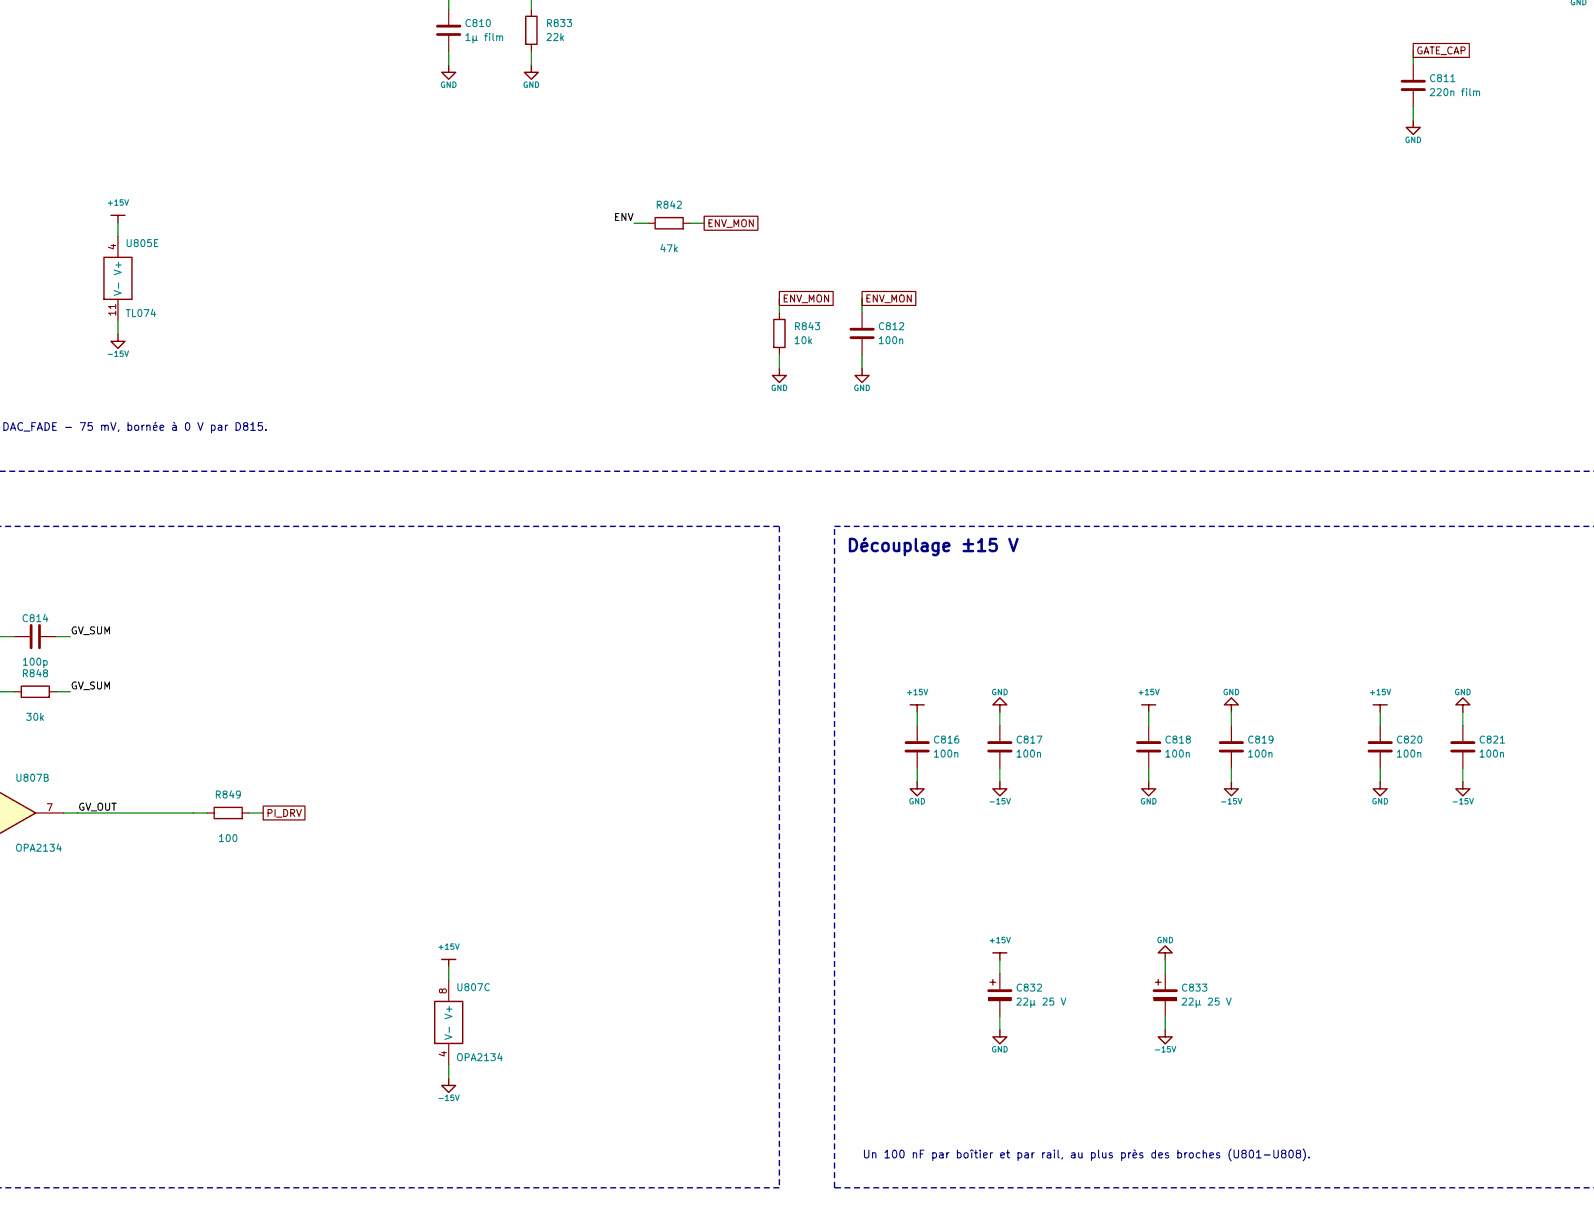
[picture p59: schematic vca_gate.kicad_sch, part in row 2, column 2]

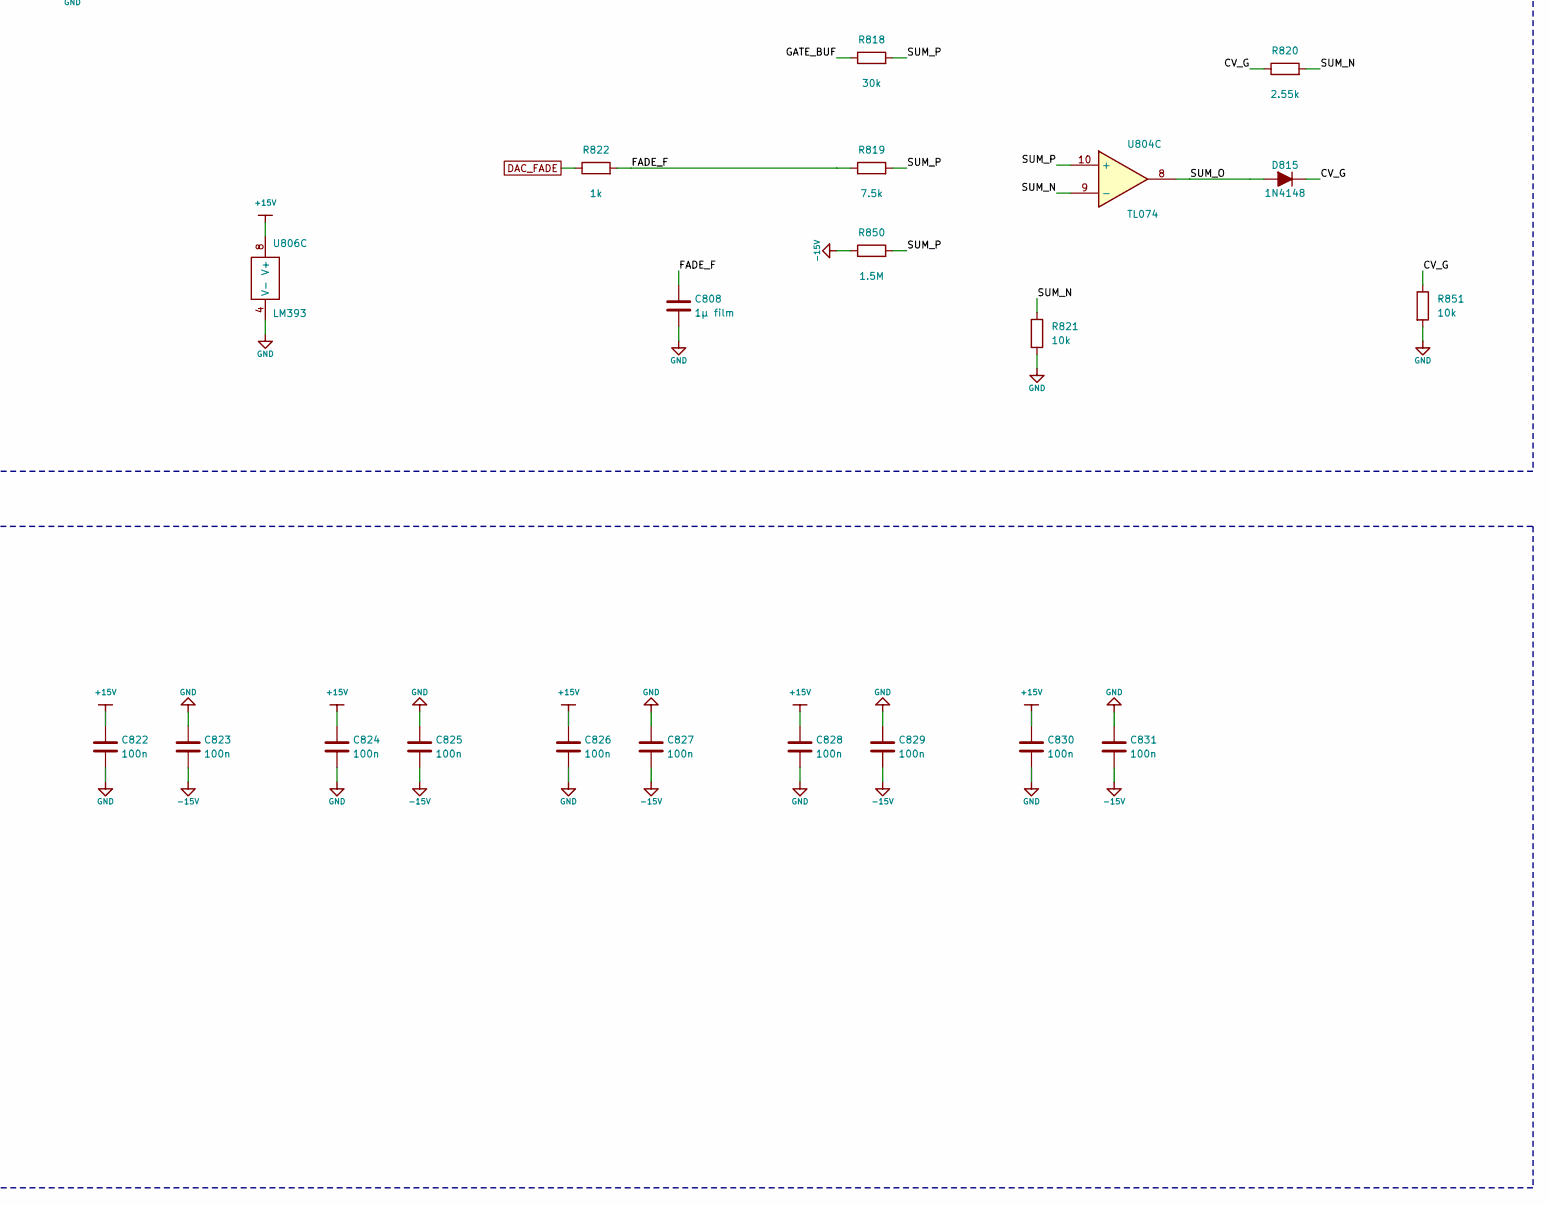
[picture p60: schematic vca_gate.kicad_sch, part in row 2, column 3]

Parts:
C801, C803: 2.2µ film
C802, C804, C813: 560p
C805: 390p
C806, C807, C808, C810: 1µ film
C809: 100n film
C811: 220n film
C812, C816, C817, C818, C819, C820, C821, C822, C823, C824, C825, C826, C827, C828, C829, C830, C831: 100n
C814: 100p
C832, C833: 22µ 25 V
D810, D811, D812, D815: 1N4148
R801, R806, R826: 100k
R802, R804, R818, R845, R848: 30k
R803, R814, R817, R821, R827, R828, R829, R831, R834, R843, R851: 10k
R805, R808, R846: 500
R807, R809, R810, R819, R847: 7.5k
R811, R841, R849: 100
R812, R815, R822: 1k
R813, R816: 6.2k
R820: 2.55k
R825: 33k
R830, R832: 20k
R833: 22k
R835: 10M
R836: 120k
R837: 15k
R839, R842: 47k
R840: 470
R844: 1M
R850: 1.5M
U801, U803, U807: OPA2134
U802, U808: AS2164
U804, U805: TL074
U806: LM393
U809: DS18B20

Connections:
+3V3: U809.3 (VDD)
+15V: C816.1, C818.1, C820.1, C822.1, C824.1, C826.1, C828.1, C830.1, C832.1 (+), R809.2, R836.1, R839.1, R847.2, U801.8 (V+), U802.16 (VCC), U803.8 (V+), U804.4 (V+), U805.4 (V+), U806.8 (V+), U807.8 (V+), U808.16 (VCC)
-15V: C817.2, C819.2, C821.2, C823.2, C825.2, C827.2, C829.2, C831.2, C833.2 (-), R850.1, U801.4 (V-), U802.9 (VEE), U803.4 (V-), U804.11 (V-), U805.11 (V-), U807.4 (V-), U808.9 (VEE)
BUF_OUT: C809.1
CMP_A: R835.1, R840.1, U806.1
CMP_B: R841.1, U806.7
CVA_F: C806.1, R812.2, U804.3 (+)
CVA_FB: R813.2, R814.1, U804.2 (-)
CVB_F: C807.1, R815.2, U804.5 (+)
CVB_FB: R816.2, R817.1, U804.6 (-)
CV_A: R813.1, U802.3 (VC1), U804.1
CV_B: R816.1, U802.6 (VC2), U804.7
CV_G: D815.2 (K), R820.1, R851.1, U808.3 (VC1)
DAC_FADE: R822.1
DAC_THR: R834.1
DAC_VCA_A: R812.1
DAC_VCA_B: R815.1
ENV: C810.1, D812.2 (K), R833.1, R842.1, U805.13 (-), U806.2 (-)
ENV_FB: R826.2, R827.1, U805.2 (-)
ENV_G: R826.1, R828.1, R830.1, U805.1
ENV_MON: C812.1, R842.2, R843.1
ENV_X: C809.2, R825.1, U805.3 (+)
FADE_F: C808.1, R819.1, R822.2
FW_N: R830.2, R831.2, R832.2, U805.9 (-)
FW_OUT: R832.1, U805.8, U805.12 (+)
GATE_BUF: R818.1, U804.13 (-), U804.14
GATE_CAP: C811.1, R840.2, R841.2, U804.12 (+)
GATE_OFF: U806.6 (-)
GND: C802.2, C804.2, C806.2, C807.2, C808.2, C810.2, C811.2, C812.2, C813.2, C816.2, C817.1, C818.2, C819.1, C820.2, C821.1, C822.2, C823.1, C824.2, C825.1, C826.2, C827.1, C828.2, C829.1, C830.2, C831.1, C832.2 (-), C833.1 (+), R801.2, R803.2, R806.2, R814.2, R817.2, R821.2, R825.2, R827.2, R833.2, R837.2, R843.2, R844.2, R851.2, U802.8 (GND), U802.10 (IIN3), U802.11 (VC3), U802.12 (IOUT3), U802.13 (IOUT4), U802.14 (VC4), U802.15 (IIN4), U803.3 (+), U803.5 (+), U805.5 (+), U805.10 (+), U806.4 (V-), U807.5 (+), U808.5 (IOUT2), U808.6 (VC2), U808.7 (IIN2), U808.8 (GND), U808.10 (IIN3), U808.11 (VC3), U808.12 (IOUT3), U808.13 (IOUT4), U808.14 (VC4), U808.15 (IIN4), U809.1 (GND)
GOFF_REF: R836.2, R837.1, U806.5 (+)
GV_BUF: R845.1, U807.1, U807.2 (-)
GV_IIN: R845.2, R846.1, U808.2 (IIN1)
GV_IS: C813.1, R846.2
GV_MODE: R847.1, U808.1 (MODE)
GV_OUT: C814.1, R848.1, R849.1, U807.7
GV_SUM: C814.2, R848.2, U807.6 (-), U808.4 (IOUT1)
HW_A: D810.2 (K), R828.2, R829.2, U805.6 (-)
HW_B: D811.1 (A), R829.1, R831.1
HW_OUT: D810.1 (A), D811.2 (K), U805.7
IN_V1: R811.2
MIX_OUT: C805.1, R810.1, R811.1, U803.1
MIX_SUM: C805.2, R810.2, U802.4 (IOUT1), U802.5 (IOUT2), U803.2 (-)
PA_FB: R802.2, R803.1, U801.2 (-)
PA_G: R802.1, R804.1, U801.1
PA_IN: C801.1
PA_X: C801.2, R801.1, U801.3 (+)
PB_BUF: R807.1, U801.6 (-), U801.7
PB_IN: C803.1
PB_X: C803.2, R806.1, U801.5 (+)
PI_DRV: R849.2
PI_IN: R844.1, U807.3 (+)
PK_O: D812.1 (A), U805.14
REL_X: R839.2
SUM_N: R820.2, R821.1, U804.9 (-)
SUM_O: D815.1 (A), U804.8
SUM_P: R818.2, R819.2, R850.2, U804.10 (+)
THR_H: R834.2, R835.2, U806.3 (+)
U803_SP: U803.6 (-), U803.7
VCA_IA: R804.2, R805.1, U802.2 (IIN1)
VCA_IAS: C802.1, R805.2
VCA_IB: R807.2, R808.1, U802.7 (IIN2)
VCA_IBS: C804.1, R808.2
VCA_MODE: R809.1, U802.1 (MODE)
W1_DQ: U809.2 (DQ)

Notes on the sheet:
0 V de commande = 0 dB, +33 mV/dB d'atténuation. Chemin A : +12 dB avant la VCA, −12 dB à la sommation (bruit du VCA 12 dB plus bas) ;
chemin B (HM-2, ≈ +3 dBu) par 7,5 k : gain unité à 0 V. Sortie IN_V1 vers la grille de V1B (câble blindé).
U809 collé sur U802 : la constante de commande dérive de −3300 ppm/K (kT/q) ; le Pi corrige les tensions.
Bouton Blend (logiciel) : VCA B de −∞ à −20 dB, toute la course sur −60 à −30 dB ; preset de référence : A −4 dB, B −46 dB.
Guitare propre ×11 (passe-haut 48 Hz), redressement double alternance de précision, crête 1 µF / 22 k (22 ms). Comparateur U806A : seuil DAC_THR, hystérésis par 10 M.
Ouverture par 470 Ω (0,1 ms), fermeture par 47 k + échelle de 8 positions entre REL_X et GATE_CAP (τ 10 à 450 ms, feuille Commandes de l'entrée). GATE_OFF : U806B court-circuite GATE_CAP, gate ouvert. CV_G = GATE_CAP/4 + DAC_FADE − 75 mV, bornée à 0 V par D815.
Quelques volts au plus après les masters : dans la plage d'une VCA en ±15 V. Le mute LDR304 reste en amont, sur PI_IN.
Détection sur la guitare propre, action après le préampli : coupe aussi le souffle des étages à lampes et de la HM-2.
Un 100 nF par boîtier et par rail, au plus près des broches (U801-U808).
Mélange : préampli ×4 du chemin A, VCA AS2164, sommation à −12 dB
Commandes des VCA (CNA 0-2,048 V × 1,62 → 0-3,3 V, soit 0 à −100 dB) et sonde de température
Noise gate : détection sur la guitare (U805, U806), forme et commande de la VCA du gate
VCA du gate entre masters et déphaseur (petite carte près de V5)
Découplage ±15 V
