Arnwald/slo-pilote/(commit log)

2026-11-08 Dossier initial : simulation, schéma KiCad, nomenclature, châssis et robot de micro
    État de la conception au 8 novembre 2026, avant le choix du contrôleur
    (NUCLEO ou Raspberry Pi) et la refonte du boîtier d'entrée.
    - spice/ : modèle ngspice complet et campagne de tests (alimentation réelle,
    modes, commutations, bruit, stabilité)
    - sim/ : premières simulations Python (tone stack, cathode follower, buffer)
    - kicad/ : schéma 7 feuilles généré par programme et vérifié contre SPICE
    - bom/ : nomenclature sourcée de 72 lignes
    - mech/ : plans du châssis, DXF de découpe, rendus
    - robot/ : robot de micro 3 axes (CadQuery, STEP, STL, maquette 3D)
    - docs/conception.md : export du d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
    [adaptateur_pied.step, adaptateur_pied.stl, alimentation.kicad_sch, arc_dente.step, arc_dente.stl, bloc_ecrou_X.step, bloc_ecrou_X.stl, bloc_ecrou_Z.step]
2026-11-08 Révision 0.2 : Raspberry Pi 4, entrée TS808 ∥ HM-2 par VCA, gate analogique
    Choix confirmés le 8 novembre : contrôleur unique Raspberry Pi 4, traitement du
    signal entièrement analogique, soudure traversante uniquement.
    - Boîtier d'entrée : TS808 d'origine en 9 V (drive et tone sur ajustables) et
    clone de HM-2 d'après le schéma Boss MIJ (BC550C/BC560C, germanium 1N34A,
    Color Mix à gyrateurs), insert pour une HM-2 du commerce, relais de polarité
    du chemin B.
    - Nouvelle feuille VCA et noise gate : deux VCA AS2164 dosent les chemins
    (bouton Blend motorisé), détection du gate sur la guitare propre, VCA du gate
    entre masters et déphaseur (tampon idéal dans spice/slo.py,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
    [alimentation.kicad_sch, boitier_entree.kicad_sch, commandes.kicad_sch, nomenclature_kicad.csv, nomenclature_tete_100W.xlsx, pilotage.kicad_sch, preampli.kicad_sch, puissance.kicad_sch]
2026-11-08 Dossier de conception à jour pour la révision 0.2
    - Pilotage : Raspberry Pi 4, carte d'interface en DIP, Motoron, réseau et
    robot par le HAT CAN.
    - Boîtier d'entrée réécrit : TS808 d'origine, clone de HM-2 (tableau
    original / clone), pourquoi le mélange marche, méthode pour retrouver le
    son du Line 6, VCA AS2164 et leur commande, noise gate après le préampli.
    - Vérification : niveaux de sortie simulés de la TS et de la HM-2.
    - Coût (≈ 1 910 CHF), schéma KiCad (8 feuilles, 560 composants), points
    ouverts et sources mis à jour.
    - tools/export_doc.py : mise en forme reproductible de l'export.
    Claude-Session: http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
2026-11-08 Entrée recalée sur le preset Line 6 de référence
    - TS : drive sur ajustable 100 kΩ (le preset n'utilise qu'environ 3 kΩ des 500 kΩ d'origine).
    - HM-2 : Color Mix à fond, Dist vers mi-course, comme dans le preset.
    - Gate : ouverture 0,1 ms, fermeture 10 à 450 ms (10 ms dans le preset), détecteur de crête 22 ms.
    - spice/preset_levels.py : niveaux TS et HM-2 aux réglages du preset ; point de départ VCA A −4 dB, VCA B −46 dB.
    - Dossier de conception : analyse du preset (ampli Badonk et non Solo Lead OD, baffles V30), points ouverts.
    Claude-Session: https://claude.ai/code/session_01AHKVpZFQWWa8H11ZMyYcFT
    [boitier_entree.kicad_sch, nomenclature_kicad.csv, vca_gate.kicad_sch]
2026-11-08 Dossier de conception : réglages du preset limités aux pédales et au mélangeur
    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
2026-11-08 Réglages de la TS et de la HM-2 pilotés par échelles et multiplexeurs
    - Drive et tone de la TS, dist et Color Mix de la HM-2 : chaînes de résistances 1 % lues par cinq ADG406
    (16 ou 15 positions) ; fermeture du gate par un ADG408 (8 positions, 10 à 450 ms).
    - Nouvelle feuille « Commandes de l'entrée » ; 3 × 74HC595 sur SPI1 (verrou GPIO14, OE par le MCP23017),
    nappe 26 points vers le boîtier d'entrée.
    - Résistance du multiplexeur compensée : R511 169 Ω, R522 100 Ω, gyrateurs 270 Ω avec 120 k / 100 k / 120 k.
    - spice/steps.py : prises placées pour des paliers réguliers en dB et resimulées (écart ≤ 0,1 dB, 0,7 dB au pire).
    - Nomenclature (≈ 2 030 CHF pour la tête)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
    [boitier_entree.kicad_sch, commandes.kicad_sch, commandes_entree.kicad_sch, nomenclature_kicad.csv, nomenclature_tete_100W.xlsx, pilotage.kicad_sch, slo-pilote.kicad_sch, vca_gate.kicad_sch]
